imihajlow/ccpu/README.md

A 74xx discrete logic IC-based computer.

Folder structure:
* `doc` - documentation
* `model` - Verilog model and test benches
* `boards` - KiCAD designs of the computer
* `tools` - various tools: ALU generator, assembler, linker, compiler, simulator.
* `app` - software tests and applications
