imihajlow/ccpu/doc/waveforms/alu0.png

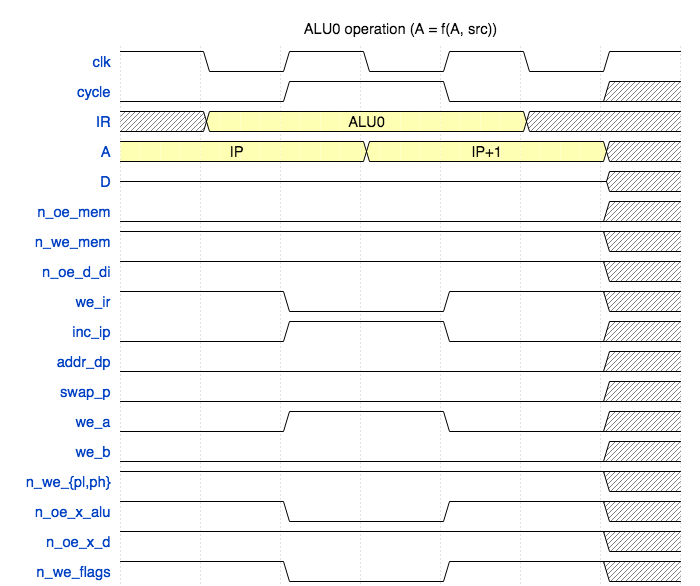
doc/waveforms/alu0.png
