imihajlow/ccpu/doc/waveforms/alu1.png

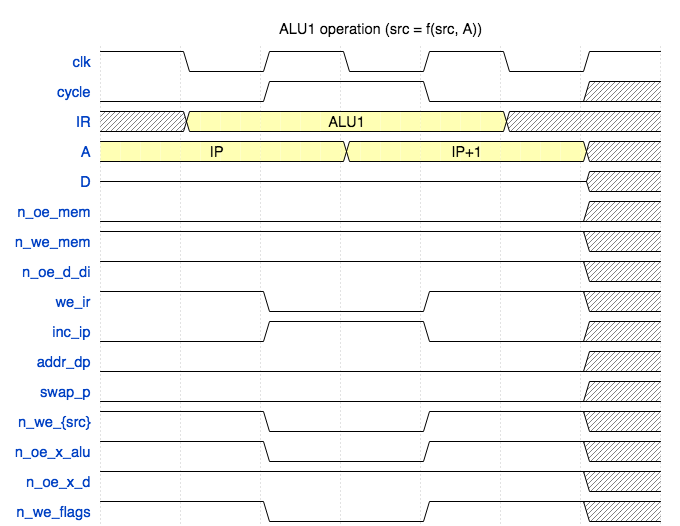
doc/waveforms/alu1.png
