imihajlow/ccpu/doc/waveforms/jc.png

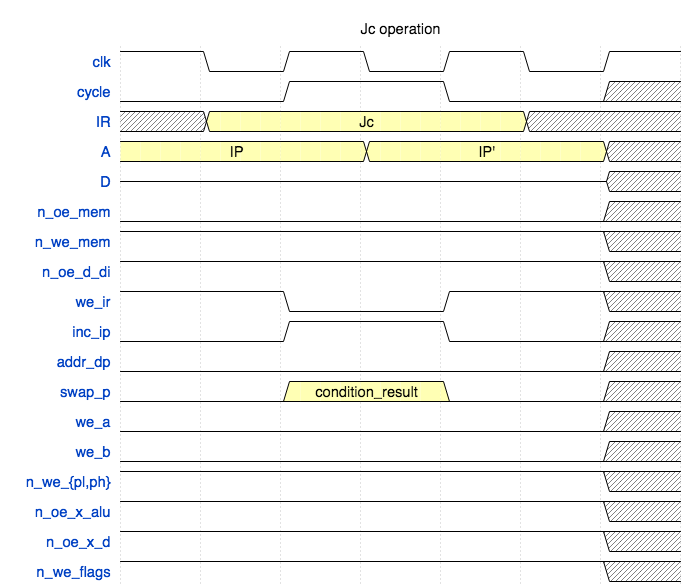
doc/waveforms/jc.png
