imihajlow/ccpu/doc/waveforms/lcd_write.png

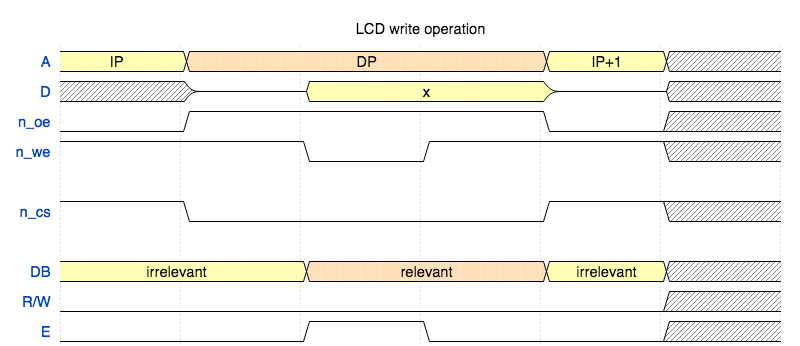
doc/waveforms/lcd_write.png
