imihajlow/ccpu/doc/waveforms/ld-fast.png

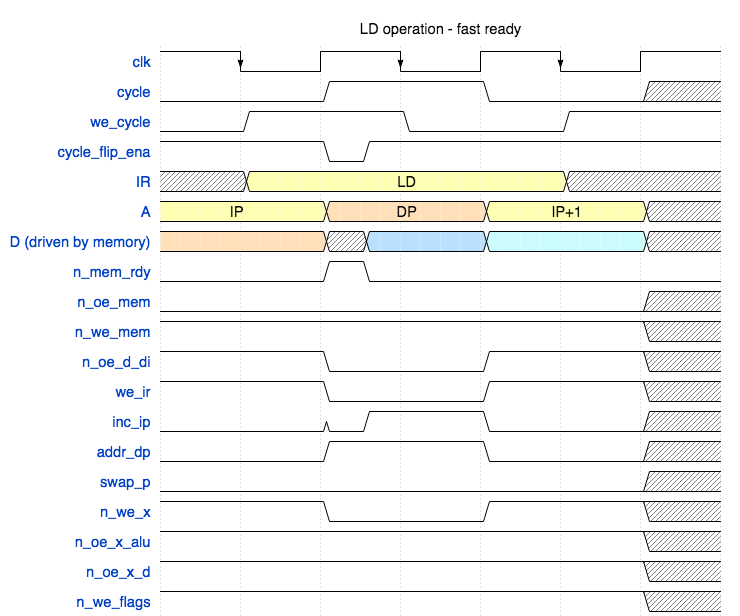
doc/waveforms/ld-fast.png
