imihajlow/ccpu/doc/waveforms/ld-slow.png

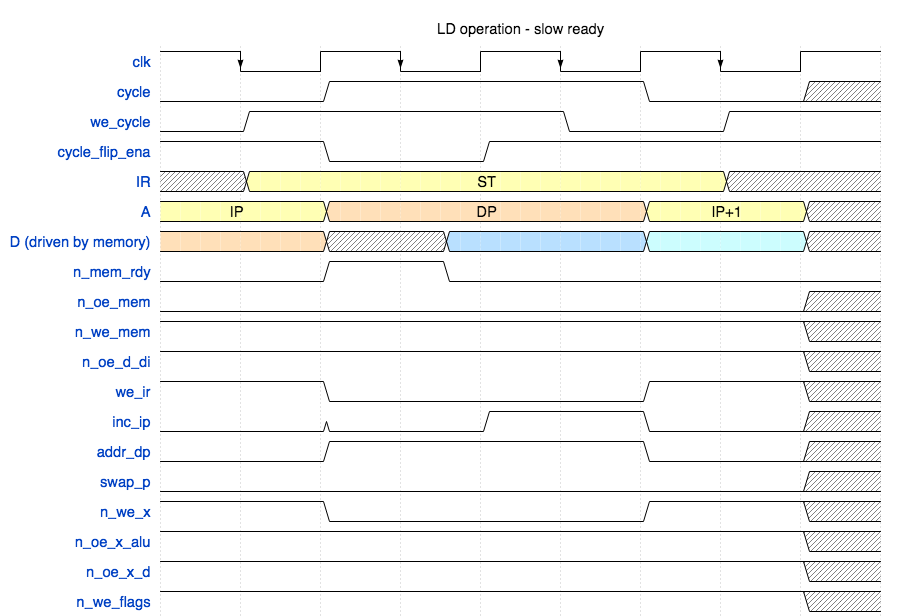
doc/waveforms/ld-slow.png
