imihajlow/ccpu/doc/waveforms/ld.png

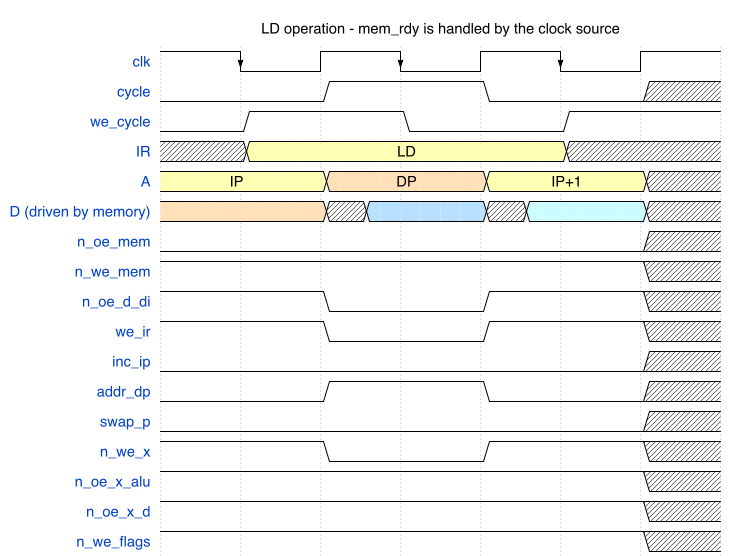
doc/waveforms/ld.png
