imihajlow/ccpu/doc/waveforms/ldi.png

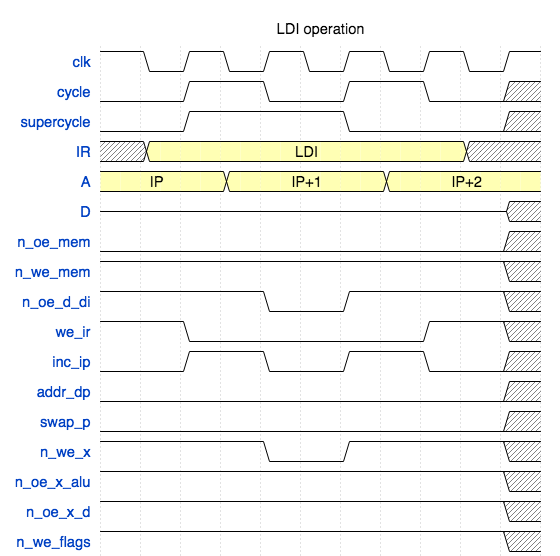
doc/waveforms/ldi.png
