imihajlow/ccpu/doc/waveforms/ps2/recv.png

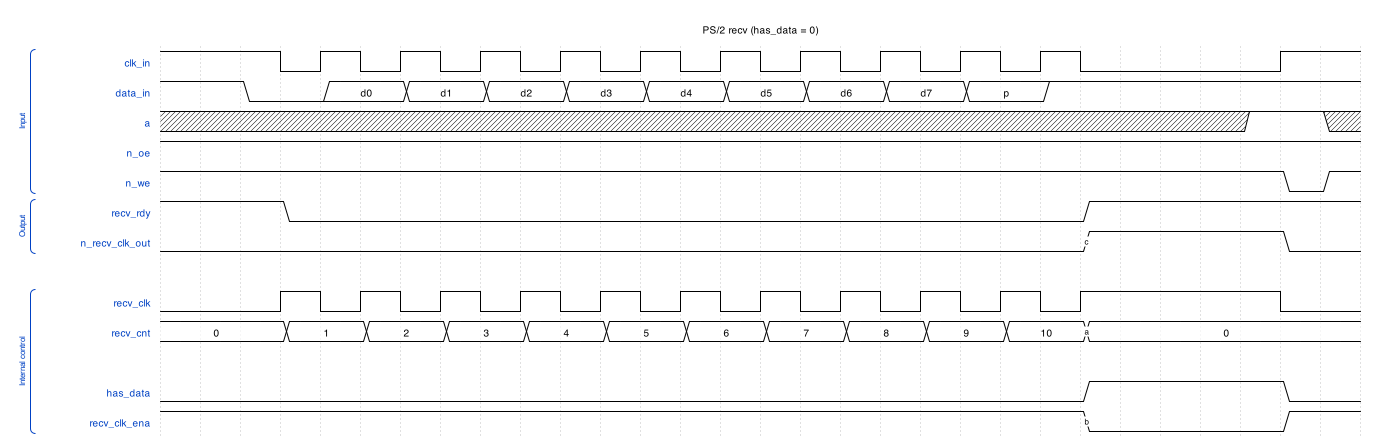
doc/waveforms/ps2/recv.png
