imihajlow/ccpu/doc/waveforms/ps2/send.png

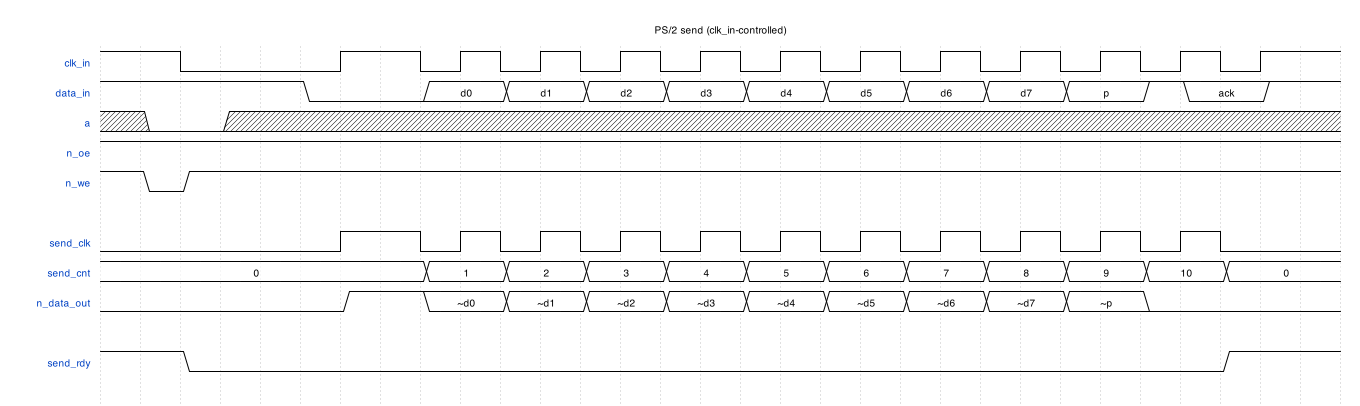
doc/waveforms/ps2/send.png
