imihajlow/ccpu/doc/waveforms/ps2/send_begin.png

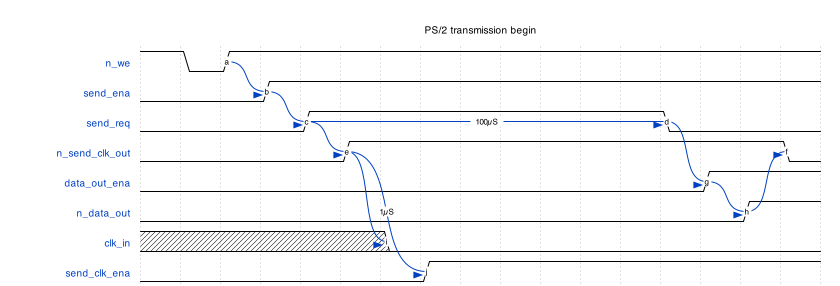
doc/waveforms/ps2/send_begin.png
