imihajlow/ccpu/doc/waveforms/spi.png

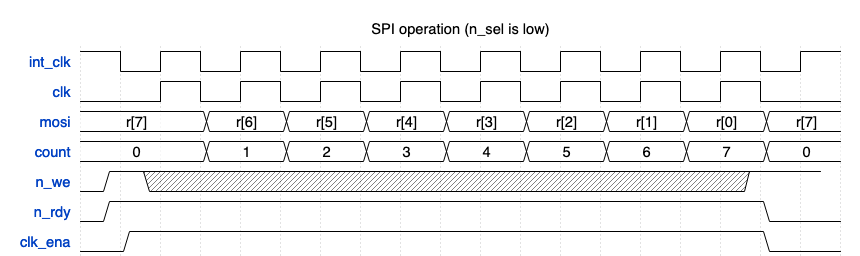
doc/waveforms/spi.png
