imihajlow/ccpu/doc/waveforms/st-fast.png

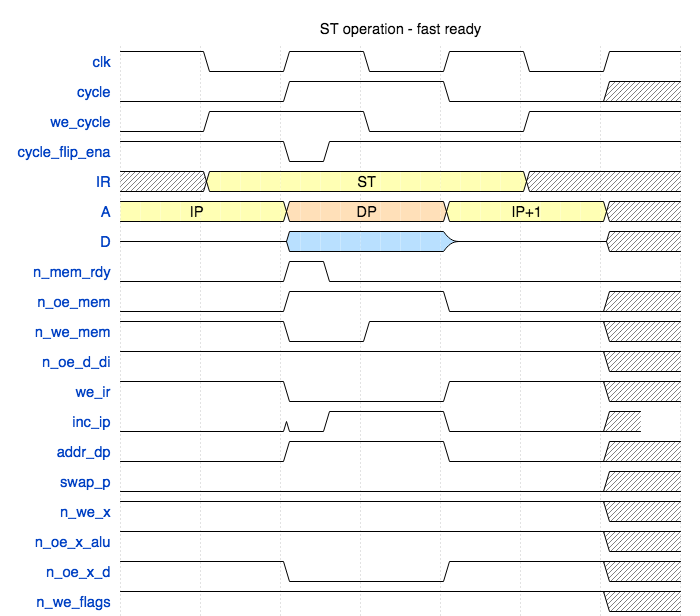
doc/waveforms/st-fast.png
