imihajlow/ccpu/doc/waveforms/st-slow.png

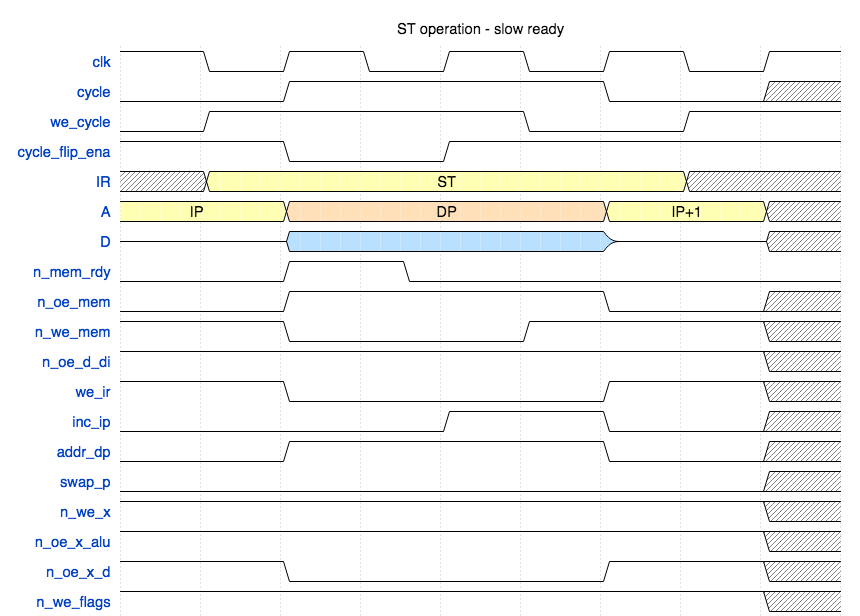
doc/waveforms/st-slow.png
