imihajlow/ccpu/doc/waveforms/st.png

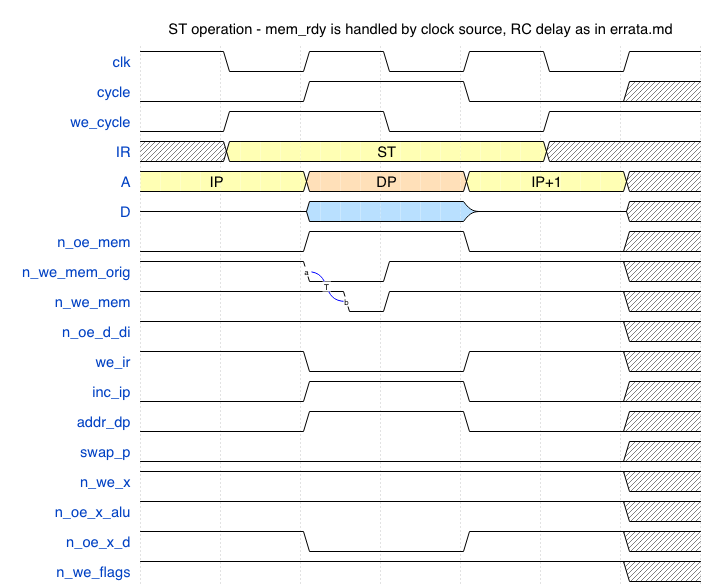
doc/waveforms/st.png
