imihajlow/ccpu/doc/waveforms/stack/access.png

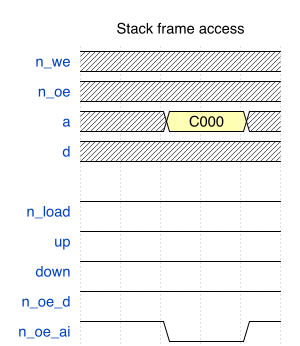
doc/waveforms/stack/access.png
