imihajlow/ccpu/doc/waveforms/stack/incdec.png

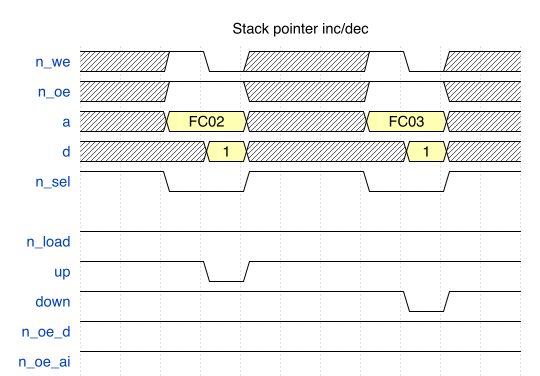
doc/waveforms/stack/incdec.png
