imihajlow/ccpu/doc/waveforms/stack/loadstore.png

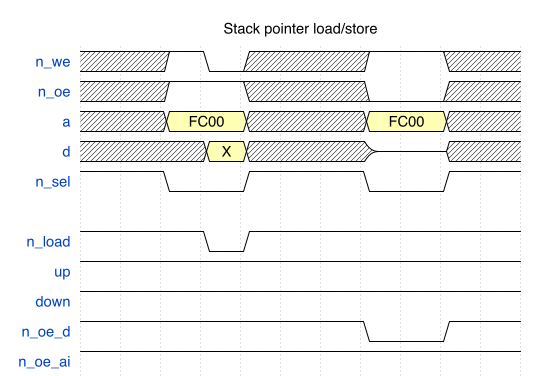
doc/waveforms/stack/loadstore.png
