imihajlow/ccpu/doc/waveforms/vga.png

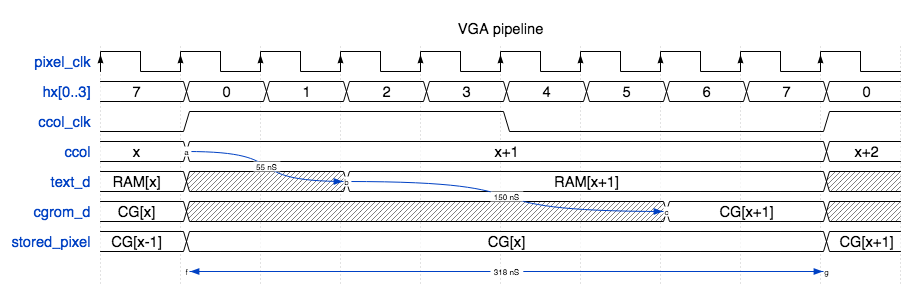
doc/waveforms/vga.png
