imihajlow/ccpu/boards/eth/eth.kicad_pcb

## KiCad design boards/eth/eth.kicad_pcb (2023-11-02)

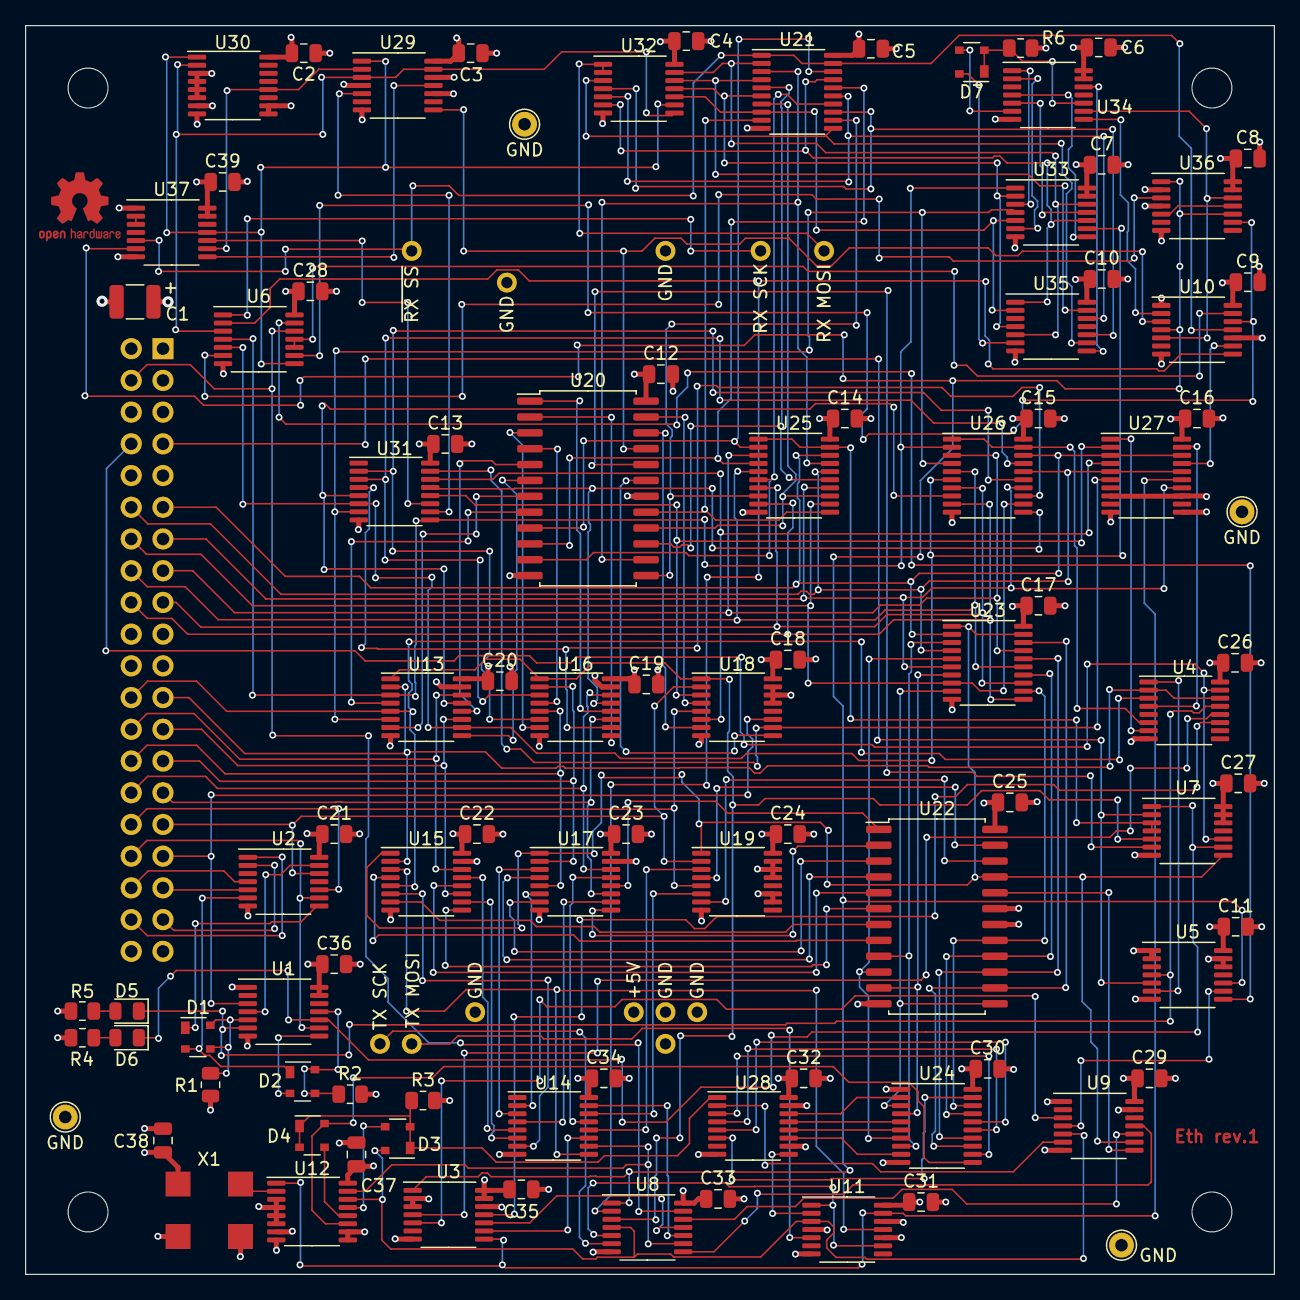
[picture p22: board eth.kicad_pcb from above]

Board: 4 copper layers, 100.0 x 100.0 mm, 100 parts (1 on the bottom side), 173 nets.

Parts:
C1: 33.0x10v; C_1210_3225Metric
C2, C3, C4, C5, C6, C7, C8, C9, C10, C11, C12, C13, C14, C15, C16, C17, C18, C19, C20, C21, C22, C23, C24, C25, C26, C27, C28, C29, C30, C31, C32, C33, C34, C35, C36, C37, C38, C39: 0.1; C_0805_2012Metric
D1, D2, D3, D4, D7: BAT74; SOT-143
D5, D6: LED; LED_0805_2012Metric
H1, H2, H3, H4: MountingHole; MountingHole_3.2mm_M3
J1: Conn_02x20_Odd_Even; PinHeader_2x20_P2.54mm_Horizontal
J2: eth-phy-shield-conn; partial-nucleo64
R1, R2, R3, R6: 1k; R_0805_2012Metric
R4, R5: 500; R_0805_2012Metric
TP1, TP2, TP3, TP4: GND; TestPoint_THTPad_D2.0mm_Drill1.0mm
U1, U9, U37: 74HC04; TSSOP-14_4.4x5mm_P0.65mm
U2, U34, U35: 74HC21; TSSOP-14_4.4x5mm_P0.65mm
U3, U10, U11, U29, U36: 74HC74; TSSOP-14_4.4x5mm_P0.65mm
U4: 74HC139; TSSOP-16_4.4x5mm_P0.65mm
U5, U7: 74HC32; TSSOP-14_4.4x5mm_P0.65mm
U6, U8: 74HC08; TSSOP-14_4.4x5mm_P0.65mm
U12, U30: 74HC161; TSSOP-16_4.4x5mm_P0.65mm
U13, U15, U16, U17, U18, U19: 74HC157; TSSOP-16_4.4x5mm_P0.65mm
U14, U31: 74HC4040; TSSOP-16_4.4x5mm_P0.65mm
U20, U22: 6116; SOIC-24W_7.5x15.4mm_P1.27mm
U21, U23, U25, U26, U27: 74HC244; TSSOP-20_4.4x6.5mm_P0.65mm
U24: 74HC273; TSSOP-20_4.4x6.5mm_P0.65mm
U28: 74HC165; TSSOP-16_4.4x5mm_P0.65mm
U32: 74HC164; TSSOP-14_4.4x5mm_P0.65mm
U33: 74HC86; TSSOP-14_4.4x5mm_P0.65mm
X1: CB3-3C-20M; Oscillator_SMD_EuroQuartz_XO91-4Pin_7.0x5.0mm

Connections:
/a0: J1.23, U4.2 (A0), U4.14 (A0), U13.2 (I0a), U15.2 (I0a)
/a1: J1.24, U4.3 (A1), U13.5 (I0b), U15.5 (I0b)
/a2: J1.25, U13.11 (I0c), U15.11 (I0c)
/a3: J1.26, U13.14 (I0d), U15.14 (I0d)
/a4: J1.27, U16.2 (I0a), U17.2 (I0a)
/a5: J1.28, U16.5 (I0b), U17.5 (I0b)
/a6: J1.29, U16.11 (I0c), U17.11 (I0c)
/a7: J1.30, U16.14 (I0d), U17.14 (I0d)
/a8: J1.31, U2.12, U18.2 (I0a), U19.2 (I0a)
/a9: J1.32, U2.10, U18.5 (I0b), U19.5 (I0b)
/a10: J1.33, U1.3, U18.11 (I0c)
/a11: J1.34, U1.9, U2.9
/a12: J1.35, U2.5
/a13: J1.36, U2.4
/a14: J1.37, U2.2
/a15: J1.38, U2.1
/a_89nab_set: D1.1 (C1), U2.8
/a_cdef_set: D1.2 (C2), D2.1 (C1), U2.6
/buf_full: U10.9 (Q), U27.17 (2A0)
/d0: J1.11, U23.2 (1A0), U25.18 (1Y0), U26.18 (1Y0), U27.3 (2Y0), U27.18 (1Y0)
/d1: J1.12, U23.4 (1A1), U25.16 (1Y1), U26.16 (1Y1), U27.5 (2Y1), U27.16 (1Y1)
/d2: J1.13, U23.6 (1A2), U25.14 (1Y2), U26.14 (1Y2), U27.14 (1Y2)
/d3: J1.14, U23.8 (1A3), U25.12 (1Y3), U26.12 (1Y3)
/d4: J1.15, U23.17 (2A0), U25.3 (2Y0), U26.3 (2Y0)
/d5: J1.16, U23.15 (2A1), U25.5 (2Y1), U26.5 (2Y1)
/d6: J1.17, U23.13 (2A2), U25.7 (2Y2), U26.7 (2Y2)
/d7: J1.18, U23.11 (2A3), U25.9 (2Y3), U26.9 (2Y3)
/filter/a02: U6.6, U36.3 (C)
/filter/d_4320_mac: D7.3 (A2), U34.6
/filter/d_4320_ok: D7.1 (C1), D7.2 (C2), R6.2, U34.10
/filter/d_4320_set: D7.4 (A1), U35.6
/filter/d_7651_set: U34.12, U35.8
/filter/d_xor_a0: U33.3, U34.1
/filter/d_xor_a1: U33.6, U34.2
/filter/d_xor_a2: U33.8, U34.4
/filter/last_mac_ok: U10.5 (Q), U34.9, U36.12 (D)
/filter/mac_end: U36.5 (Q), U36.11 (C)
/filter/next_mac_ok: U10.2 (D), U34.8
/filter/~d0: U33.11, U34.5
/rearm_sched: U3.5 (Q), U9.3
/receiver/bit_count2: U29.2 (D), U30.12 (Q2), U37.9
/receiver/byte_clk: U29.5 (Q), U31.10 (CP)
/receiver/rst: U31.11 (MR), U37.10
/receiver/sck_f: U6.3, U29.3 (C), U29.13 (~R), U30.2 (CP), U32.8 (CP)
/receiver/~bit_count_2: U29.11 (C), U37.8
/recv_a0: U13.4 (Za), U20.8 (A0)
/recv_a1: U13.7 (Zb), U20.7 (A1)
/recv_a2: U13.9 (Zc), U20.6 (A2)
/recv_a3: U13.12 (Zd), U20.5 (A3)
/recv_a4: U16.4 (Za), U20.4 (A4)
/recv_a5: U16.7 (Zb), U20.3 (A5)
/recv_a6: U16.9 (Zc), U20.2 (A6)
/recv_a7: U16.12 (Zd), U20.1 (A7)
/recv_a8: U18.4 (Za), U20.23 (A8)
/recv_a9: U18.7 (Zb), U20.22 (A9)
/recv_a10: U18.9 (Zc), U20.19 (A10)
/recv_a_sel: U7.5, U8.3, U13.1 (S), U16.1 (S), U18.1 (S)
/recv_byte0: U21.2 (1A0), U32.13 (Q7), U33.12, U35.5
/recv_byte1: U21.4 (1A1), U32.12 (Q6), U35.13
/recv_byte2: U21.6 (1A2), U32.11 (Q5), U33.2, U35.4
/recv_byte3: U21.8 (1A3), U32.10 (Q4), U33.5, U35.2
/recv_byte4: U21.17 (2A0), U32.6 (Q3), U33.10, U35.1
/recv_byte5: U21.15 (2A1), U32.5 (Q2), U35.12
/recv_byte6: U21.13 (2A2), U32.4 (Q1), U35.10
/recv_byte7: U21.11 (2A3), U32.3 (Q0), U35.9
/recv_byte_cnt0: U6.4, U13.3 (I1a), U26.2 (1A0), U31.9 (Q0), U33.1
/recv_byte_cnt1: U13.6 (I1b), U26.4 (1A1), U31.7 (Q1), U33.4
/recv_byte_cnt2: U6.5, U13.10 (I1c), U26.6 (1A2), U31.6 (Q2), U33.9
/recv_byte_cnt3: U13.13 (I1d), U26.8 (1A3), U31.5 (Q3)
/recv_byte_cnt4: U16.3 (I1a), U26.17 (2A0), U31.3 (Q4)
/recv_byte_cnt5: U16.6 (I1b), U26.15 (2A1), U31.2 (Q5)
/recv_byte_cnt6: U16.10 (I1c), U26.13 (2A2), U31.4 (Q6)
/recv_byte_cnt7: U16.13 (I1d), U26.11 (2A3), U31.13 (Q7)
/recv_byte_cnt8: U18.3 (I1a), U27.2 (1A0), U31.12 (Q8)
/recv_byte_cnt9: U18.6 (I1b), U27.4 (1A1), U31.14 (Q9)
/recv_byte_cnt10: U18.10 (I1c), U27.6 (1A2), U31.15 (Q10)
/recv_d0: U20.9 (D0), U21.18 (1Y0), U25.2 (1A0)
/recv_d1: U20.10 (D1), U21.16 (1Y1), U25.4 (1A1)
/recv_d2: U20.11 (D2), U21.14 (1Y2), U25.6 (1A2)
/recv_d3: U20.13 (D3), U21.12 (1Y3), U25.8 (1A3)
/recv_d4: U20.14 (D4), U21.3 (2Y0), U25.17 (2A0)
/recv_d5: U20.15 (D5), U21.5 (2Y1), U25.15 (2A1)
/recv_d6: U20.16 (D6), U21.7 (2Y2), U25.13 (2A2)
/recv_d7: U20.17 (D7), U21.9 (2Y3), U25.11 (2A3)
/recv_mosi: J2.PB13, U32.1 (DSA), U32.2 (DSB)
/recv_sck: J2.PB15, U6.1
/recv_sck_ena: U6.2, U8.2, U10.8 (~Q)
/recv_ss: U3.1 (~R), U5.10, U8.1, U10.4 (~S), U36.1 (~R), U36.10 (~S), U37.6
/tx_a0: U15.4 (Za), U22.8 (A0)
/tx_a1: U15.7 (Zb), U22.7 (A1)
/tx_a2: U15.9 (Zc), U22.6 (A2)
/tx_a3: U15.12 (Zd), U22.5 (A3)
/tx_a4: U17.4 (Za), U22.4 (A4)
/tx_a5: U17.7 (Zb), U22.3 (A5)
/tx_a6: U17.9 (Zc), U22.2 (A6)
/tx_a7: U17.12 (Zd), U22.1 (A7)
/tx_a8: U19.4 (Za), U22.23 (A8)
/tx_a9: U19.7 (Zb), U22.22 (A9)
/tx_buf_d0: U24.9 (Q3), U28.11 (D0)
/tx_buf_d1: U24.6 (Q2), U28.12 (D1)
/tx_buf_d2: U24.5 (Q1), U28.13 (D2)
/tx_buf_d3: U24.2 (Q0), U28.14 (D3)
/tx_buf_d4: U24.12 (Q4), U28.3 (D4)
/tx_buf_d5: U24.15 (Q5), U28.4 (D5)
/tx_buf_d6: U24.16 (Q6), U28.5 (D6)
/tx_buf_d7: U24.19 (Q7), U28.6 (D7)
/tx_byte_cnt0: U11.11 (C), U14.9 (Q0), U15.3 (I1a)
/tx_byte_cnt1: U14.7 (Q1), U15.6 (I1b)
/tx_byte_cnt2: U14.6 (Q2), U15.10 (I1c)
/tx_byte_cnt3: U14.5 (Q3), U15.13 (I1d)
/tx_byte_cnt4: U14.3 (Q4), U17.3 (I1a)
/tx_byte_cnt5: U14.2 (Q5), U17.6 (I1b)
/tx_byte_cnt6: U14.4 (Q6), U17.10 (I1c)
/tx_byte_cnt7: U14.13 (Q7), U17.13 (I1d)
/tx_byte_cnt8: U14.12 (Q8), U19.3 (I1a)
/tx_byte_cnt9: U14.14 (Q9), U19.6 (I1b)
/tx_byte_cnt10: U8.10, U14.15 (Q10)
/tx_cnt0: D3.4 (A1), U8.4, U9.5, U11.3 (C), U12.14 (Q0)
/tx_cnt1: D3.3 (A2), U12.13 (Q1)
/tx_cnt2: D4.3 (A2), U12.12 (Q2)
/tx_cnt3: D4.4 (A1), U12.11 (Q3), U24.11 (Cp)
/tx_cp_in: U12.2 (CP), X1.3 (OUT)
/tx_d0: U22.14 (D4), U23.18 (1Y0), U24.13 (D4)
/tx_d1: U22.15 (D5), U23.16 (1Y1), U24.14 (D5)
/tx_d2: U22.16 (D6), U23.14 (1Y2), U24.17 (D6)
/tx_d3: U22.17 (D7), U23.12 (1Y3), U24.18 (D7)
/tx_d4: U22.9 (D0), U23.3 (2Y0), U24.8 (D3)
/tx_d5: U22.10 (D1), U23.5 (2Y1), U24.7 (D2)
/tx_d6: U22.11 (D2), U23.7 (2Y2), U24.4 (D1)
/tx_d7: U22.13 (D3), U23.9 (2Y3), U24.3 (D0)
/tx_finish: U8.8, U9.11
/tx_halt: U3.9 (Q), U14.11 (MR)
/tx_mosi: J2.PC12, U11.5 (Q)
/tx_oe: U8.5, U11.1 (~R), U11.9 (Q)
/tx_sck: J2.PC10, U8.6
/tx_shift_cp: U9.6, U28.2 (CP)
/tx_shift_q7: U11.2 (D), U28.9 (Q7)
/~a10: U1.4, U2.13
/~a11: D2.2 (C2), U1.8
/~a_buf_sel: D6.1 (K), U1.10, U7.1, U7.9
/~a_fbxx: D5.1 (K), U1.6, U4.13 (A1), U5.4
/~clr_frame_received: U6.10, U6.11, U10.13 (~R)
/~inhibit: U6.9, U10.12 (D), U36.9 (Q)
/~oe_cr_to_d: U4.4 (O0), U27.19 (2OE)
/~oe: J1.7, U5.5, U7.2
/~rearm_req: U3.4 (~S), U4.12 (O0)
/~rearm_sched: U5.9, U9.4
/~rearm: U5.8, U6.13
/~recv_buf_oe: U7.6, U20.20 (~OE)
/~recv_buf_we: U10.3 (C), U20.21 (~WE), U29.8 (~Q)
/~recv_byte_cnt_hi_oe: U4.7 (O3), U27.1 (1OE)
/~recv_byte_cnt_lo_oe: U4.6 (O2), U26.1 (1OE), U26.19 (2OE)
/~recv_d_oe: U7.3, U7.4, U25.1 (1OE), U25.19 (2OE)
/~recv_rst: U6.8, U29.1 (~R), U30.1 (~MR), U32.9 (~MR), U37.11
/~recv_ss: J2.PC6, U10.11 (C), U21.1 (1OE), U21.19 (2OE), U37.5
/~reg_oe_ena: U4.1 (E), U5.6
/~rst: J1.4, U6.12, U8.13
/~tx_buf_oe: U9.8, U22.20 (~OE)
/~tx_buf_we: U7.8, U9.9, U15.1 (S), U17.1 (S), U19.1 (S), U22.21 (~WE), U23.1 (1OE), U23.19 (2OE)
/~tx_byte_clk: U8.9, U12.15 (TC), U14.10 (CP)
/~tx_finish: U8.12, U9.10
/~tx_halt_set: U3.10 (~S), U8.11
/~tx_halt: U3.8 (~Q), U11.13 (~R), U12.1 (~MR), U27.15 (2A1)
/~tx_req: U3.11 (C), U4.11 (O1)
/~tx_shift_pl: D3.1 (C1), D3.2 (C2), D4.1 (C1), D4.2 (C2), R3.1, U28.1 (~PL)
/~we: J1.8, U4.15 (E), U7.10
GND: C1.2, C2.2, C3.2, C4.2, C5.2, C6.2, C7.2, C8.2, C9.2, C10.2, C11.2, C12.2, C13.2, C14.2, C15.2, C16.2, C17.2, C18.2, C19.2, C20.2, C21.2, C22.2, C23.2, C24.2, C25.2, C26.2, C27.2, C28.2, C29.2, C30.2, C31.2, C32.2, C33.2, C34.2, C35.2, C36.2, C37.2, C38.2, C39.2, J1.2, J1.39, J2.GND, R3.2, R6.1, TP1.1, TP2.1, TP3.1, TP4.1, U1.1, U1.7 (GND), U2.7 (GND), U3.2 (D), U3.3 (C), U3.7 (GND), U3.12 (D), U4.8 (GND), U5.1, U5.2, U5.7 (GND), U5.12, U5.13, U6.7 (GND), U7.7 (GND), U8.7 (GND), U9.1, U9.7 (GND), U9.13, U10.7 (GND), U11.7 (GND), U12.3 (D0), U12.4 (D1), U12.5 (D2), U12.6 (D3), U12.8 (GND), U13.8 (GND), U13.15 (E), U14.8 (GND), U15.8 (GND), U15.15 (E), U16.8 (GND), U16.15 (E), U17.8 (GND), U17.15 (E), U18.8 (GND), U18.13 (I1d), U18.14 (I0d), U18.15 (E), U19.8 (GND), U19.10 (I1c), U19.11 (I0c), U19.13 (I1d), U19.14 (I0d), U19.15 (E), U20.12 (GND), U20.18 (~CS), U21.10 (GND), U22.12 (GND), U22.18 (~CS), U22.19 (A10), U23.10 (GND), U24.10 (GND), U25.10 (GND), U26.10 (GND), U27.8 (1A3), U27.10 (GND), U27.11 (2A3), U27.13 (2A2), U28.8 (GND), U28.10 (DS), U28.15 (~CE), U29.7 (GND), U30.3 (D0), U30.4 (D1), U30.5 (D2), U30.6 (D3), U30.8 (GND), U31.8 (GND), U32.7 (GND), U33.7 (GND), U34.7 (GND), U35.7 (GND), U36.7 (GND), U37.1, U37.7 (GND), X1.2 (GND)
unnamed: D1.3 (A2), D1.4 (A1), R1.2, U1.5
unnamed: D2.3 (A2), D2.4 (A1), R2.1, U1.11
unnamed: D5.2 (A), R5.1
unnamed: D6.2 (A), R4.2
unnamed: U37.2, U37.3
VCC: C1.1, C2.1, C3.1, C4.1, C5.1, C6.1, C7.1, C8.1, C9.1, C10.1, C11.1, C12.1, C13.1, C14.1, C15.1, C16.1, C17.1, C18.1, C19.1, C20.1, C21.1, C22.1, C23.1, C24.1, C25.1, C26.1, C27.1, C28.1, C29.1, C30.1, C31.1, C32.1, C33.1, C34.1, C35.1, C36.1, C37.1, C38.1, C39.1, J1.1, J1.40, J2.+5V, R1.1, R2.2, R4.1, R5.2, U1.13, U1.14 (VCC), U2.14 (VCC), U3.13 (~R), U3.14 (VCC), U4.16 (VCC), U5.14 (VCC), U6.14 (VCC), U7.12, U7.13, U7.14 (VCC), U8.14 (VCC), U9.14 (VCC), U10.1 (~R), U10.10 (~S), U10.14 (VCC), U11.4 (~S), U11.10 (~S), U11.12 (D), U11.14 (VCC), U12.7 (CEP), U12.9 (~PE), U12.10 (CET), U12.16 (VCC), U13.16 (VCC), U14.16 (VCC), U15.16 (VCC), U16.16 (VCC), U17.16 (VCC), U18.16 (VCC), U19.16 (VCC), U20.24 (VCC), U21.20 (VCC), U22.24 (VCC), U23.20 (VCC), U24.1 (~Mr), U24.20 (VCC), U25.20 (VCC), U26.20 (VCC), U27.20 (VCC), U28.16 (VCC), U29.4 (~S), U29.10 (~S), U29.12 (D), U29.14 (VCC), U30.7 (CEP), U30.9 (~PE), U30.10 (CET), U30.16 (VCC), U31.16 (VCC), U32.14 (VCC), U33.13, U33.14 (VCC), U34.13, U34.14 (VCC), U35.14 (VCC), U36.2 (D), U36.4 (~S), U36.13 (~R), U36.14 (VCC), U37.13, U37.14 (VCC), X1.1 (EN), X1.4 (V+)
