imihajlow/ccpu/boards/stack/stack.kicad_pcb

## KiCad design boards/stack/stack.kicad_pcb (2021-12-06)

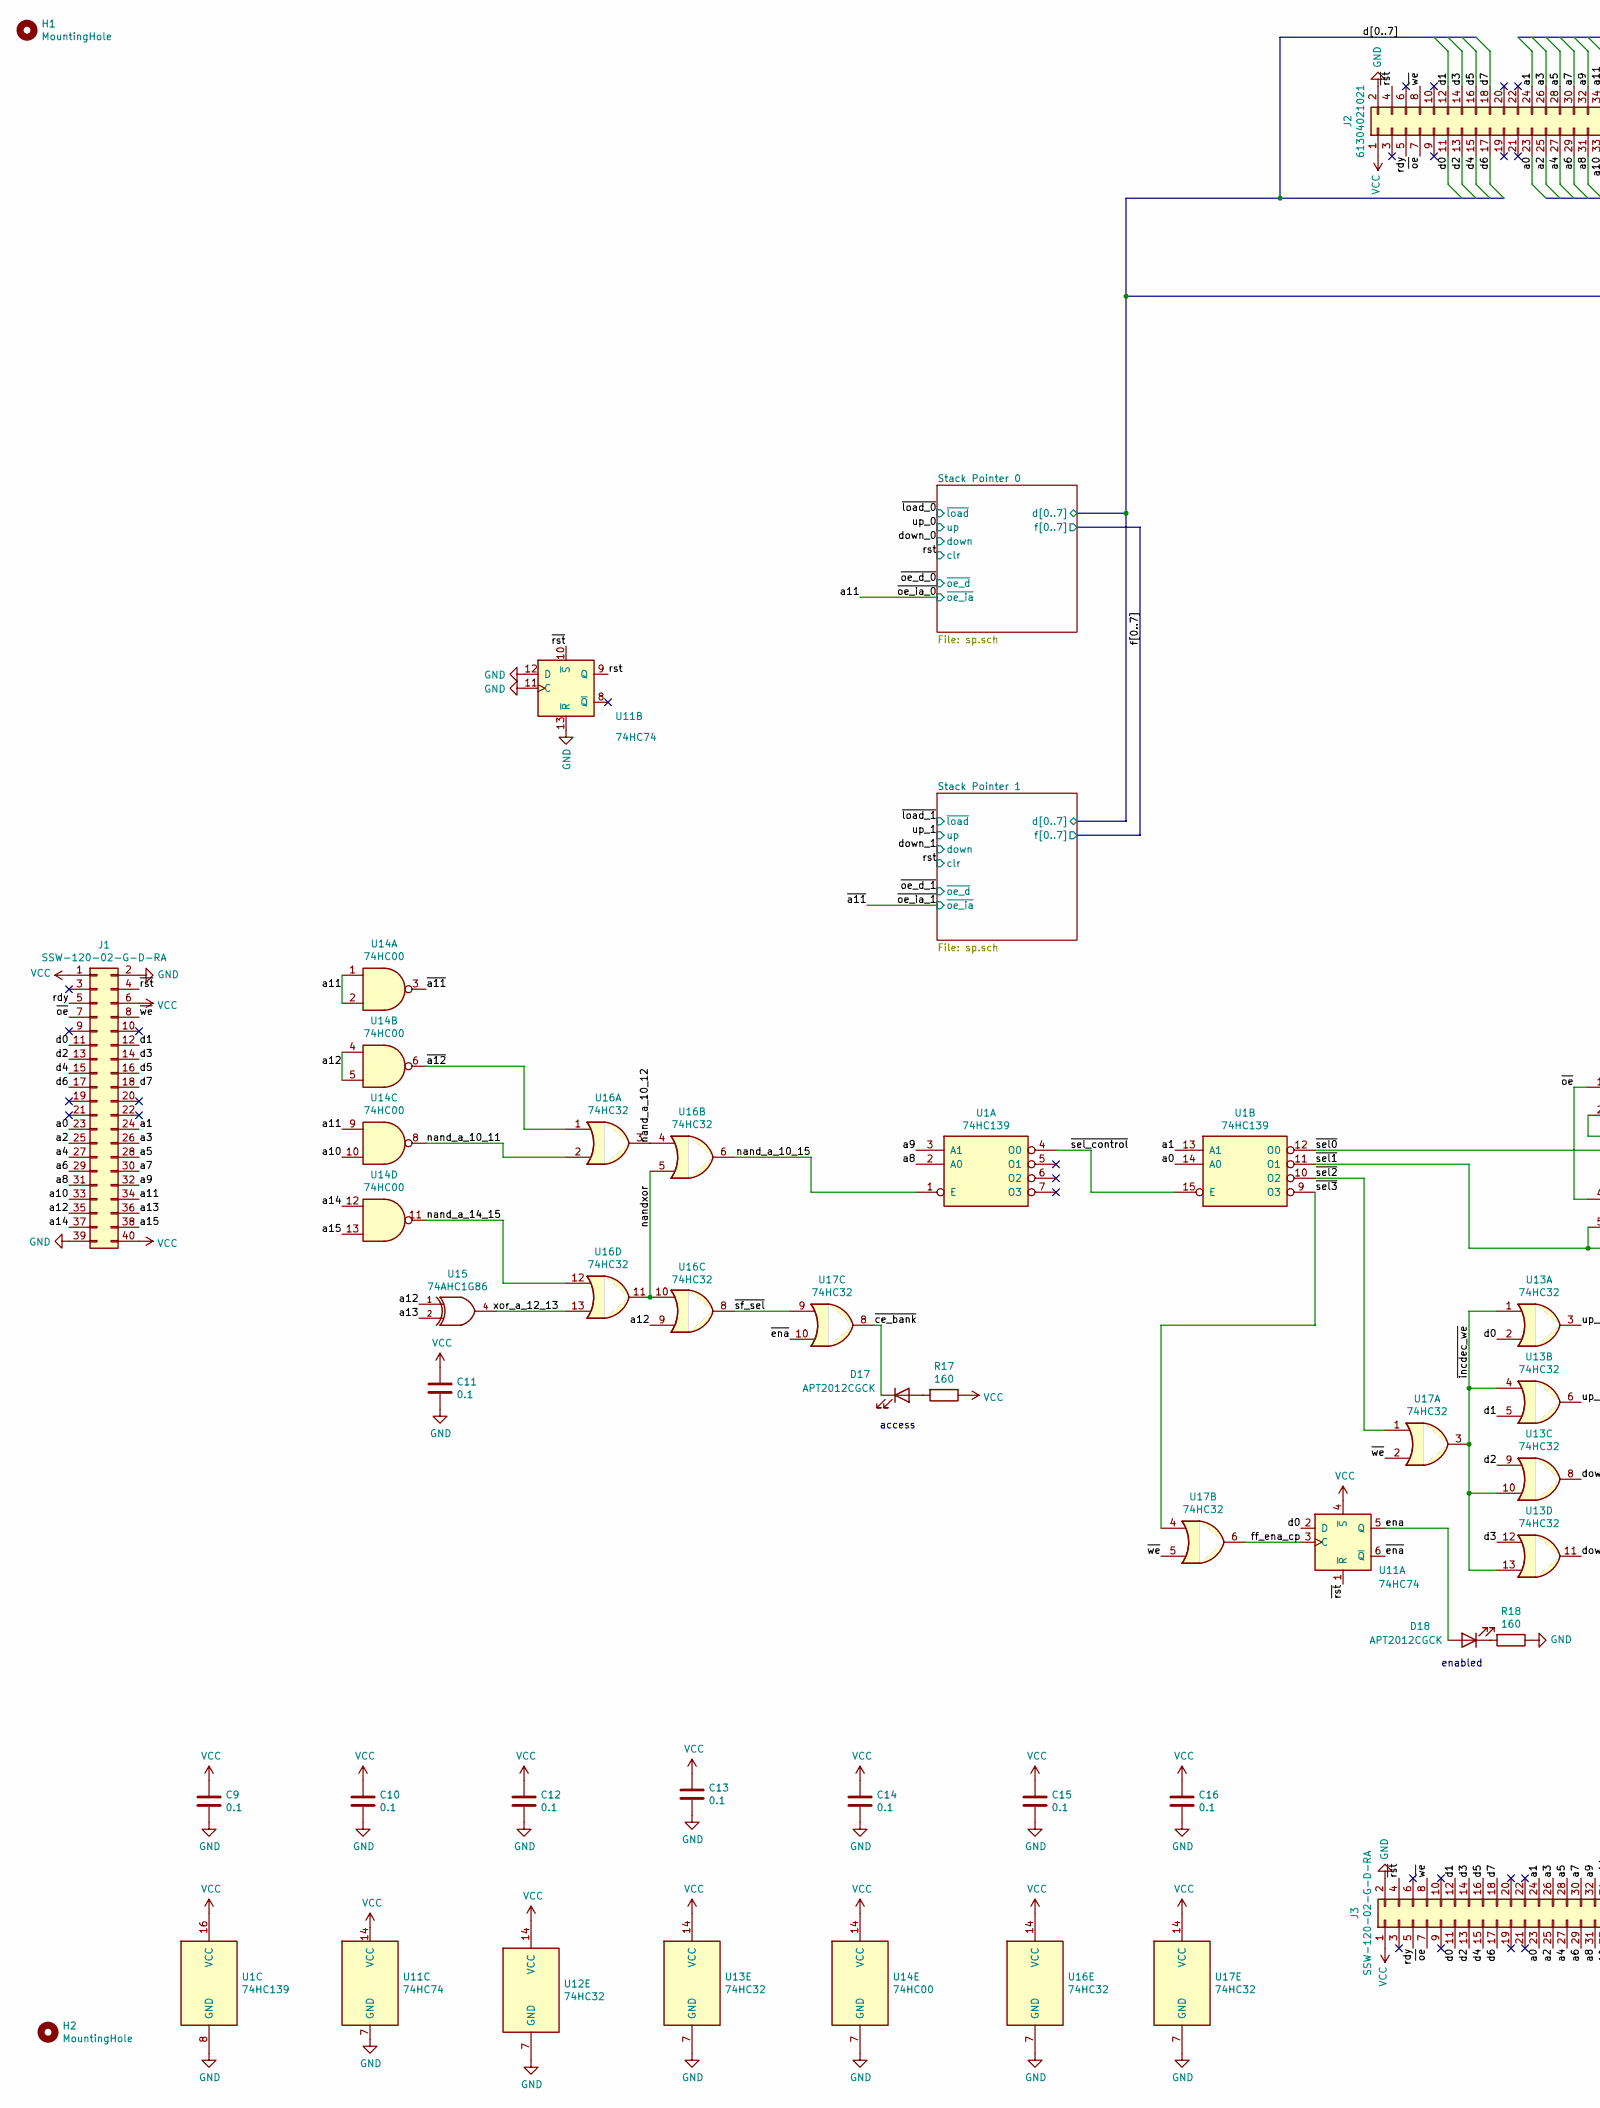
[picture p23: schematic stack.sch, part in row 1, column 1]

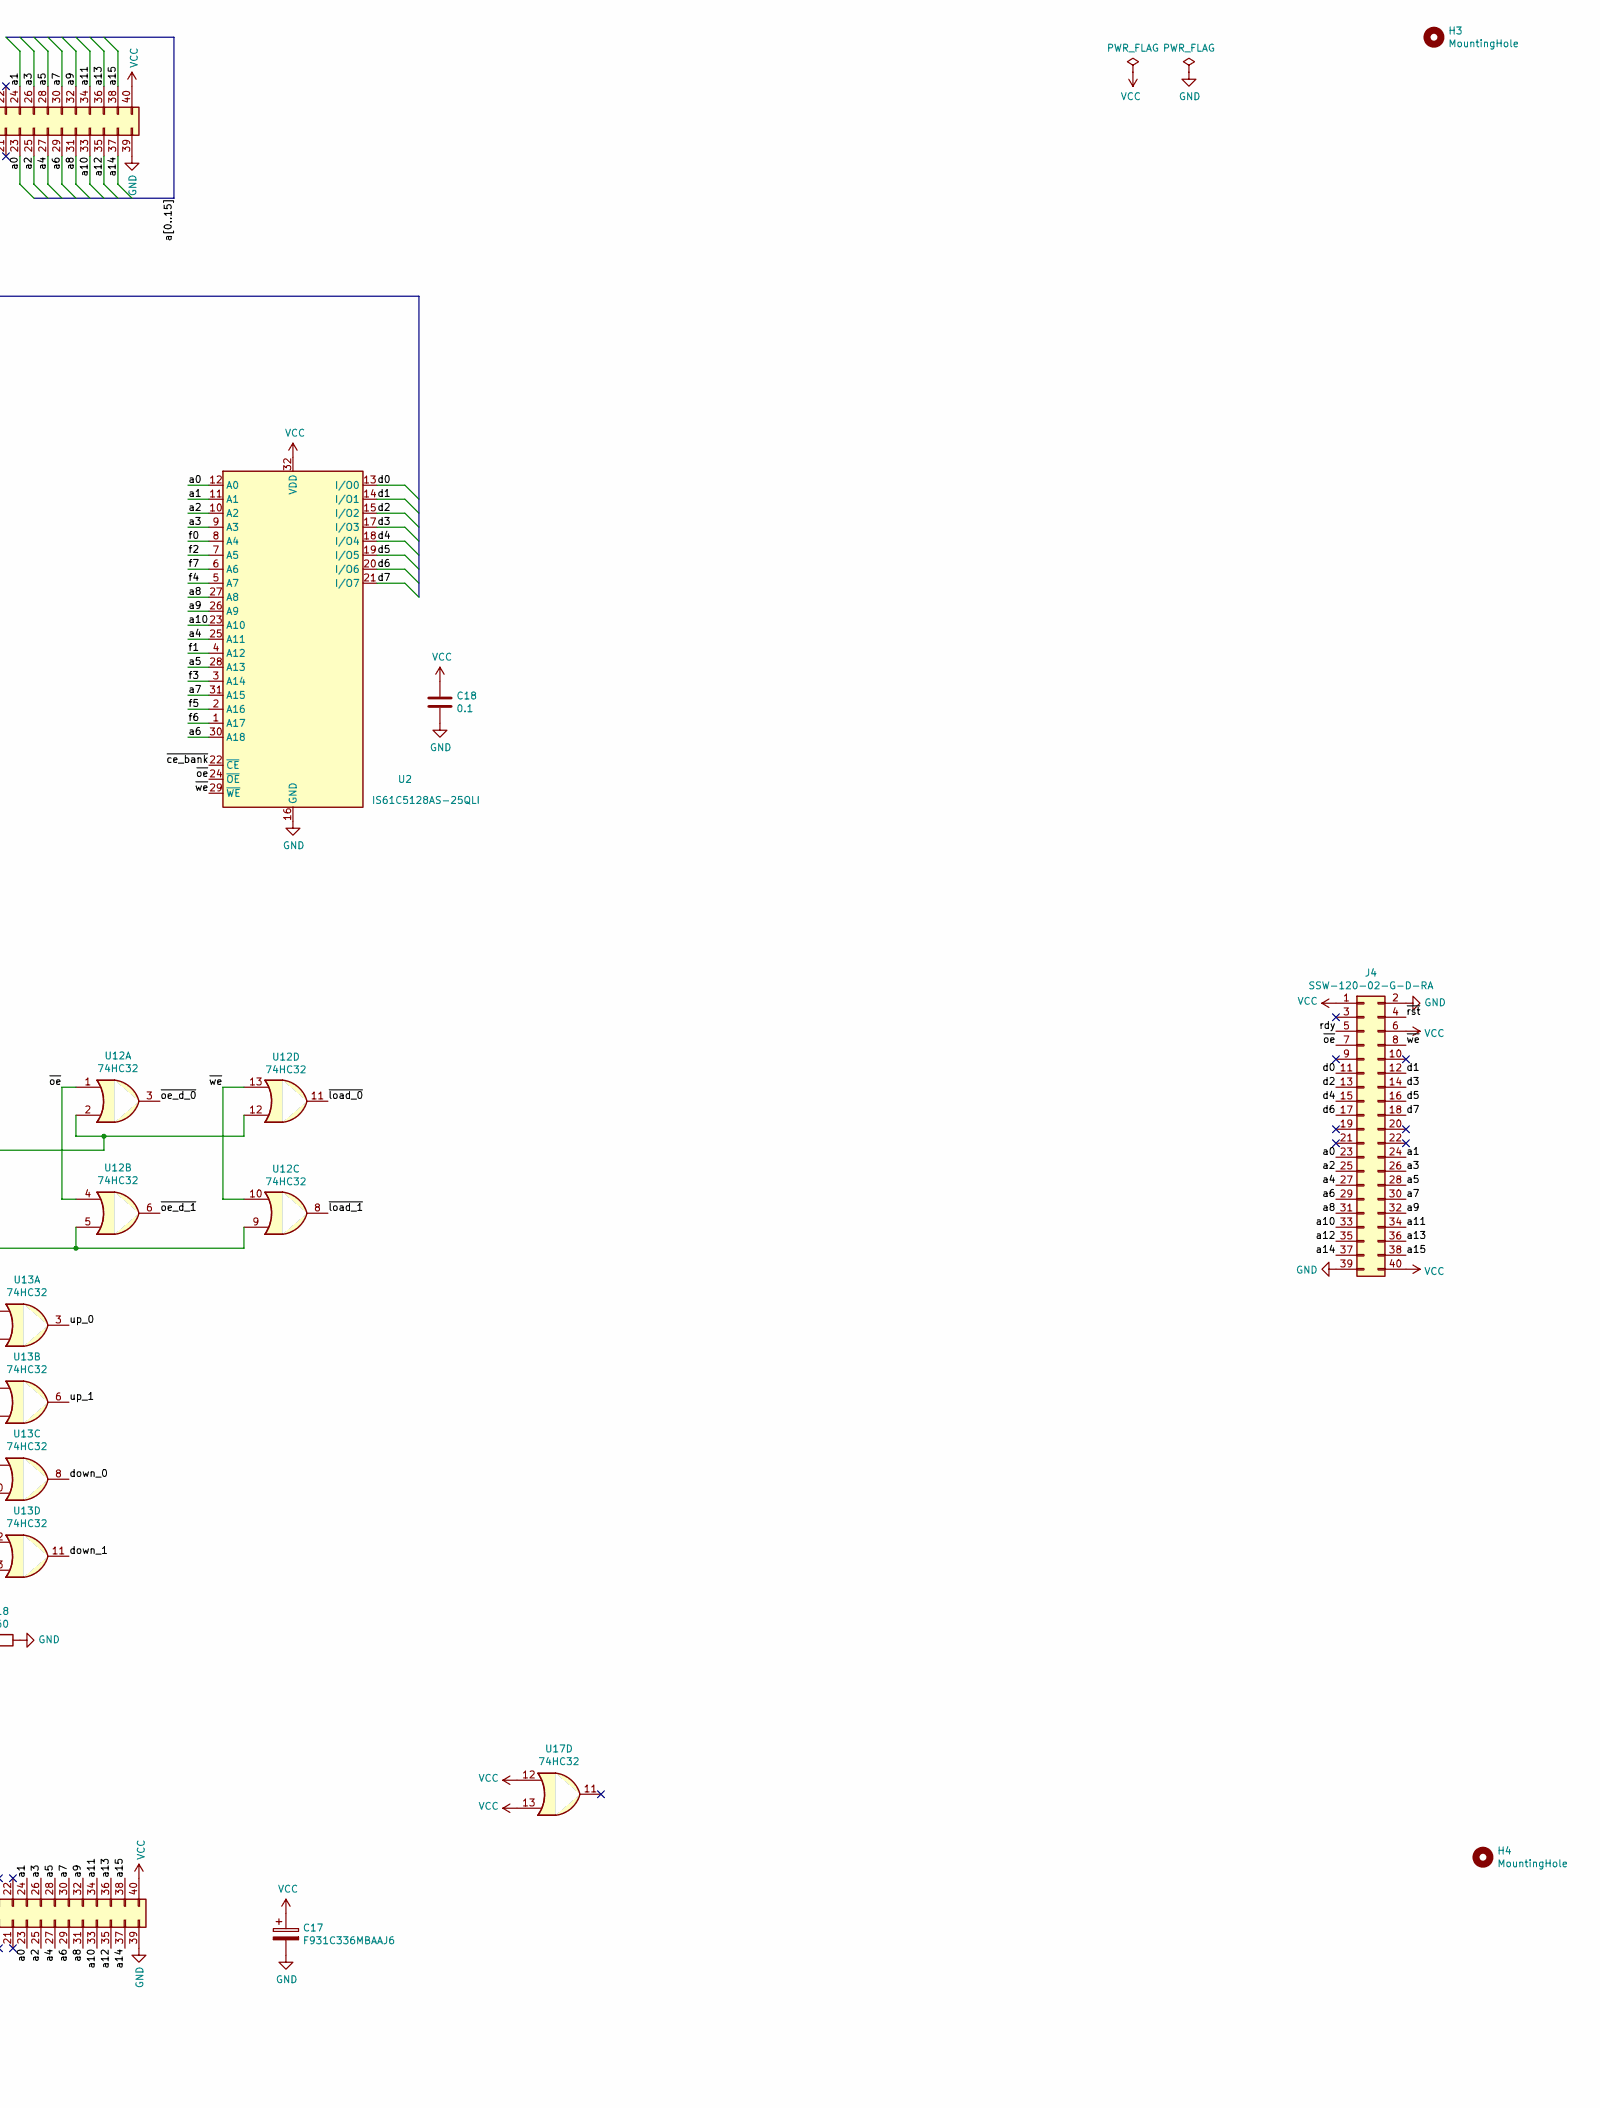
[picture p24: schematic stack.sch, part in row 1, column 2]

Parts:
C9, C10, C11, C12, C13, C14, C15, C16, C18: 0.1; C_0805_2012Metric
C17: F931C336MBAAJ6‎; CP_EIA-3528-21_Kemet-B_Pad1.50x2.35mm_HandSolder
D17, D18: APT2012CGCK; LED_0805_2012Metric
H1, H2, H3, H4: MountingHole; MountingHole_3.2mm_M3
J1, J3, J4: SSW-120-02-G-D-RA; PinSocket_2x20_P2.54mm_Horizontal
J2: 61304021021; PinHeader_2x20_P2.54mm_Horizontal
R17, R18: 160; R_0805_2012Metric
U1: 74HC139; TSSOP-16_4.4x5mm_P0.65mm
U2: IS61C5128AS-25QLI; SSOP-32_11.305x20.495mm_P1.27mm
U11: 74HC74; TSSOP-14_4.4x5mm_P0.65mm
U12, U13, U16, U17: 74HC32; TSSOP-14_4.4x5mm_P0.65mm
U14: 74HC00; TSSOP-14_4.4x5mm_P0.65mm
U15: 74AHC1G86; SOT-23-5

Connections:
/a0: J1.23, J2.23, J3.23, J4.23, U1.14 (A0), U2.12 (A0)
/a1: J1.24, J2.24, J3.24, J4.24, U1.13 (A1), U2.11 (A1)
/a2: J1.25, J2.25, J3.25, J4.25, U2.10 (A2)
/a3: J1.26, J2.26, J3.26, J4.26, U2.9 (A3)
/a4: J1.27, J2.27, J3.27, J4.27, U2.25 (A11)
/a5: J1.28, J2.28, J3.28, J4.28, U2.28 (A13)
/a6: J1.29, J2.29, J3.29, J4.29, U2.30 (A18)
/a7: J1.30, J2.30, J3.30, J4.30, U2.31 (A15)
/a8: J1.31, J2.31, J3.31, J4.31, U1.2 (A0), U2.27 (A8)
/a9: J1.32, J2.32, J3.32, J4.32, U1.3 (A1), U2.26 (A9)
/a10: J1.33, J2.33, J3.33, J4.33, U2.23 (A10), U14.10
/a11: J1.34, J2.34, J3.34, J4.34, U14.1, U14.2, U14.9; also elsewhere on the board
/a12: J1.35, J2.35, J3.35, J4.35, U14.4, U14.5, U15.1, U16.9
/a13: J1.36, J2.36, J3.36, J4.36, U15.2
/a14: J1.37, J2.37, J3.37, J4.37, U14.12
/a15: J1.38, J2.38, J3.38, J4.38, U14.13
/d0: J1.11, J2.11, J3.11, J4.11, U2.13 (I/O0), U11.2 (D), U13.2; also elsewhere on the board
/d1: J1.12, J2.12, J3.12, J4.12, U2.14 (I/O1), U13.5; also elsewhere on the board
/d2: J1.13, J2.13, J3.13, J4.13, U2.15 (I/O2), U13.9; also elsewhere on the board
/d3: J1.14, J2.14, J3.14, J4.14, U2.17 (I/O3), U13.12; also elsewhere on the board
/d4: J1.15, J2.15, J3.15, J4.15, U2.18 (I/O4); also elsewhere on the board
/d5: J1.16, J2.16, J3.16, J4.16, U2.19 (I/O5); also elsewhere on the board
/d6: J1.17, J2.17, J3.17, J4.17, U2.20 (I/O6); also elsewhere on the board
/d7: J1.18, J2.18, J3.18, J4.18, U2.21 (I/O7); also elsewhere on the board
/down_0: U13.8; also elsewhere on the board
/down_1: U13.11; also elsewhere on the board
/ena: D18.2 (A), U11.5 (Q)
/f0: U2.8 (A4); also elsewhere on the board
/f1: U2.4 (A12); also elsewhere on the board
/f2: U2.7 (A5); also elsewhere on the board
/f3: U2.3 (A14); also elsewhere on the board
/f4: U2.5 (A7); also elsewhere on the board
/f5: U2.2 (A16); also elsewhere on the board
/f6: U2.1 (A17); also elsewhere on the board
/f7: U2.6 (A6); also elsewhere on the board
/ff_ena_cp: U11.3 (C), U17.6
/nand_a_10_11: U14.8, U16.2
/nand_a_10_12: U16.3, U16.4
/nand_a_10_15: U1.1 (E), U16.6
/nand_a_14_15: U14.11, U16.12
/nandxor: U16.5, U16.10, U16.11
/rdy: J1.5, J2.5, J3.5, J4.5
/rst: U11.9 (Q); also elsewhere on the board
/up_0: U13.3; also elsewhere on the board
/up_1: U13.6; also elsewhere on the board
/xor_a_12_13: U15.4, U16.13
/~a11: U14.3; also elsewhere on the board
/~a12: U14.6, U16.1
/~ce_bank: D17.1 (K), U2.22 (~CE), U17.8
/~ena: U11.6 (~Q), U17.10
/~incdec_we: U13.1, U13.4, U13.10, U13.13, U17.3
/~load_0: U12.11; also elsewhere on the board
/~load_1: U12.8; also elsewhere on the board
/~oe: J1.7, J2.7, J3.7, J4.7, U2.24 (~OE), U12.1, U12.4
/~oe_d_0: U12.3; also elsewhere on the board
/~oe_d_1: U12.6; also elsewhere on the board
/~rst: J1.4, J2.4, J3.4, J4.4, U11.1 (~R), U11.10 (~S)
/~sel0: U1.12 (O0), U12.2, U12.12
/~sel1: U1.11 (O1), U12.5, U12.9
/~sel2: U1.10 (O2), U17.1
/~sel3: U1.9 (O3), U17.4
/~sel_control: U1.4 (O0), U1.15 (E)
/~sf_sel: U16.8, U17.9
/~we: J1.8, J2.8, J3.8, J4.8, U2.29 (~WE), U12.10, U12.13, U17.2, U17.5
GND: C9.2, C10.2, C11.2, C12.2, C13.2, C14.2, C15.2, C16.2, C17.2, C18.2, J1.2, J1.39, J2.2, J2.39, J3.2, J3.39, J4.2, J4.39, R18.1, U1.8 (GND), U2.16 (GND), U11.7 (GND), U11.11 (C), U11.12 (D), U11.13 (~R), U12.7 (GND), U13.7 (GND), U14.7 (GND), U15.3 (GND), U16.7 (GND), U17.7 (GND); also elsewhere on the board
unnamed: D17.2 (A), R17.2
unnamed: D18.1 (K), R18.2
VCC: C9.1, C10.1, C11.1, C12.1, C13.1, C14.1, C15.1, C16.1, C17.1, C18.1, J1.1, J1.6, J1.40, J2.1, J2.40, J3.1, J3.40, J4.1, J4.6, J4.40, R17.1, U1.16 (VCC), U2.32 (VDD), U11.4 (~S), U11.14 (VCC), U12.14 (VCC), U13.14 (VCC), U14.14 (VCC), U15.5 (VCC), U16.14 (VCC), U17.12, U17.13, U17.14 (VCC); also elsewhere on the board

Notes on the sheet:
access
enabled

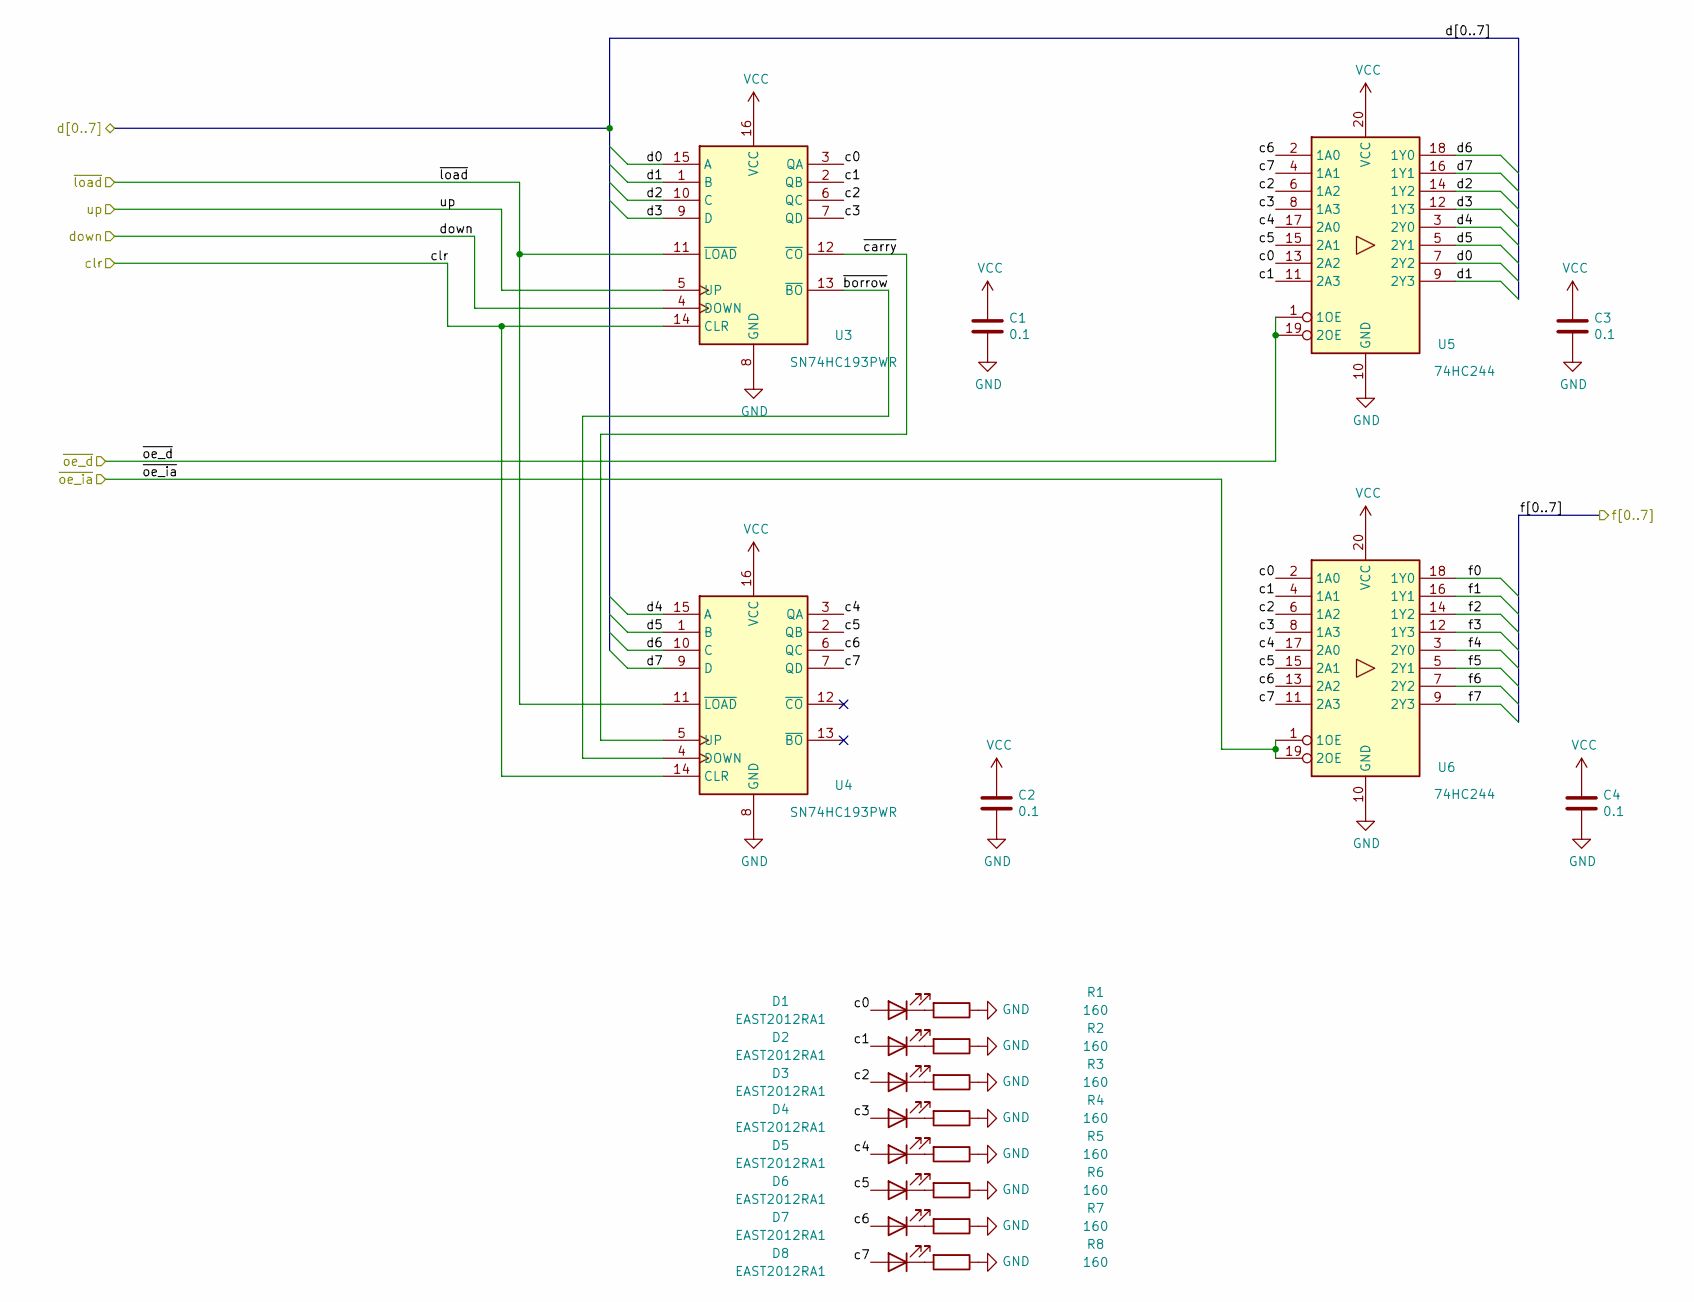
[picture p25: schematic sp.sch, Stack pointer]

Parts:
C1, C2, C3, C4: 0.1; C_0805_2012Metric
D1, D2, D3, D4, D5, D6, D7, D8: EAST2012RA1‎; LED_0805_2012Metric
R1, R2, R3, R4, R5, R6, R7, R8: 160; R_0805_2012Metric
U3, U4: SN74HC193PWR; TSSOP-16_4.4x5mm_P0.65mm
U5, U6: 74HC244; TSSOP-20_4.4x6.5mm_P0.65mm

Connections:
/Stack Pointer 0/c0: D1.2 (A), U3.3 (QA), U5.13 (2A2), U6.2 (1A0)
/Stack Pointer 0/c1: D2.2 (A), U3.2 (QB), U5.11 (2A3), U6.4 (1A1)
/Stack Pointer 0/c2: D3.2 (A), U3.6 (QC), U5.6 (1A2), U6.6 (1A2)
/Stack Pointer 0/c3: D4.2 (A), U3.7 (QD), U5.8 (1A3), U6.8 (1A3)
/Stack Pointer 0/c4: D5.2 (A), U4.3 (QA), U5.17 (2A0), U6.17 (2A0)
/Stack Pointer 0/c5: D6.2 (A), U4.2 (QB), U5.15 (2A1), U6.15 (2A1)
/Stack Pointer 0/c6: D7.2 (A), U4.6 (QC), U5.2 (1A0), U6.13 (2A2)
/Stack Pointer 0/c7: D8.2 (A), U4.7 (QD), U5.4 (1A1), U6.11 (2A3)
/Stack Pointer 0/~borrow: U3.13 (~BO), U4.4 (DOWN)
/Stack Pointer 0/~carry: U3.12 (~CO), U4.5 (UP)
/a11: U6.1 (1OE), U6.19 (2OE); also elsewhere on the board
/d0: U3.15 (A), U5.7 (2Y2); also elsewhere on the board
/d1: U3.1 (B), U5.9 (2Y3); also elsewhere on the board
/d2: U3.10 (C), U5.14 (1Y2); also elsewhere on the board
/d3: U3.9 (D), U5.12 (1Y3); also elsewhere on the board
/d4: U4.15 (A), U5.3 (2Y0); also elsewhere on the board
/d5: U4.1 (B), U5.5 (2Y1); also elsewhere on the board
/d6: U4.10 (C), U5.18 (1Y0); also elsewhere on the board
/d7: U4.9 (D), U5.16 (1Y1); also elsewhere on the board
/down_0: U3.4 (DOWN); also elsewhere on the board
/f0: U6.18 (1Y0); also elsewhere on the board
/f1: U6.16 (1Y1); also elsewhere on the board
/f2: U6.14 (1Y2); also elsewhere on the board
/f3: U6.12 (1Y3); also elsewhere on the board
/f4: U6.3 (2Y0); also elsewhere on the board
/f5: U6.5 (2Y1); also elsewhere on the board
/f6: U6.7 (2Y2); also elsewhere on the board
/f7: U6.9 (2Y3); also elsewhere on the board
/rst: U3.14 (CLR), U4.14 (CLR); also elsewhere on the board
/up_0: U3.5 (UP); also elsewhere on the board
/~load_0: U3.11 (~LOAD), U4.11 (~LOAD); also elsewhere on the board
/~oe_d_0: U5.1 (1OE), U5.19 (2OE); also elsewhere on the board
GND: C1.2, C2.2, C3.2, C4.2, R1.1, R2.1, R3.1, R4.1, R5.1, R6.1, R7.1, R8.1, U3.8 (GND), U4.8 (GND), U5.10 (GND), U6.10 (GND); also elsewhere on the board
unnamed: D1.1 (K), R1.2
unnamed: D2.1 (K), R2.2
unnamed: D3.1 (K), R3.2
unnamed: D4.1 (K), R4.2
unnamed: D5.1 (K), R5.2
unnamed: D6.1 (K), R6.2
unnamed: D7.1 (K), R7.2
unnamed: D8.1 (K), R8.2
VCC: C1.1, C2.1, C3.1, C4.1, U3.16 (VCC), U4.16 (VCC), U5.20 (VCC), U6.20 (VCC); also elsewhere on the board

Parts of its further copies:
C5, C6, C7, C8: 0.1; C_0805_2012Metric
D9, D10, D11, D12, D13, D14, D15, D16: EAST2012RA1‎; LED_0805_2012Metric
R9, R10, R11, R12, R13, R14, R15, R16: 160; R_0805_2012Metric
U7, U8: SN74HC193PWR; TSSOP-16_4.4x5mm_P0.65mm
U9, U10: 74HC244; TSSOP-20_4.4x6.5mm_P0.65mm

Connections of its further copies:
/Stack Pointer 1/c0: D9.2 (A), U7.3 (QA), U9.13 (2A2), U10.2 (1A0)
/Stack Pointer 1/c1: D10.2 (A), U7.2 (QB), U9.11 (2A3), U10.4 (1A1)
/Stack Pointer 1/c2: D11.2 (A), U7.6 (QC), U9.6 (1A2), U10.6 (1A2)
/Stack Pointer 1/c3: D12.2 (A), U7.7 (QD), U9.8 (1A3), U10.8 (1A3)
/Stack Pointer 1/c4: D13.2 (A), U8.3 (QA), U9.17 (2A0), U10.17 (2A0)
/Stack Pointer 1/c5: D14.2 (A), U8.2 (QB), U9.15 (2A1), U10.15 (2A1)
/Stack Pointer 1/c6: D15.2 (A), U8.6 (QC), U9.2 (1A0), U10.13 (2A2)
/Stack Pointer 1/c7: D16.2 (A), U8.7 (QD), U9.4 (1A1), U10.11 (2A3)
/Stack Pointer 1/~borrow: U7.13 (~BO), U8.4 (DOWN)
/Stack Pointer 1/~carry: U7.12 (~CO), U8.5 (UP)
/d0: U7.15 (A), U9.7 (2Y2); also elsewhere on the board
/d1: U7.1 (B), U9.9 (2Y3); also elsewhere on the board
/d2: U7.10 (C), U9.14 (1Y2); also elsewhere on the board
/d3: U7.9 (D), U9.12 (1Y3); also elsewhere on the board
/d4: U8.15 (A), U9.3 (2Y0); also elsewhere on the board
/d5: U8.1 (B), U9.5 (2Y1); also elsewhere on the board
/d6: U8.10 (C), U9.18 (1Y0); also elsewhere on the board
/d7: U8.9 (D), U9.16 (1Y1); also elsewhere on the board
/down_1: U7.4 (DOWN); also elsewhere on the board
/f0: U10.18 (1Y0); also elsewhere on the board
/f1: U10.16 (1Y1); also elsewhere on the board
/f2: U10.14 (1Y2); also elsewhere on the board
/f3: U10.12 (1Y3); also elsewhere on the board
/f4: U10.3 (2Y0); also elsewhere on the board
/f5: U10.5 (2Y1); also elsewhere on the board
/f6: U10.7 (2Y2); also elsewhere on the board
/f7: U10.9 (2Y3); also elsewhere on the board
/rst: U7.14 (CLR), U8.14 (CLR); also elsewhere on the board
/up_1: U7.5 (UP); also elsewhere on the board
/~a11: U10.1 (1OE), U10.19 (2OE); also elsewhere on the board
/~load_1: U7.11 (~LOAD), U8.11 (~LOAD); also elsewhere on the board
/~oe_d_1: U9.1 (1OE), U9.19 (2OE); also elsewhere on the board
GND: C5.2, C6.2, C7.2, C8.2, R9.1, R10.1, R11.1, R12.1, R13.1, R14.1, R15.1, R16.1, U7.8 (GND), U8.8 (GND), U9.10 (GND), U10.10 (GND); also elsewhere on the board
unnamed: D9.1 (K), R9.2
unnamed: D10.1 (K), R10.2
unnamed: D11.1 (K), R11.2
unnamed: D12.1 (K), R12.2
unnamed: D13.1 (K), R13.2
unnamed: D14.1 (K), R14.2
unnamed: D15.1 (K), R15.2
unnamed: D16.1 (K), R16.2
VCC: C5.1, C6.1, C7.1, C8.1, U7.16 (VCC), U8.16 (VCC), U9.20 (VCC), U10.20 (VCC); also elsewhere on the board
