imihajlow/ccpu/boards/stack/stack.kicad_pcb

## KiCad design boards/stack/stack.kicad_pcb (continued)

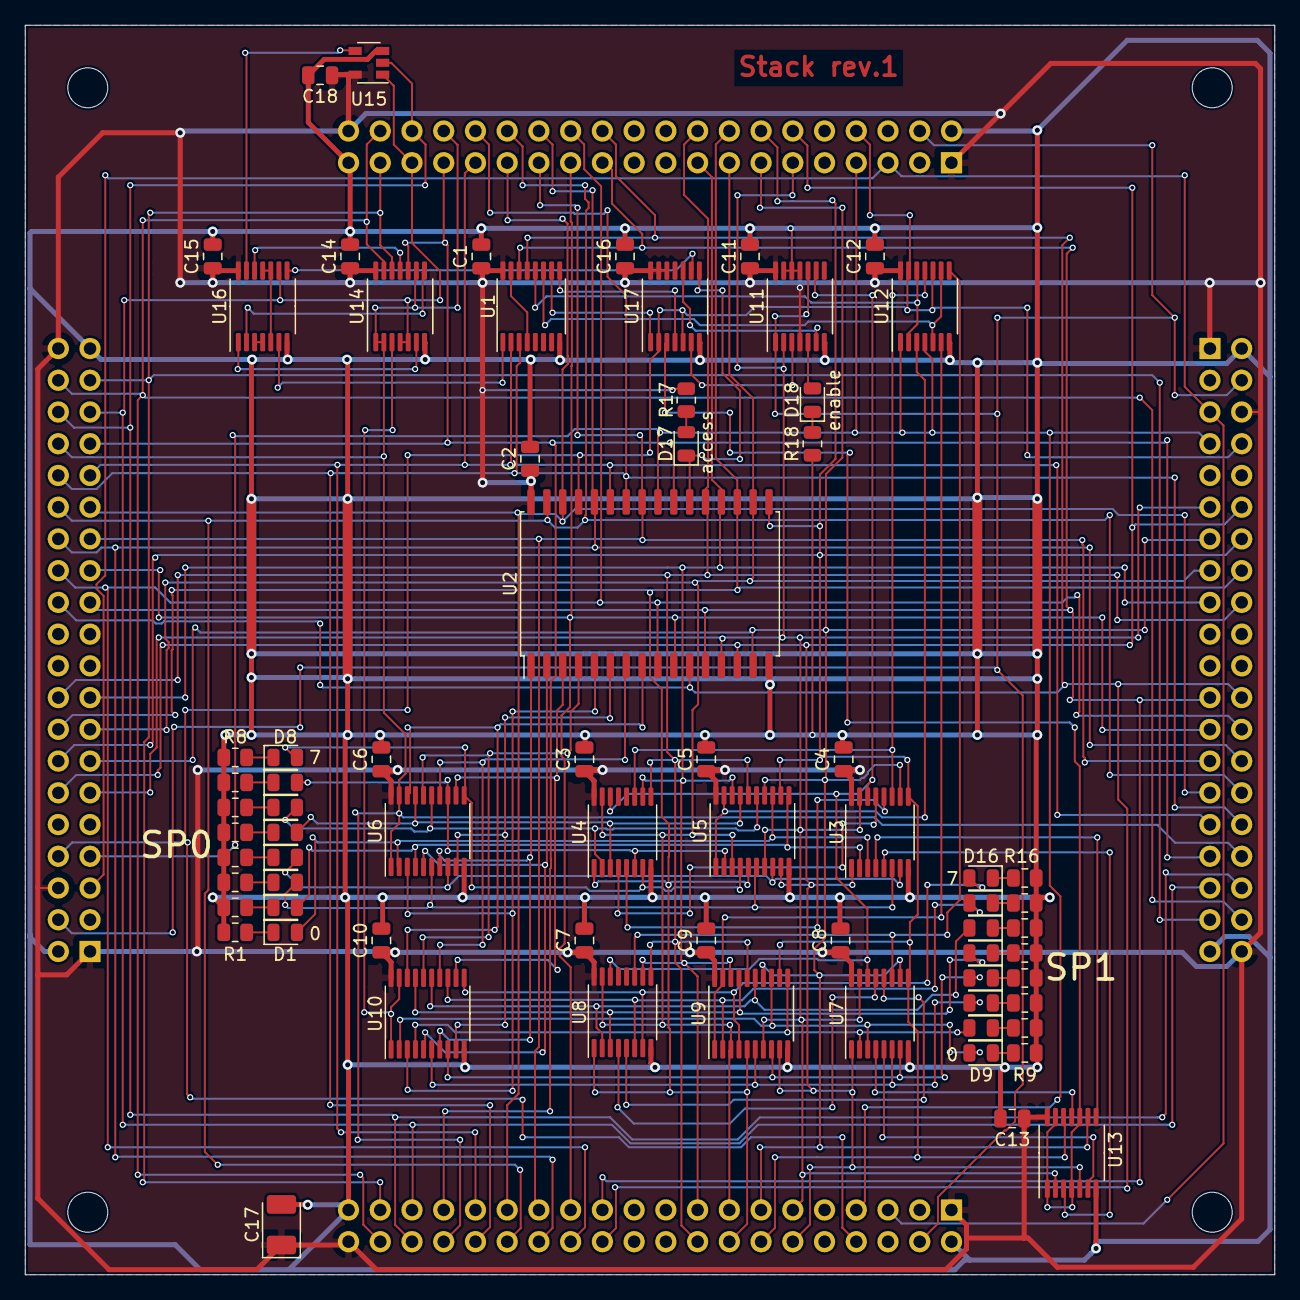
[picture p26: board stack.kicad_pcb from above]

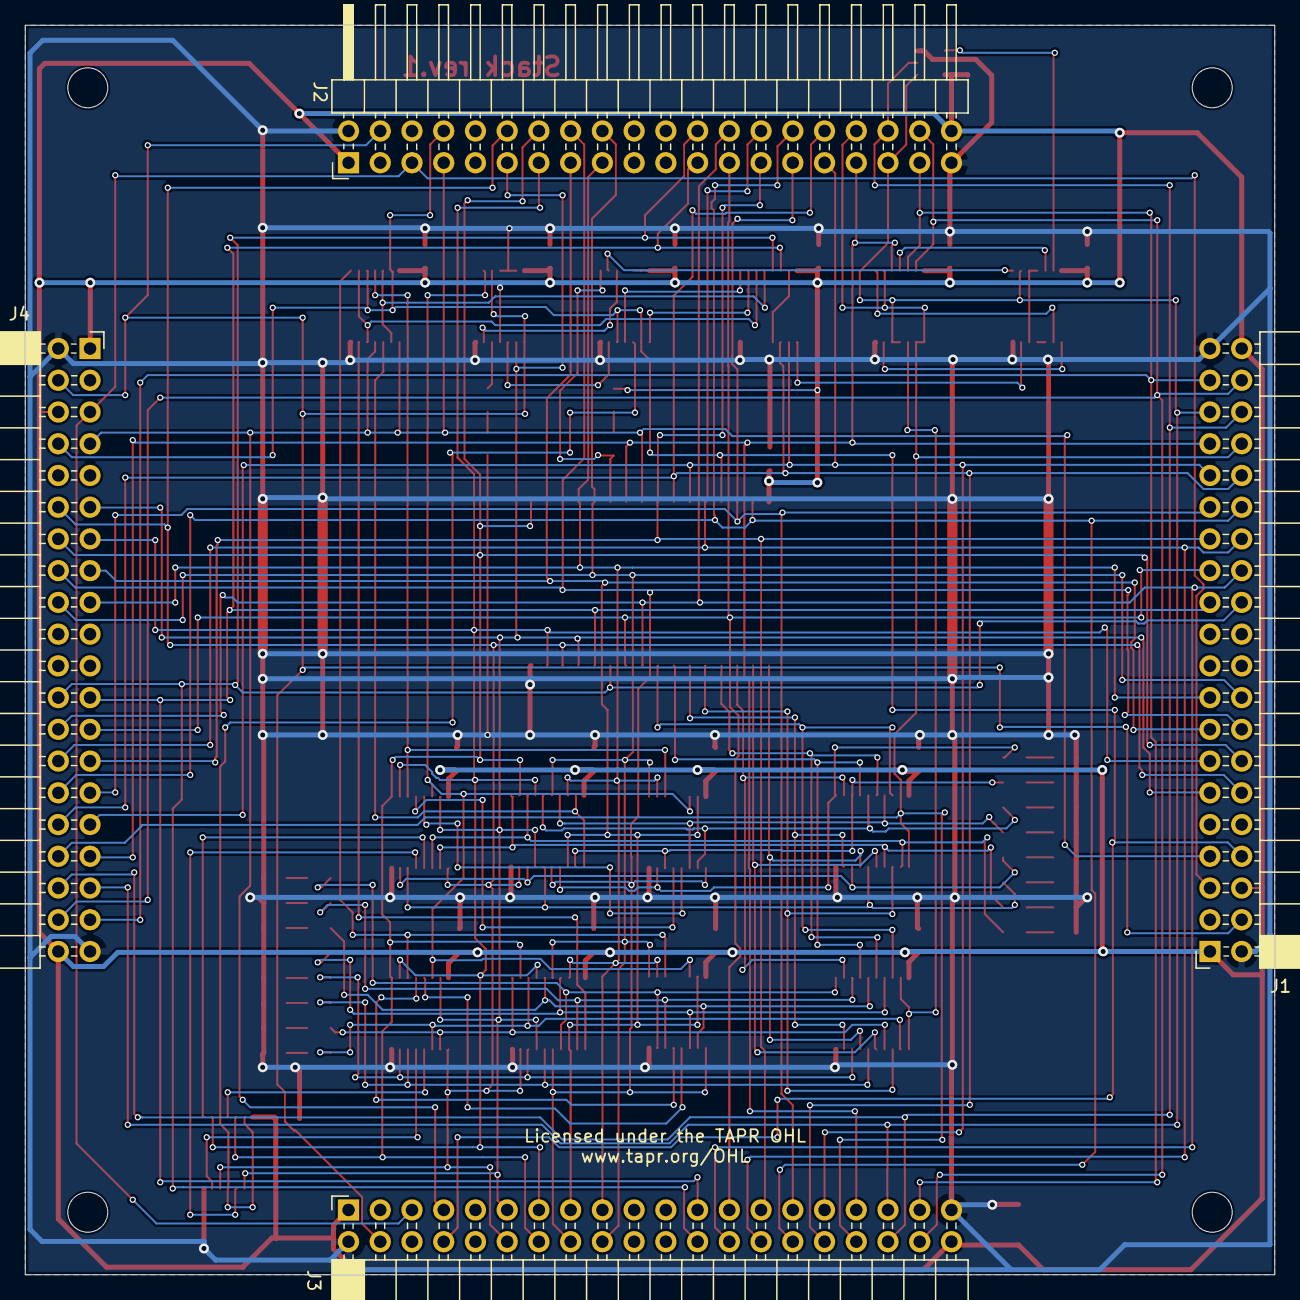
[picture p27: board stack.kicad_pcb from below]

Board: 2 copper layers, 100.0 x 100.0 mm, 79 parts (4 on the bottom side), 104 nets.
