imihajlow/ccpu/boards/vario/vario.kicad_pcb

## KiCad design boards/vario/vario.kicad_pcb (2021-02-13)

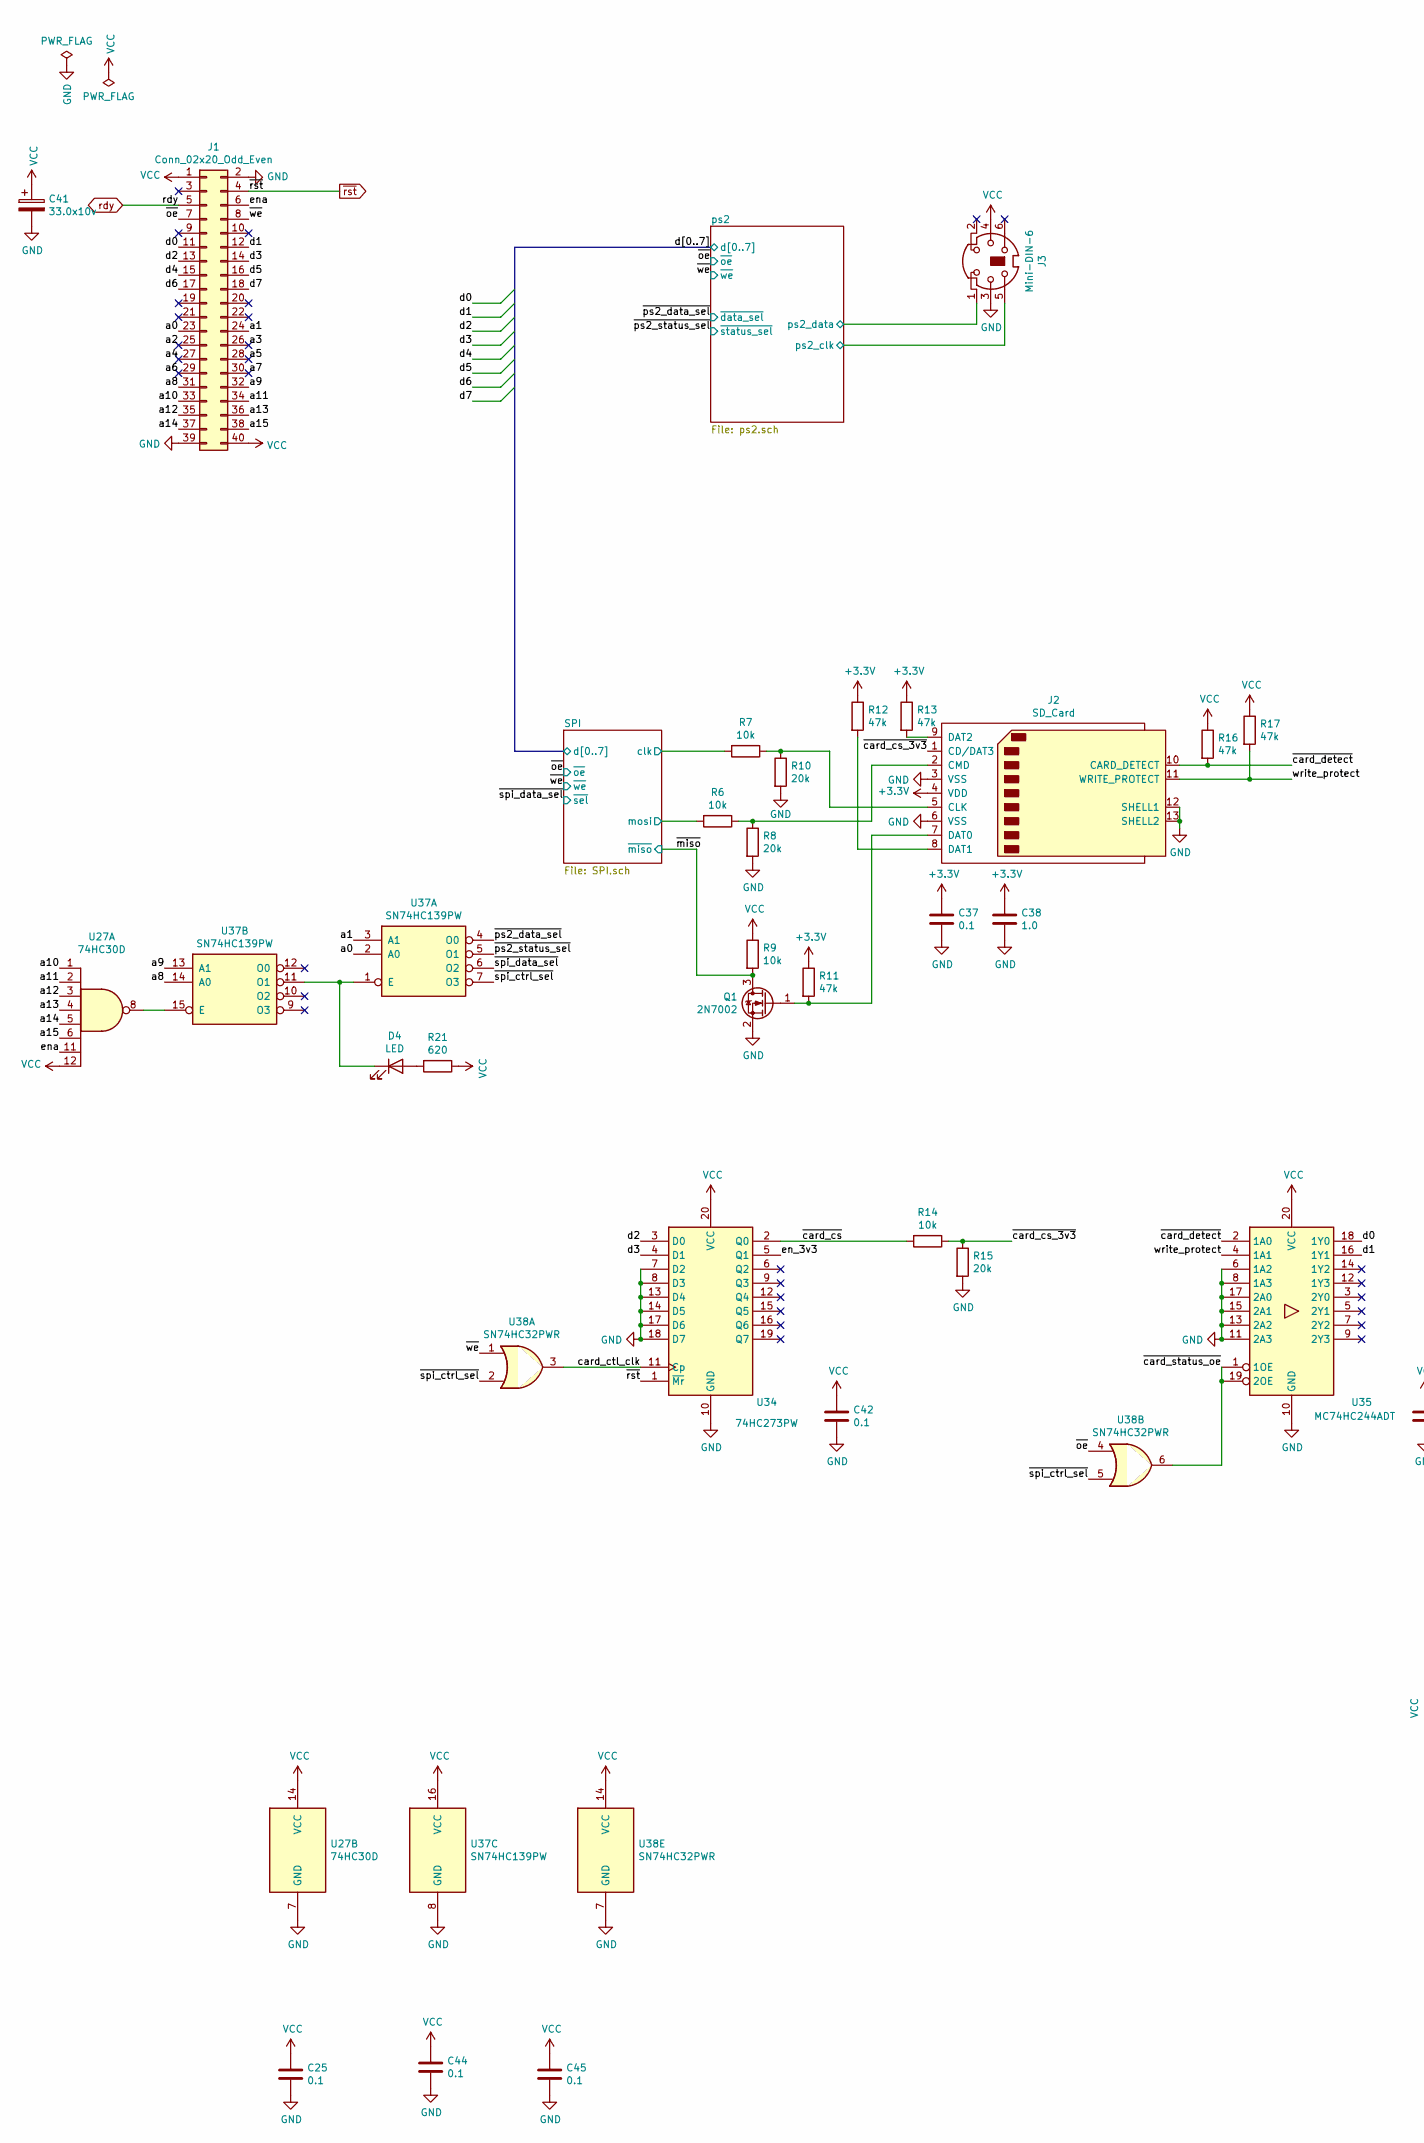
[picture p28: schematic vario.sch, Various IO module, part in row 1, column 1]

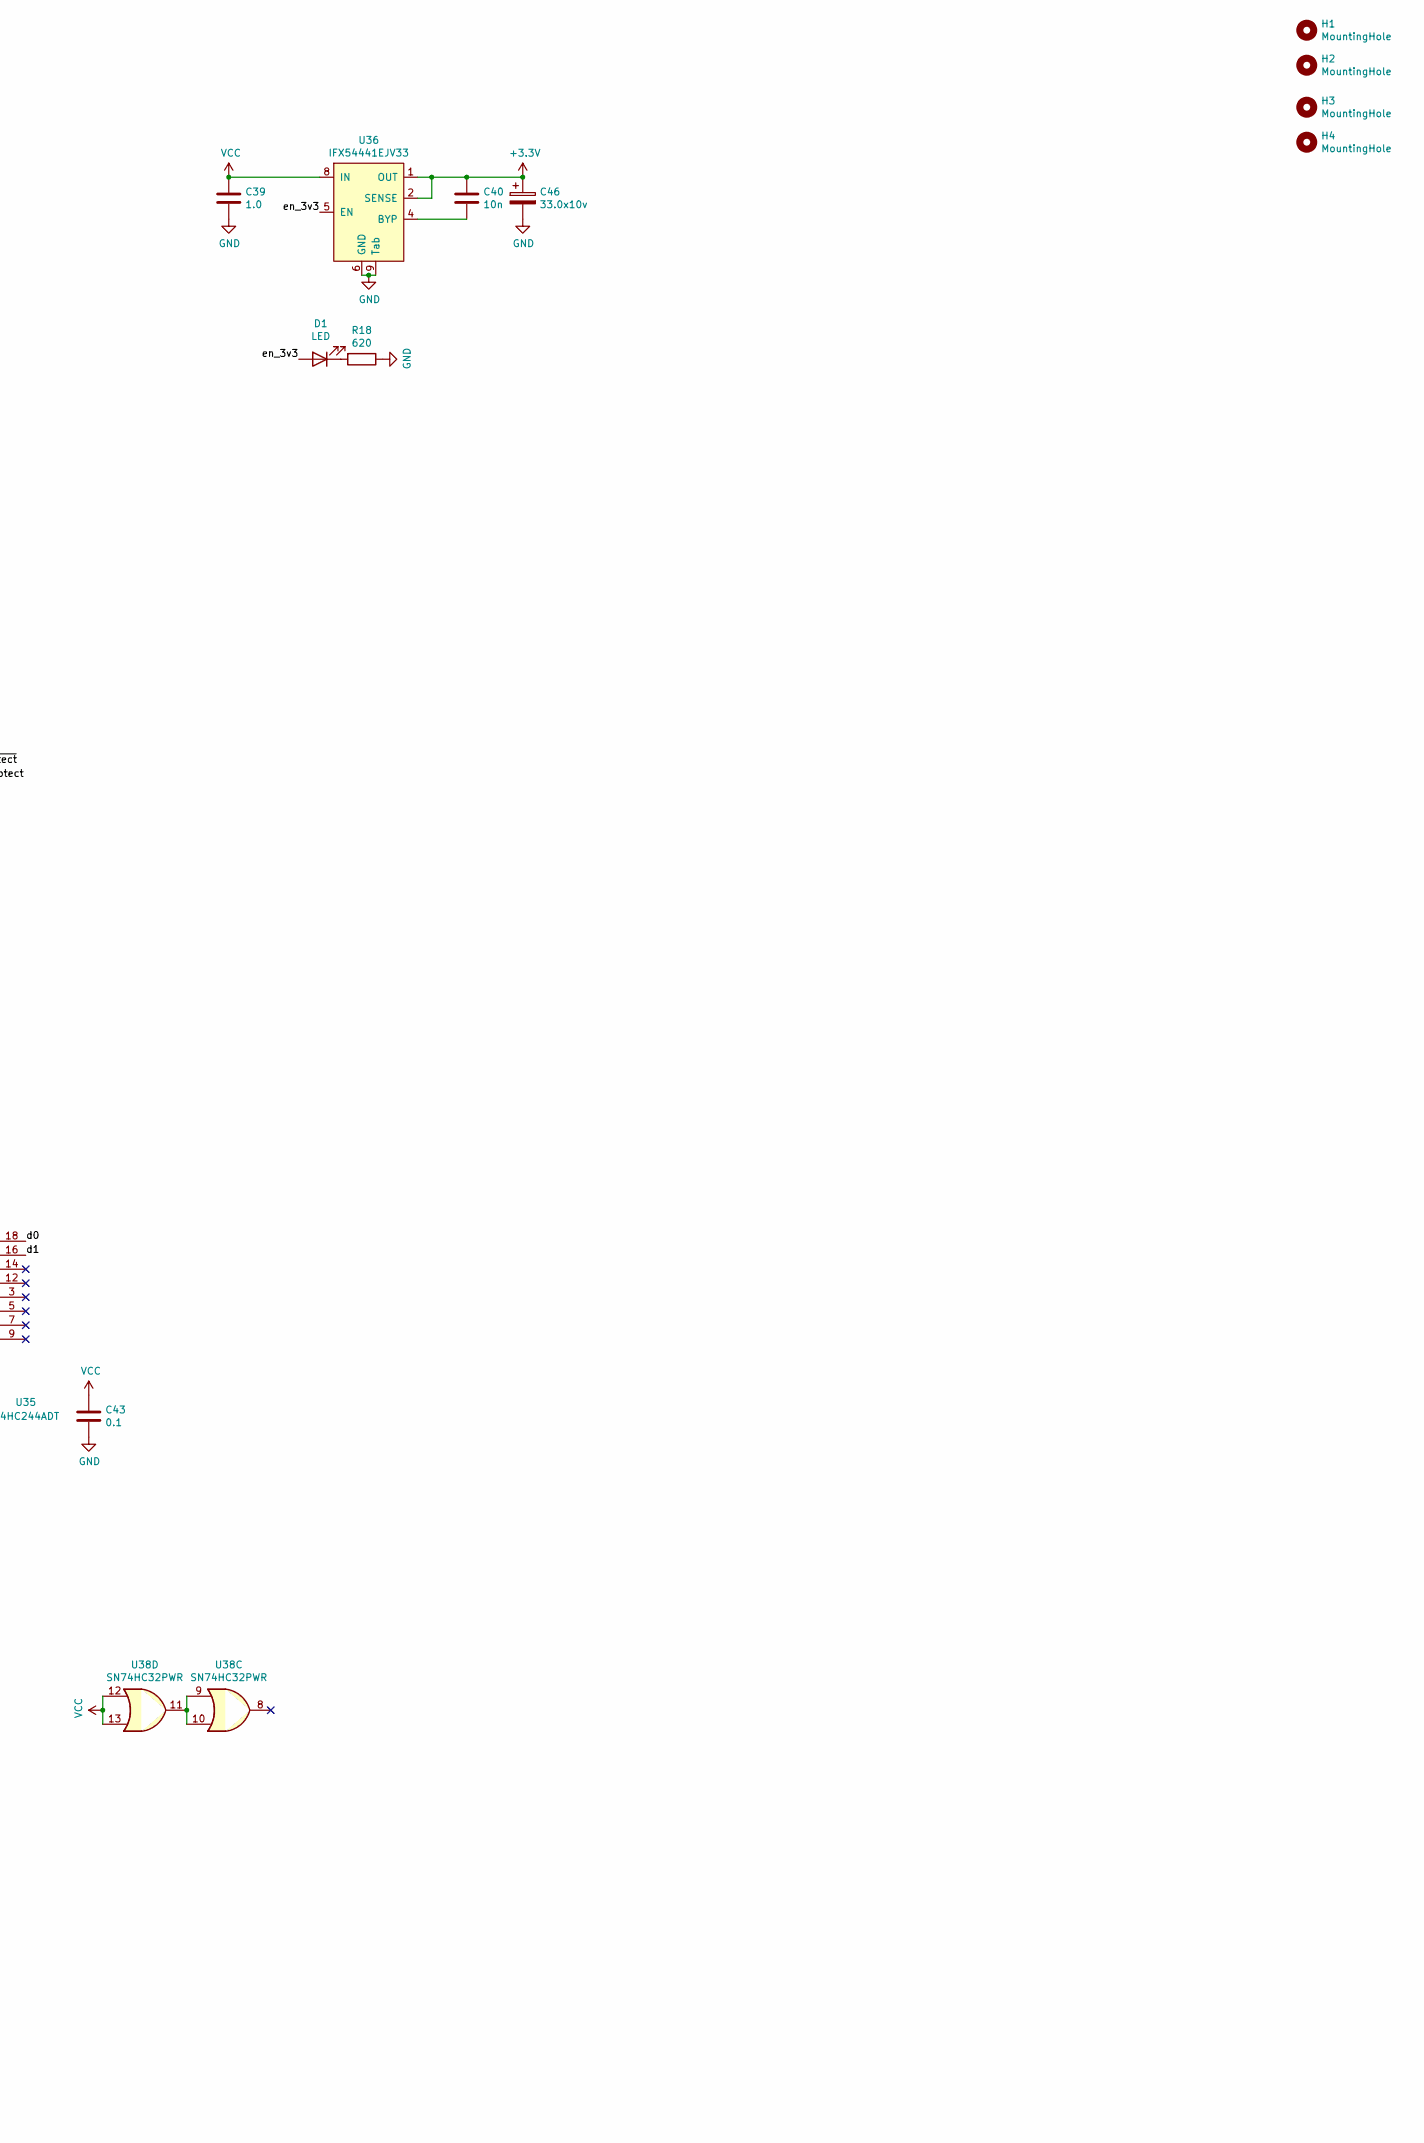
[picture p29: schematic vario.sch, Various IO module, part in row 1, column 2]

Parts:
C25, C37, C42, C43, C44, C45: 0.1; C_0805_2012Metric
C38, C39: 1.0; C_0805_2012Metric
C40: 10n; C_0805_2012Metric
C41, C46: 33.0x10v; CP_EIA-3528-21_Kemet-B_Pad1.50x2.35mm_HandSolder
D1, D4: LED; LED_0805_2012Metric
H1, H2, H3, H4: MountingHole; MountingHole_3.2mm_M3
J1: Conn_02x20_Odd_Even; PinHeader_2x20_P2.54mm_Horizontal
J2: SD_Card; SD_Kyocera_145638009211859+
J3: Mini-DIN-6; Connector-MiniDIN-6
Q1: 2N7002; SOT-23
R6, R7, R9, R14: 10k; R_0805_2012Metric
R8, R10, R15: 20k; R_0805_2012Metric
R11, R12, R13, R16, R17: 47k; R_0805_2012Metric
R18, R21: 620; R_0805_2012Metric
U27: 74HC30D; SOIC-14_3.9x8.7mm_P1.27mm
U34: 74HC273PW; TSSOP-20_4.4x6.5mm_P0.65mm
U35: MC74HC244ADT; TSSOP-20_4.4x6.5mm_P0.65mm
U36: IFX54441EJV33; Infineon_PG-DSO-8-27_3.9x4.9mm_EP2.65x3mm
U37: SN74HC139PW; TSSOP-16_4.4x5mm_P0.65mm
U38: SN74HC32PWR; TSSOP-14_4.4x5mm_P0.65mm

Connections:
+3V3: C37.1, C38.1, C40.1, C46.1, J2.4 (VDD), R11.1, R12.1, R13.1, U36.1 (OUT), U36.2 (SENSE)
/SPI/clk: R7.2; also elsewhere on the board
/SPI/mosi: R6.2; also elsewhere on the board
/a0: J1.23, U37.2 (A0)
/a1: J1.24, U37.3 (A1)
/a8: J1.31, U37.14 (A0)
/a9: J1.32, U37.13 (A1)
/a10: J1.33, U27.1
/a11: J1.34, U27.2
/a12: J1.35, U27.3
/a13: J1.36, U27.4
/a14: J1.37, U27.5
/a15: J1.38, U27.6
/card_ctl_clk: U34.11 (Cp), U38.3
/d0: J1.11, U35.18 (1Y0); also elsewhere on the board
/d1: J1.12, U35.16 (1Y1); also elsewhere on the board
/d2: J1.13, U34.3 (D0); also elsewhere on the board
/d3: J1.14, U34.4 (D1); also elsewhere on the board
/d4: J1.15; also elsewhere on the board
/d5: J1.16; also elsewhere on the board
/d6: J1.17; also elsewhere on the board
/d7: J1.18; also elsewhere on the board
/en_3v3: D1.2 (A), U34.5 (Q1), U36.5 (EN)
/ena: J1.6, U27.11
/ps2/ps2_clk: J3.5; also elsewhere on the board
/ps2/ps2_data: J3.1; also elsewhere on the board
/write_protect: J2.11 (WRITE_PROTECT), R17.2, U35.4 (1A1)
/~card_cs: R14.2, U34.2 (Q0)
/~card_cs_3v3: J2.1 (CD/DAT3), R14.1, R15.1
/~card_detect: J2.10 (CARD_DETECT), R16.2, U35.2 (1A0)
/~card_status_oe: U35.1 (1OE), U35.19 (2OE), U38.6
/~miso: Q1.3 (D), R9.2; also elsewhere on the board
/~oe: J1.7, U38.4; also elsewhere on the board
/~ps2_data_sel: U37.4 (O0); also elsewhere on the board
/~ps2_status_sel: U37.5 (O1); also elsewhere on the board
/~spi_ctrl_sel: U37.7 (O3), U38.2, U38.5
/~spi_data_sel: U37.6 (O2); also elsewhere on the board
/~we: J1.8, U38.1; also elsewhere on the board
GND: C25.2, C37.2, C38.2, C39.2, C41.2, C42.2, C43.2, C44.2, C45.2, C46.2, J1.2, J1.39, J2.3 (VSS), J2.6 (VSS), J2.12 (SHELL1), J2.13 (SHELL2), J3.3, Q1.2 (S), R8.2, R10.2, R15.2, R18.1, U27.7 (GND), U34.7 (D2), U34.8 (D3), U34.10 (GND), U34.13 (D4), U34.14 (D5), U34.17 (D6), U34.18 (D7), U35.6 (1A2), U35.8 (1A3), U35.10 (GND), U35.11 (2A3), U35.13 (2A2), U35.15 (2A1), U35.17 (2A0), U36.6 (GND), U36.9 (Tab), U37.8 (GND), U38.7 (GND); also elsewhere on the board
unnamed: C40.2, U36.4 (BYP)
unnamed: D1.1 (K), R18.2
unnamed: D4.1 (K), U37.1 (E), U37.11 (O1)
unnamed: D4.2 (A), R21.2
unnamed: J2.2 (CMD), R6.1, R8.1
unnamed: J2.5 (CLK), R7.1, R10.1
unnamed: J2.7 (DAT0), Q1.1 (G), R11.2
unnamed: J2.8 (DAT1), R12.2
unnamed: J2.9 (DAT2), R13.2
unnamed: U27.8, U37.15 (E)
unnamed: U38.9, U38.10, U38.11
VCC: C25.1, C39.1, C41.1, C42.1, C43.1, C44.1, C45.1, J1.1, J1.40, J3.4, R9.1, R16.1, R17.1, R21.1, U27.12, U27.14 (VCC), U34.20 (VCC), U35.20 (VCC), U36.8 (IN), U37.16 (VCC), U38.12, U38.13, U38.14 (VCC); also elsewhere on the board
rdy: J1.5; also elsewhere on the board
~rst: J1.4, U34.1 (~Mr); also elsewhere on the board

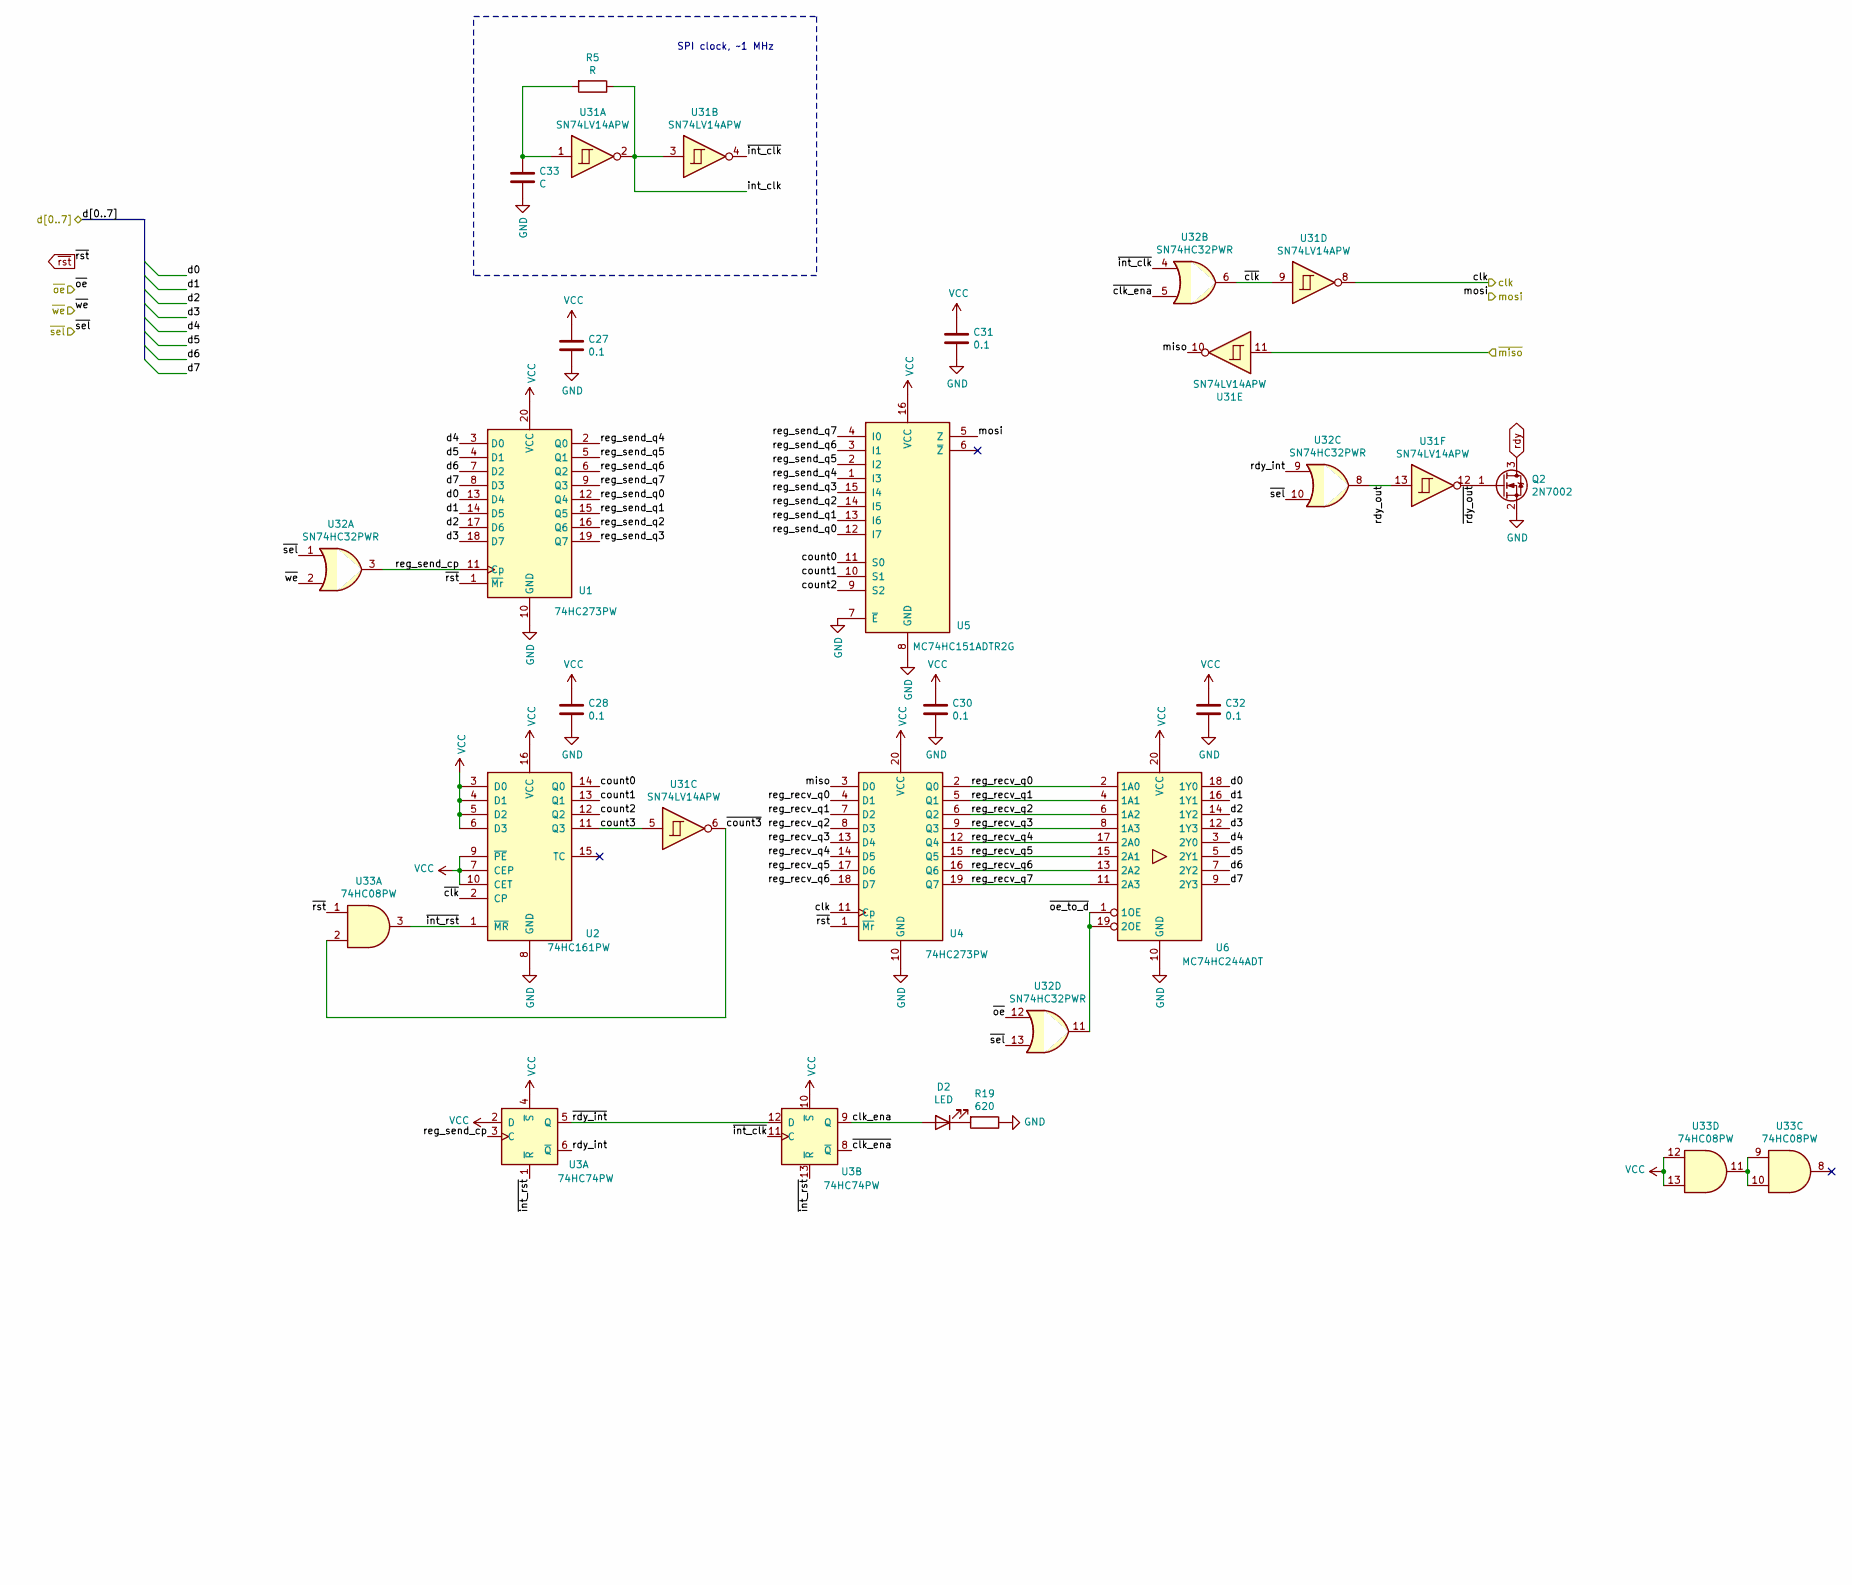
[picture p30: schematic SPI.sch, SPI controller, part in row 1, column 1]

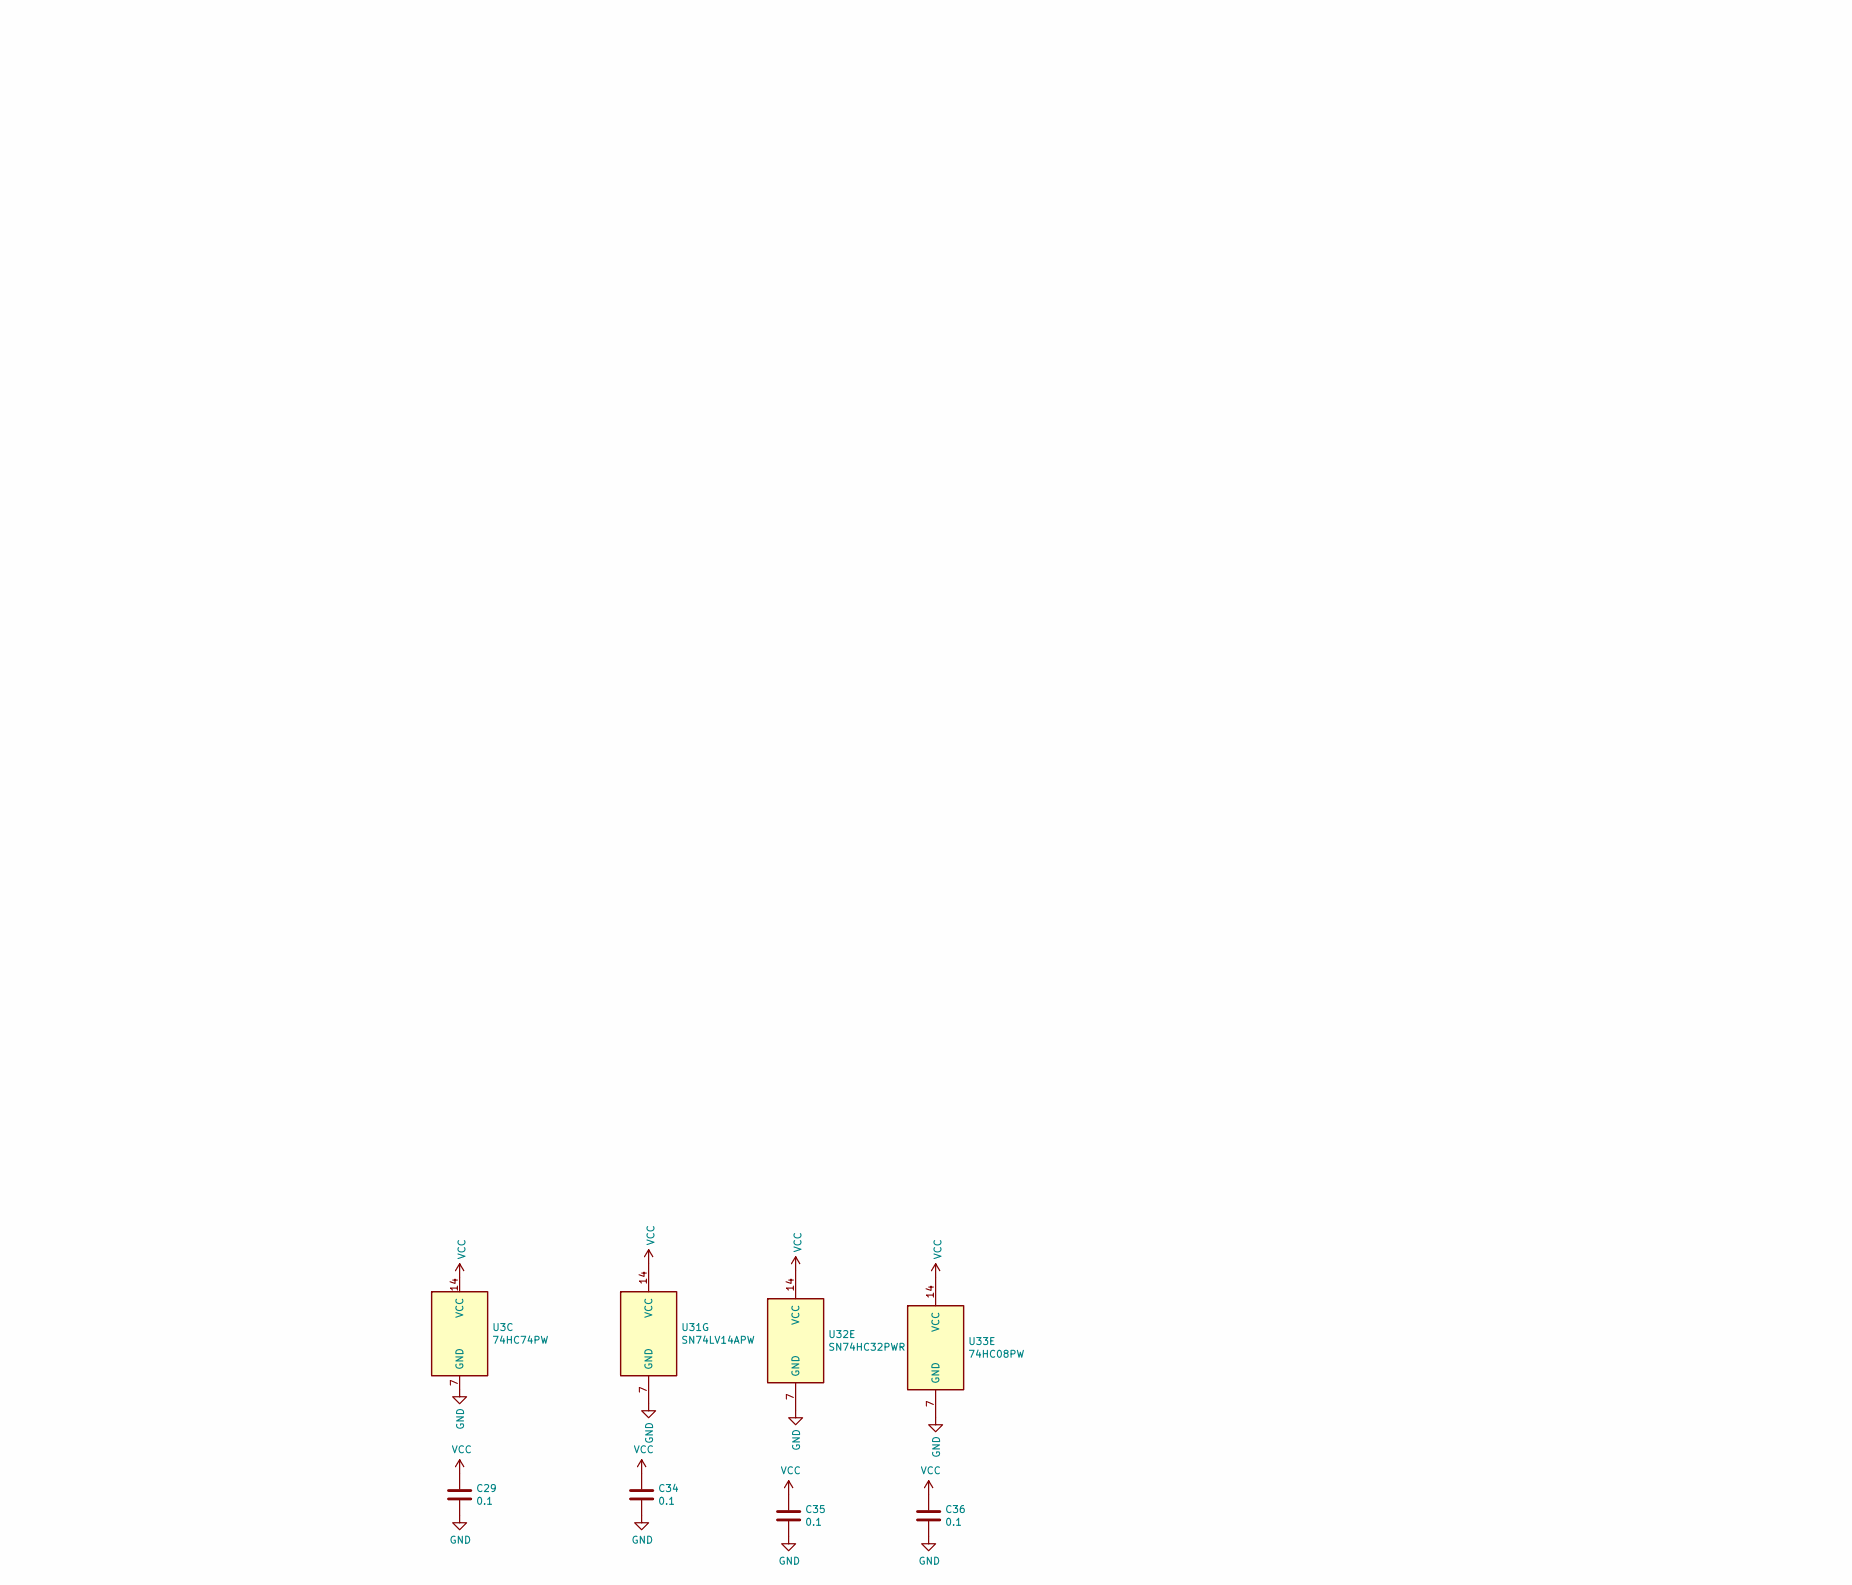
[picture p31: schematic SPI.sch, SPI controller, part in row 2, column 1]

Parts:
C27, C28, C29, C30, C31, C32, C34, C35, C36: 0.1; C_0805_2012Metric
C33: C; C_0805_2012Metric
D2: LED; LED_0805_2012Metric
Q2: 2N7002; SOT-23
R5: R; R_0805_2012Metric
R19: 620; R_0805_2012Metric
U1, U4: 74HC273PW; TSSOP-20_4.4x6.5mm_P0.65mm
U2: 74HC161PW; TSSOP-16_4.4x5mm_P0.65mm
U3: 74HC74PW; TSSOP-14_4.4x5mm_P0.65mm
U5: MC74HC151ADTR2G; TSSOP-16_4.4x5mm_P0.65mm
U6: MC74HC244ADT; TSSOP-20_4.4x6.5mm_P0.65mm
U31: SN74LV14APW; TSSOP-14_4.4x5mm_P0.65mm
U32: SN74HC32PWR; TSSOP-14_4.4x5mm_P0.65mm
U33: 74HC08PW; TSSOP-14_4.4x5mm_P0.65mm

Connections:
/SPI/clk: U4.11 (Cp), U31.8; also elsewhere on the board
/SPI/clk_ena: D2.2 (A), U3.9 (Q)
/SPI/count0: U2.14 (Q0), U5.11 (S0)
/SPI/count1: U2.13 (Q1), U5.10 (S1)
/SPI/count2: U2.12 (Q2), U5.9 (S2)
/SPI/count3: U2.11 (Q3), U31.5
/SPI/int_clk: R5.1, U31.2, U31.3
/SPI/miso: U4.3 (D0), U31.10
/SPI/mosi: U5.5 (Z); also elsewhere on the board
/SPI/rdy_int: U3.6 (~Q), U32.9
/SPI/rdy_out: U31.13, U32.8
/SPI/reg_recv_q0: U4.2 (Q0), U4.4 (D1), U6.2 (1A0)
/SPI/reg_recv_q1: U4.5 (Q1), U4.7 (D2), U6.4 (1A1)
/SPI/reg_recv_q2: U4.6 (Q2), U4.8 (D3), U6.6 (1A2)
/SPI/reg_recv_q3: U4.9 (Q3), U4.13 (D4), U6.8 (1A3)
/SPI/reg_recv_q4: U4.12 (Q4), U4.14 (D5), U6.17 (2A0)
/SPI/reg_recv_q5: U4.15 (Q5), U4.17 (D6), U6.15 (2A1)
/SPI/reg_recv_q6: U4.16 (Q6), U4.18 (D7), U6.13 (2A2)
/SPI/reg_recv_q7: U4.19 (Q7), U6.11 (2A3)
/SPI/reg_send_cp: U1.11 (Cp), U3.3 (C), U32.3
/SPI/reg_send_q0: U1.12 (Q4), U5.12 (I7)
/SPI/reg_send_q1: U1.15 (Q5), U5.13 (I6)
/SPI/reg_send_q2: U1.16 (Q6), U5.14 (I5)
/SPI/reg_send_q3: U1.19 (Q7), U5.15 (I4)
/SPI/reg_send_q4: U1.2 (Q0), U5.1 (I3)
/SPI/reg_send_q5: U1.5 (Q1), U5.2 (I2)
/SPI/reg_send_q6: U1.6 (Q2), U5.3 (I1)
/SPI/reg_send_q7: U1.9 (Q3), U5.4 (I0)
/SPI/~clk: U2.2 (CP), U31.9, U32.6
/SPI/~clk_ena: U3.8 (~Q), U32.5
/SPI/~count3: U31.6, U33.2
/SPI/~int_clk: U3.11 (C), U31.4, U32.4
/SPI/~int_rst: U2.1 (~MR), U3.1 (~R), U3.13 (~R), U33.3
/SPI/~oe_to_d: U6.1 (1OE), U6.19 (2OE), U32.11
/SPI/~rdy_int: U3.5 (Q), U3.12 (D)
/SPI/~rdy_out: Q2.1 (G), U31.12
/d0: U1.13 (D4), U6.18 (1Y0); also elsewhere on the board
/d1: U1.14 (D5), U6.16 (1Y1); also elsewhere on the board
/d2: U1.17 (D6), U6.14 (1Y2); also elsewhere on the board
/d3: U1.18 (D7), U6.12 (1Y3); also elsewhere on the board
/d4: U1.3 (D0), U6.3 (2Y0); also elsewhere on the board
/d5: U1.4 (D1), U6.5 (2Y1); also elsewhere on the board
/d6: U1.7 (D2), U6.7 (2Y2); also elsewhere on the board
/d7: U1.8 (D3), U6.9 (2Y3); also elsewhere on the board
/~miso: U31.11; also elsewhere on the board
/~oe: U32.12; also elsewhere on the board
/~spi_data_sel: U32.1, U32.10, U32.13; also elsewhere on the board
/~we: U32.2; also elsewhere on the board
GND: C27.2, C28.2, C29.2, C30.2, C31.2, C32.2, C33.2, C34.2, C35.2, C36.2, Q2.2 (S), R19.1, U1.10 (GND), U2.8 (GND), U3.7 (GND), U4.10 (GND), U5.7 (~E), U5.8 (GND), U6.10 (GND), U31.7 (GND), U32.7 (GND), U33.7 (GND); also elsewhere on the board
unnamed: C33.1, R5.2, U31.1
unnamed: D2.1 (K), R19.2
unnamed: U33.9, U33.10, U33.11
VCC: C27.1, C28.1, C29.1, C30.1, C31.1, C32.1, C34.1, C35.1, C36.1, U1.20 (VCC), U2.3 (D0), U2.4 (D1), U2.5 (D2), U2.6 (D3), U2.7 (CEP), U2.9 (~PE), U2.10 (CET), U2.16 (VCC), U3.2 (D), U3.4 (~S), U3.10 (~S), U3.14 (VCC), U4.20 (VCC), U5.16 (VCC), U6.20 (VCC), U31.14 (VCC), U32.14 (VCC), U33.12, U33.13, U33.14 (VCC); also elsewhere on the board
rdy: Q2.3 (D); also elsewhere on the board
~rst: U1.1 (~Mr), U4.1 (~Mr), U33.1; also elsewhere on the board

Notes on the sheet:
SPI clock, ~~1 MHz
