imihajlow/ccpu/boards/vario/vario.kicad_pcb

## KiCad design boards/vario/vario.kicad_pcb (continued)

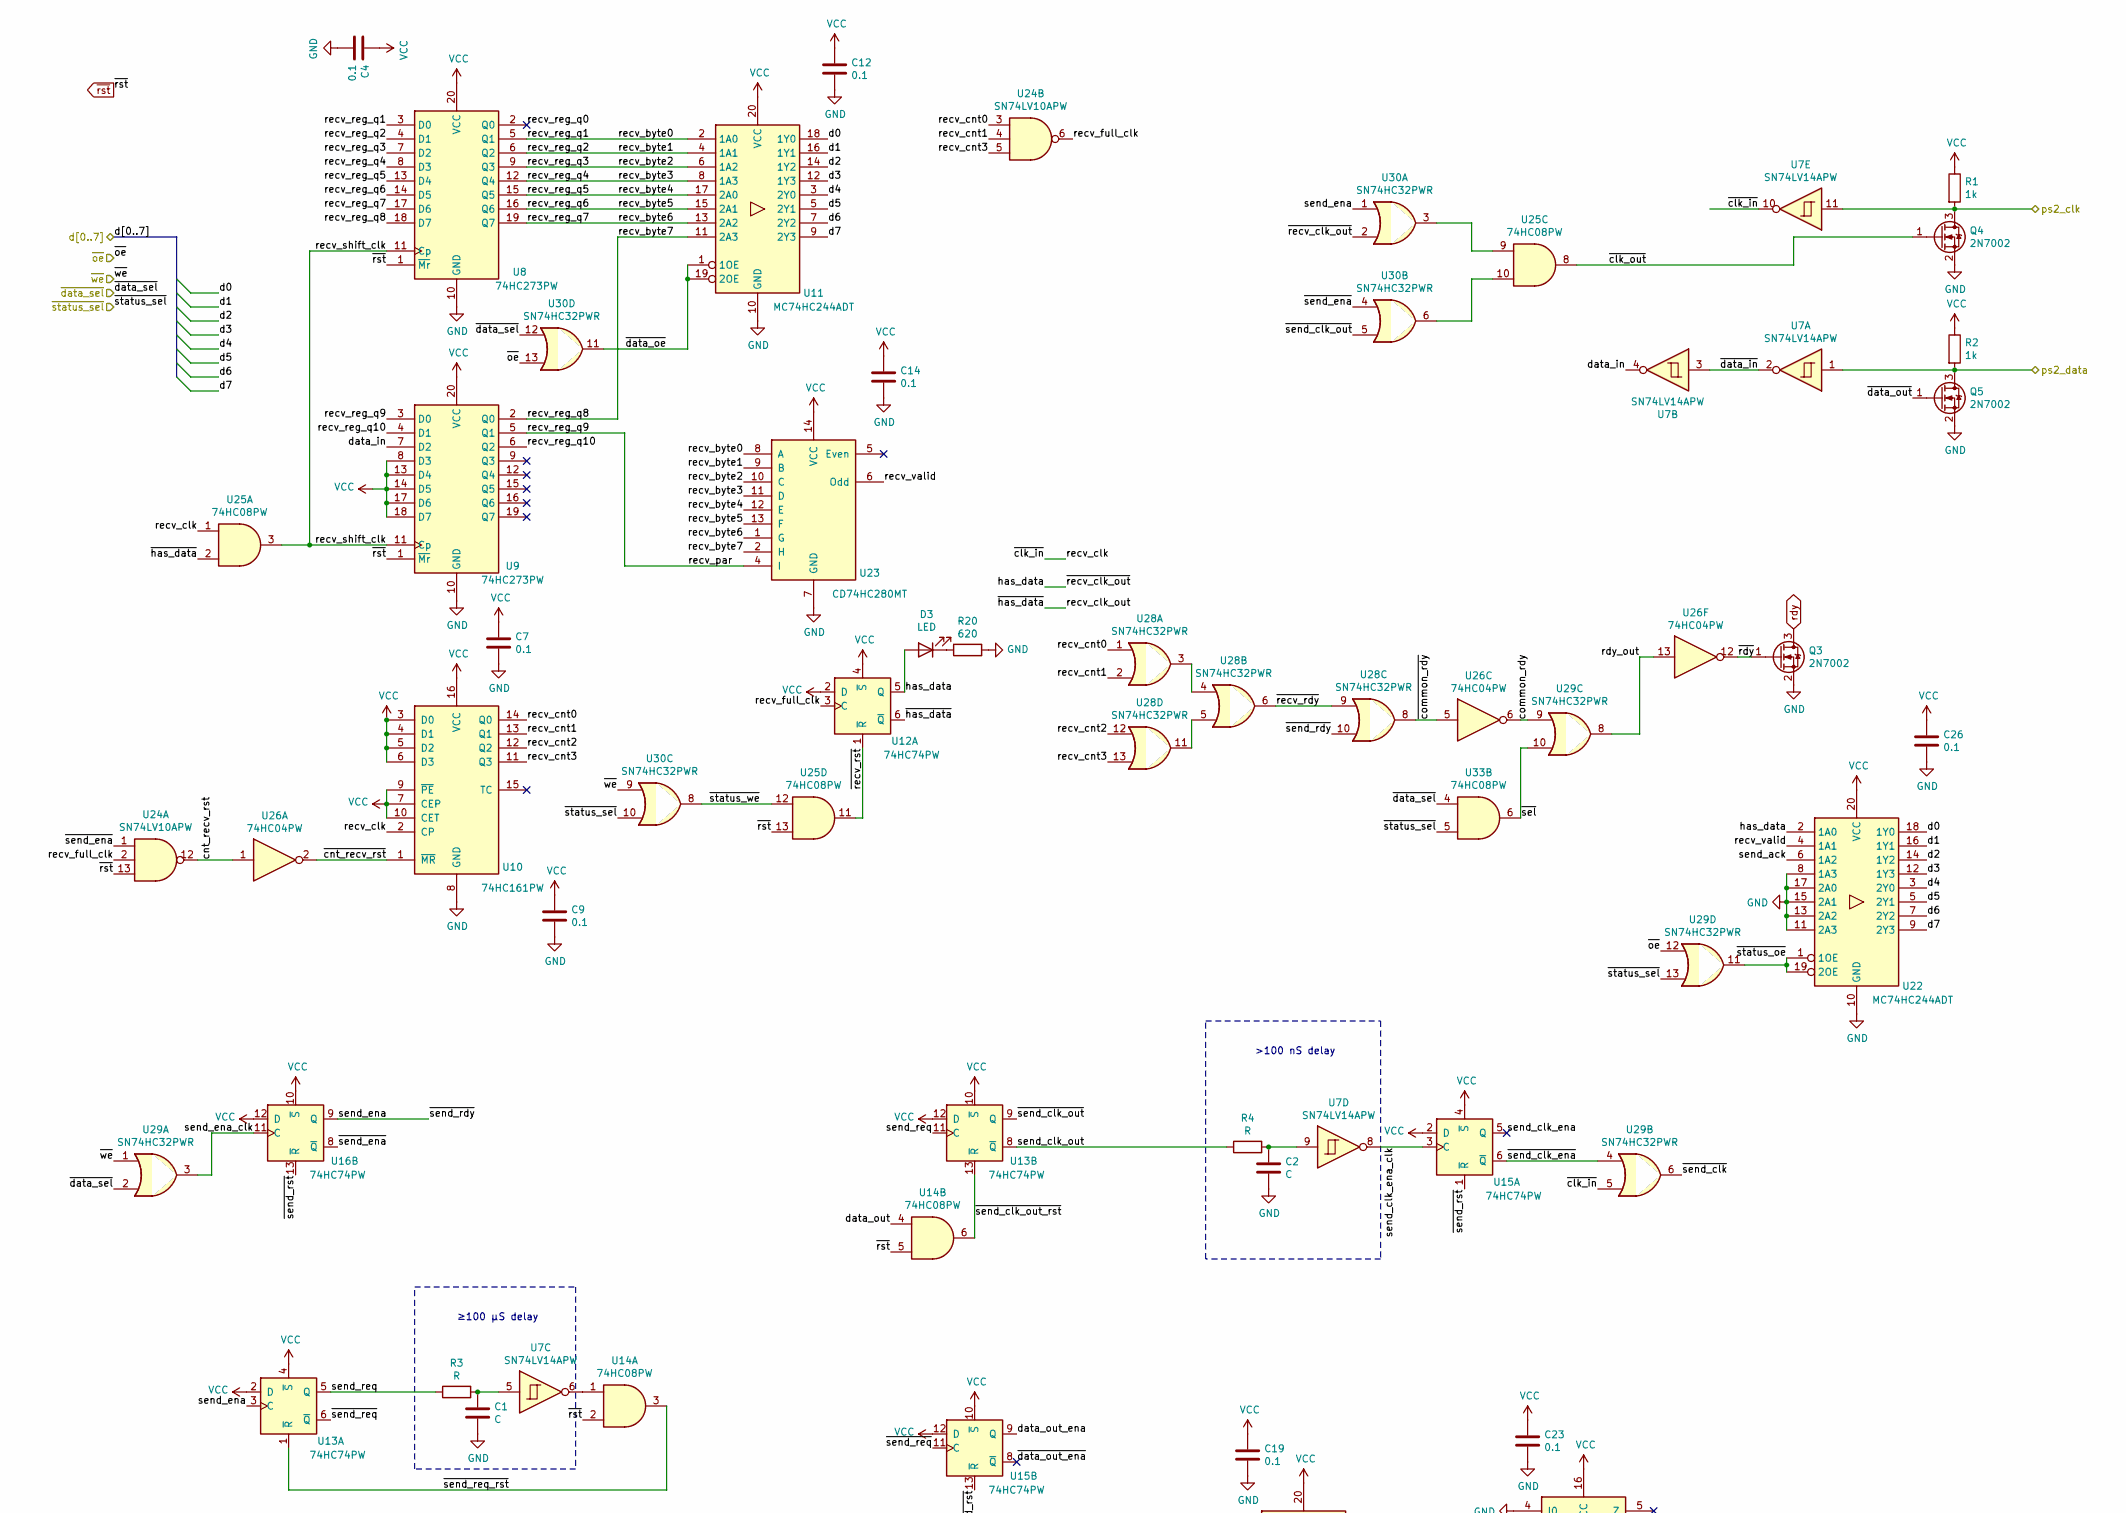
[picture p32: schematic ps2.sch, PS/2 transiever, part in row 1, column 1]

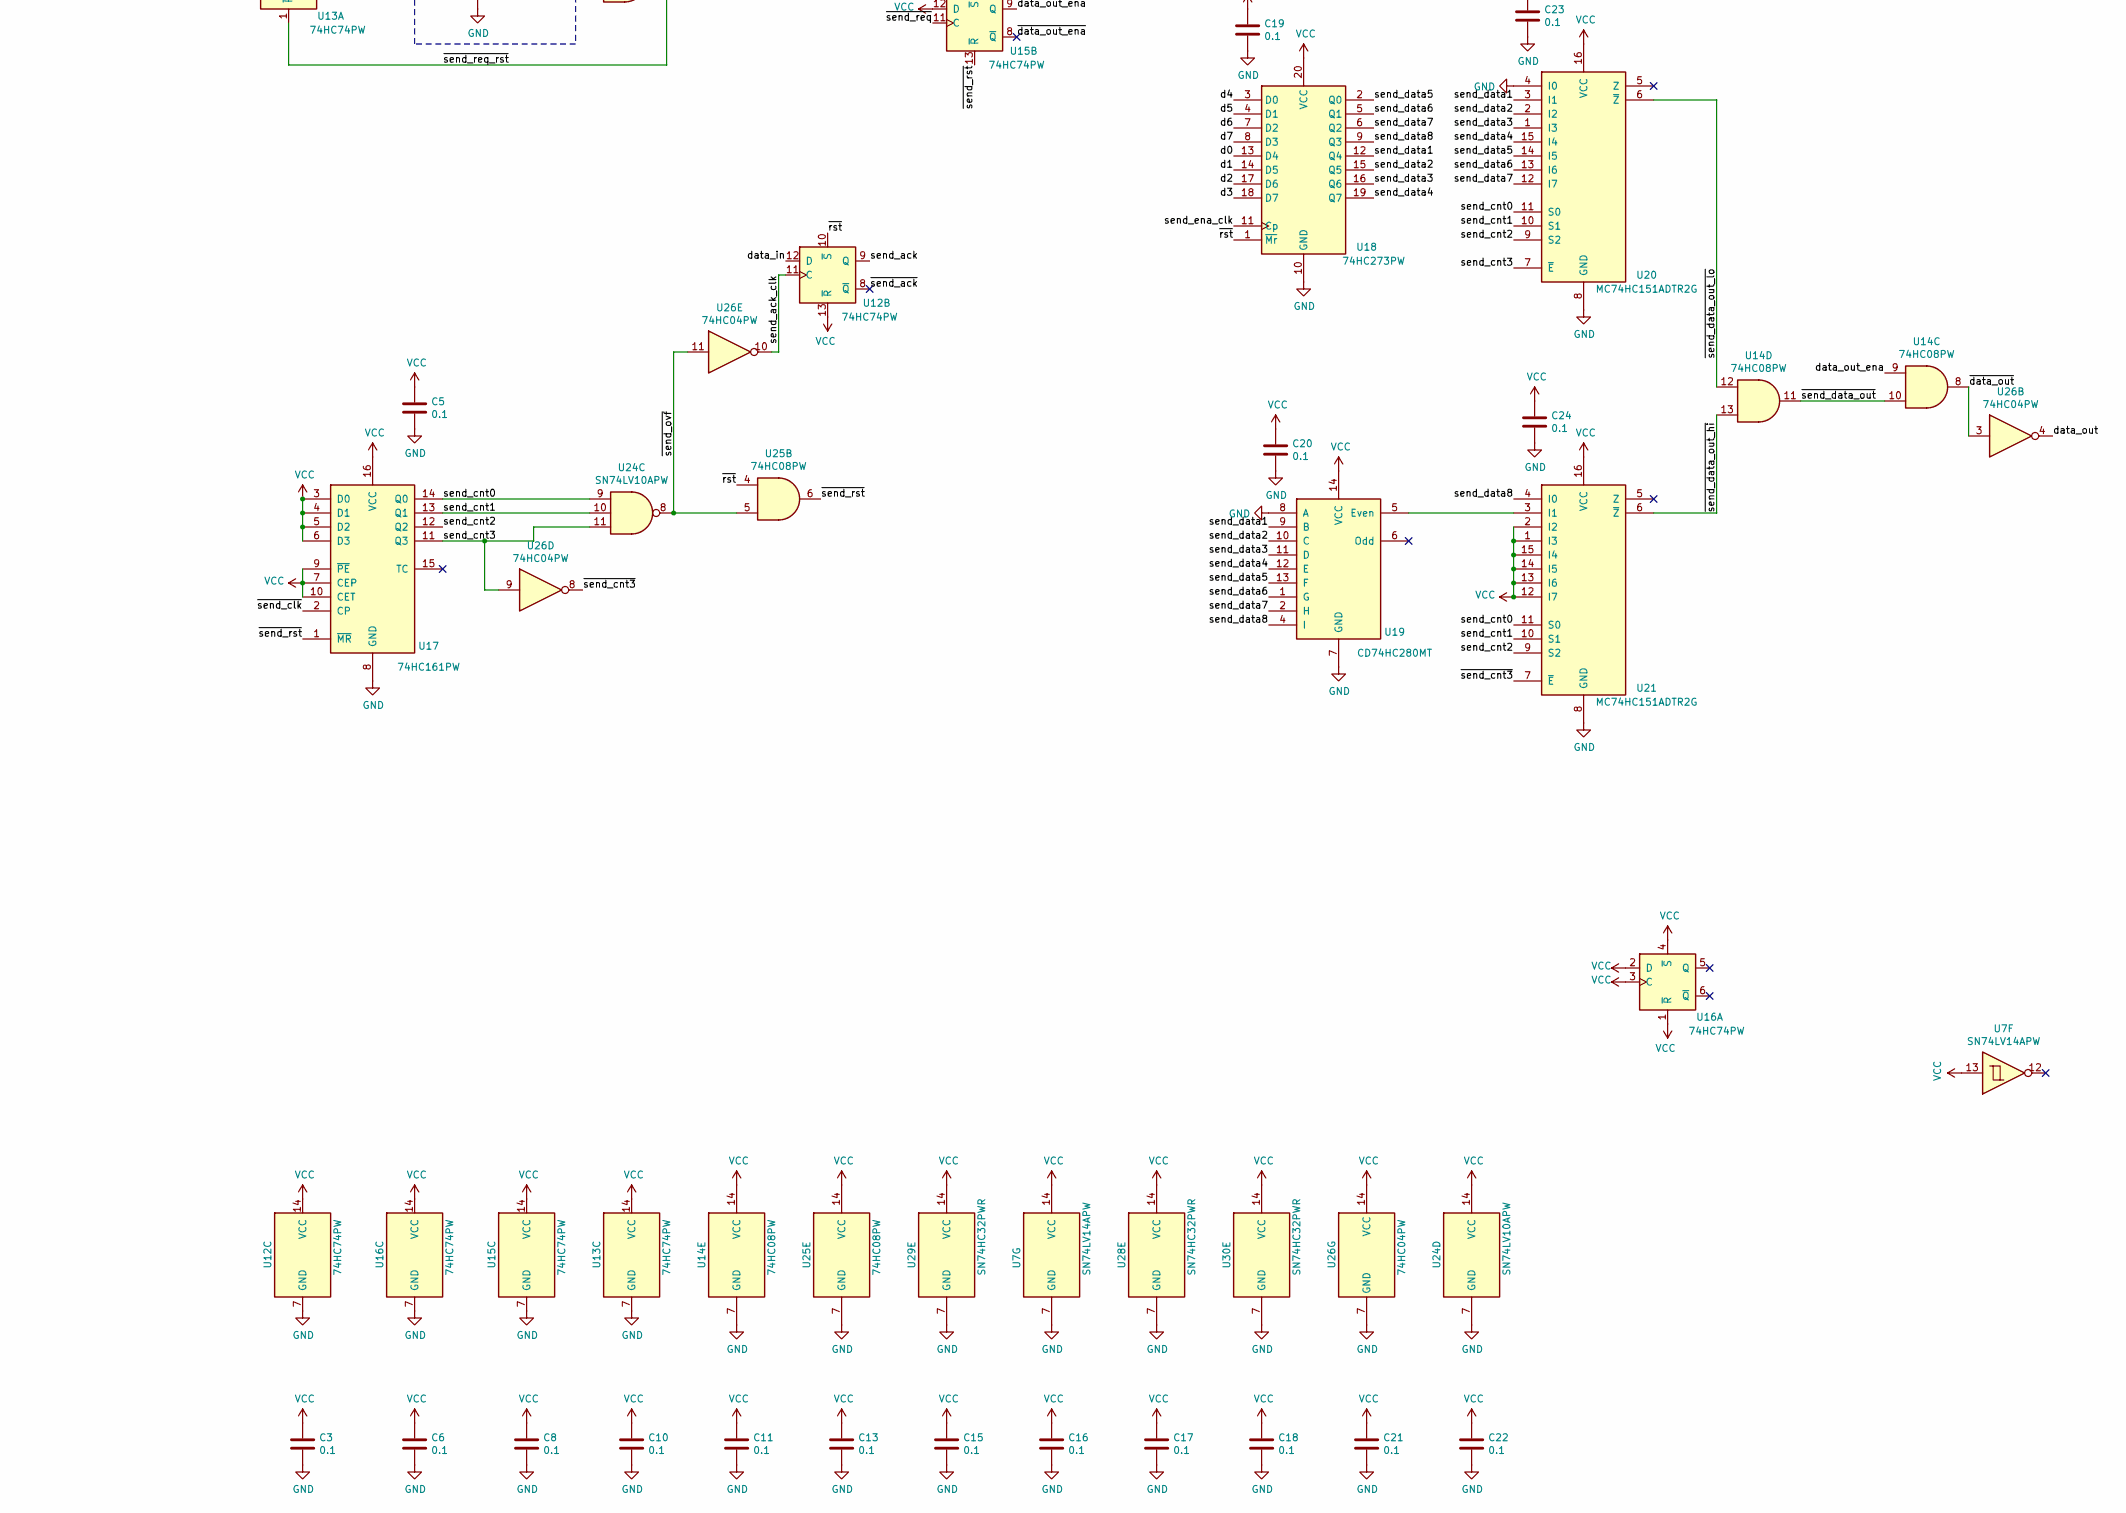
[picture p33: schematic ps2.sch, PS/2 transiever, part in row 2, column 1]

Parts:
C1, C2: C; C_0805_2012Metric
C3, C4, C5, C6, C7, C8, C9, C10, C11, C12, C13, C14, C15, C16, C17, C18, C19, C20, C21, C22, C23, C24, C26: 0.1; C_0805_2012Metric
D3: LED; LED_0805_2012Metric
Q3, Q4, Q5: 2N7002; SOT-23
R1, R2: 1k; R_0805_2012Metric
R3, R4: R; R_0805_2012Metric
R20: 620; R_0805_2012Metric
U7: SN74LV14APW; TSSOP-14_4.4x5mm_P0.65mm
U8, U9, U18: 74HC273PW; TSSOP-20_4.4x6.5mm_P0.65mm
U10, U17: 74HC161PW; TSSOP-16_4.4x5mm_P0.65mm
U11, U22: MC74HC244ADT; TSSOP-20_4.4x6.5mm_P0.65mm
U12, U13, U15, U16: 74HC74PW; TSSOP-14_4.4x5mm_P0.65mm
U14, U25, U33: 74HC08PW; TSSOP-14_4.4x5mm_P0.65mm
U19, U23: CD74HC280MT; SOIC-14_3.9x8.7mm_P1.27mm
U20, U21: MC74HC151ADTR2G; TSSOP-16_4.4x5mm_P0.65mm
U24: SN74LV10APW; TSSOP-14_4.4x5mm_P0.65mm
U26: 74HC04PW; TSSOP-14_4.4x5mm_P0.65mm
U28, U29, U30: SN74HC32PWR; TSSOP-14_4.4x5mm_P0.65mm

Connections:
/d0: U11.18 (1Y0), U18.13 (D4), U22.18 (1Y0); also elsewhere on the board
/d1: U11.16 (1Y1), U18.14 (D5), U22.16 (1Y1); also elsewhere on the board
/d2: U11.14 (1Y2), U18.17 (D6), U22.14 (1Y2); also elsewhere on the board
/d3: U11.12 (1Y3), U18.18 (D7), U22.12 (1Y3); also elsewhere on the board
/d4: U11.3 (2Y0), U18.3 (D0), U22.3 (2Y0); also elsewhere on the board
/d5: U11.5 (2Y1), U18.4 (D1), U22.5 (2Y1); also elsewhere on the board
/d6: U11.7 (2Y2), U18.7 (D2), U22.7 (2Y2); also elsewhere on the board
/d7: U11.9 (2Y3), U18.8 (D3), U22.9 (2Y3); also elsewhere on the board
/ps2/cnt_recv_rst: U24.12, U26.1
/ps2/common_rdy: U26.6, U29.9
/ps2/data_in: U7.4, U9.7 (D2), U12.12 (D)
/ps2/data_out: U14.4, U26.4
/ps2/data_out_ena: U14.9, U15.9 (Q)
/ps2/has_data: D3.2 (A), U12.5 (Q), U22.2 (1A0), U30.2
/ps2/ps2_clk: Q4.3 (D), R1.2, U7.11; also elsewhere on the board
/ps2/ps2_data: Q5.3 (D), R2.2, U7.1; also elsewhere on the board
/ps2/rdy_out: U26.13, U29.8
/ps2/recv_byte0: U8.3 (D0), U8.5 (Q1), U11.2 (1A0), U23.8 (A)
/ps2/recv_byte1: U8.4 (D1), U8.6 (Q2), U11.4 (1A1), U23.9 (B)
/ps2/recv_byte2: U8.7 (D2), U8.9 (Q3), U11.6 (1A2), U23.10 (C)
/ps2/recv_byte3: U8.8 (D3), U8.12 (Q4), U11.8 (1A3), U23.11 (D)
/ps2/recv_byte4: U8.13 (D4), U8.15 (Q5), U11.17 (2A0), U23.12 (E)
/ps2/recv_byte5: U8.14 (D5), U8.16 (Q6), U11.15 (2A1), U23.13 (F)
/ps2/recv_byte6: U8.17 (D6), U8.19 (Q7), U11.13 (2A2), U23.1 (G)
/ps2/recv_byte7: U8.18 (D7), U9.2 (Q0), U11.11 (2A3), U23.2 (H)
/ps2/recv_clk: U7.10, U10.2 (CP), U25.1, U29.5
/ps2/recv_clk_out: U12.6 (~Q), U25.2
/ps2/recv_cnt0: U10.14 (Q0), U24.3, U28.1
/ps2/recv_cnt1: U10.13 (Q1), U24.4, U28.2
/ps2/recv_cnt2: U10.12 (Q2), U28.12
/ps2/recv_cnt3: U10.11 (Q3), U24.5, U28.13
/ps2/recv_full_clk: U12.3 (C), U24.2, U24.6
/ps2/recv_par: U9.3 (D0), U9.5 (Q1), U23.4 (I)
/ps2/recv_reg_q10: U9.4 (D1), U9.6 (Q2)
/ps2/recv_shift_clk: U8.11 (Cp), U9.11 (Cp), U25.3
/ps2/recv_valid: U22.4 (1A1), U23.6 (Odd)
/ps2/send_ack: U12.9 (Q), U22.6 (1A2)
/ps2/send_ack_clk: U12.11 (C), U26.10
/ps2/send_clk_ena_clk: U7.8, U15.3 (C)
/ps2/send_clk_out: R4.1, U13.8 (~Q)
/ps2/send_cnt0: U17.14 (Q0), U20.11 (S0), U21.11 (S0), U24.9
/ps2/send_cnt1: U17.13 (Q1), U20.10 (S1), U21.10 (S1), U24.10
/ps2/send_cnt2: U17.12 (Q2), U20.9 (S2), U21.9 (S2)
/ps2/send_cnt3: U17.11 (Q3), U20.7 (~E), U24.11, U26.9
/ps2/send_data1: U18.12 (Q4), U19.9 (B), U20.3 (I1)
/ps2/send_data2: U18.15 (Q5), U19.10 (C), U20.2 (I2)
/ps2/send_data3: U18.16 (Q6), U19.11 (D), U20.1 (I3)
/ps2/send_data4: U18.19 (Q7), U19.12 (E), U20.15 (I4)
/ps2/send_data5: U18.2 (Q0), U19.13 (F), U20.14 (I5)
/ps2/send_data6: U18.5 (Q1), U19.1 (G), U20.13 (I6)
/ps2/send_data7: U18.6 (Q2), U19.2 (H), U20.12 (I7)
/ps2/send_data8: U18.9 (Q3), U19.4 (I), U21.4 (I0)
/ps2/send_ena: U13.3 (C), U16.9 (Q), U28.10, U30.1
/ps2/send_ena_clk: U16.11 (C), U18.11 (Cp), U29.3
/ps2/send_req: R3.1, U13.5 (Q), U13.11 (C)
/ps2/~clk_out: Q4.1 (G), U25.8
/ps2/~cnt_recv_rst: U10.1 (~MR), U26.2
/ps2/~common_rdy: U26.5, U28.8
/ps2/~data_in: U7.2, U7.3
/ps2/~data_oe: U11.1 (1OE), U11.19 (2OE), U30.11
/ps2/~data_out: Q5.1 (G), U14.8, U26.3
/ps2/~rdy: Q3.1 (G), U26.12
/ps2/~recv_rdy: U28.6, U28.9
/ps2/~recv_rst: U12.1 (~R), U25.11
/ps2/~sel: U29.10, U33.6
/ps2/~send_clk: U17.2 (CP), U29.6
/ps2/~send_clk_ena: U15.6 (~Q), U29.4
/ps2/~send_clk_out: U13.9 (Q), U30.5
/ps2/~send_clk_out_rst: U13.13 (~R), U14.6
/ps2/~send_cnt3: U21.7 (~E), U26.8
/ps2/~send_data_out: U14.10, U14.11
/ps2/~send_data_out_hi: U14.13, U21.6 (~Z)
/ps2/~send_data_out_lo: U14.12, U20.6 (~Z)
/ps2/~send_ena: U16.8 (~Q), U24.1, U30.4
/ps2/~send_ovf: U24.8, U25.5, U26.11
/ps2/~send_req: U13.6 (~Q), U15.11 (C)
/ps2/~send_req_rst: U13.1 (~R), U14.3
/ps2/~send_rst: U15.1 (~R), U15.13 (~R), U16.13 (~R), U17.1 (~MR), U25.6
/ps2/~status_oe: U22.1 (1OE), U22.19 (2OE), U29.11
/ps2/~status_we: U25.12, U30.8
/~oe: U29.12, U30.13; also elsewhere on the board
/~ps2_data_sel: U29.2, U30.12, U33.4; also elsewhere on the board
/~ps2_status_sel: U29.13, U30.10, U33.5; also elsewhere on the board
/~we: U29.1, U30.9; also elsewhere on the board
GND: C1.2, C2.2, C3.2, C4.2, C5.2, C6.2, C7.2, C8.2, C9.2, C10.2, C11.2, C12.2, C13.2, C14.2, C15.2, C16.2, C17.2, C18.2, C19.2, C20.2, C21.2, C22.2, C23.2, C24.2, C26.2, Q3.2 (S), Q4.2 (S), Q5.2 (S), R20.1, U7.7 (GND), U8.10 (GND), U9.10 (GND), U10.8 (GND), U11.10 (GND), U12.7 (GND), U13.7 (GND), U14.7 (GND), U15.7 (GND), U16.7 (GND), U17.8 (GND), U18.10 (GND), U19.7 (GND), U19.8 (A), U20.4 (I0), U20.8 (GND), U21.8 (GND), U22.8 (1A3), U22.10 (GND), U22.11 (2A3), U22.13 (2A2), U22.15 (2A1), U22.17 (2A0), U23.7 (GND), U24.7 (GND), U25.7 (GND), U26.7 (GND), U28.7 (GND), U29.7 (GND), U30.7 (GND); also elsewhere on the board
unnamed: C1.1, R3.2, U7.5
unnamed: C2.1, R4.2, U7.9
unnamed: D3.1 (K), R20.2
unnamed: U7.6, U14.1
unnamed: U19.5 (Even), U21.3 (I1)
unnamed: U25.9, U30.3
unnamed: U25.10, U30.6
unnamed: U28.3, U28.4
unnamed: U28.5, U28.11
VCC: C3.1, C4.1, C5.1, C6.1, C7.1, C8.1, C9.1, C10.1, C11.1, C12.1, C13.1, C14.1, C15.1, C16.1, C17.1, C18.1, C19.1, C20.1, C21.1, C22.1, C23.1, C24.1, C26.1, R1.1, R2.1, U7.13, U7.14 (VCC), U8.20 (VCC), U9.8 (D3), U9.13 (D4), U9.14 (D5), U9.17 (D6), U9.18 (D7), U9.20 (VCC), U10.3 (D0), U10.4 (D1), U10.5 (D2), U10.6 (D3), U10.7 (CEP), U10.9 (~PE), U10.10 (CET), U10.16 (VCC), U11.20 (VCC), U12.2 (D), U12.4 (~S), U12.13 (~R), U12.14 (VCC), U13.2 (D), U13.4 (~S), U13.10 (~S), U13.12 (D), U13.14 (VCC), U14.14 (VCC), U15.2 (D), U15.4 (~S), U15.10 (~S), U15.12 (D), U15.14 (VCC), U16.1 (~R), U16.2 (D), U16.3 (C), U16.4 (~S), U16.10 (~S), U16.12 (D), U16.14 (VCC), U17.3 (D0), U17.4 (D1), U17.5 (D2), U17.6 (D3), U17.7 (CEP), U17.9 (~PE), U17.10 (CET), U17.16 (VCC), U18.20 (VCC), U19.14 (VCC), U20.16 (VCC), U21.1 (I3), U21.2 (I2), U21.12 (I7), U21.13 (I6), U21.14 (I5), U21.15 (I4), U21.16 (VCC), U22.20 (VCC), U23.14 (VCC), U24.14 (VCC), U25.14 (VCC), U26.14 (VCC), U28.14 (VCC), U29.14 (VCC), U30.14 (VCC); also elsewhere on the board
rdy: Q3.3 (D); also elsewhere on the board
~rst: U8.1 (~Mr), U9.1 (~Mr), U12.10 (~S), U14.2, U14.5, U18.1 (~Mr), U24.13, U25.4, U25.13; also elsewhere on the board

Notes on the sheet:
≥100 µS delay
>100 nS delay

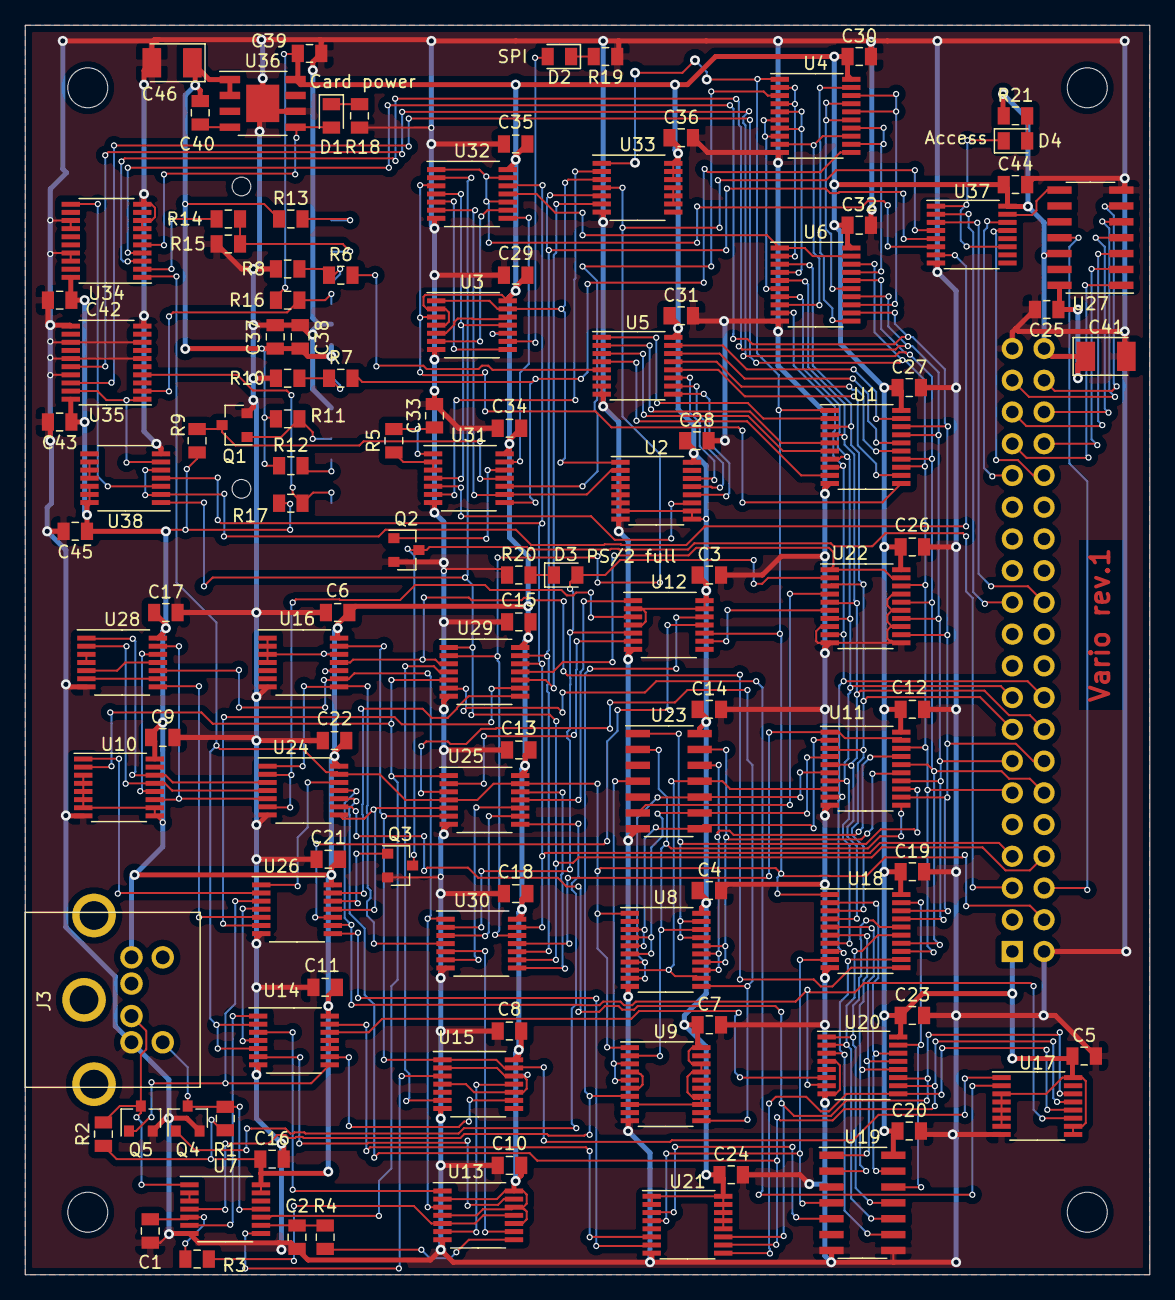
[picture p34: board vario.kicad_pcb from above]

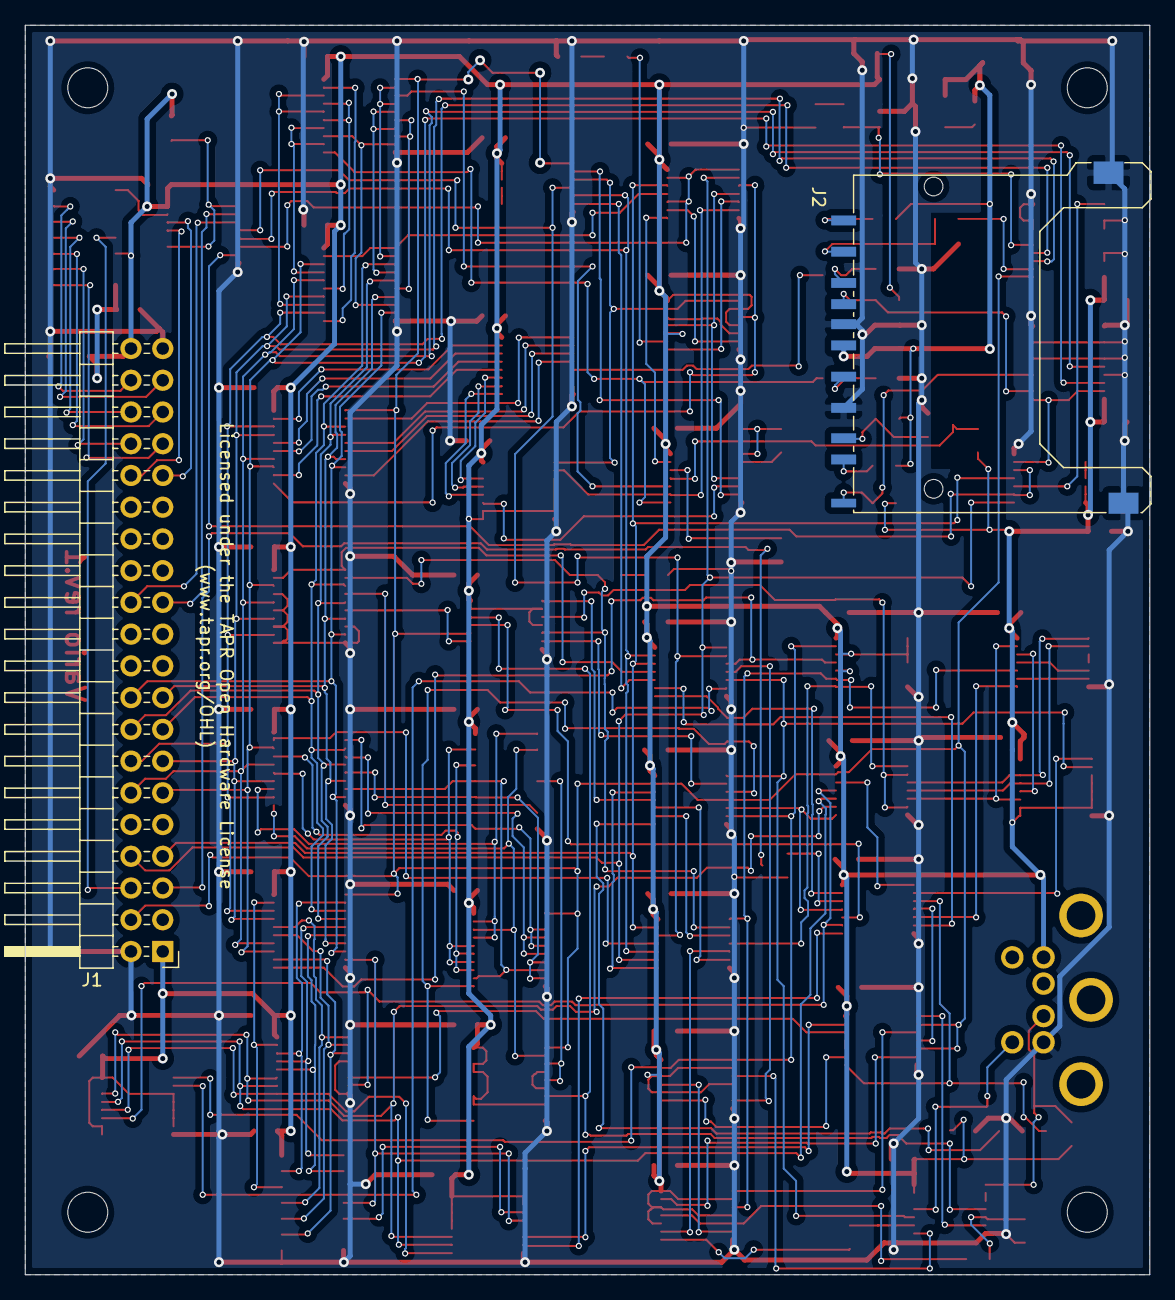
[picture p35: board vario.kicad_pcb from below]

Board: 2 copper layers, 90.0 x 100.0 mm, 121 parts (2 on the bottom side), 169 nets.
