imihajlow/ccpu/boards/registers/registers.kicad_pcb

## KiCad design boards/registers/registers.kicad_pcb (2021-01-25)

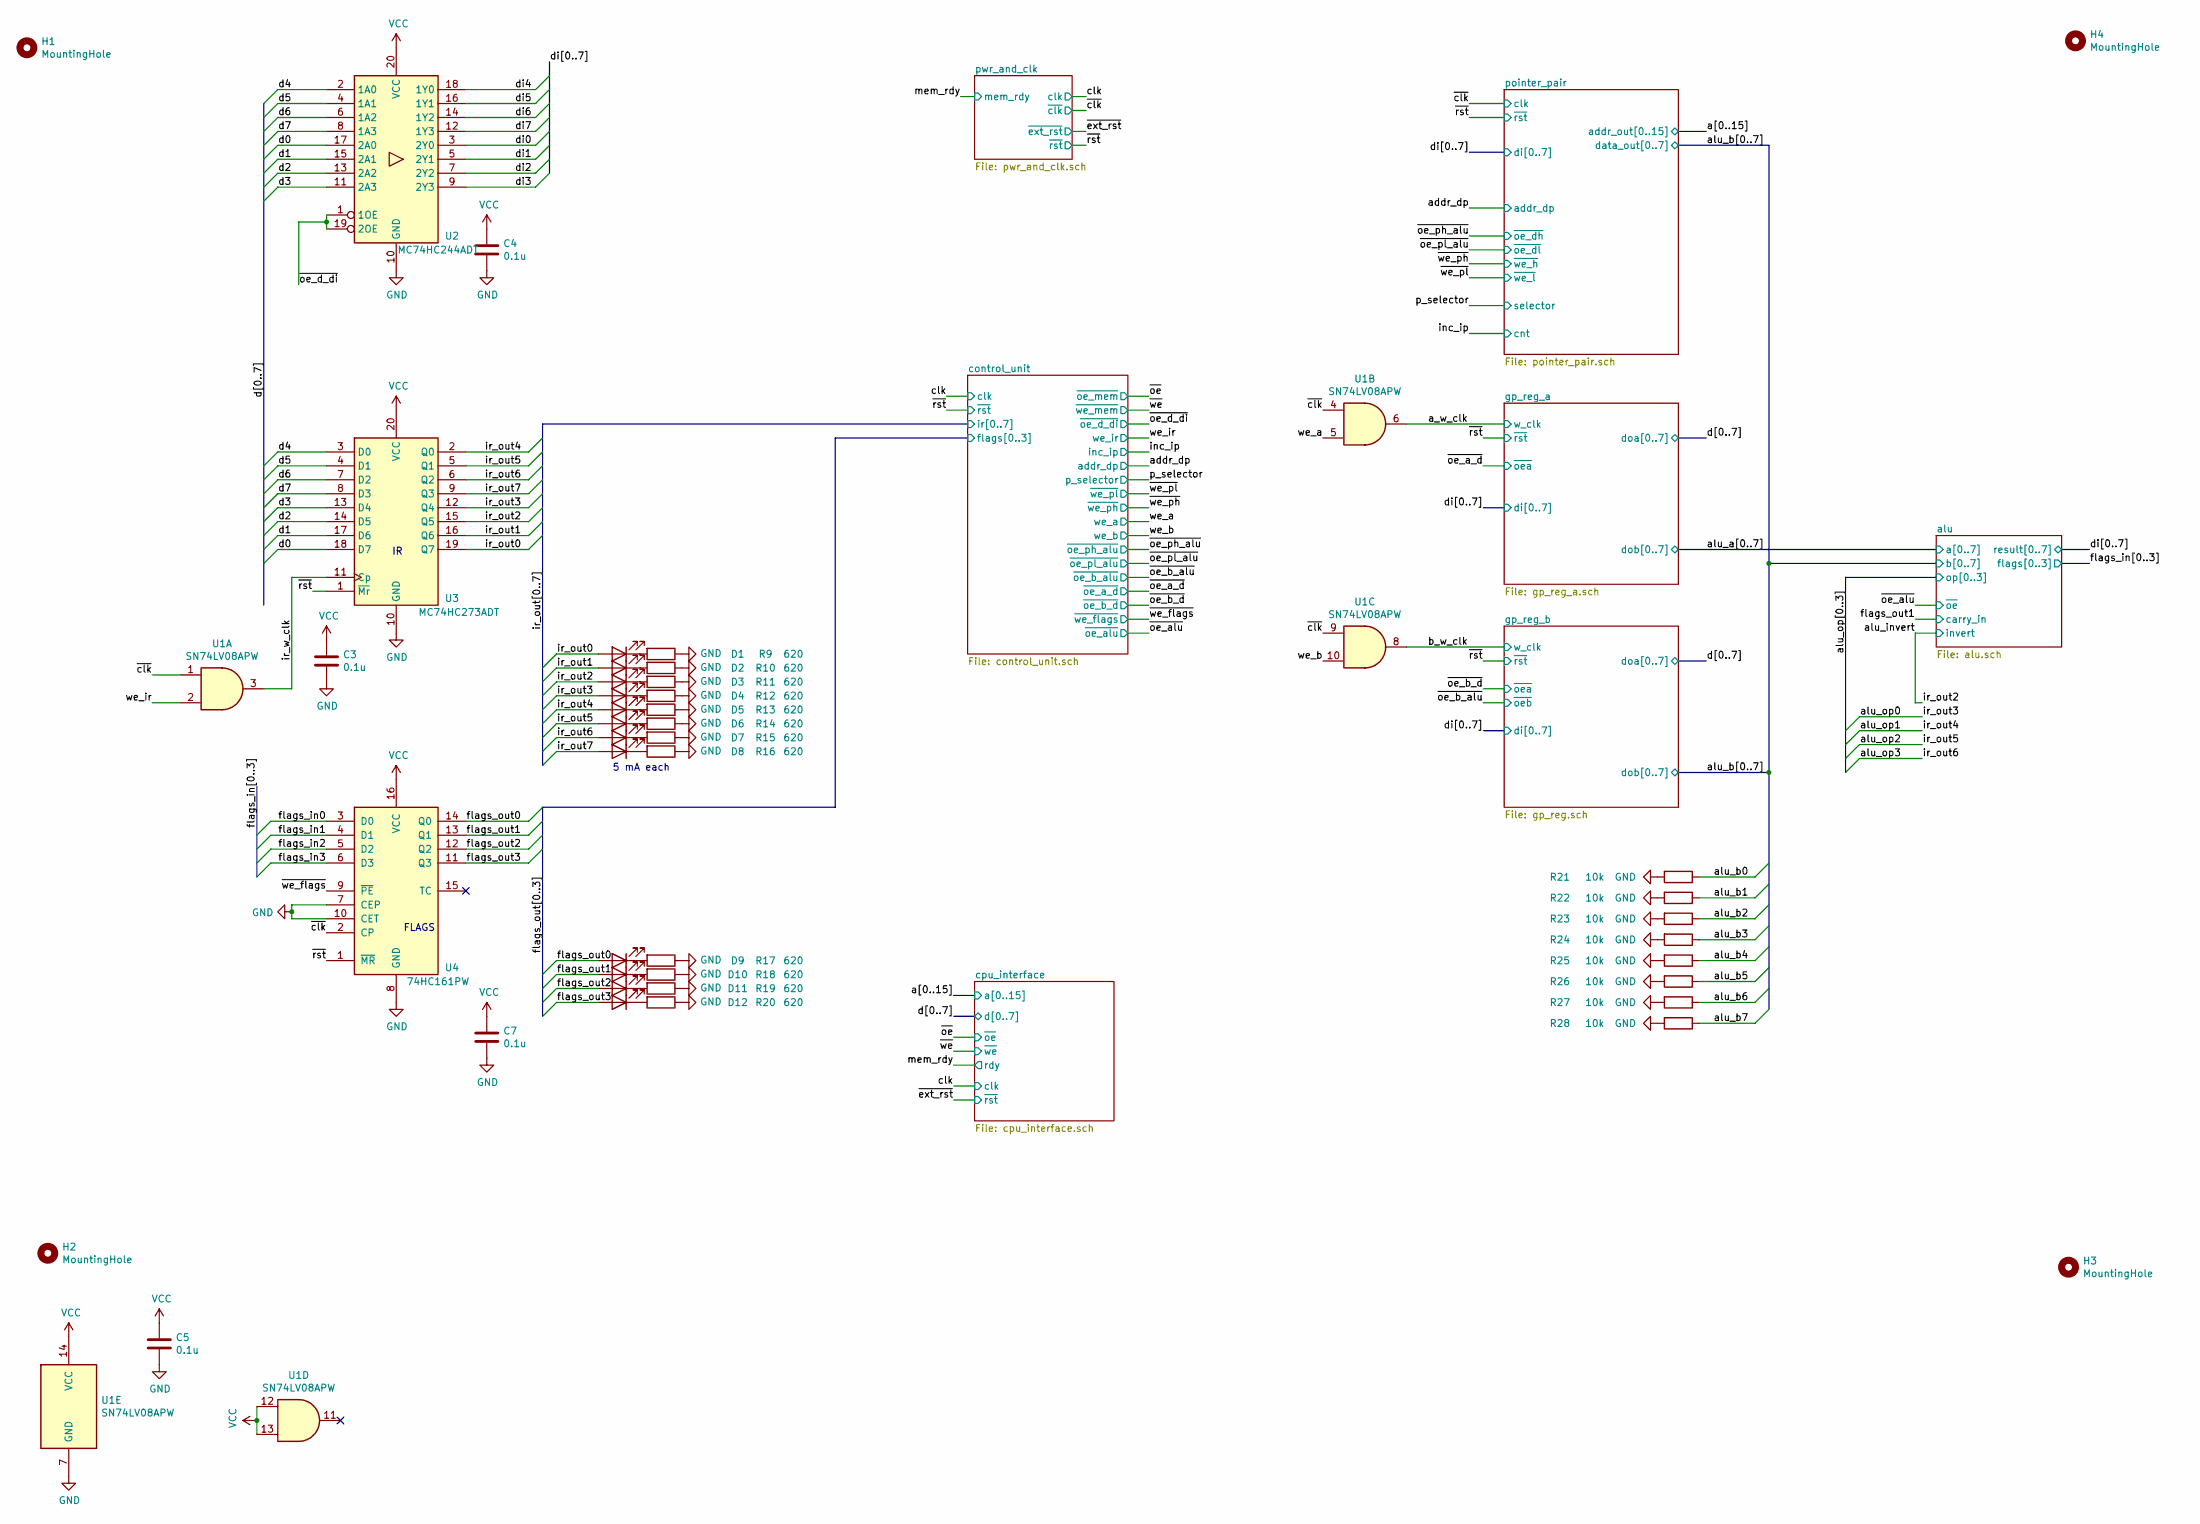
[picture p36: schematic registers.sch, CPU registers and memory module]

Parts:
C3, C4, C5, C7: 0.1u; C_0805_2012Metric
D1, D2, D3, D4, D5, D6, D7, D8, D9, D10, D11, D12: KP-2012EC; LED_0805_2012Metric
H1, H2, H3, H4: MountingHole; MountingHole_3.2mm_M3_DIN965
R9, R10, R11, R12, R13, R14, R15, R16, R17, R18, R19, R20: 620; R_0805_2012Metric
R21, R22, R23, R24, R25, R26, R27, R28: 10k; R_0805_2012Metric
U1: SN74LV08APW; TSSOP-14_4.4x5mm_P0.65mm
U2: MC74HC244ADT; TSSOP-20_4.4x6.5mm_P0.65mm
U3: MC74HC273ADT; TSSOP-20_4.4x6.5mm_P0.65mm
U4: 74HC161PW; TSSOP-16_4.4x5mm_P0.65mm

Connections:
/a_w_clk: U1.6; also elsewhere on the board
/alu_b0: R21.1; also elsewhere on the board
/alu_b1: R22.1; also elsewhere on the board
/alu_b2: R23.1; also elsewhere on the board
/alu_b3: R24.1; also elsewhere on the board
/alu_b4: R25.1; also elsewhere on the board
/alu_b5: R26.1; also elsewhere on the board
/alu_b6: R27.1; also elsewhere on the board
/alu_b7: R28.1; also elsewhere on the board
/alu_invert: D3.2 (A), U3.15 (Q5); also elsewhere on the board
/alu_op0: D4.2 (A), U3.12 (Q4); also elsewhere on the board
/alu_op1: D5.2 (A), U3.2 (Q0); also elsewhere on the board
/alu_op2: D6.2 (A), U3.5 (Q1); also elsewhere on the board
/alu_op3: D7.2 (A), U3.6 (Q2); also elsewhere on the board
/b_w_clk: U1.8; also elsewhere on the board
/d0: U2.17 (2A0), U3.18 (D7); also elsewhere on the board
/d1: U2.15 (2A1), U3.17 (D6); also elsewhere on the board
/d2: U2.13 (2A2), U3.14 (D5); also elsewhere on the board
/d3: U2.11 (2A3), U3.13 (D4); also elsewhere on the board
/d4: U2.2 (1A0), U3.3 (D0); also elsewhere on the board
/d5: U2.4 (1A1), U3.4 (D1); also elsewhere on the board
/d6: U2.6 (1A2), U3.7 (D2); also elsewhere on the board
/d7: U2.8 (1A3), U3.8 (D3); also elsewhere on the board
/di0: U2.3 (2Y0); also elsewhere on the board
/di1: U2.5 (2Y1); also elsewhere on the board
/di2: U2.7 (2Y2); also elsewhere on the board
/di3: U2.9 (2Y3); also elsewhere on the board
/di4: U2.18 (1Y0); also elsewhere on the board
/di5: U2.16 (1Y1); also elsewhere on the board
/di6: U2.14 (1Y2); also elsewhere on the board
/di7: U2.12 (1Y3); also elsewhere on the board
/flags_in0: U4.3 (D0); also elsewhere on the board
/flags_in1: U4.4 (D1); also elsewhere on the board
/flags_in2: U4.5 (D2); also elsewhere on the board
/flags_in3: U4.6 (D3); also elsewhere on the board
/flags_out0: D9.2 (A), U4.14 (Q0); also elsewhere on the board
/flags_out1: D10.2 (A), U4.13 (Q1); also elsewhere on the board
/flags_out2: D11.2 (A), U4.12 (Q2); also elsewhere on the board
/flags_out3: D12.2 (A), U4.11 (Q3); also elsewhere on the board
/ir_out0: D1.2 (A), U3.19 (Q7); also elsewhere on the board
/ir_out1: D2.2 (A), U3.16 (Q6); also elsewhere on the board
/ir_out7: D8.2 (A), U3.9 (Q3); also elsewhere on the board
/ir_w_clk: U1.3, U3.11 (Cp)
/we_a: U1.5; also elsewhere on the board
/we_b: U1.10; also elsewhere on the board
/we_ir: U1.2; also elsewhere on the board
/~clk: U1.1, U1.4, U1.9, U4.2 (CP); also elsewhere on the board
/~oe_d_di: U2.1 (1OE), U2.19 (2OE); also elsewhere on the board
/~rst: U3.1 (~Mr), U4.1 (~MR); also elsewhere on the board
/~we_flags: U4.9 (~PE); also elsewhere on the board
GND: C3.2, C4.2, C5.2, C7.2, R9.1, R10.1, R11.1, R12.1, R13.1, R14.1, R15.1, R16.1, R17.1, R18.1, R19.1, R20.1, R21.2, R22.2, R23.2, R24.2, R25.2, R26.2, R27.2, R28.2, U1.7 (GND), U2.10 (GND), U3.10 (GND), U4.7 (CEP), U4.8 (GND), U4.10 (CET); also elsewhere on the board
unnamed: D1.1 (K), R9.2
unnamed: D2.1 (K), R10.2
unnamed: D3.1 (K), R11.2
unnamed: D4.1 (K), R12.2
unnamed: D5.1 (K), R13.2
unnamed: D6.1 (K), R14.2
unnamed: D7.1 (K), R15.2
unnamed: D8.1 (K), R16.2
unnamed: D9.1 (K), R17.2
unnamed: D10.1 (K), R18.2
unnamed: D11.1 (K), R19.2
unnamed: D12.1 (K), R20.2
VCC: C3.1, C4.1, C5.1, C7.1, U1.12, U1.13, U1.14 (VCC), U2.20 (VCC), U3.20 (VCC), U4.16 (VCC); also elsewhere on the board

Notes on the sheet:
5 mA each
FLAGS

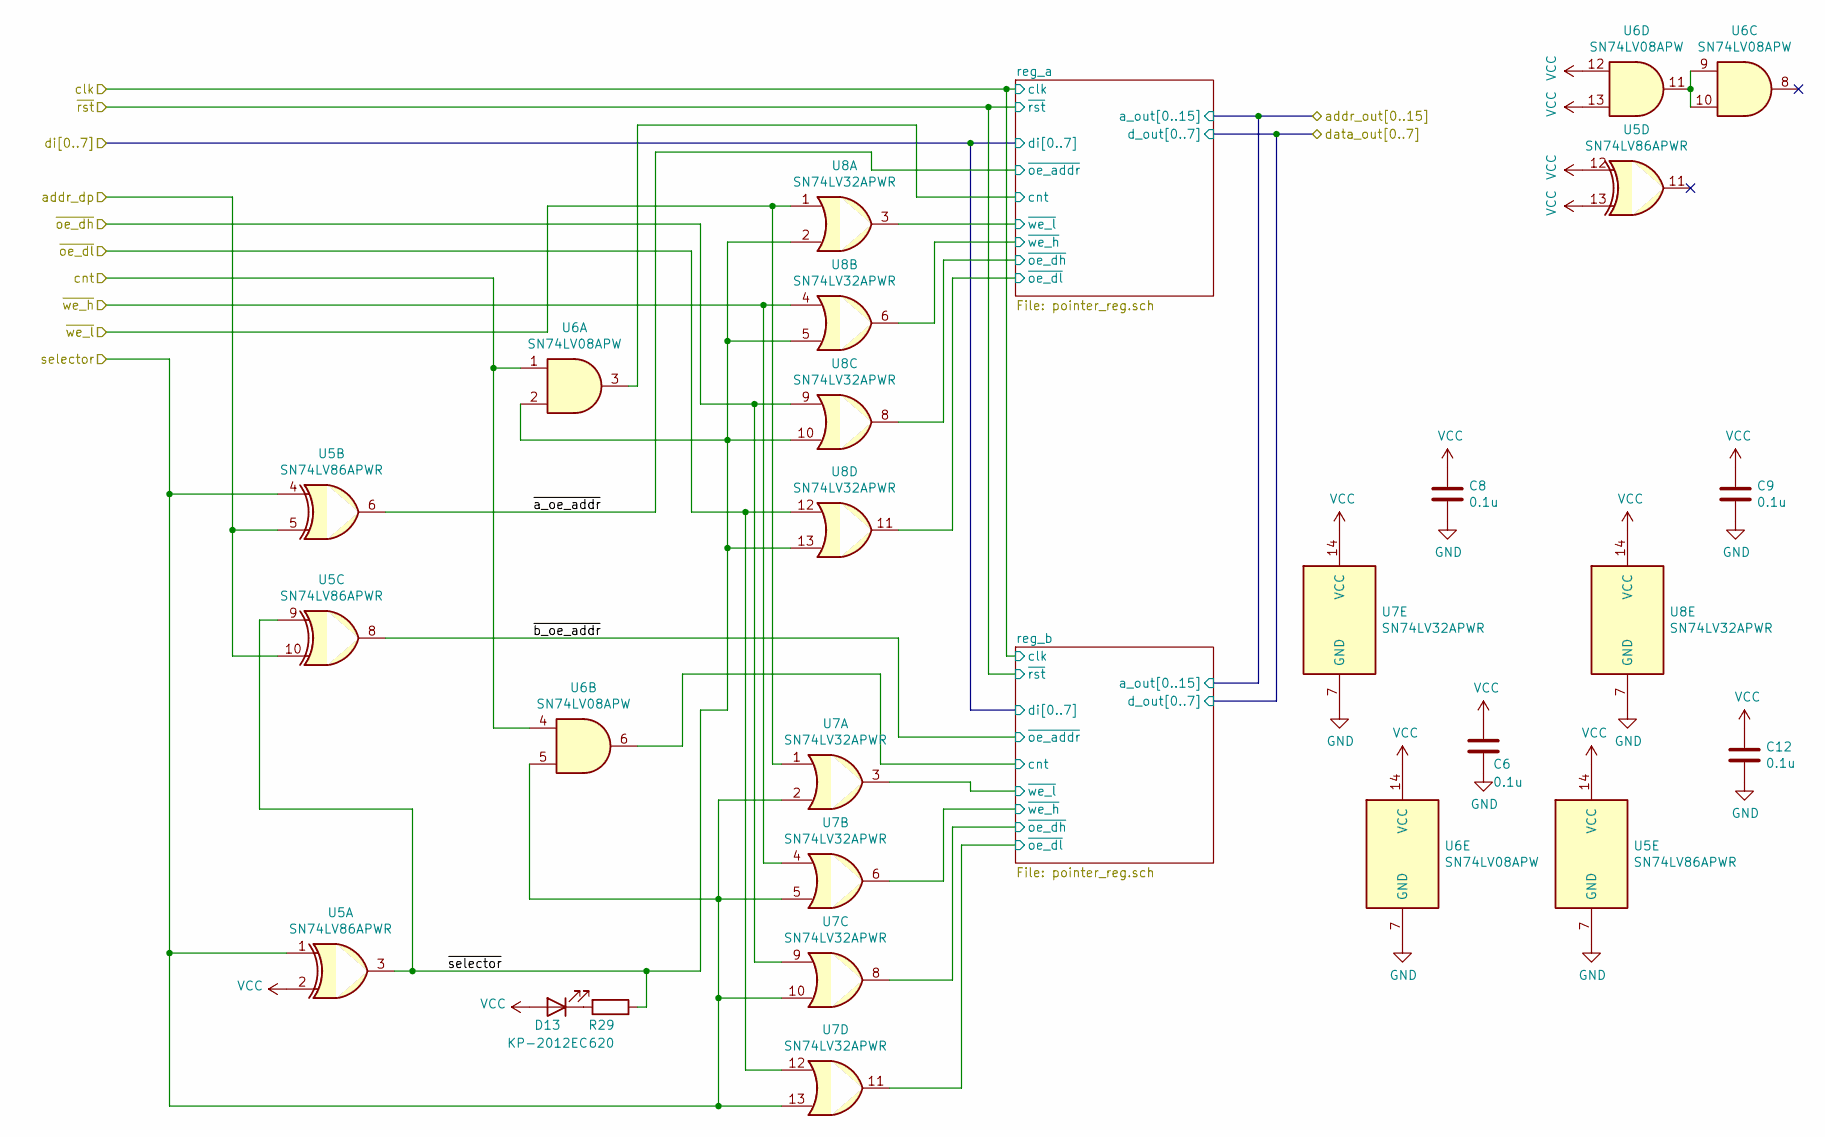
[picture p37: schematic pointer_pair.sch, Pointer pair]

Parts:
C6, C8, C9, C12: 0.1u; C_0805_2012Metric
D13: KP-2012EC; LED_0805_2012Metric
R29: 620; R_0805_2012Metric
U5: SN74LV86APWR; TSSOP-14_4.4x5mm_P0.65mm
U6: SN74LV08APW; TSSOP-14_4.4x5mm_P0.65mm
U7, U8: SN74LV32APWR; TSSOP-14_4.4x5mm_P0.65mm

Connections:
/addr_dp: U5.5, U5.10; also elsewhere on the board
/inc_ip: U6.1, U6.4; also elsewhere on the board
/p_selector: U5.1, U5.4, U6.5, U7.2, U7.5, U7.10, U7.13; also elsewhere on the board
/pointer_pair/reg_a/cnt: U6.3; also elsewhere on the board
/pointer_pair/reg_a/~oe_dh: U8.8; also elsewhere on the board
/pointer_pair/reg_a/~oe_dl: U8.11; also elsewhere on the board
/pointer_pair/reg_a/~we_h: U8.6; also elsewhere on the board
/pointer_pair/reg_a/~we_l: U8.3; also elsewhere on the board
/pointer_pair/reg_b/cnt: U6.6; also elsewhere on the board
/pointer_pair/reg_b/~oe_dh: U7.8; also elsewhere on the board
/pointer_pair/reg_b/~oe_dl: U7.11; also elsewhere on the board
/pointer_pair/reg_b/~we_h: U7.6; also elsewhere on the board
/pointer_pair/reg_b/~we_l: U7.3; also elsewhere on the board
/pointer_pair/~a_oe_addr: U5.6; also elsewhere on the board
/pointer_pair/~b_oe_addr: U5.8; also elsewhere on the board
/pointer_pair/~selector: R29.1, U5.3, U5.9, U6.2, U8.2, U8.5, U8.10, U8.13
/~oe_ph_alu: U7.9, U8.9; also elsewhere on the board
/~oe_pl_alu: U7.12, U8.12; also elsewhere on the board
/~we_ph: U7.4, U8.4; also elsewhere on the board
/~we_pl: U7.1, U8.1; also elsewhere on the board
GND: C6.2, C8.2, C9.2, C12.2, U5.7 (GND), U6.7 (GND), U7.7 (GND), U8.7 (GND); also elsewhere on the board
unnamed: D13.1 (K), R29.2
unnamed: U6.9, U6.10, U6.11
VCC: C6.1, C8.1, C9.1, C12.1, D13.2 (A), U5.2, U5.12, U5.13, U5.14 (VCC), U6.12, U6.13, U6.14 (VCC), U7.14 (VCC), U8.14 (VCC); also elsewhere on the board
