imihajlow/ccpu/boards/registers/registers.kicad_pcb

## KiCad design boards/registers/registers.kicad_pcb (continued)

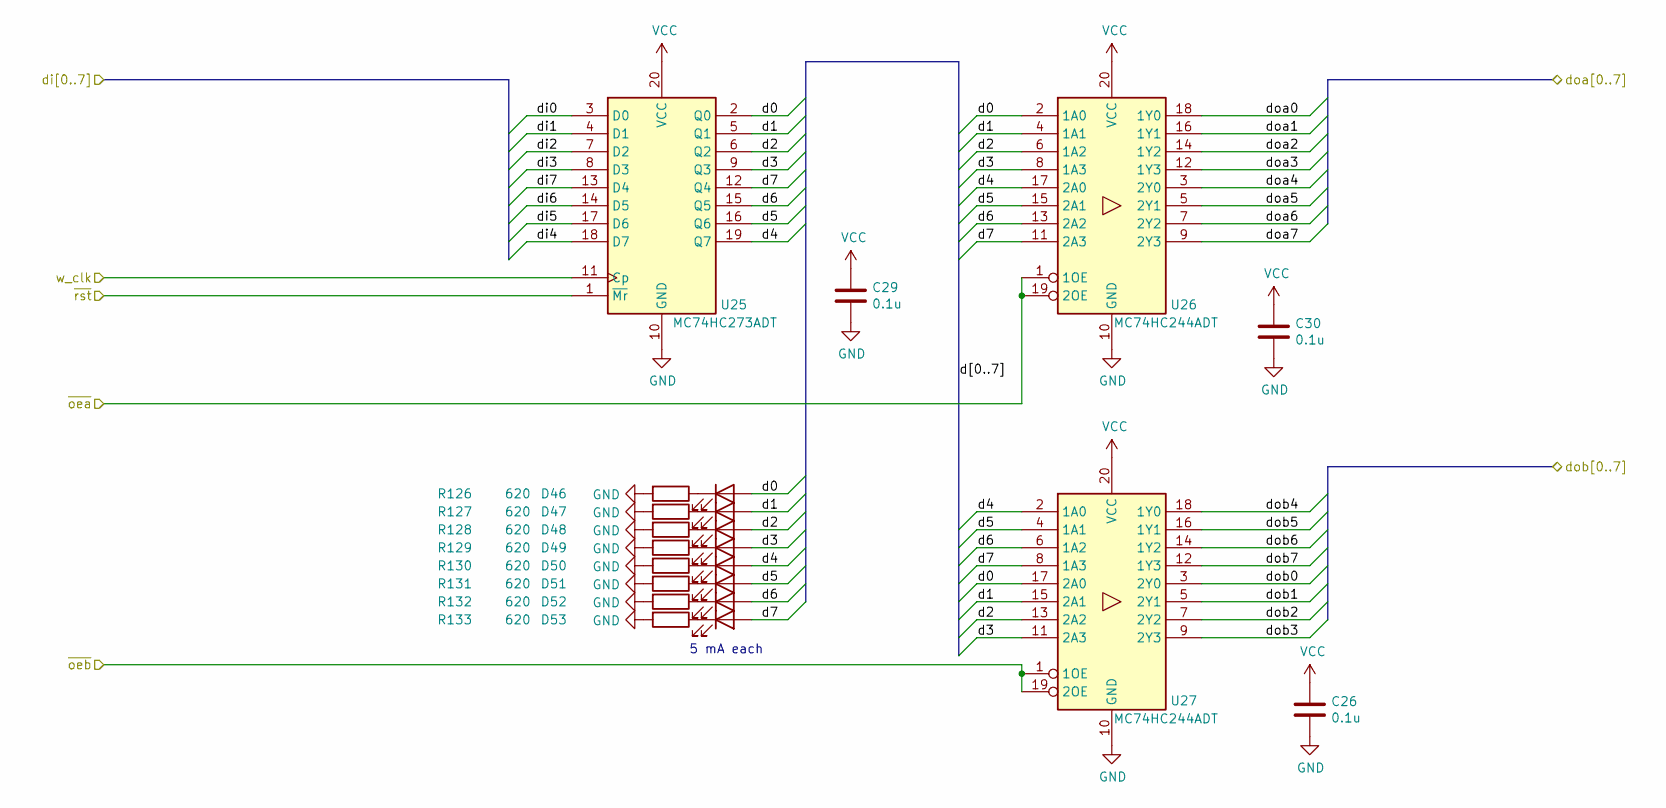
[picture p38: schematic gp_reg.sch, General-purpose register]

Parts:
C26, C29, C30: 0.1u; C_0805_2012Metric
D46, D47, D48, D49, D50, D51, D52, D53: KP-2012EC; LED_0805_2012Metric
R126, R127, R128, R129, R130, R131, R132, R133: 620; R_0805_2012Metric
U25: MC74HC273ADT; TSSOP-20_4.4x6.5mm_P0.65mm
U26, U27: MC74HC244ADT; TSSOP-20_4.4x6.5mm_P0.65mm

Connections:
/alu_b0: U27.3 (2Y0); also elsewhere on the board
/alu_b1: U27.5 (2Y1); also elsewhere on the board
/alu_b2: U27.7 (2Y2); also elsewhere on the board
/alu_b3: U27.9 (2Y3); also elsewhere on the board
/alu_b4: U27.18 (1Y0); also elsewhere on the board
/alu_b5: U27.16 (1Y1); also elsewhere on the board
/alu_b6: U27.14 (1Y2); also elsewhere on the board
/alu_b7: U27.12 (1Y3); also elsewhere on the board
/b_w_clk: U25.11 (Cp); also elsewhere on the board
/d0: U26.18 (1Y0); also elsewhere on the board
/d1: U26.16 (1Y1); also elsewhere on the board
/d2: U26.14 (1Y2); also elsewhere on the board
/d3: U26.12 (1Y3); also elsewhere on the board
/d4: U26.3 (2Y0); also elsewhere on the board
/d5: U26.5 (2Y1); also elsewhere on the board
/d6: U26.7 (2Y2); also elsewhere on the board
/d7: U26.9 (2Y3); also elsewhere on the board
/di0: U25.3 (D0); also elsewhere on the board
/di1: U25.4 (D1); also elsewhere on the board
/di2: U25.7 (D2); also elsewhere on the board
/di3: U25.8 (D3); also elsewhere on the board
/di4: U25.18 (D7); also elsewhere on the board
/di5: U25.17 (D6); also elsewhere on the board
/di6: U25.14 (D5); also elsewhere on the board
/di7: U25.13 (D4); also elsewhere on the board
/gp_reg_b/d0: D46.2 (A), U25.2 (Q0), U26.2 (1A0), U27.17 (2A0)
/gp_reg_b/d1: D47.2 (A), U25.5 (Q1), U26.4 (1A1), U27.15 (2A1)
/gp_reg_b/d2: D48.2 (A), U25.6 (Q2), U26.6 (1A2), U27.13 (2A2)
/gp_reg_b/d3: D49.2 (A), U25.9 (Q3), U26.8 (1A3), U27.11 (2A3)
/gp_reg_b/d4: D50.2 (A), U25.19 (Q7), U26.17 (2A0), U27.2 (1A0)
/gp_reg_b/d5: D51.2 (A), U25.16 (Q6), U26.15 (2A1), U27.4 (1A1)
/gp_reg_b/d6: D52.2 (A), U25.15 (Q5), U26.13 (2A2), U27.6 (1A2)
/gp_reg_b/d7: D53.2 (A), U25.12 (Q4), U26.11 (2A3), U27.8 (1A3)
/~oe_b_alu: U27.1 (1OE), U27.19 (2OE); also elsewhere on the board
/~oe_b_d: U26.1 (1OE), U26.19 (2OE); also elsewhere on the board
/~rst: U25.1 (~Mr); also elsewhere on the board
GND: C26.2, C29.2, C30.2, R126.2, R127.2, R128.2, R129.2, R130.2, R131.2, R132.2, R133.2, U25.10 (GND), U26.10 (GND), U27.10 (GND); also elsewhere on the board
unnamed: D46.1 (K), R126.1
unnamed: D47.1 (K), R127.1
unnamed: D48.1 (K), R128.1
unnamed: D49.1 (K), R129.1
unnamed: D50.1 (K), R130.1
unnamed: D51.1 (K), R131.1
unnamed: D52.1 (K), R132.1
unnamed: D53.1 (K), R133.1
VCC: C26.1, C29.1, C30.1, U25.20 (VCC), U26.20 (VCC), U27.20 (VCC); also elsewhere on the board

Notes on the sheet:
5 mA each

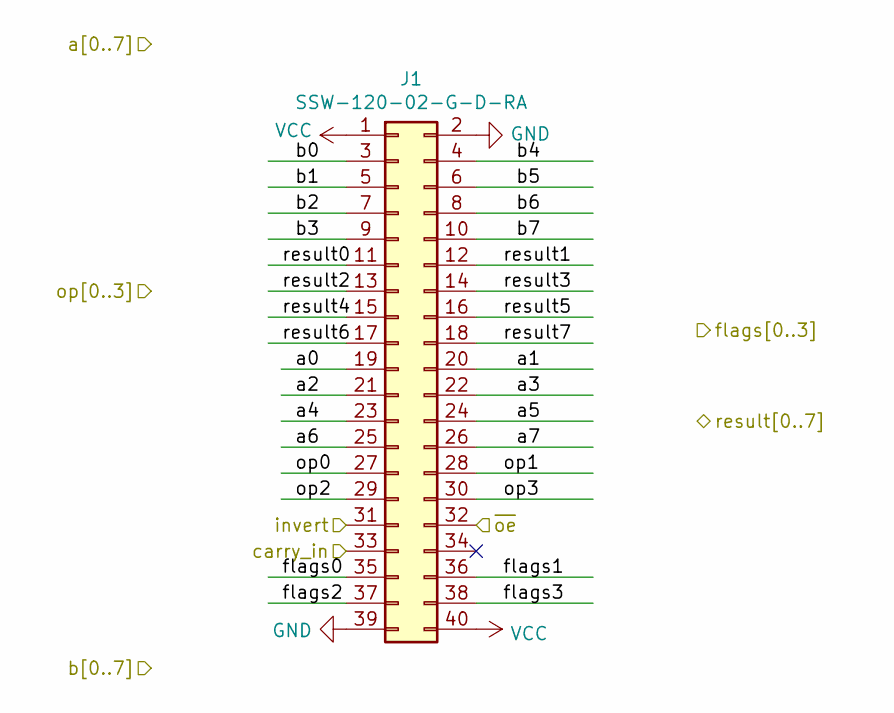
[picture p39: schematic alu.sch, ALU connector]

Parts:
J1: SSW-120-02-G-D-RA; PinSocket_2x20_P2.54mm_Horizontal

Connections:
/alu/a0: J1.19; also elsewhere on the board
/alu/a1: J1.20; also elsewhere on the board
/alu/a2: J1.21; also elsewhere on the board
/alu/a3: J1.22; also elsewhere on the board
/alu/a4: J1.23; also elsewhere on the board
/alu/a5: J1.24; also elsewhere on the board
/alu/a6: J1.25; also elsewhere on the board
/alu/a7: J1.26; also elsewhere on the board
/alu_b0: J1.3; also elsewhere on the board
/alu_b1: J1.5; also elsewhere on the board
/alu_b2: J1.7; also elsewhere on the board
/alu_b3: J1.9; also elsewhere on the board
/alu_b4: J1.4; also elsewhere on the board
/alu_b5: J1.6; also elsewhere on the board
/alu_b6: J1.8; also elsewhere on the board
/alu_b7: J1.10; also elsewhere on the board
/alu_invert: J1.31; also elsewhere on the board
/alu_op0: J1.27; also elsewhere on the board
/alu_op1: J1.28; also elsewhere on the board
/alu_op2: J1.29; also elsewhere on the board
/alu_op3: J1.30; also elsewhere on the board
/di0: J1.11; also elsewhere on the board
/di1: J1.12; also elsewhere on the board
/di2: J1.13; also elsewhere on the board
/di3: J1.14; also elsewhere on the board
/di4: J1.15; also elsewhere on the board
/di5: J1.16; also elsewhere on the board
/di6: J1.17; also elsewhere on the board
/di7: J1.18; also elsewhere on the board
/flags_in0: J1.35; also elsewhere on the board
/flags_in1: J1.36; also elsewhere on the board
/flags_in2: J1.37; also elsewhere on the board
/flags_in3: J1.38; also elsewhere on the board
/flags_out1: J1.33; also elsewhere on the board
/~oe_alu: J1.32; also elsewhere on the board
GND: J1.2, J1.39; also elsewhere on the board
VCC: J1.1, J1.40; also elsewhere on the board

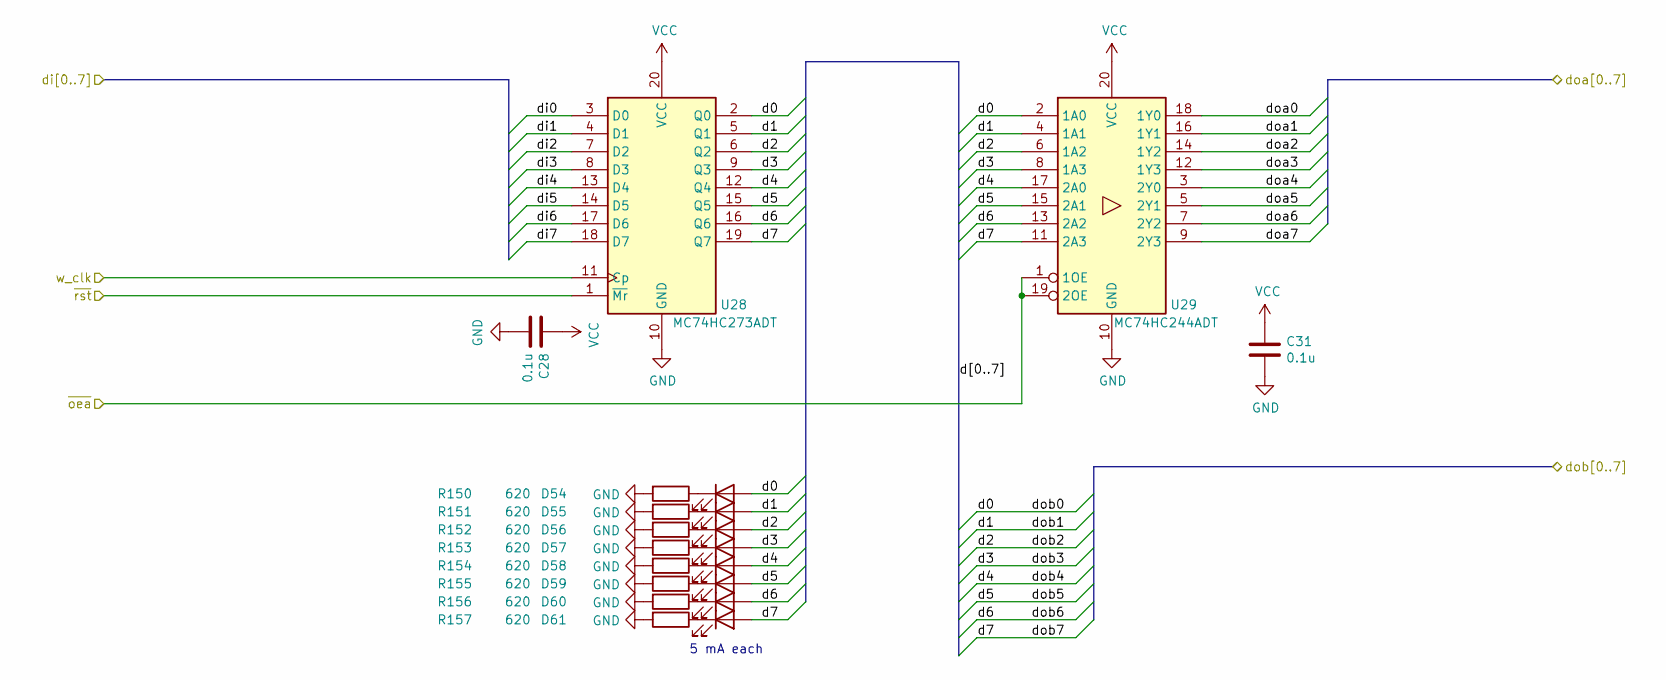
[picture p40: schematic gp_reg_a.sch]

Parts:
C28, C31: 0.1u; C_0805_2012Metric
D54, D55, D56, D57, D58, D59, D60, D61: KP-2012EC; LED_0805_2012Metric
R150, R151, R152, R153, R154, R155, R156, R157: 620; R_0805_2012Metric
U28: MC74HC273ADT; TSSOP-20_4.4x6.5mm_P0.65mm
U29: MC74HC244ADT; TSSOP-20_4.4x6.5mm_P0.65mm

Connections:
/a_w_clk: U28.11 (Cp); also elsewhere on the board
/alu/a0: D54.2 (A), U28.2 (Q0), U29.2 (1A0); also elsewhere on the board
/alu/a1: D55.2 (A), U28.5 (Q1), U29.4 (1A1); also elsewhere on the board
/alu/a2: D56.2 (A), U28.6 (Q2), U29.6 (1A2); also elsewhere on the board
/alu/a3: D57.2 (A), U28.9 (Q3), U29.8 (1A3); also elsewhere on the board
/alu/a4: D58.2 (A), U28.12 (Q4), U29.17 (2A0); also elsewhere on the board
/alu/a5: D59.2 (A), U28.15 (Q5), U29.15 (2A1); also elsewhere on the board
/alu/a6: D60.2 (A), U28.16 (Q6), U29.13 (2A2); also elsewhere on the board
/alu/a7: D61.2 (A), U28.19 (Q7), U29.11 (2A3); also elsewhere on the board
/d0: U29.18 (1Y0); also elsewhere on the board
/d1: U29.16 (1Y1); also elsewhere on the board
/d2: U29.14 (1Y2); also elsewhere on the board
/d3: U29.12 (1Y3); also elsewhere on the board
/d4: U29.3 (2Y0); also elsewhere on the board
/d5: U29.5 (2Y1); also elsewhere on the board
/d6: U29.7 (2Y2); also elsewhere on the board
/d7: U29.9 (2Y3); also elsewhere on the board
/di0: U28.3 (D0); also elsewhere on the board
/di1: U28.4 (D1); also elsewhere on the board
/di2: U28.7 (D2); also elsewhere on the board
/di3: U28.8 (D3); also elsewhere on the board
/di4: U28.13 (D4); also elsewhere on the board
/di5: U28.14 (D5); also elsewhere on the board
/di6: U28.17 (D6); also elsewhere on the board
/di7: U28.18 (D7); also elsewhere on the board
/~oe_a_d: U29.1 (1OE), U29.19 (2OE); also elsewhere on the board
/~rst: U28.1 (~Mr); also elsewhere on the board
GND: C28.2, C31.2, R150.2, R151.2, R152.2, R153.2, R154.2, R155.2, R156.2, R157.2, U28.10 (GND), U29.10 (GND); also elsewhere on the board
unnamed: D54.1 (K), R150.1
unnamed: D55.1 (K), R151.1
unnamed: D56.1 (K), R152.1
unnamed: D57.1 (K), R153.1
unnamed: D58.1 (K), R154.1
unnamed: D59.1 (K), R155.1
unnamed: D60.1 (K), R156.1
unnamed: D61.1 (K), R157.1
VCC: C28.1, C31.1, U28.20 (VCC), U29.20 (VCC); also elsewhere on the board

Notes on the sheet:
5 mA each

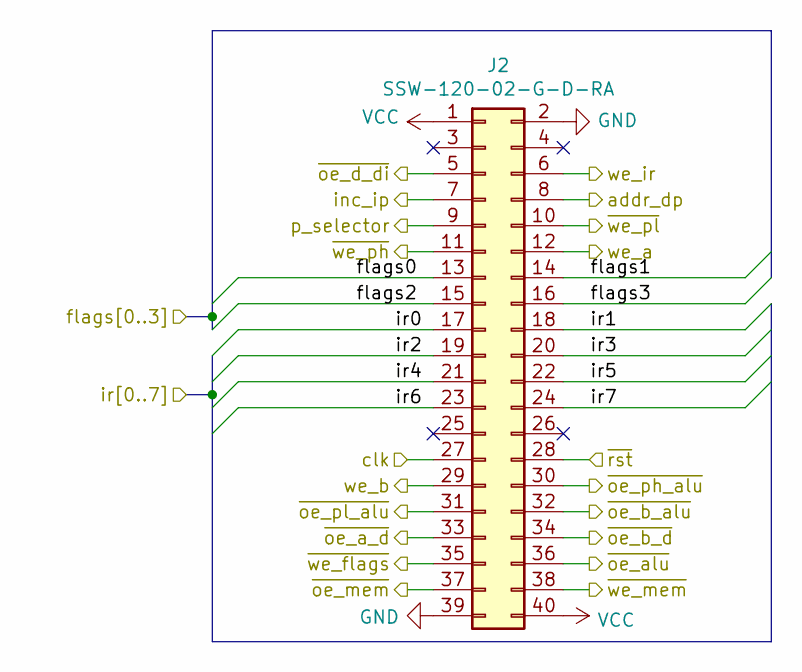
[picture p41: schematic control_unit.sch, Control unit connector]

Parts:
J2: SSW-120-02-G-D-RA; PinSocket_2x20_P2.54mm_Horizontal

Connections:
/addr_dp: J2.8; also elsewhere on the board
/alu_invert: J2.19; also elsewhere on the board
/alu_op0: J2.20; also elsewhere on the board
/alu_op1: J2.21; also elsewhere on the board
/alu_op2: J2.22; also elsewhere on the board
/alu_op3: J2.23; also elsewhere on the board
/clk: J2.27; also elsewhere on the board
/flags_out0: J2.13; also elsewhere on the board
/flags_out1: J2.14; also elsewhere on the board
/flags_out2: J2.15; also elsewhere on the board
/flags_out3: J2.16; also elsewhere on the board
/inc_ip: J2.7; also elsewhere on the board
/ir_out0: J2.17; also elsewhere on the board
/ir_out1: J2.18; also elsewhere on the board
/ir_out7: J2.24; also elsewhere on the board
/p_selector: J2.9; also elsewhere on the board
/we_a: J2.12; also elsewhere on the board
/we_b: J2.29; also elsewhere on the board
/we_ir: J2.6; also elsewhere on the board
/~oe: J2.37; also elsewhere on the board
/~oe_a_d: J2.33; also elsewhere on the board
/~oe_alu: J2.36; also elsewhere on the board
/~oe_b_alu: J2.32; also elsewhere on the board
/~oe_b_d: J2.34; also elsewhere on the board
/~oe_d_di: J2.5; also elsewhere on the board
/~oe_ph_alu: J2.30; also elsewhere on the board
/~oe_pl_alu: J2.31; also elsewhere on the board
/~rst: J2.28; also elsewhere on the board
/~we: J2.38; also elsewhere on the board
/~we_flags: J2.35; also elsewhere on the board
/~we_ph: J2.11; also elsewhere on the board
/~we_pl: J2.10; also elsewhere on the board
GND: J2.2, J2.39; also elsewhere on the board
VCC: J2.1, J2.40; also elsewhere on the board

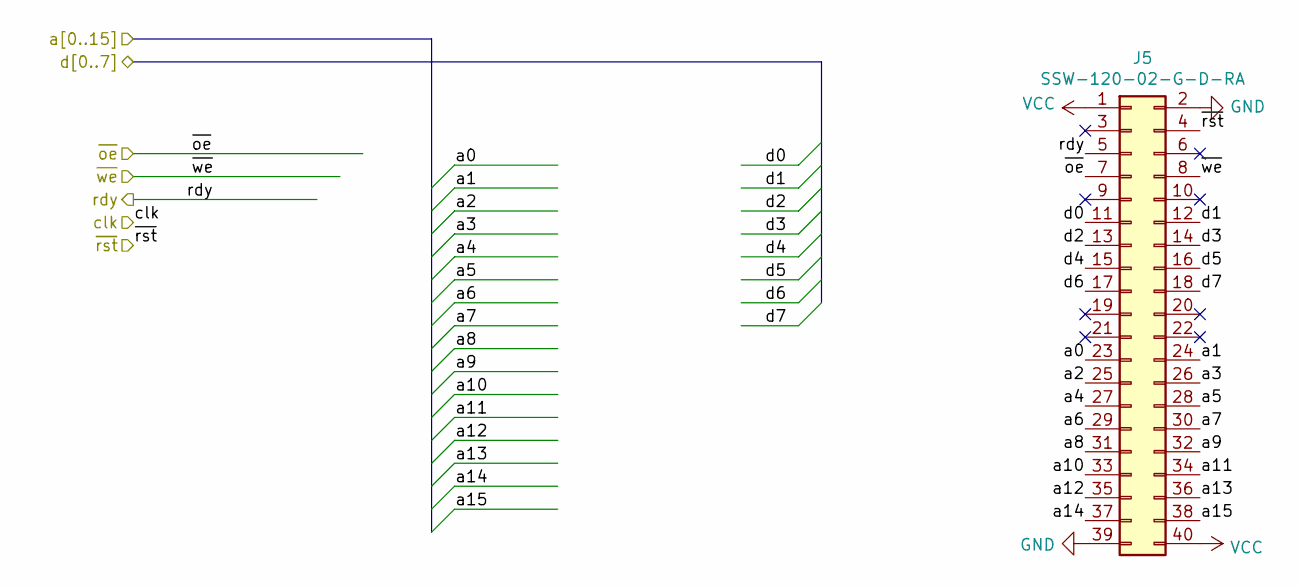
[picture p42: schematic cpu_interface.sch, CPU interface]

Parts:
J5: SSW-120-02-G-D-RA; PinSocket_2x20_P2.54mm_Horizontal

Connections:
/cpu_interface/a0: J5.23; also elsewhere on the board
/cpu_interface/a1: J5.24; also elsewhere on the board
/cpu_interface/a2: J5.25; also elsewhere on the board
/cpu_interface/a3: J5.26; also elsewhere on the board
/cpu_interface/a4: J5.27; also elsewhere on the board
/cpu_interface/a5: J5.28; also elsewhere on the board
/cpu_interface/a6: J5.29; also elsewhere on the board
/cpu_interface/a7: J5.30; also elsewhere on the board
/cpu_interface/a8: J5.31; also elsewhere on the board
/cpu_interface/a9: J5.32; also elsewhere on the board
/cpu_interface/a10: J5.33; also elsewhere on the board
/cpu_interface/a11: J5.34; also elsewhere on the board
/cpu_interface/a12: J5.35; also elsewhere on the board
/cpu_interface/a13: J5.36; also elsewhere on the board
/cpu_interface/a14: J5.37; also elsewhere on the board
/cpu_interface/a15: J5.38; also elsewhere on the board
/d0: J5.11; also elsewhere on the board
/d1: J5.12; also elsewhere on the board
/d2: J5.13; also elsewhere on the board
/d3: J5.14; also elsewhere on the board
/d4: J5.15; also elsewhere on the board
/d5: J5.16; also elsewhere on the board
/d6: J5.17; also elsewhere on the board
/d7: J5.18; also elsewhere on the board
/mem_rdy: J5.5; also elsewhere on the board
/~ext_rst: J5.4; also elsewhere on the board
/~oe: J5.7; also elsewhere on the board
/~we: J5.8; also elsewhere on the board
GND: J5.2, J5.39; also elsewhere on the board
VCC: J5.1, J5.40; also elsewhere on the board

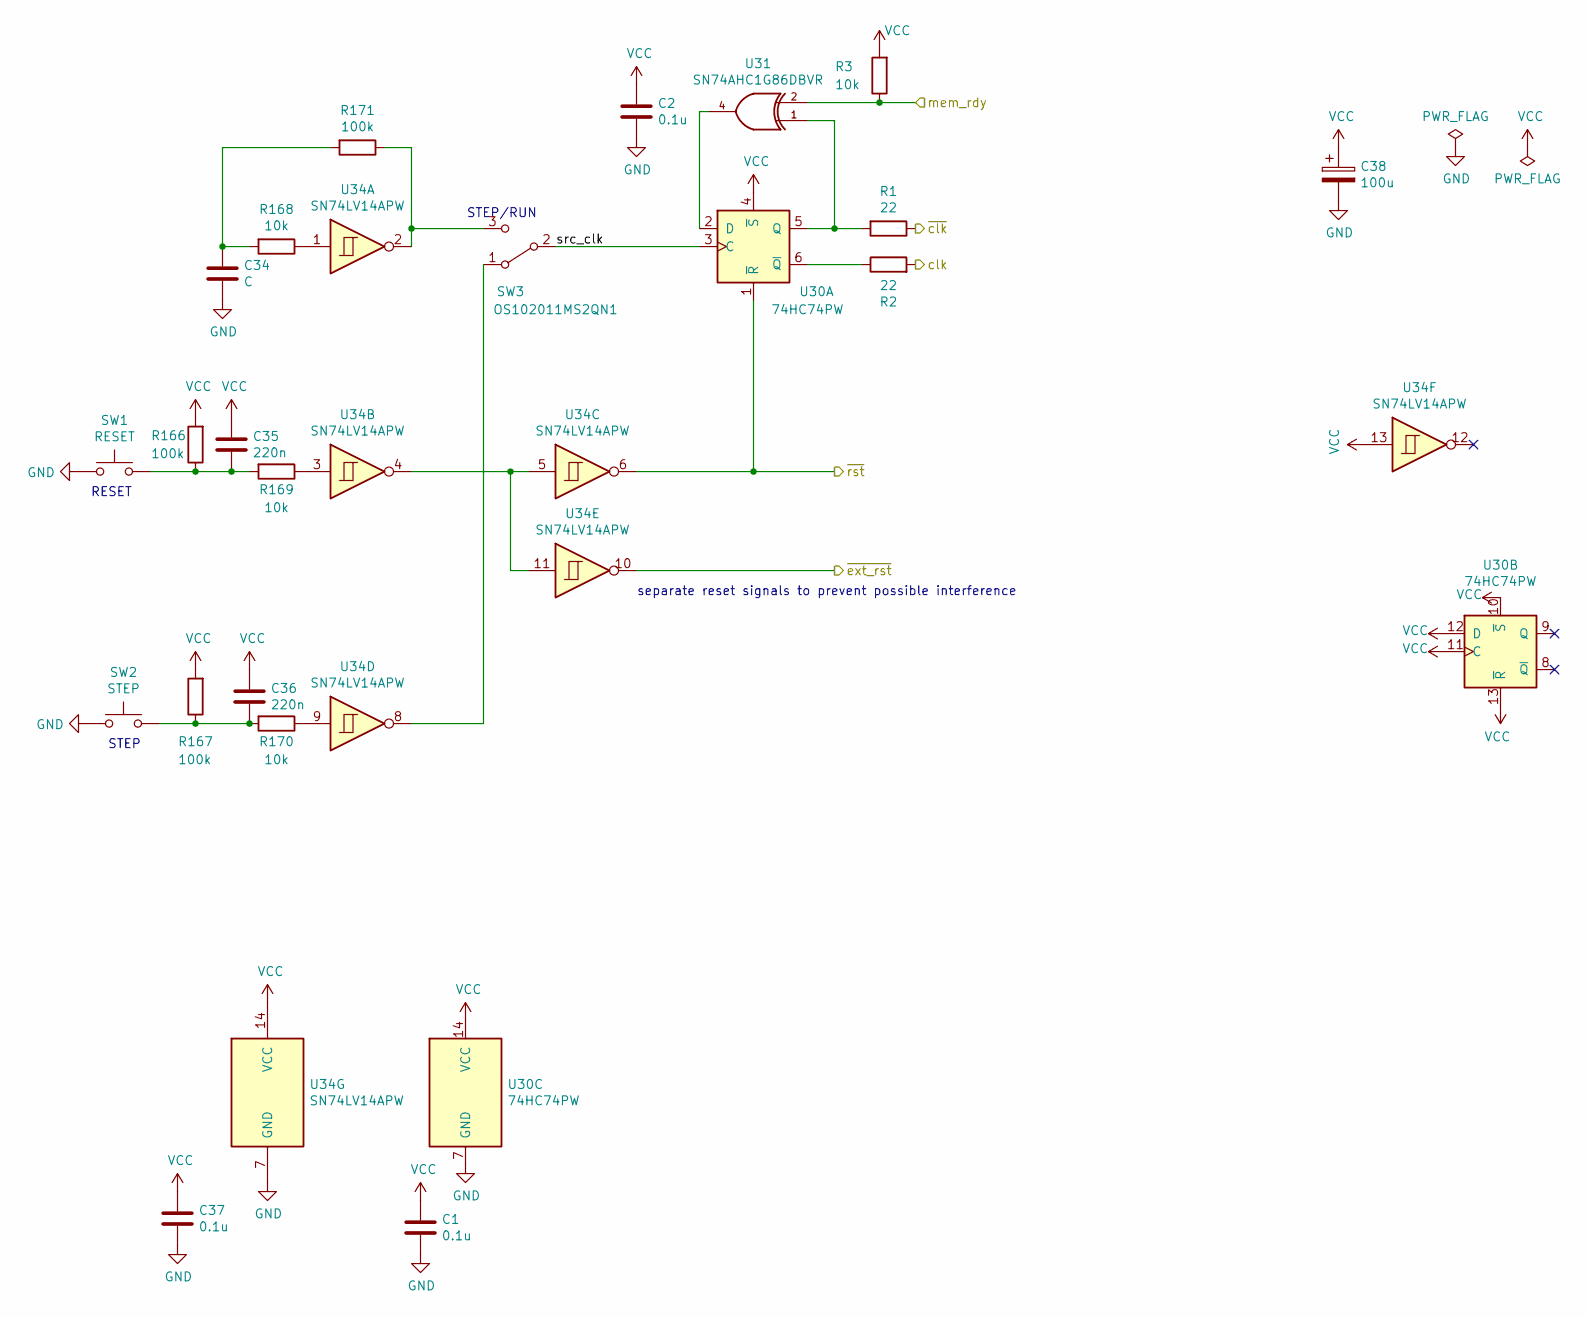
[picture p43: schematic pwr_and_clk.sch, Clock, reset, and power input]

Parts:
C1, C2, C37: 0.1u; C_0805_2012Metric
C34: C; C_0805_2012Metric
C35, C36: 220n; C_0805_2012Metric
C38: 100u; CP_EIA-3528-21_Kemet-B_Pad1.50x2.35mm_HandSolder
R1, R2: 22; R_0805_2012Metric
R3, R168, R169, R170: 10k; R_0805_2012Metric
R166, R167, R171: 100k; R_0805_2012Metric
SW1: RESET; SW_PUSH_6mm
SW2: STEP; SW_PUSH_6mm
SW3: OS102011MS2QN1; SW_Slide_1P2T_CK_OS102011MS2Q
U30: 74HC74PW; TSSOP-14_4.4x5mm_P0.65mm
U31: SN74AHC1G86DBVR; SOT-23-5
U34: SN74LV14APW; TSSOP-14_4.4x5mm_P0.65mm

Connections:
/clk: R2.2; also elsewhere on the board
/mem_rdy: R3.1, U31.2; also elsewhere on the board
/pwr_and_clk/src_clk: SW3.2 (B), U30.3 (C)
/~clk: R1.1; also elsewhere on the board
/~ext_rst: U34.10; also elsewhere on the board
/~rst: U30.1 (~R), U34.6; also elsewhere on the board
GND: C1.2, C2.2, C34.2, C37.2, C38.2, SW1.1, SW2.1, U30.7 (GND), U31.3 (GND), U34.7 (GND); also elsewhere on the board
unnamed: C34.1, R168.2, R171.2
unnamed: C35.2, R166.1, R169.2, SW1.2
unnamed: C36.2, R167.1, R170.2, SW2.2
unnamed: R1.2, U30.5 (Q), U31.1
unnamed: R2.1, U30.6 (~Q)
unnamed: R168.1, U34.1
unnamed: R169.1, U34.3
unnamed: R170.1, U34.9
unnamed: R171.1, SW3.3 (C), U34.2
unnamed: SW3.1 (A), U34.8
unnamed: U30.2 (D), U31.4
unnamed: U34.4, U34.5, U34.11
VCC: C1.1, C2.1, C35.1, C36.1, C37.1, C38.1, R3.2, R166.2, R167.2, U30.4 (~S), U30.10 (~S), U30.11 (C), U30.12 (D), U30.13 (~R), U30.14 (VCC), U31.5 (VCC), U34.13, U34.14 (VCC); also elsewhere on the board

Notes on the sheet:
STEP/RUN
RESET
STEP
separate reset signals to prevent possible interference
