imihajlow/ccpu/boards/registers/registers.kicad_pcb

## KiCad design boards/registers/registers.kicad_pcb (continued)

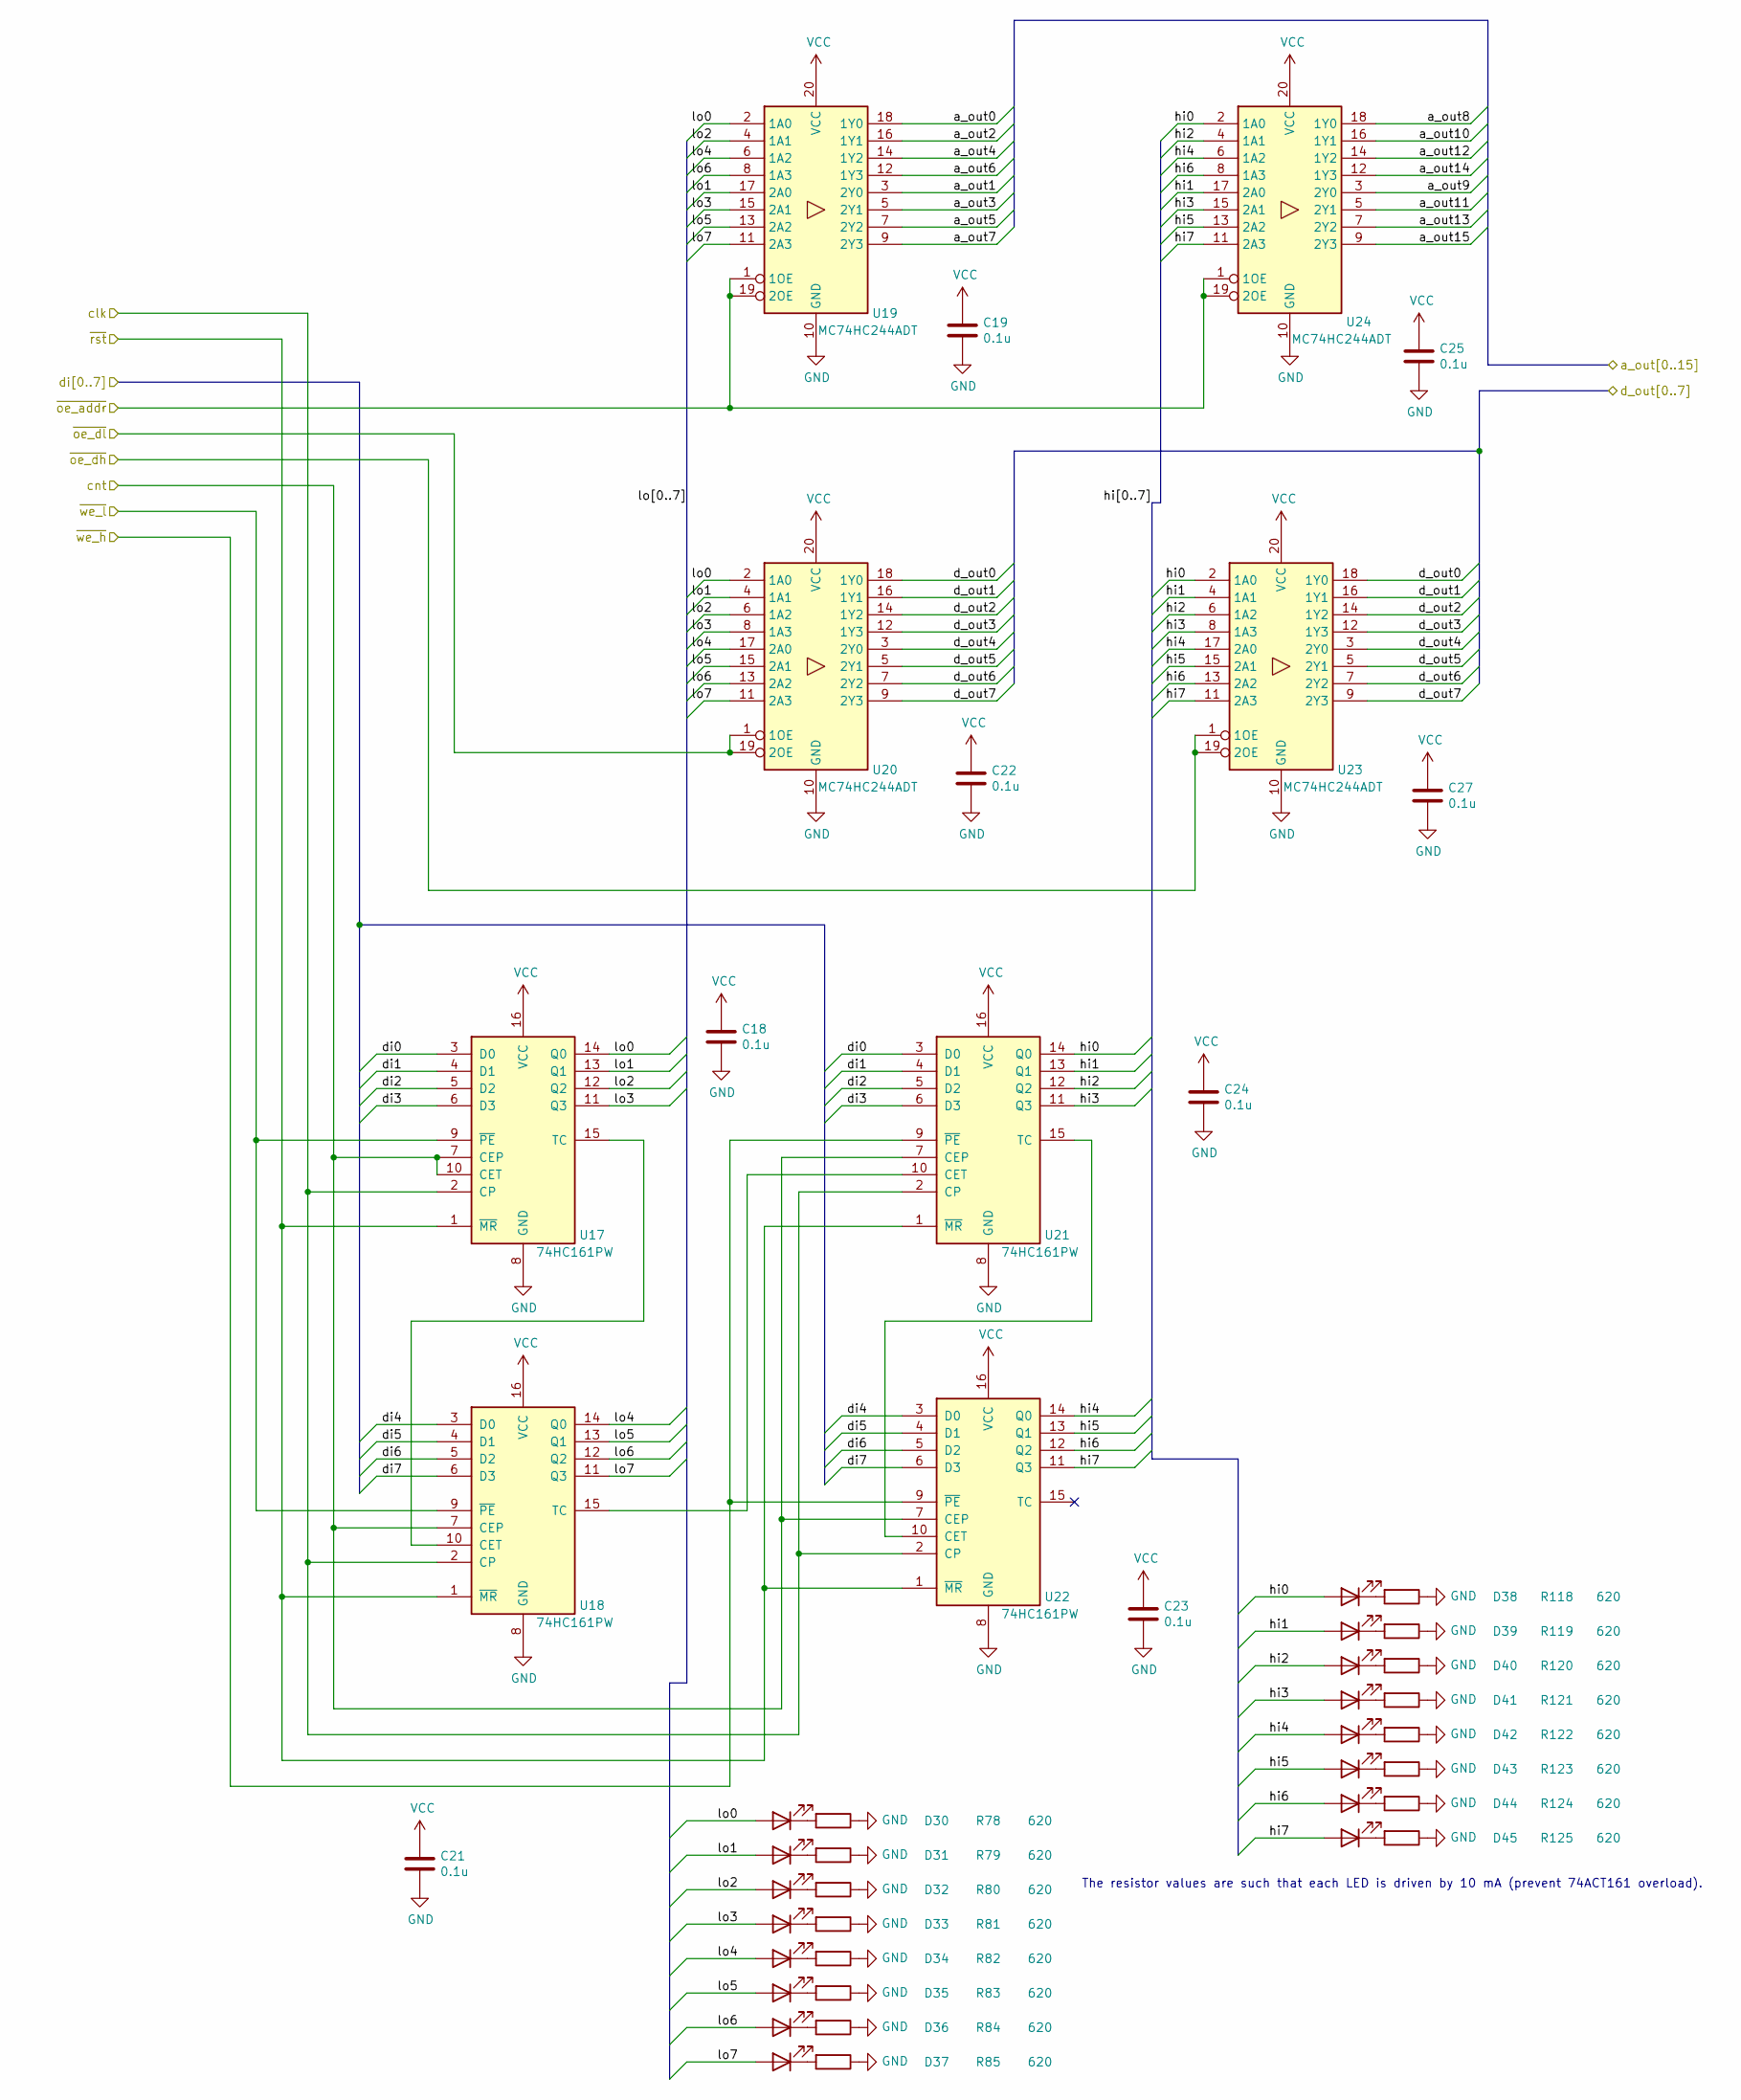
[picture p44: schematic pointer_reg.sch, Pointer register]

Parts:
C10, C11, C13, C14, C15, C16, C17, C20: 0.1u; C_0805_2012Metric
D14, D15, D16, D17, D18, D19, D20, D21, D22, D23, D24, D25, D26, D27, D28, D29: KP-2012EC; LED_0805_2012Metric
R30, R31, R32, R33, R34, R35, R36, R37, R70, R71, R72, R73, R74, R75, R76, R77: 620; R_0805_2012Metric
U9, U10, U13, U14: 74HC161PW; TSSOP-16_4.4x5mm_P0.65mm
U11, U12, U15, U16: MC74HC244ADT; TSSOP-20_4.4x6.5mm_P0.65mm

Connections:
/alu_b0: U12.18 (1Y0), U15.18 (1Y0); also elsewhere on the board
/alu_b1: U12.16 (1Y1), U15.16 (1Y1); also elsewhere on the board
/alu_b2: U12.14 (1Y2), U15.14 (1Y2); also elsewhere on the board
/alu_b3: U12.12 (1Y3), U15.12 (1Y3); also elsewhere on the board
/alu_b4: U12.3 (2Y0), U15.3 (2Y0); also elsewhere on the board
/alu_b5: U12.5 (2Y1), U15.5 (2Y1); also elsewhere on the board
/alu_b6: U12.7 (2Y2), U15.7 (2Y2); also elsewhere on the board
/alu_b7: U12.9 (2Y3), U15.9 (2Y3); also elsewhere on the board
/cpu_interface/a0: U11.18 (1Y0); also elsewhere on the board
/cpu_interface/a1: U11.3 (2Y0); also elsewhere on the board
/cpu_interface/a2: U11.16 (1Y1); also elsewhere on the board
/cpu_interface/a3: U11.5 (2Y1); also elsewhere on the board
/cpu_interface/a4: U11.14 (1Y2); also elsewhere on the board
/cpu_interface/a5: U11.7 (2Y2); also elsewhere on the board
/cpu_interface/a6: U11.12 (1Y3); also elsewhere on the board
/cpu_interface/a7: U11.9 (2Y3); also elsewhere on the board
/cpu_interface/a8: U16.18 (1Y0); also elsewhere on the board
/cpu_interface/a9: U16.3 (2Y0); also elsewhere on the board
/cpu_interface/a10: U16.16 (1Y1); also elsewhere on the board
/cpu_interface/a11: U16.5 (2Y1); also elsewhere on the board
/cpu_interface/a12: U16.14 (1Y2); also elsewhere on the board
/cpu_interface/a13: U16.7 (2Y2); also elsewhere on the board
/cpu_interface/a14: U16.12 (1Y3); also elsewhere on the board
/cpu_interface/a15: U16.9 (2Y3); also elsewhere on the board
/di0: U9.3 (D0), U13.3 (D0); also elsewhere on the board
/di1: U9.4 (D1), U13.4 (D1); also elsewhere on the board
/di2: U9.5 (D2), U13.5 (D2); also elsewhere on the board
/di3: U9.6 (D3), U13.6 (D3); also elsewhere on the board
/di4: U10.3 (D0), U14.3 (D0); also elsewhere on the board
/di5: U10.4 (D1), U14.4 (D1); also elsewhere on the board
/di6: U10.5 (D2), U14.5 (D2); also elsewhere on the board
/di7: U10.6 (D3), U14.6 (D3); also elsewhere on the board
/pointer_pair/reg_a/cnt: U9.7 (CEP), U9.10 (CET), U10.7 (CEP), U13.7 (CEP), U14.7 (CEP); also elsewhere on the board
/pointer_pair/reg_a/hi0: D22.2 (A), U13.14 (Q0), U15.2 (1A0), U16.2 (1A0)
/pointer_pair/reg_a/hi1: D23.2 (A), U13.13 (Q1), U15.4 (1A1), U16.17 (2A0)
/pointer_pair/reg_a/hi2: D24.2 (A), U13.12 (Q2), U15.6 (1A2), U16.4 (1A1)
/pointer_pair/reg_a/hi3: D25.2 (A), U13.11 (Q3), U15.8 (1A3), U16.15 (2A1)
/pointer_pair/reg_a/hi4: D26.2 (A), U14.14 (Q0), U15.17 (2A0), U16.6 (1A2)
/pointer_pair/reg_a/hi5: D27.2 (A), U14.13 (Q1), U15.15 (2A1), U16.13 (2A2)
/pointer_pair/reg_a/hi6: D28.2 (A), U14.12 (Q2), U15.13 (2A2), U16.8 (1A3)
/pointer_pair/reg_a/hi7: D29.2 (A), U14.11 (Q3), U15.11 (2A3), U16.11 (2A3)
/pointer_pair/reg_a/lo0: D14.2 (A), U9.14 (Q0), U11.2 (1A0), U12.2 (1A0)
/pointer_pair/reg_a/lo1: D15.2 (A), U9.13 (Q1), U11.17 (2A0), U12.4 (1A1)
/pointer_pair/reg_a/lo2: D16.2 (A), U9.12 (Q2), U11.4 (1A1), U12.6 (1A2)
/pointer_pair/reg_a/lo3: D17.2 (A), U9.11 (Q3), U11.15 (2A1), U12.8 (1A3)
/pointer_pair/reg_a/lo4: D18.2 (A), U10.14 (Q0), U11.6 (1A2), U12.17 (2A0)
/pointer_pair/reg_a/lo5: D19.2 (A), U10.13 (Q1), U11.13 (2A2), U12.15 (2A1)
/pointer_pair/reg_a/lo6: D20.2 (A), U10.12 (Q2), U11.8 (1A3), U12.13 (2A2)
/pointer_pair/reg_a/lo7: D21.2 (A), U10.11 (Q3), U11.11 (2A3), U12.11 (2A3)
/pointer_pair/reg_a/~oe_dh: U15.1 (1OE), U15.19 (2OE); also elsewhere on the board
/pointer_pair/reg_a/~oe_dl: U12.1 (1OE), U12.19 (2OE); also elsewhere on the board
/pointer_pair/reg_a/~we_h: U13.9 (~PE), U14.9 (~PE); also elsewhere on the board
/pointer_pair/reg_a/~we_l: U9.9 (~PE), U10.9 (~PE); also elsewhere on the board
/pointer_pair/~a_oe_addr: U11.1 (1OE), U11.19 (2OE), U16.1 (1OE), U16.19 (2OE); also elsewhere on the board
/~clk: U9.2 (CP), U10.2 (CP), U13.2 (CP), U14.2 (CP); also elsewhere on the board
/~rst: U9.1 (~MR), U10.1 (~MR), U13.1 (~MR), U14.1 (~MR); also elsewhere on the board
GND: C10.2, C11.2, C13.2, C14.2, C15.2, C16.2, C17.2, C20.2, R30.1, R31.1, R32.1, R33.1, R34.1, R35.1, R36.1, R37.1, R70.1, R71.1, R72.1, R73.1, R74.1, R75.1, R76.1, R77.1, U9.8 (GND), U10.8 (GND), U11.10 (GND), U12.10 (GND), U13.8 (GND), U14.8 (GND), U15.10 (GND), U16.10 (GND); also elsewhere on the board
unnamed: D14.1 (K), R30.2
unnamed: D15.1 (K), R31.2
unnamed: D16.1 (K), R32.2
unnamed: D17.1 (K), R33.2
unnamed: D18.1 (K), R34.2
unnamed: D19.1 (K), R35.2
unnamed: D20.1 (K), R36.2
unnamed: D21.1 (K), R37.2
unnamed: D22.1 (K), R70.2
unnamed: D23.1 (K), R71.2
unnamed: D24.1 (K), R72.2
unnamed: D25.1 (K), R73.2
unnamed: D26.1 (K), R74.2
unnamed: D27.1 (K), R75.2
unnamed: D28.1 (K), R76.2
unnamed: D29.1 (K), R77.2
unnamed: U9.15 (TC), U10.10 (CET)
unnamed: U10.15 (TC), U13.10 (CET)
unnamed: U13.15 (TC), U14.10 (CET)
VCC: C10.1, C11.1, C13.1, C14.1, C15.1, C16.1, C17.1, C20.1, U9.16 (VCC), U10.16 (VCC), U11.20 (VCC), U12.20 (VCC), U13.16 (VCC), U14.16 (VCC), U15.20 (VCC), U16.20 (VCC); also elsewhere on the board

Parts of its further copies:
C18, C19, C21, C22, C23, C24, C25, C27: 0.1u; C_0805_2012Metric
D30, D31, D32, D33, D34, D35, D36, D37, D38, D39, D40, D41, D42, D43, D44, D45: KP-2012EC; LED_0805_2012Metric
R78, R79, R80, R81, R82, R83, R84, R85, R118, R119, R120, R121, R122, R123, R124, R125: 620; R_0805_2012Metric
U17, U18, U21, U22: 74HC161PW; TSSOP-16_4.4x5mm_P0.65mm
U19, U20, U23, U24: MC74HC244ADT; TSSOP-20_4.4x6.5mm_P0.65mm

Connections of its further copies:
/alu_b0: U20.18 (1Y0), U23.18 (1Y0); also elsewhere on the board
/alu_b1: U20.16 (1Y1), U23.16 (1Y1); also elsewhere on the board
/alu_b2: U20.14 (1Y2), U23.14 (1Y2); also elsewhere on the board
/alu_b3: U20.12 (1Y3), U23.12 (1Y3); also elsewhere on the board
/alu_b4: U20.3 (2Y0), U23.3 (2Y0); also elsewhere on the board
/alu_b5: U20.5 (2Y1), U23.5 (2Y1); also elsewhere on the board
/alu_b6: U20.7 (2Y2), U23.7 (2Y2); also elsewhere on the board
/alu_b7: U20.9 (2Y3), U23.9 (2Y3); also elsewhere on the board
/cpu_interface/a0: U19.18 (1Y0); also elsewhere on the board
/cpu_interface/a1: U19.3 (2Y0); also elsewhere on the board
/cpu_interface/a2: U19.16 (1Y1); also elsewhere on the board
/cpu_interface/a3: U19.5 (2Y1); also elsewhere on the board
/cpu_interface/a4: U19.14 (1Y2); also elsewhere on the board
/cpu_interface/a5: U19.7 (2Y2); also elsewhere on the board
/cpu_interface/a6: U19.12 (1Y3); also elsewhere on the board
/cpu_interface/a7: U19.9 (2Y3); also elsewhere on the board
/cpu_interface/a8: U24.18 (1Y0); also elsewhere on the board
/cpu_interface/a9: U24.3 (2Y0); also elsewhere on the board
/cpu_interface/a10: U24.16 (1Y1); also elsewhere on the board
/cpu_interface/a11: U24.5 (2Y1); also elsewhere on the board
/cpu_interface/a12: U24.14 (1Y2); also elsewhere on the board
/cpu_interface/a13: U24.7 (2Y2); also elsewhere on the board
/cpu_interface/a14: U24.12 (1Y3); also elsewhere on the board
/cpu_interface/a15: U24.9 (2Y3); also elsewhere on the board
/di0: U17.3 (D0), U21.3 (D0); also elsewhere on the board
/di1: U17.4 (D1), U21.4 (D1); also elsewhere on the board
/di2: U17.5 (D2), U21.5 (D2); also elsewhere on the board
/di3: U17.6 (D3), U21.6 (D3); also elsewhere on the board
/di4: U18.3 (D0), U22.3 (D0); also elsewhere on the board
/di5: U18.4 (D1), U22.4 (D1); also elsewhere on the board
/di6: U18.5 (D2), U22.5 (D2); also elsewhere on the board
/di7: U18.6 (D3), U22.6 (D3); also elsewhere on the board
/pointer_pair/reg_b/cnt: U17.7 (CEP), U17.10 (CET), U18.7 (CEP), U21.7 (CEP), U22.7 (CEP); also elsewhere on the board
/pointer_pair/reg_b/hi0: D38.2 (A), U21.14 (Q0), U23.2 (1A0), U24.2 (1A0)
/pointer_pair/reg_b/hi1: D39.2 (A), U21.13 (Q1), U23.4 (1A1), U24.17 (2A0)
/pointer_pair/reg_b/hi2: D40.2 (A), U21.12 (Q2), U23.6 (1A2), U24.4 (1A1)
/pointer_pair/reg_b/hi3: D41.2 (A), U21.11 (Q3), U23.8 (1A3), U24.15 (2A1)
/pointer_pair/reg_b/hi4: D42.2 (A), U22.14 (Q0), U23.17 (2A0), U24.6 (1A2)
/pointer_pair/reg_b/hi5: D43.2 (A), U22.13 (Q1), U23.15 (2A1), U24.13 (2A2)
/pointer_pair/reg_b/hi6: D44.2 (A), U22.12 (Q2), U23.13 (2A2), U24.8 (1A3)
/pointer_pair/reg_b/hi7: D45.2 (A), U22.11 (Q3), U23.11 (2A3), U24.11 (2A3)
/pointer_pair/reg_b/lo0: D30.2 (A), U17.14 (Q0), U19.2 (1A0), U20.2 (1A0)
/pointer_pair/reg_b/lo1: D31.2 (A), U17.13 (Q1), U19.17 (2A0), U20.4 (1A1)
/pointer_pair/reg_b/lo2: D32.2 (A), U17.12 (Q2), U19.4 (1A1), U20.6 (1A2)
/pointer_pair/reg_b/lo3: D33.2 (A), U17.11 (Q3), U19.15 (2A1), U20.8 (1A3)
/pointer_pair/reg_b/lo4: D34.2 (A), U18.14 (Q0), U19.6 (1A2), U20.17 (2A0)
/pointer_pair/reg_b/lo5: D35.2 (A), U18.13 (Q1), U19.13 (2A2), U20.15 (2A1)
/pointer_pair/reg_b/lo6: D36.2 (A), U18.12 (Q2), U19.8 (1A3), U20.13 (2A2)
/pointer_pair/reg_b/lo7: D37.2 (A), U18.11 (Q3), U19.11 (2A3), U20.11 (2A3)
/pointer_pair/reg_b/~oe_dh: U23.1 (1OE), U23.19 (2OE); also elsewhere on the board
/pointer_pair/reg_b/~oe_dl: U20.1 (1OE), U20.19 (2OE); also elsewhere on the board
/pointer_pair/reg_b/~we_h: U21.9 (~PE), U22.9 (~PE); also elsewhere on the board
/pointer_pair/reg_b/~we_l: U17.9 (~PE), U18.9 (~PE); also elsewhere on the board
/pointer_pair/~b_oe_addr: U19.1 (1OE), U19.19 (2OE), U24.1 (1OE), U24.19 (2OE); also elsewhere on the board
/~clk: U17.2 (CP), U18.2 (CP), U21.2 (CP), U22.2 (CP); also elsewhere on the board
/~rst: U17.1 (~MR), U18.1 (~MR), U21.1 (~MR), U22.1 (~MR); also elsewhere on the board
GND: C18.2, C19.2, C21.2, C22.2, C23.2, C24.2, C25.2, C27.2, R78.1, R79.1, R80.1, R81.1, R82.1, R83.1, R84.1, R85.1, R118.1, R119.1, R120.1, R121.1, R122.1, R123.1, R124.1, R125.1, U17.8 (GND), U18.8 (GND), U19.10 (GND), U20.10 (GND), U21.8 (GND), U22.8 (GND), U23.10 (GND), U24.10 (GND); also elsewhere on the board
unnamed: D30.1 (K), R78.2
unnamed: D31.1 (K), R79.2
unnamed: D32.1 (K), R80.2
unnamed: D33.1 (K), R81.2
unnamed: D34.1 (K), R82.2
unnamed: D35.1 (K), R83.2
unnamed: D36.1 (K), R84.2
unnamed: D37.1 (K), R85.2
unnamed: D38.1 (K), R118.2
unnamed: D39.1 (K), R119.2
unnamed: D40.1 (K), R120.2
unnamed: D41.1 (K), R121.2
unnamed: D42.1 (K), R122.2
unnamed: D43.1 (K), R123.2
unnamed: D44.1 (K), R124.2
unnamed: D45.1 (K), R125.2
unnamed: U17.15 (TC), U18.10 (CET)
unnamed: U18.15 (TC), U21.10 (CET)
unnamed: U21.15 (TC), U22.10 (CET)
VCC: C18.1, C19.1, C21.1, C22.1, C23.1, C24.1, C25.1, C27.1, U17.16 (VCC), U18.16 (VCC), U19.20 (VCC), U20.20 (VCC), U21.16 (VCC), U22.16 (VCC), U23.20 (VCC), U24.20 (VCC); also elsewhere on the board

Notes on the sheet:
The resistor values are such that each LED is driven by 10 mA (prevent 74ACT161 overload).

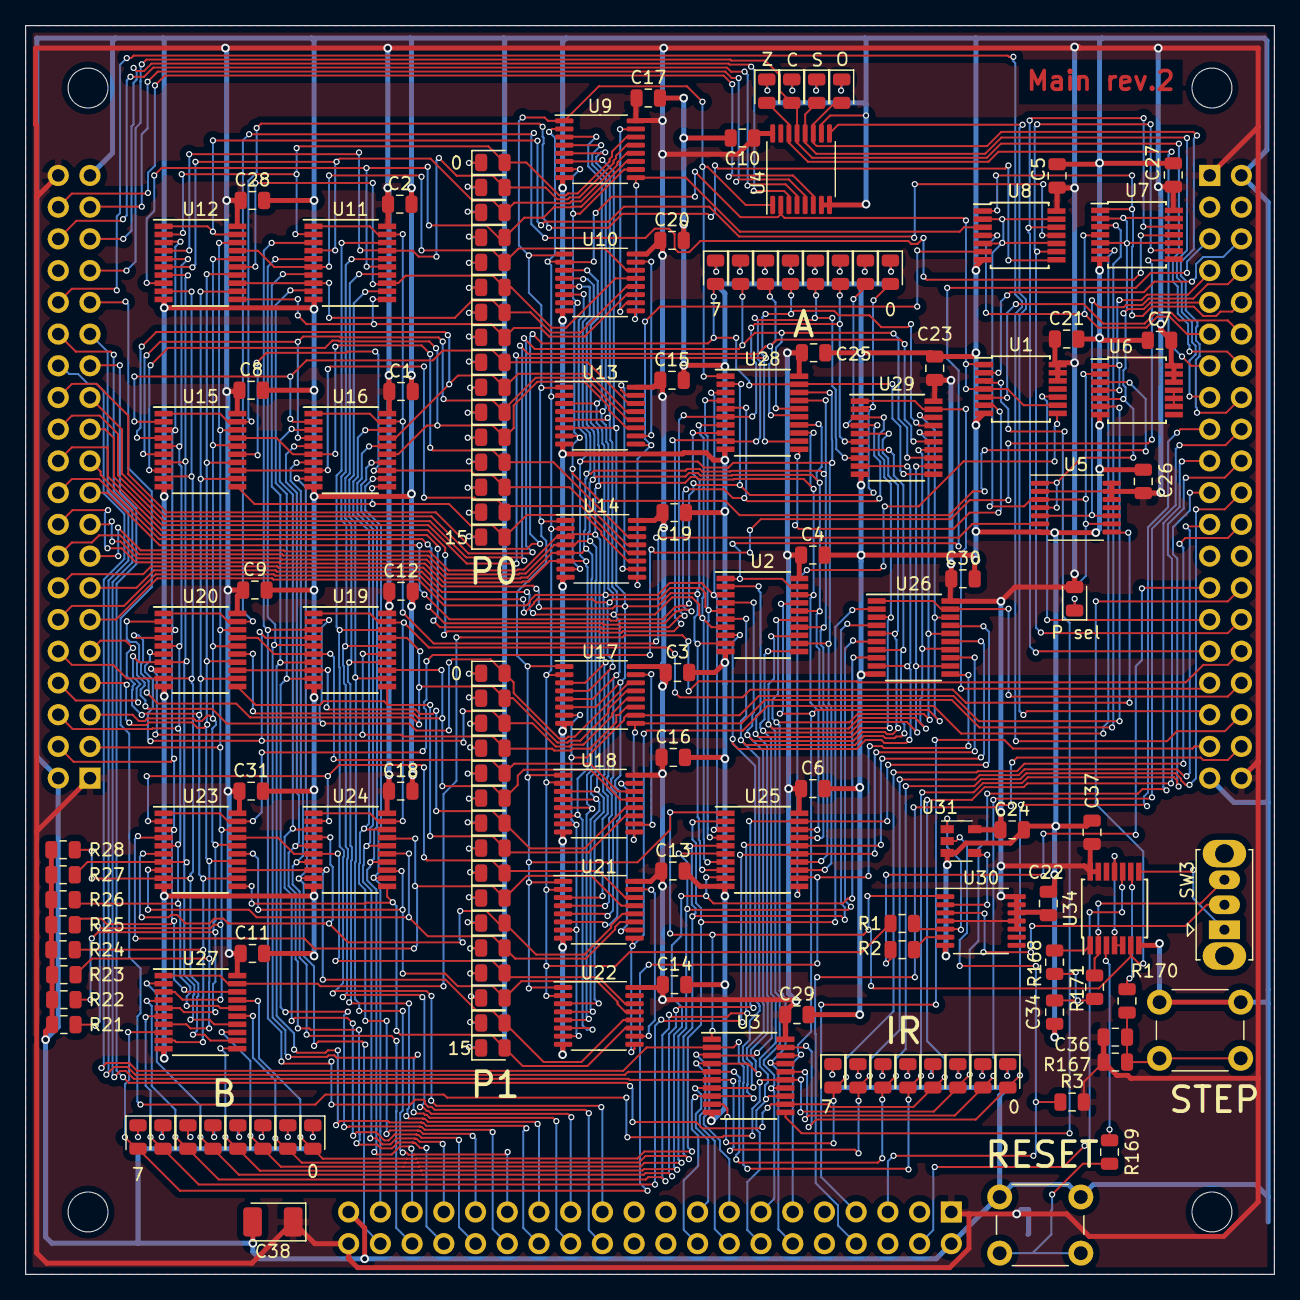
[picture p45: board registers.kicad_pcb from above]

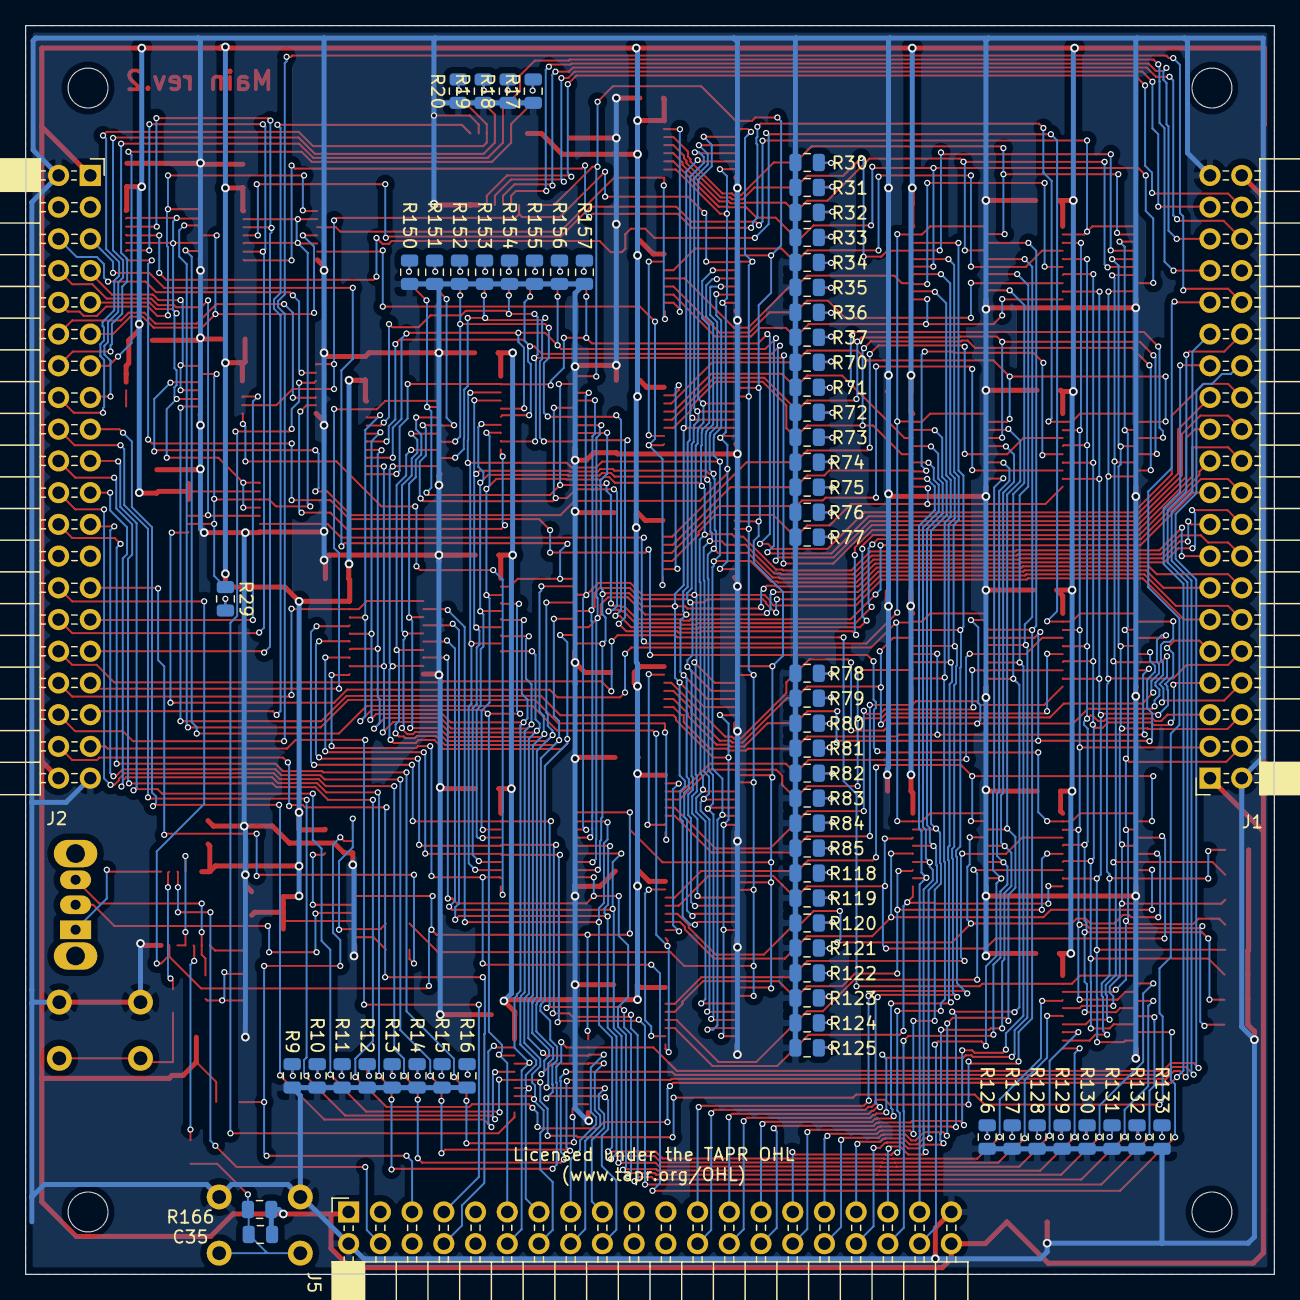
[picture p46: board registers.kicad_pcb from below]

Board: 2 copper layers, 100.0 x 100.0 mm, 217 parts (66 on the bottom side), 226 nets.
