imihajlow/ccpu/boards/io/io.kicad_pcb

## KiCad design boards/io/io.kicad_pcb (2021-01-21)

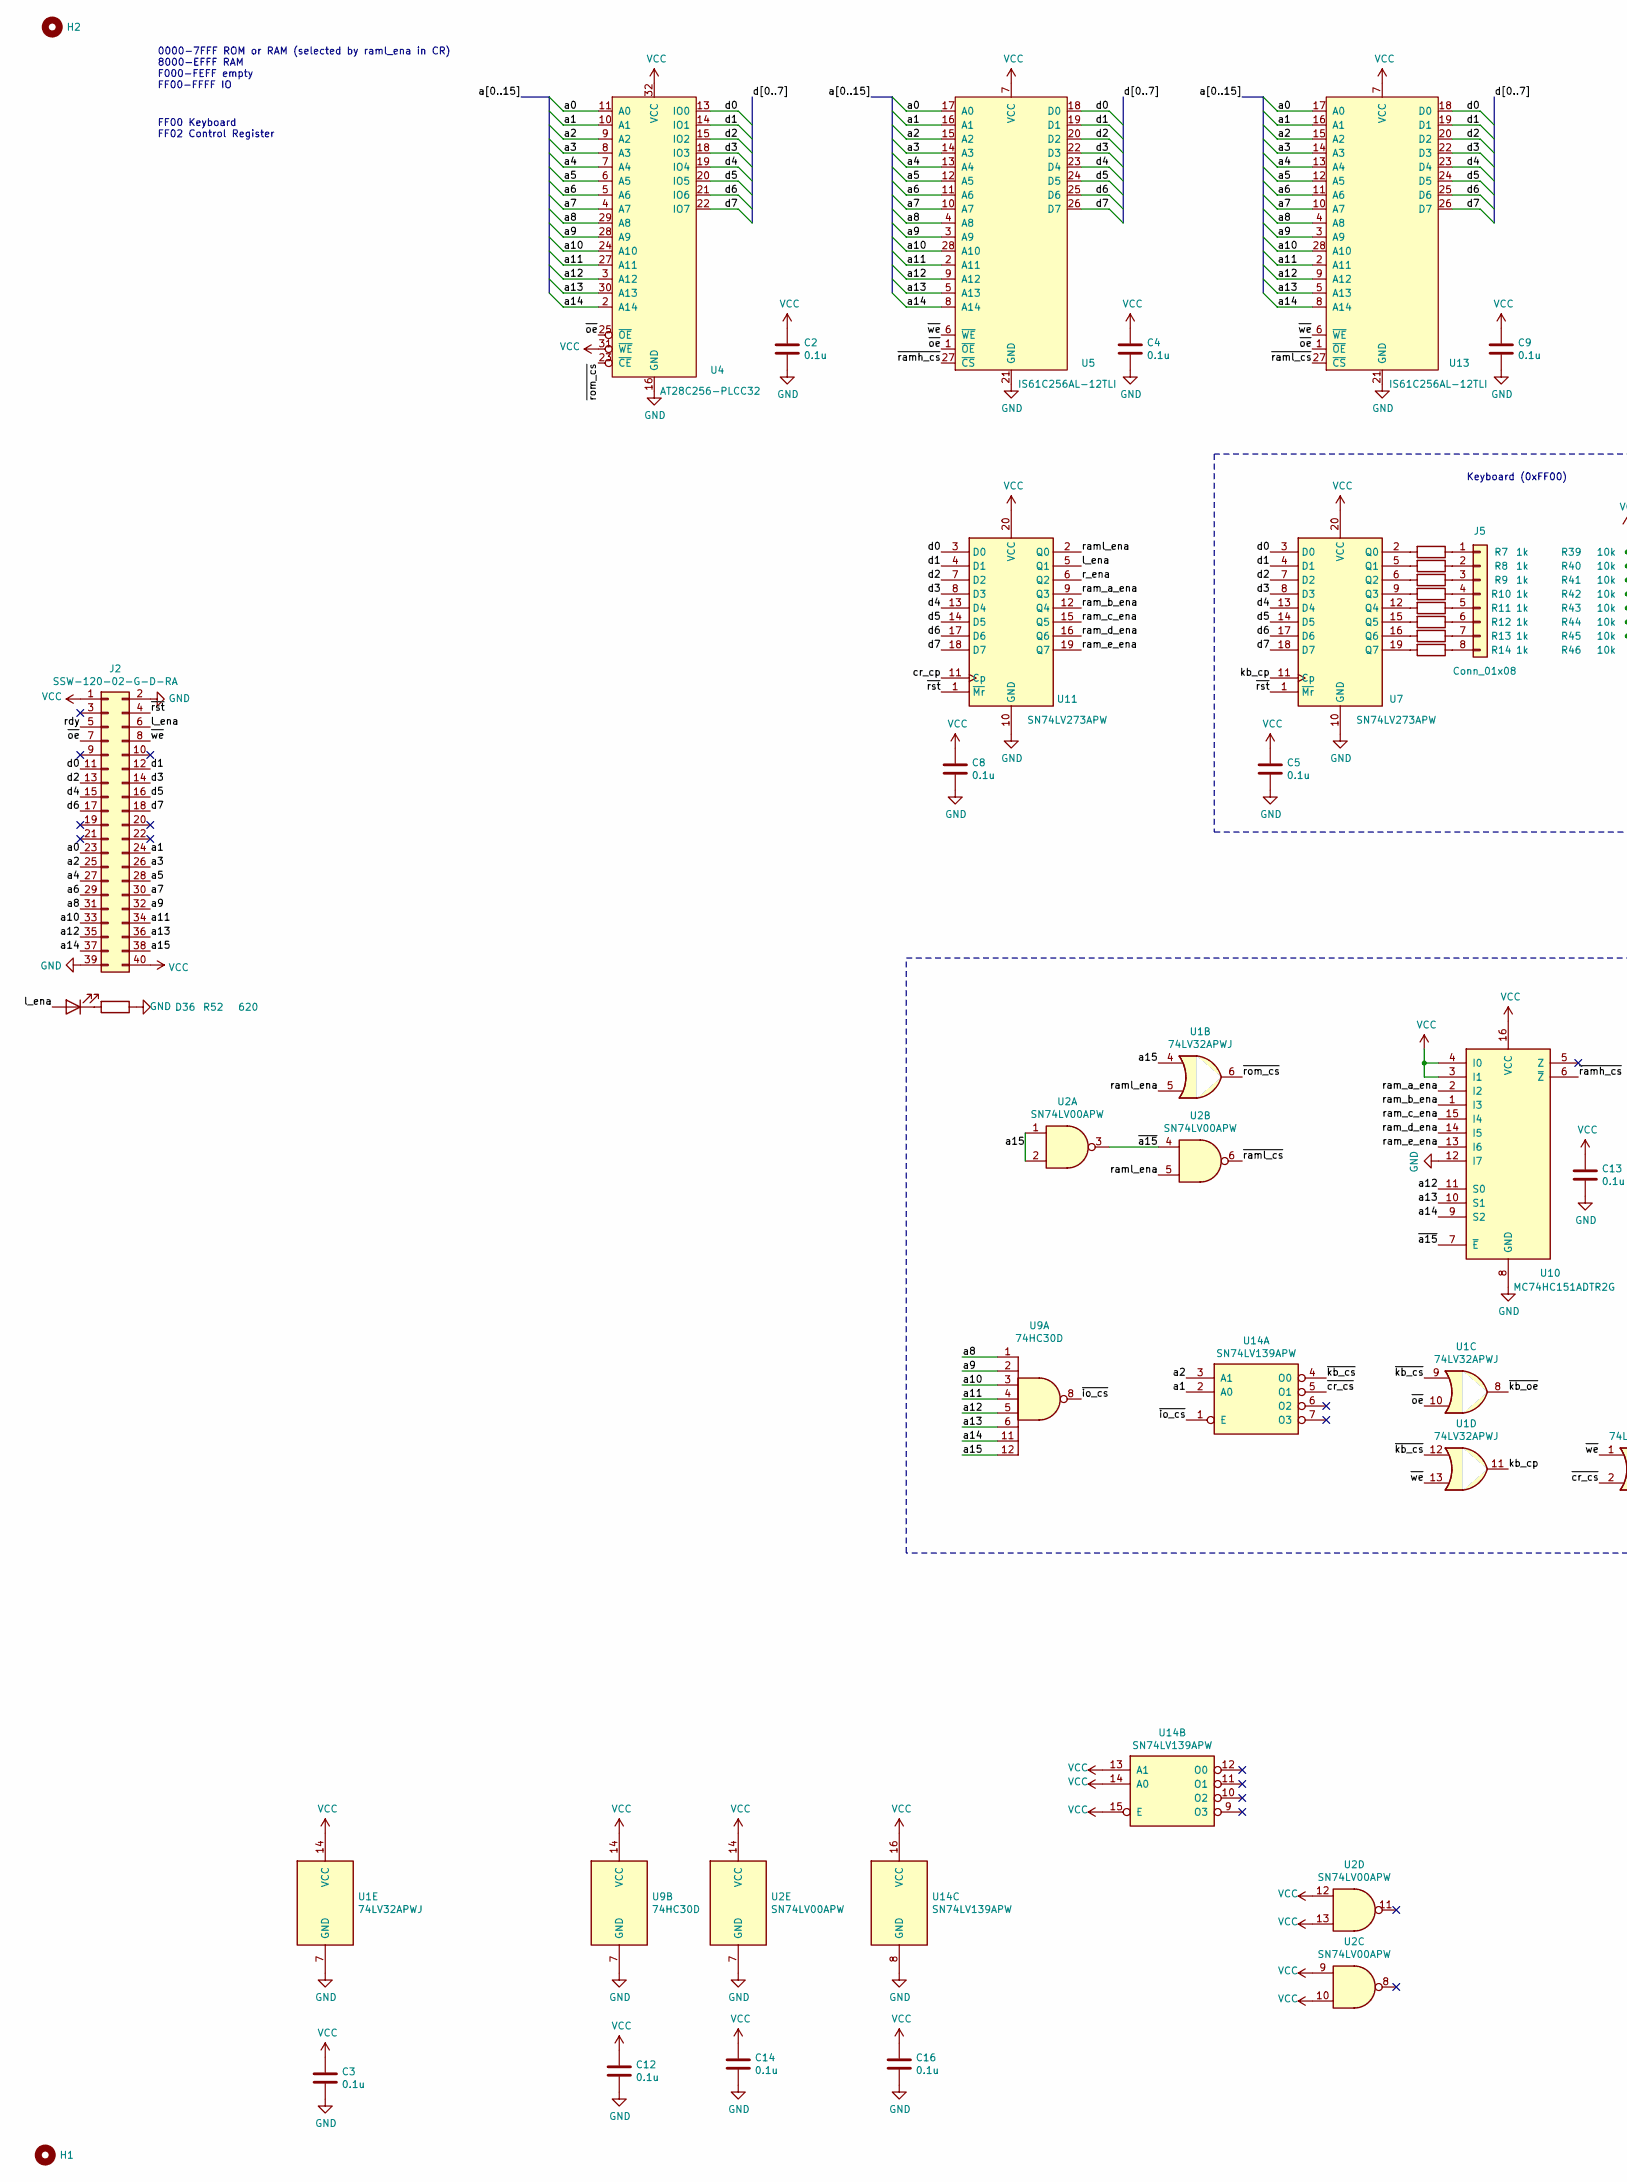
[picture p47: schematic io.sch, IO and memory board, part in row 1, column 1]

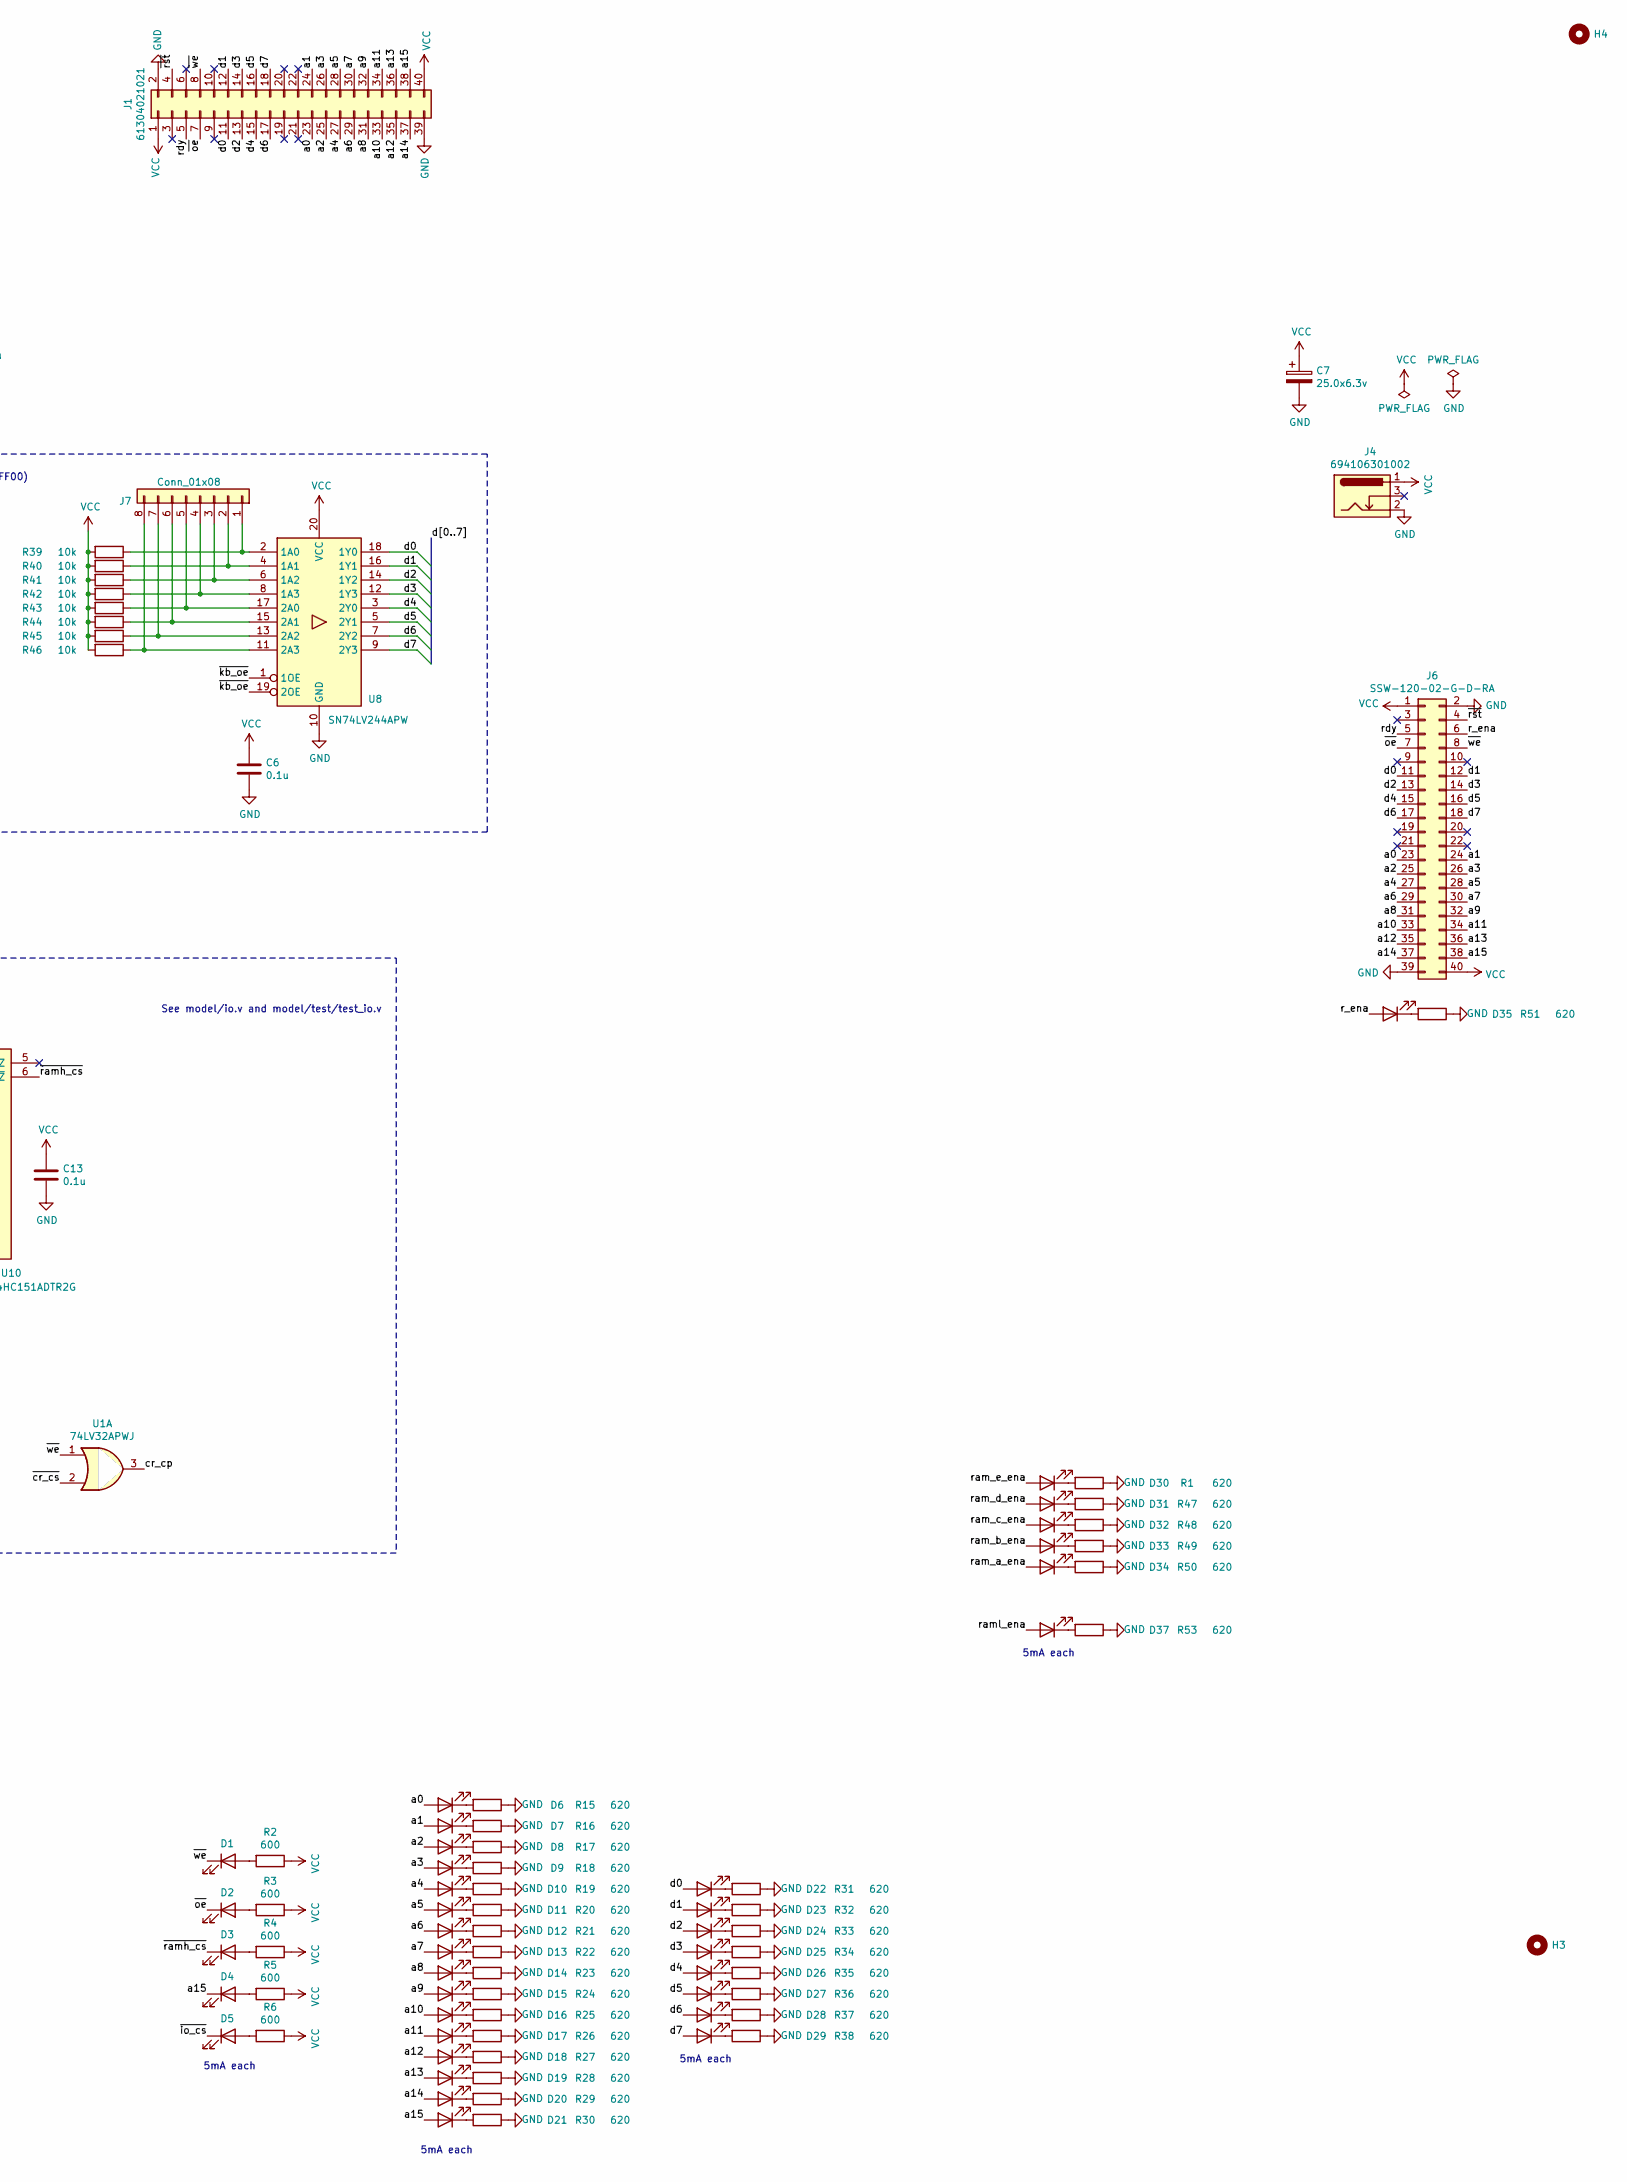
[picture p48: schematic io.sch, IO and memory board, part in row 1, column 2]

Parts:
C2, C3, C4, C5, C6, C8, C9, C12, C13, C14, C16: 0.1u; C_0805_2012Metric
C7: 25.0x6.3v; CP_EIA-3528-21_Kemet-B_Pad1.50x2.35mm_HandSolder
D1, D2, D3, D4, D5: KP-2012CGCK; LED_0805_2012Metric
D6, D7, D8, D9, D10, D11, D12, D13, D14, D15, D16, D17, D18, D19, D20, D21, D22, D23, D24, D25, D26, D27, D28, D29, D30, D31, D32, D33, D34, D35, D36, D37: KP-2012EC; LED_0805_2012Metric
H1, H2, H3, H4: MountingHole; MountingHole_3.2mm_M3
J1: 61304021021; PinHeader_2x20_P2.54mm_Horizontal
J2, J6: SSW-120-02-G-D-RA; PinSocket_2x20_P2.54mm_Horizontal
J4: 694106301002; BarrelJack_Wuerth_6941xx301002
J5, J7: Conn_01x08; PinHeader_1x08_P2.54mm_Vertical
R1, R15, R16, R17, R18, R19, R20, R21, R22, R23, R24, R25, R26, R27, R28, R29, R30, R31, R32, R33, R34, R35, R36, R37, R38, R47, R48, R49, R50, R51, R52, R53: 620; R_0805_2012Metric
R2, R3, R4, R5, R6: 600; R_0805_2012Metric
R7, R8, R9, R10, R11, R12, R13, R14: 1k; R_0805_2012Metric
R39, R40, R41, R42, R43, R44, R45, R46: 10k; R_0805_2012Metric
U1: 74LV32APWJ; TSSOP-14_4.4x5mm_P0.65mm
U2: SN74LV00APW; TSSOP-14_4.4x5mm_P0.65mm
U4: AT28C256-PLCC32; PLCC-32_SMD_Socket
U5, U13: IS61C256AL-12TLI; TSOP-I-28_11.8x8mm_P0.55mm
U7, U11: SN74LV273APW; TSSOP-20_4.4x6.5mm_P0.65mm
U8: SN74LV244APW; TSSOP-20_4.4x6.5mm_P0.65mm
U9: 74HC30D; SOIC-14_3.9x8.7mm_P1.27mm
U10: MC74HC151ADTR2G; TSSOP-16_4.4x5mm_P0.65mm
U14: SN74LV139APW; TSSOP-16_4.4x5mm_P0.65mm

Connections:
/a0: D6.2 (A), J1.23, J2.23, J6.23, U4.11 (A0), U5.17 (A0), U13.17 (A0)
/a1: D7.2 (A), J1.24, J2.24, J6.24, U4.10 (A1), U5.16 (A1), U13.16 (A1), U14.2 (A0)
/a2: D8.2 (A), J1.25, J2.25, J6.25, U4.9 (A2), U5.15 (A2), U13.15 (A2), U14.3 (A1)
/a3: D9.2 (A), J1.26, J2.26, J6.26, U4.8 (A3), U5.14 (A3), U13.14 (A3)
/a4: D10.2 (A), J1.27, J2.27, J6.27, U4.7 (A4), U5.13 (A4), U13.13 (A4)
/a5: D11.2 (A), J1.28, J2.28, J6.28, U4.6 (A5), U5.12 (A5), U13.12 (A5)
/a6: D12.2 (A), J1.29, J2.29, J6.29, U4.5 (A6), U5.11 (A6), U13.11 (A6)
/a7: D13.2 (A), J1.30, J2.30, J6.30, U4.4 (A7), U5.10 (A7), U13.10 (A7)
/a8: D14.2 (A), J1.31, J2.31, J6.31, U4.29 (A8), U5.4 (A8), U9.1, U13.4 (A8)
/a9: D15.2 (A), J1.32, J2.32, J6.32, U4.28 (A9), U5.3 (A9), U9.2, U13.3 (A9)
/a10: D16.2 (A), J1.33, J2.33, J6.33, U4.24 (A10), U5.28 (A10), U9.3, U13.28 (A10)
/a11: D17.2 (A), J1.34, J2.34, J6.34, U4.27 (A11), U5.2 (A11), U9.4, U13.2 (A11)
/a12: D18.2 (A), J1.35, J2.35, J6.35, U4.3 (A12), U5.9 (A12), U9.5, U10.11 (S0), U13.9 (A12)
/a13: D19.2 (A), J1.36, J2.36, J6.36, U4.30 (A13), U5.5 (A13), U9.6, U10.10 (S1), U13.5 (A13)
/a14: D20.2 (A), J1.37, J2.37, J6.37, U4.2 (A14), U5.8 (A14), U9.11, U10.9 (S2), U13.8 (A14)
/a15: D4.1 (K), D21.2 (A), J1.38, J2.38, J6.38, U1.4, U2.1, U2.2, U9.12
/cr_cp: U1.3, U11.11 (Cp)
/d0: D22.2 (A), J1.11, J2.11, J6.11, U4.13 (IO0), U5.18 (D0), U7.3 (D0), U8.18 (1Y0), U11.3 (D0), U13.18 (D0)
/d1: D23.2 (A), J1.12, J2.12, J6.12, U4.14 (IO1), U5.19 (D1), U7.4 (D1), U8.16 (1Y1), U11.4 (D1), U13.19 (D1)
/d2: D24.2 (A), J1.13, J2.13, J6.13, U4.15 (IO2), U5.20 (D2), U7.7 (D2), U8.14 (1Y2), U11.7 (D2), U13.20 (D2)
/d3: D25.2 (A), J1.14, J2.14, J6.14, U4.18 (IO3), U5.22 (D3), U7.8 (D3), U8.12 (1Y3), U11.8 (D3), U13.22 (D3)
/d4: D26.2 (A), J1.15, J2.15, J6.15, U4.19 (IO4), U5.23 (D4), U7.13 (D4), U8.3 (2Y0), U11.13 (D4), U13.23 (D4)
/d5: D27.2 (A), J1.16, J2.16, J6.16, U4.20 (IO5), U5.24 (D5), U7.14 (D5), U8.5 (2Y1), U11.14 (D5), U13.24 (D5)
/d6: D28.2 (A), J1.17, J2.17, J6.17, U4.21 (IO6), U5.25 (D6), U7.17 (D6), U8.7 (2Y2), U11.17 (D6), U13.25 (D6)
/d7: D29.2 (A), J1.18, J2.18, J6.18, U4.22 (IO7), U5.26 (D7), U7.18 (D7), U8.9 (2Y3), U11.18 (D7), U13.26 (D7)
/kb_cp: U1.11, U7.11 (Cp)
/l_ena: D36.2 (A), J2.6, U11.5 (Q1)
/r_ena: D35.2 (A), J6.6, U11.6 (Q2)
/ram_a_ena: D34.2 (A), U10.2 (I2), U11.9 (Q3)
/ram_b_ena: D33.2 (A), U10.1 (I3), U11.12 (Q4)
/ram_c_ena: D32.2 (A), U10.15 (I4), U11.15 (Q5)
/ram_d_ena: D31.2 (A), U10.14 (I5), U11.16 (Q6)
/ram_e_ena: D30.2 (A), U10.13 (I6), U11.19 (Q7)
/raml_ena: D37.2 (A), U1.5, U2.5, U11.2 (Q0)
/rdy: J1.5, J2.5, J6.5
/~a15: U2.3, U2.4, U10.7 (~E)
/~cr_cs: U1.2, U14.5 (O1)
/~io_cs: D5.1 (K), U9.8, U14.1 (E)
/~kb_cs: U1.9, U1.12, U14.4 (O0)
/~kb_oe: U1.8, U8.1 (1OE), U8.19 (2OE)
/~oe: D2.1 (K), J1.7, J2.7, J6.7, U1.10, U4.25 (~OE), U5.1 (~OE), U13.1 (~OE)
/~ramh_cs: D3.1 (K), U5.27 (~CS), U10.6 (~Z)
/~raml_cs: U2.6, U13.27 (~CS)
/~rom_cs: U1.6, U4.23 (~CE)
/~rst: J1.4, J2.4, J6.4, U7.1 (~Mr), U11.1 (~Mr)
/~we: D1.1 (K), J1.8, J2.8, J6.8, U1.1, U1.13, U5.6 (~WE), U13.6 (~WE)
GND: C2.2, C3.2, C4.2, C5.2, C6.2, C7.2, C8.2, C9.2, C12.2, C13.2, C14.2, C16.2, J1.2, J1.39, J2.2, J2.39, J4.2, J6.2, J6.39, R1.1, R15.1, R16.1, R17.1, R18.1, R19.1, R20.1, R21.1, R22.1, R23.1, R24.1, R25.1, R26.1, R27.1, R28.1, R29.1, R30.1, R31.1, R32.1, R33.1, R34.1, R35.1, R36.1, R37.1, R38.1, R47.1, R48.1, R49.1, R50.1, R51.1, R52.1, R53.1, U1.7 (GND), U2.7 (GND), U4.16 (GND), U5.21 (GND), U7.10 (GND), U8.10 (GND), U9.7 (GND), U10.8 (GND), U10.12 (I7), U11.10 (GND), U13.21 (GND), U14.8 (GND)
unnamed: D1.2 (A), R2.2
unnamed: D2.2 (A), R3.2
unnamed: D3.2 (A), R4.2
unnamed: D4.2 (A), R5.2
unnamed: D5.2 (A), R6.2
unnamed: D6.1 (K), R15.2
unnamed: D7.1 (K), R16.2
unnamed: D8.1 (K), R17.2
unnamed: D9.1 (K), R18.2
unnamed: D10.1 (K), R19.2
unnamed: D11.1 (K), R20.2
unnamed: D12.1 (K), R21.2
unnamed: D13.1 (K), R22.2
unnamed: D14.1 (K), R23.2
unnamed: D15.1 (K), R24.2
unnamed: D16.1 (K), R25.2
unnamed: D17.1 (K), R26.2
unnamed: D18.1 (K), R27.2
unnamed: D19.1 (K), R28.2
unnamed: D20.1 (K), R29.2
unnamed: D21.1 (K), R30.2
unnamed: D22.1 (K), R31.2
unnamed: D23.1 (K), R32.2
unnamed: D24.1 (K), R33.2
unnamed: D25.1 (K), R34.2
unnamed: D26.1 (K), R35.2
unnamed: D27.1 (K), R36.2
unnamed: D28.1 (K), R37.2
unnamed: D29.1 (K), R38.2
unnamed: D30.1 (K), R1.2
unnamed: D31.1 (K), R47.2
unnamed: D32.1 (K), R48.2
unnamed: D33.1 (K), R49.2
unnamed: D34.1 (K), R50.2
unnamed: D35.1 (K), R51.2
unnamed: D36.1 (K), R52.2
unnamed: D37.1 (K), R53.2
unnamed: J5.1, R7.1
unnamed: J5.2, R8.1
unnamed: J5.3, R9.1
unnamed: J5.4, R10.1
unnamed: J5.5, R11.1
unnamed: J5.6, R12.1
unnamed: J5.7, R13.1
unnamed: J5.8, R14.1
unnamed: J7.1, R39.1, U8.2 (1A0)
unnamed: J7.2, R40.1, U8.4 (1A1)
unnamed: J7.3, R41.1, U8.6 (1A2)
unnamed: J7.4, R42.1, U8.8 (1A3)
unnamed: J7.5, R43.1, U8.17 (2A0)
unnamed: J7.6, R44.1, U8.15 (2A1)
unnamed: J7.7, R45.1, U8.13 (2A2)
unnamed: J7.8, R46.1, U8.11 (2A3)
unnamed: R7.2, U7.2 (Q0)
unnamed: R8.2, U7.5 (Q1)
unnamed: R9.2, U7.6 (Q2)
unnamed: R10.2, U7.9 (Q3)
unnamed: R11.2, U7.12 (Q4)
unnamed: R12.2, U7.15 (Q5)
unnamed: R13.2, U7.16 (Q6)
unnamed: R14.2, U7.19 (Q7)
VCC: C2.1, C3.1, C4.1, C5.1, C6.1, C7.1, C8.1, C9.1, C12.1, C13.1, C14.1, C16.1, J1.1, J1.40, J2.1, J2.40, J4.1, J6.1, J6.40, R2.1, R3.1, R4.1, R5.1, R6.1, R39.2, R40.2, R41.2, R42.2, R43.2, R44.2, R45.2, R46.2, U1.14 (VCC), U2.9, U2.10, U2.12, U2.13, U2.14 (VCC), U4.31 (~WE), U4.32 (VCC), U5.7 (VCC), U7.20 (VCC), U8.20 (VCC), U9.14 (VCC), U10.3 (I1), U10.4 (I0), U10.16 (VCC), U11.20 (VCC), U13.7 (VCC), U14.13 (A1), U14.14 (A0), U14.15 (E), U14.16 (VCC)

Notes on the sheet:
0000-7FFF ROM or RAM (selected by raml_ena in CR) 8000-EFFF RAM F000-FEFF empty FF00-FFFF IO
FF00 Keyboard FF02 Control Register
5mA each
See model/io.v and model/test/test_io.v
Keyboard (0xFF00)

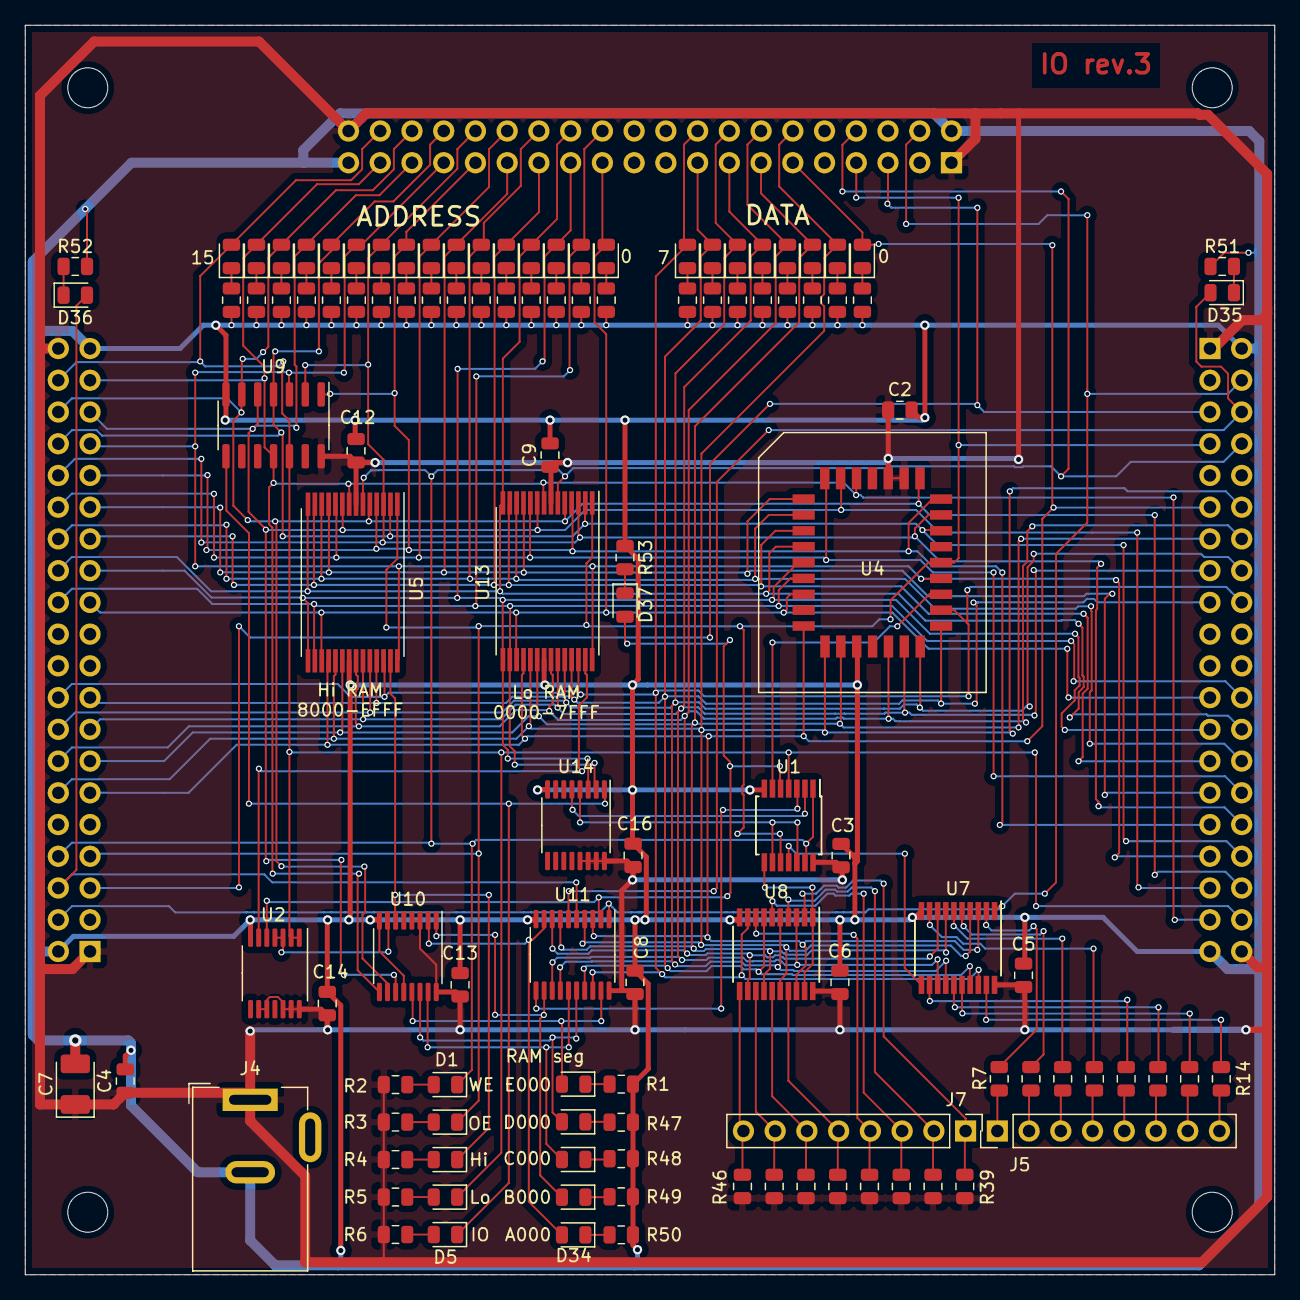
[picture p49: board io.kicad_pcb from above]

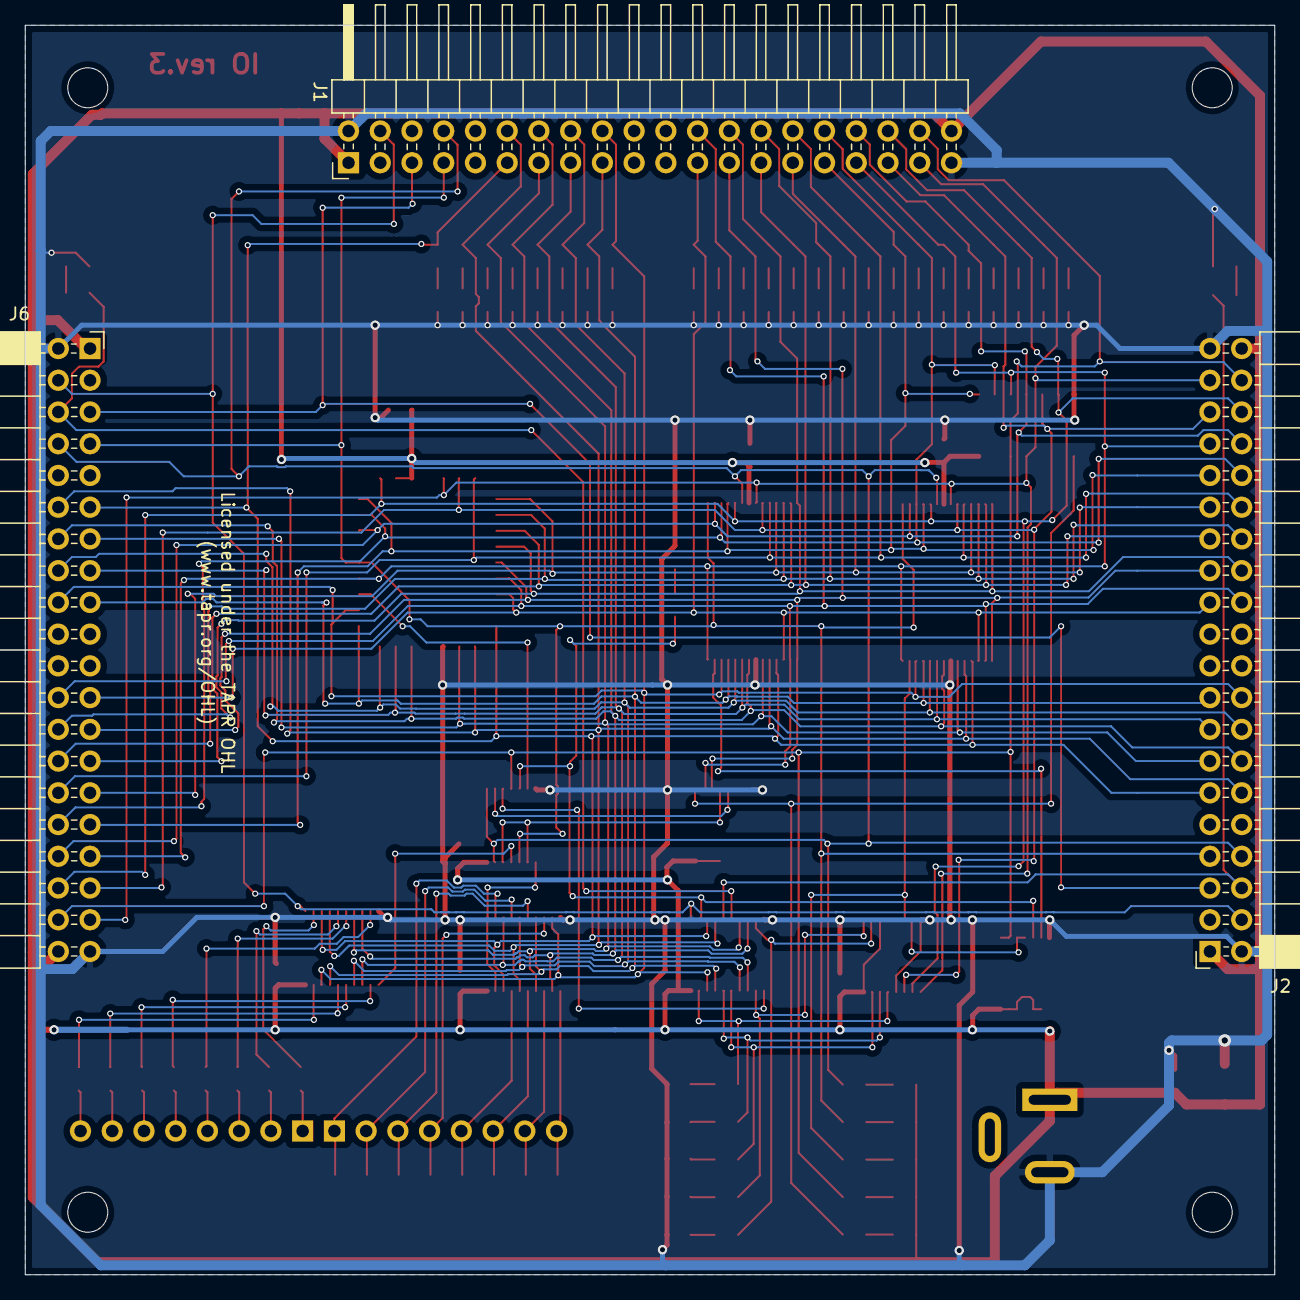
[picture p50: board io.kicad_pcb from below]

Board: 2 copper layers, 100.0 x 100.0 mm, 123 parts (3 on the bottom side), 109 nets.
