imihajlow/ccpu/boards/vga/vga.kicad_pcb

## KiCad design boards/vga/vga.kicad_pcb (2020-12-19)

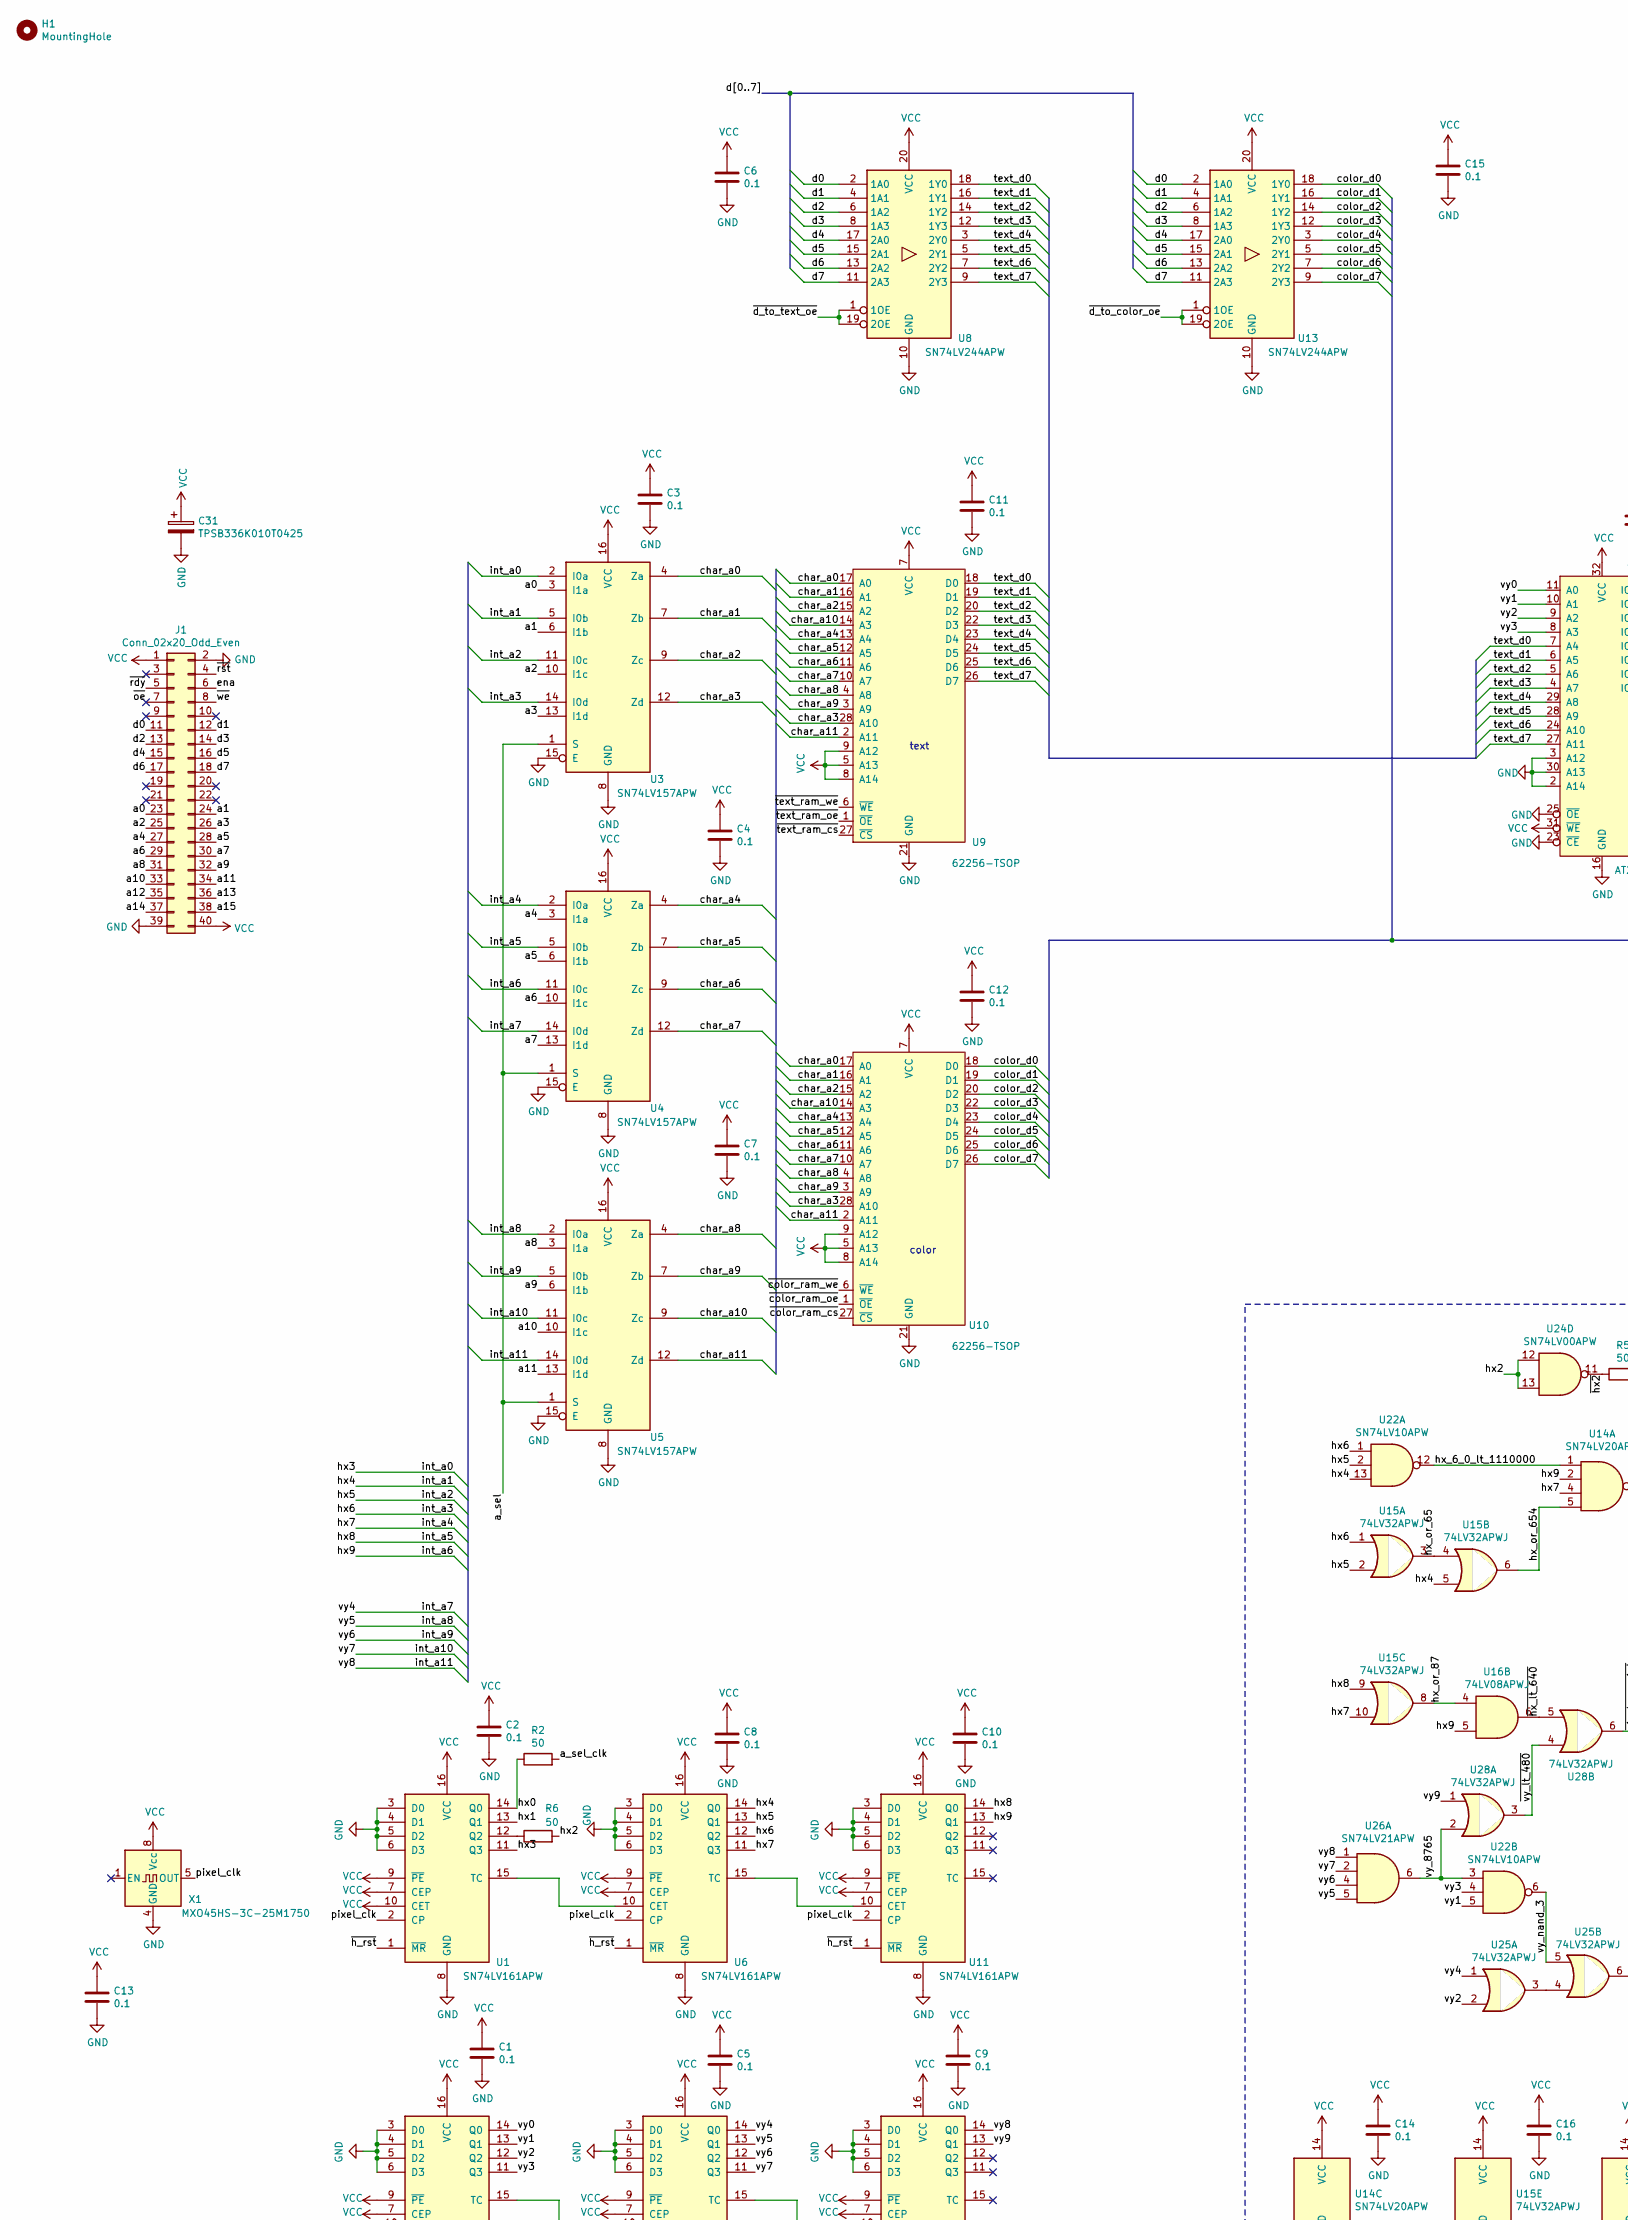
[picture p51: schematic vga.sch, VGA controller, part in row 1, column 1]

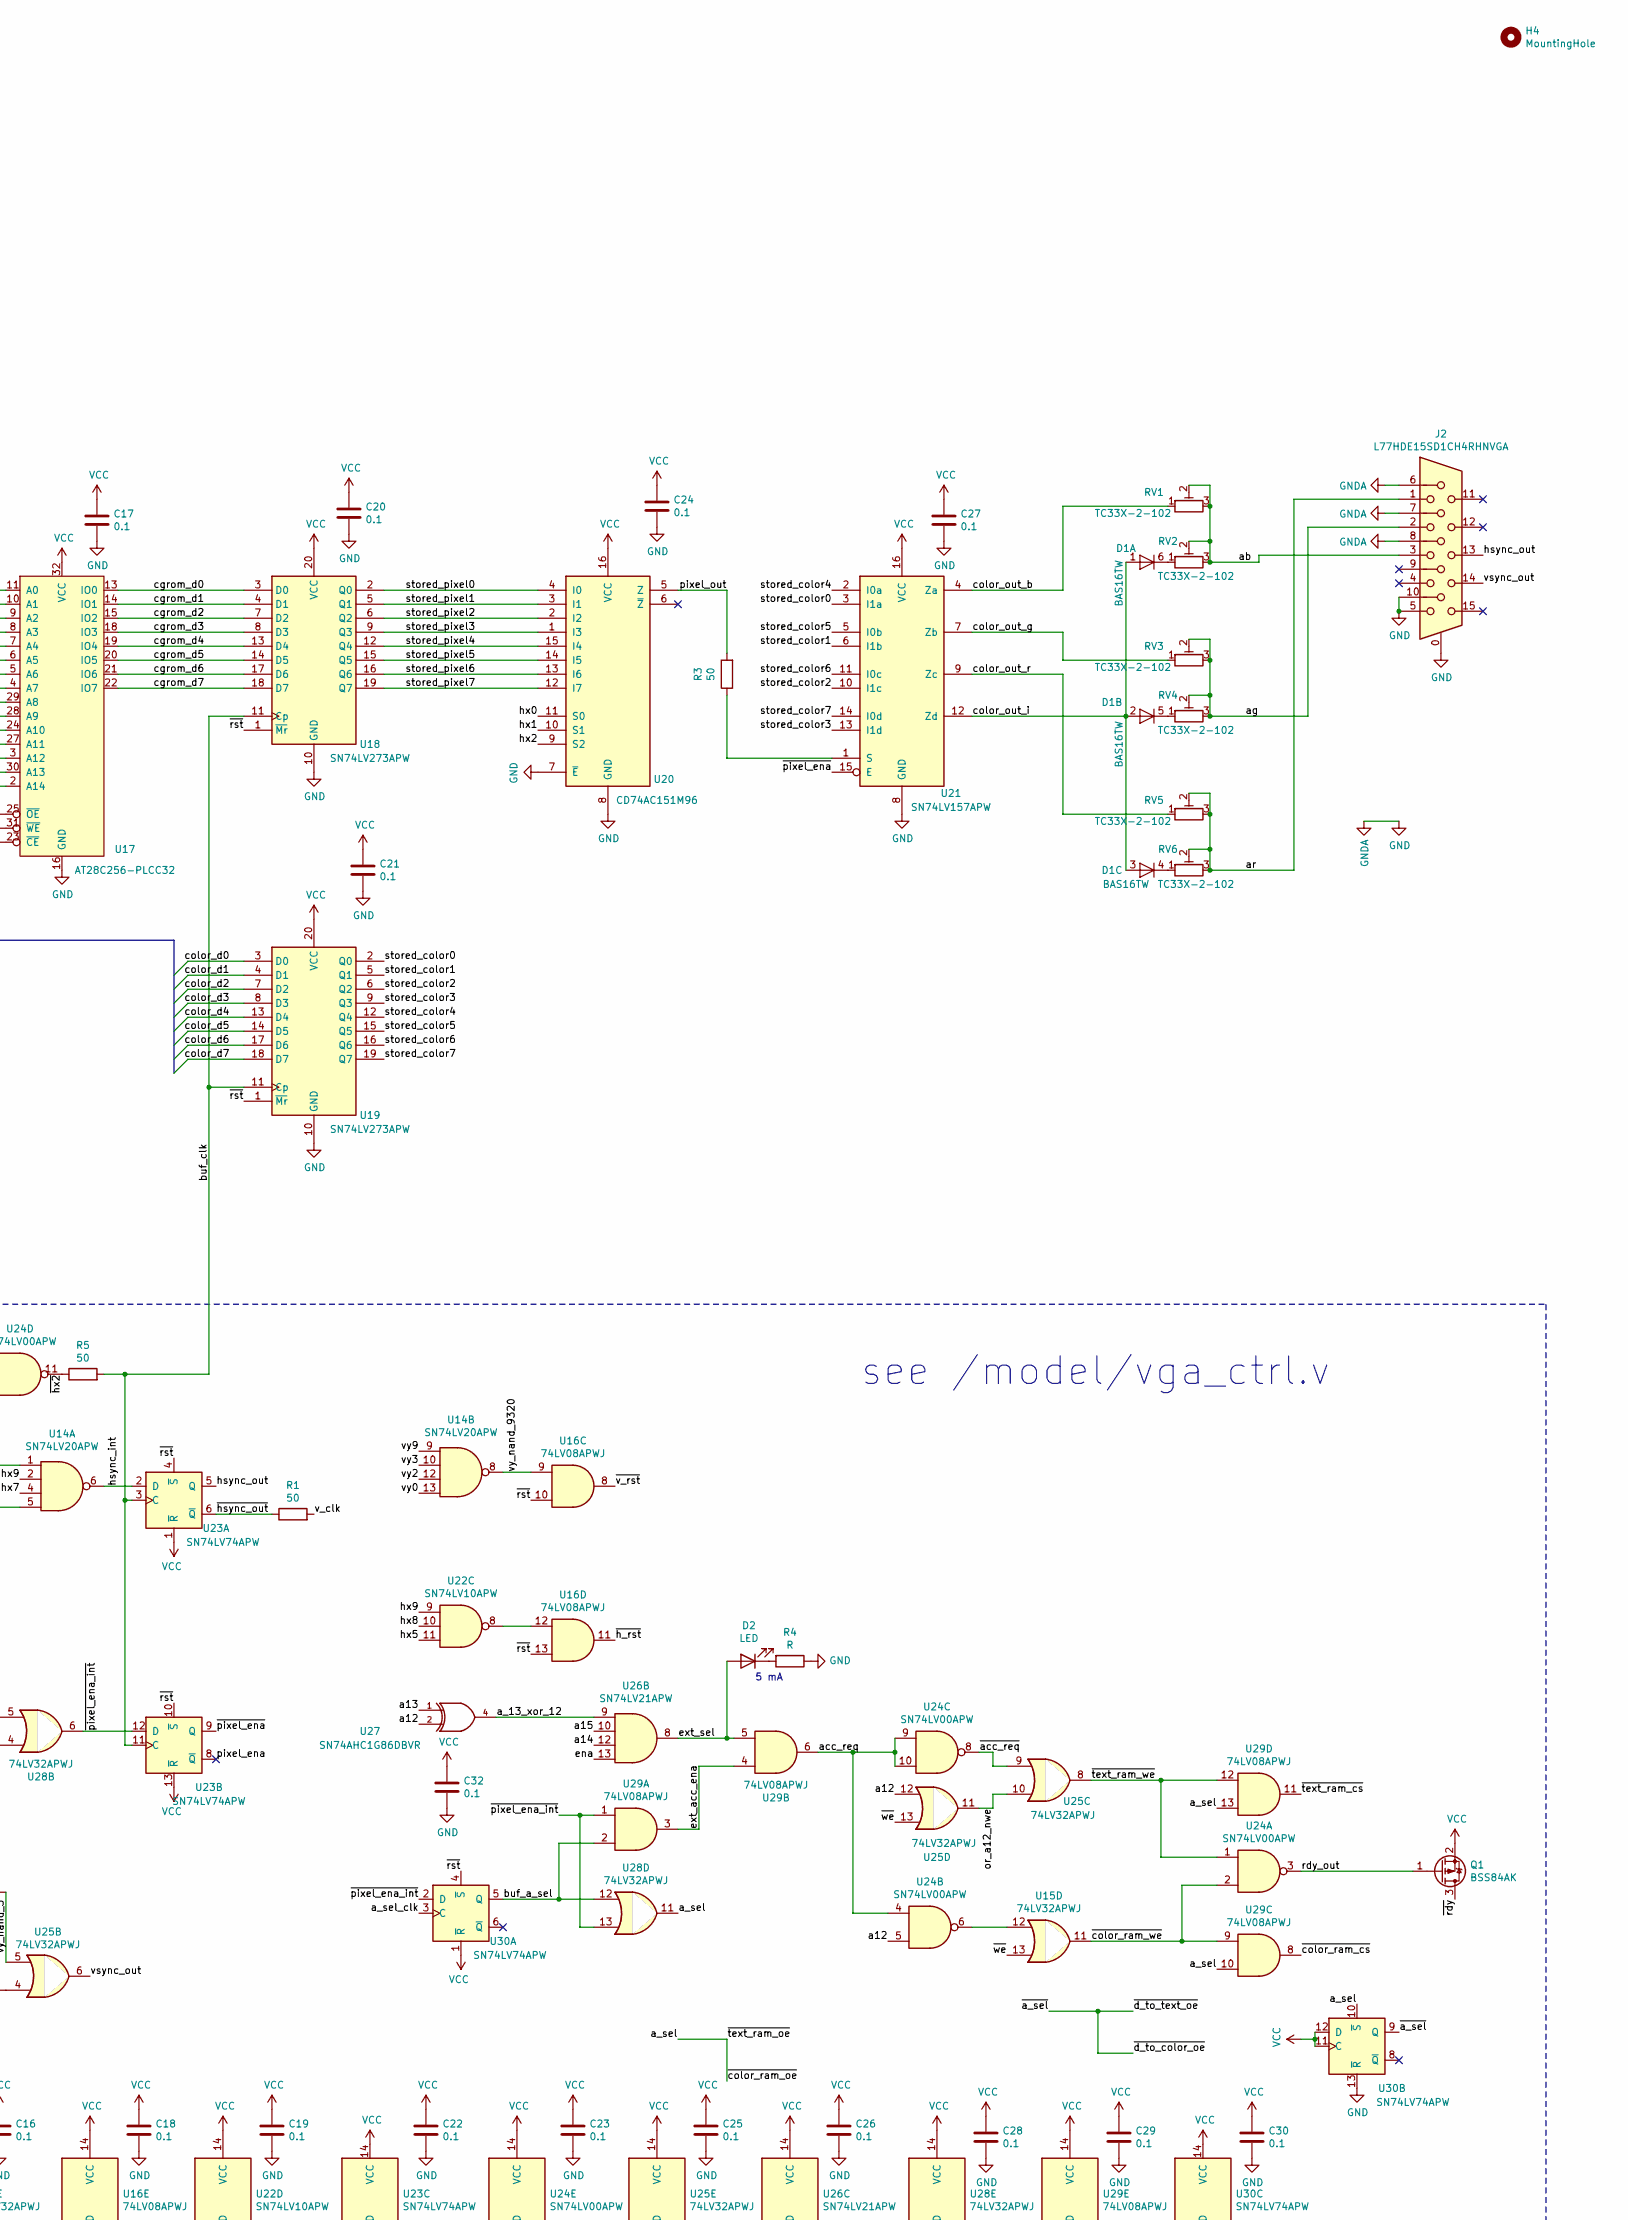
[picture p52: schematic vga.sch, VGA controller, part in row 1, column 2]

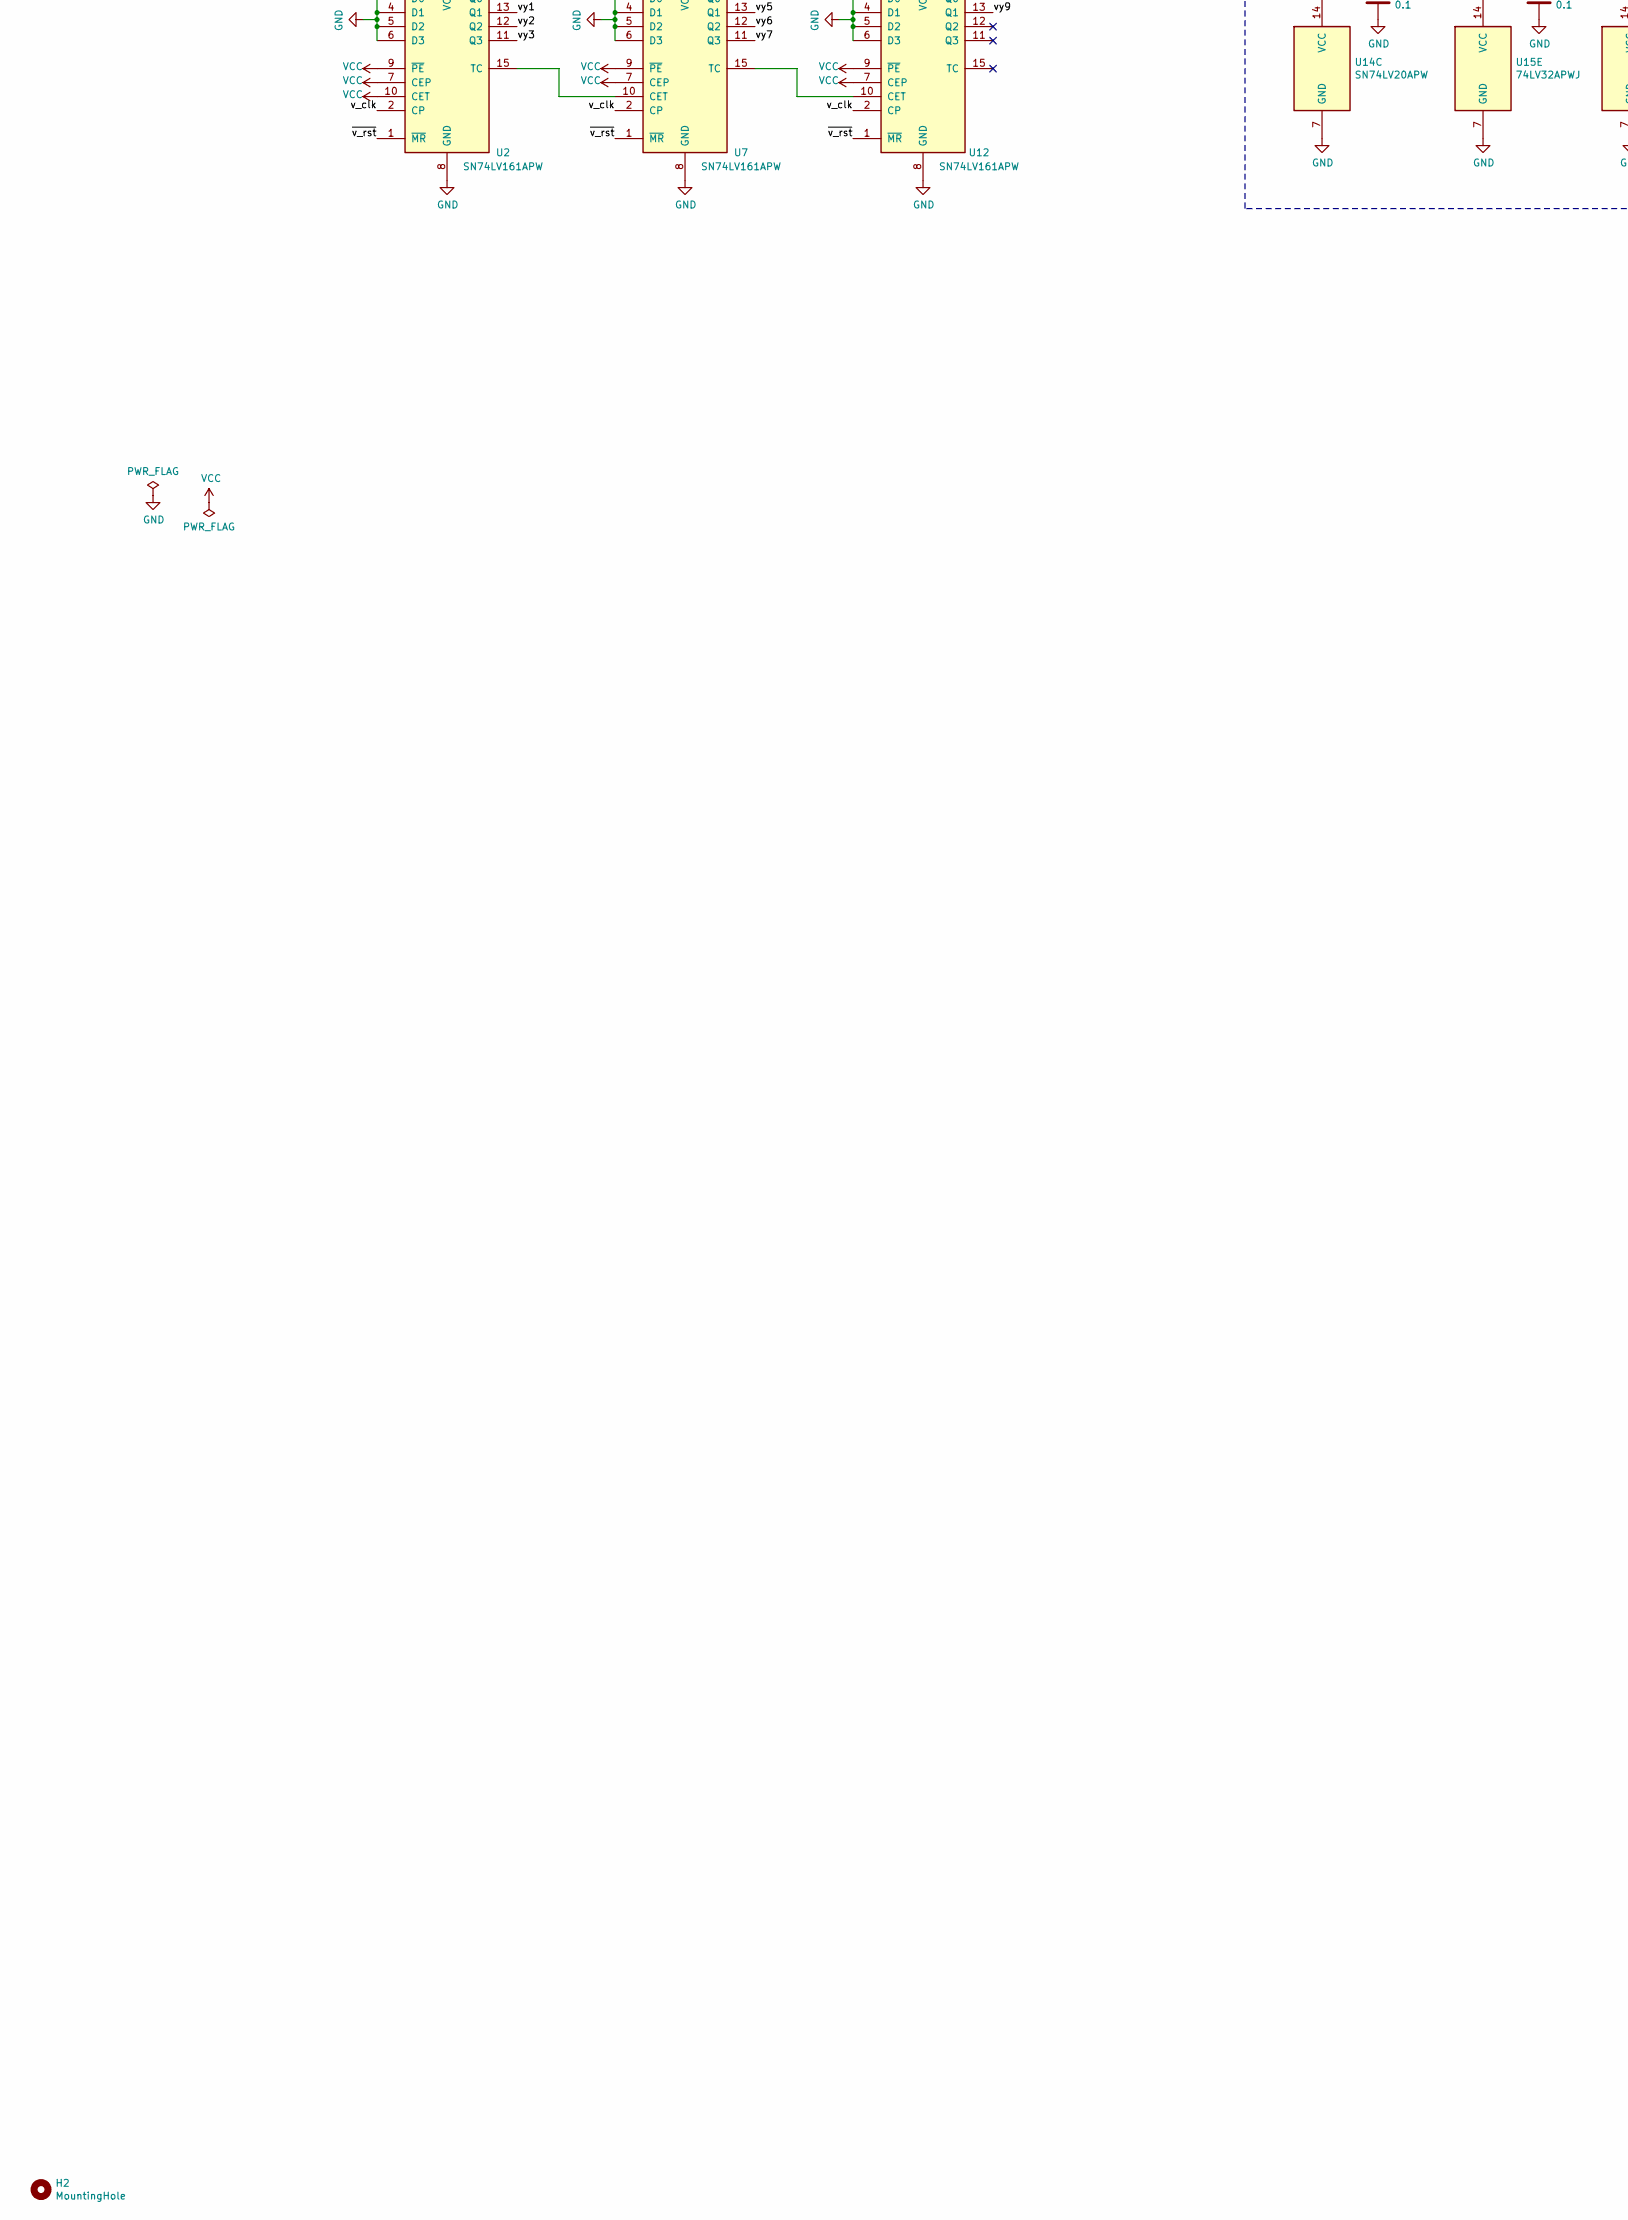
[picture p53: schematic vga.sch, VGA controller, part in row 2, column 1]

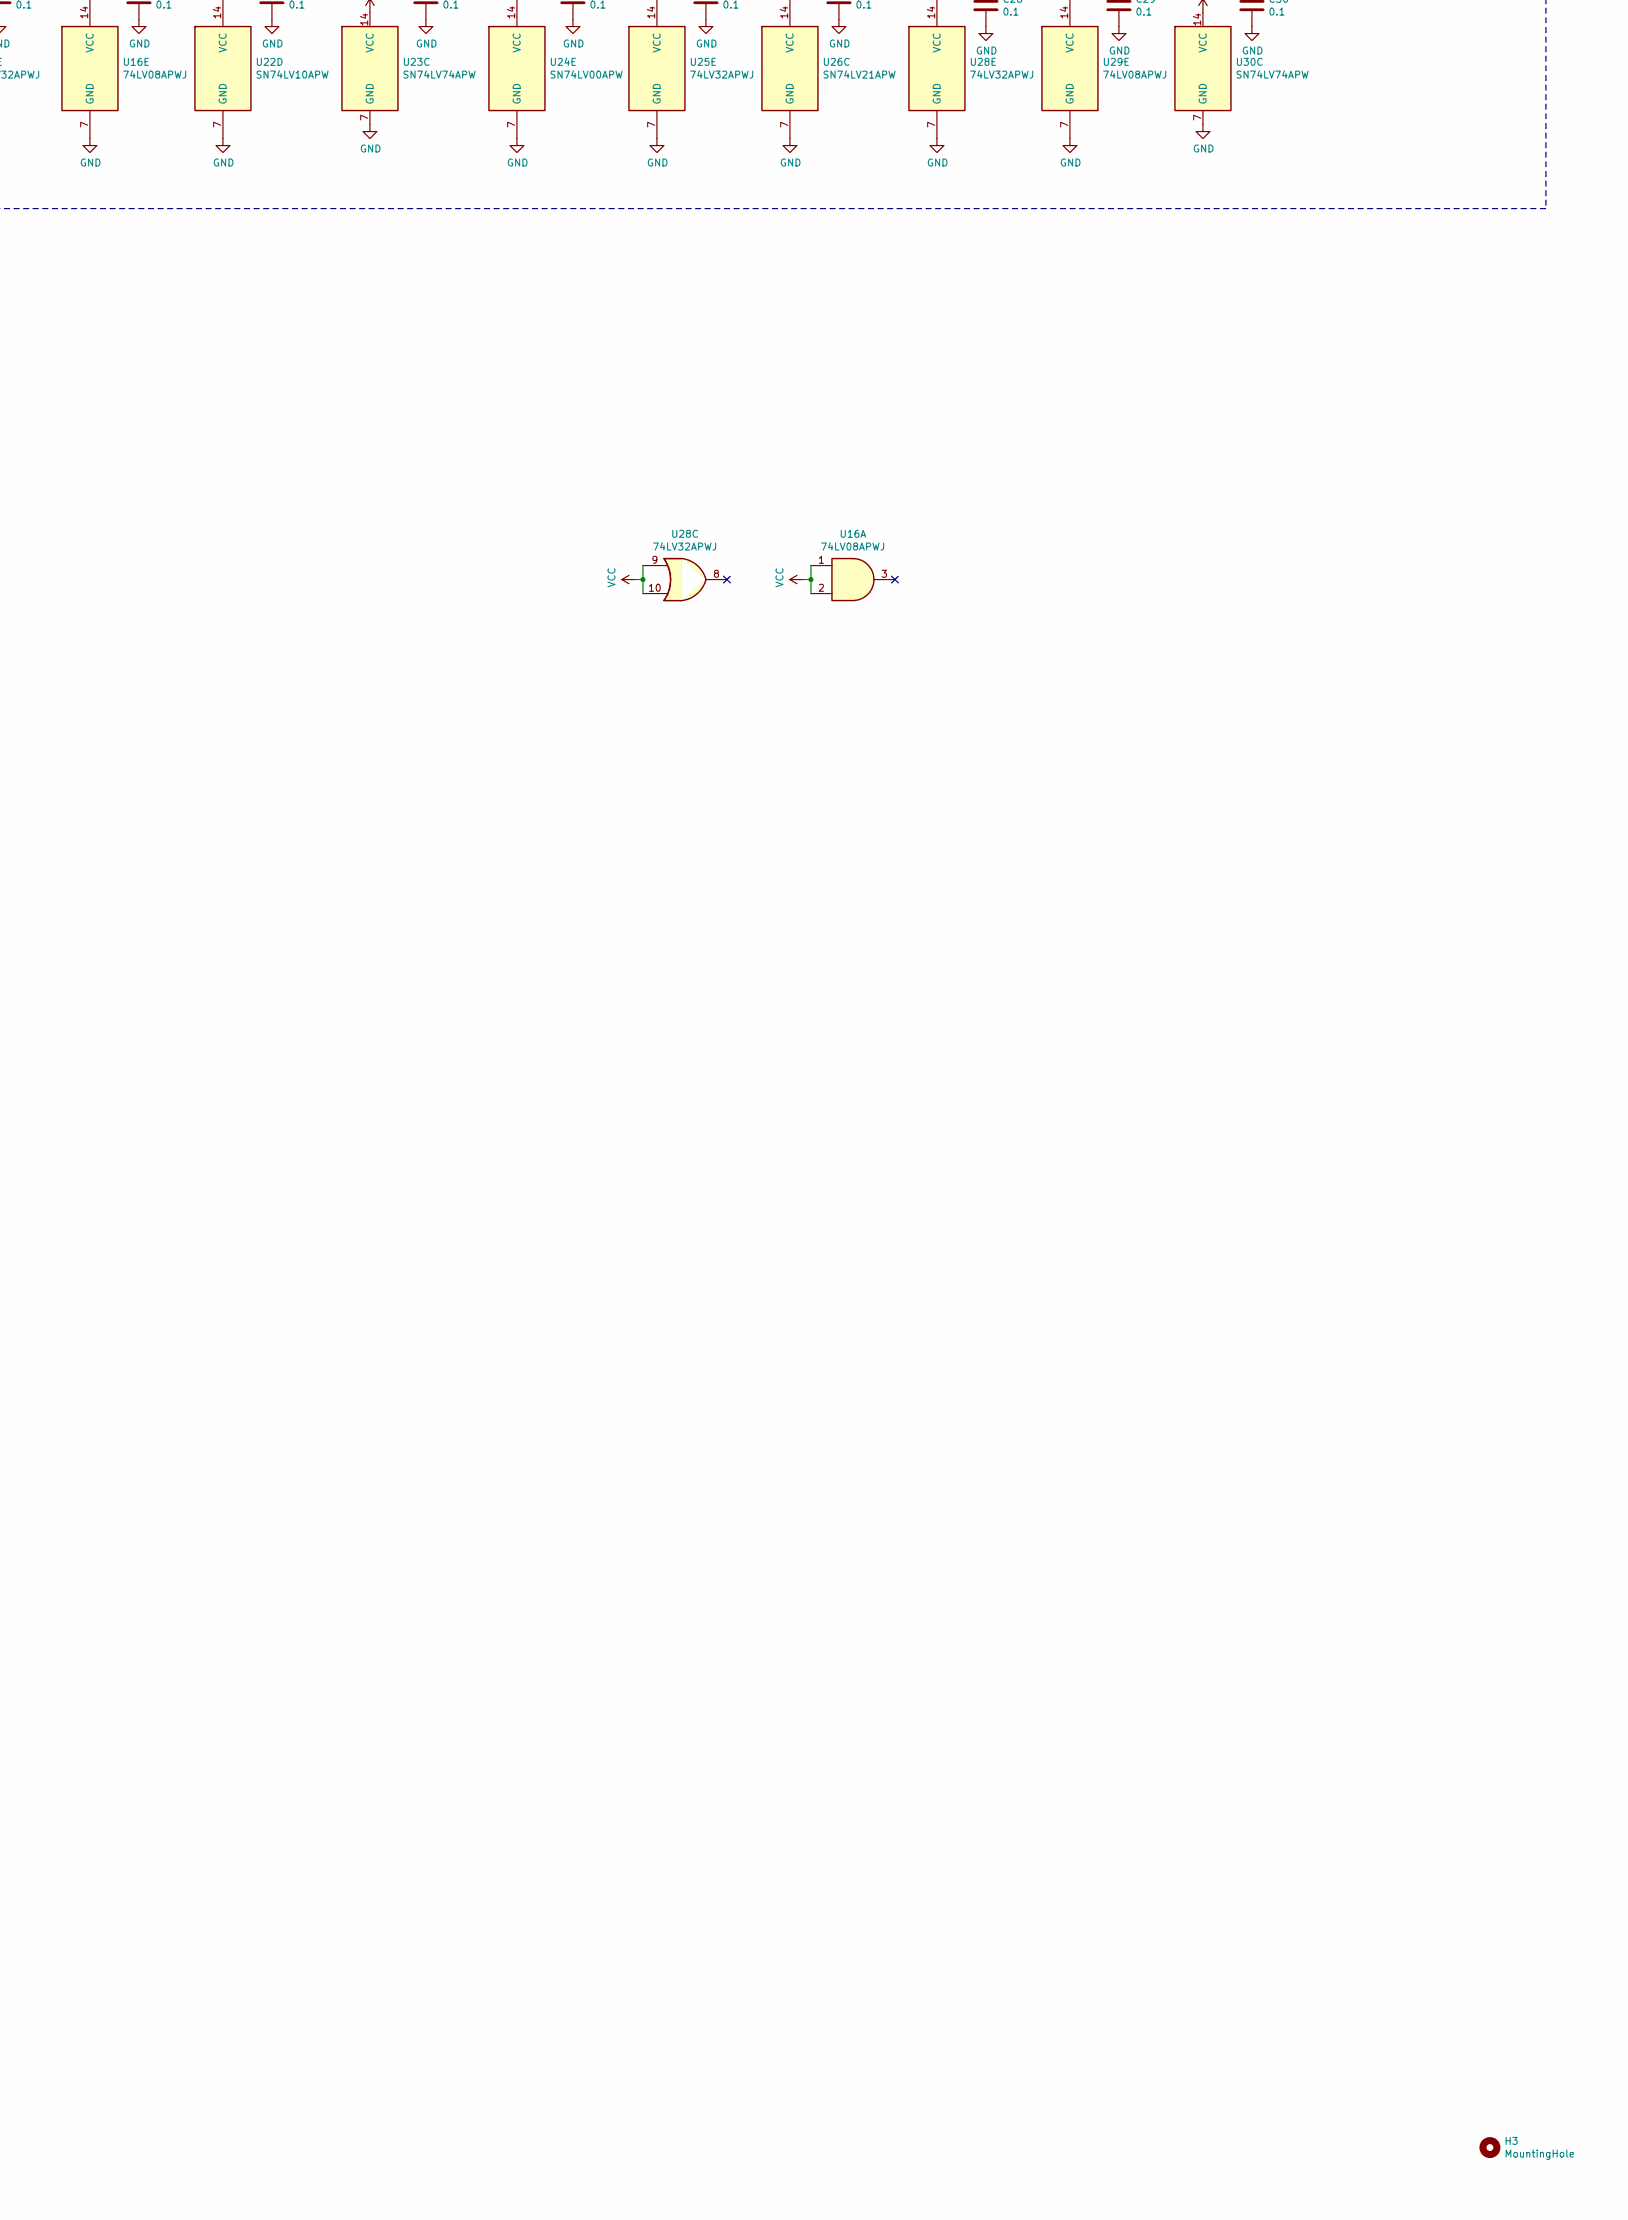
[picture p54: schematic vga.sch, VGA controller, part in row 2, column 2]

Parts:
C1, C2, C3, C4, C5, C6, C7, C8, C9, C10, C11, C12, C13, C14, C15, C16, C17, C18, C19, C20, C21, C22, C23, C24, C25, C26, C27, C28, C29, C30, C32: 0.1; C_0805_2012Metric
C31: TPSB336K010T0425; CP_EIA-3528-15_AVX-H_Pad1.50x2.35mm_HandSolder
D1: BAS16TW; SOT-363_SC-70-6
D2: LED; LED_0805_2012Metric
H1, H2, H3, H4: MountingHole; MountingHole_3.2mm_M3
J1: Conn_02x20_Odd_Even; PinHeader_2x20_P2.54mm_Horizontal
J2: L77HDE15SD1CH4RHNVGA; DSUB-15-HD_Female_Horizontal_P2.29x1.98mm_EdgePinOffset8.35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
Q1: BSS84AK; SOT-23
R1, R2, R3, R5, R6: 50; R_0805_2012Metric
R4: R; R_0805_2012Metric
RV1, RV2, RV3, RV4, RV5, RV6: TC33X-2-102; Potentiometer_Bourns_TC33X_Vertical
U1, U2, U6, U7, U11, U12: SN74LV161APW; TSSOP-16_4.4x5mm_P0.65mm
U3, U4, U5, U21: SN74LV157APW; TSSOP-16_4.4x5mm_P0.65mm
U8, U13: SN74LV244APW; TSSOP-20_4.4x6.5mm_P0.65mm
U9, U10: 62256-TSOP; TSOP-I-28_11.8x8mm_P0.55mm
U14: SN74LV20APW; TSSOP-14_4.4x5mm_P0.65mm
U15, U25, U28: 74LV32APWJ; TSSOP-14_4.4x5mm_P0.65mm
U16, U29: 74LV08APWJ; TSSOP-14_4.4x5mm_P0.65mm
U17: AT28C256-PLCC32; PLCC-32_SMD_Socket
U18, U19: SN74LV273APW; TSSOP-20_4.4x6.5mm_P0.65mm
U20: CD74AC151M96; SOIC-16_3.9x9.9mm_P1.27mm
U22: SN74LV10APW; TSSOP-14_4.4x5mm_P0.65mm
U23, U30: SN74LV74APW; TSSOP-14_4.4x5mm_P0.65mm
U24: SN74LV00APW; TSSOP-14_4.4x5mm_P0.65mm
U26: SN74LV21APW; TSSOP-14_4.4x5mm_P0.65mm
U27: SN74AHC1G86DBVR; SOT-23-5
X1: MXO45HS-3C-25M1750; Oscillator_DIP-8

Connections:
/a0: J1.23, U3.3 (I1a)
/a1: J1.24, U3.6 (I1b)
/a2: J1.25, U3.10 (I1c)
/a3: J1.26, U3.13 (I1d)
/a4: J1.27, U4.3 (I1a)
/a5: J1.28, U4.6 (I1b)
/a6: J1.29, U4.10 (I1c)
/a7: J1.30, U4.13 (I1d)
/a8: J1.31, U5.3 (I1a)
/a9: J1.32, U5.6 (I1b)
/a10: J1.33, U5.10 (I1c)
/a11: J1.34, U5.13 (I1d)
/a12: J1.35, U24.5, U25.12, U27.2
/a13: J1.36, U27.1
/a14: J1.37, U26.12
/a15: J1.38, U26.10
/a_13_xor_12: U26.9, U27.4
/a_sel: U3.1 (S), U4.1 (S), U5.1 (S), U9.1 (~OE), U10.1 (~OE), U28.11, U29.10, U29.13, U30.10 (~S)
/a_sel_clk: R2.2, U30.3 (C)
/ab: J2.3, RV1.2, RV1.3, RV2.2, RV2.3
/acc_req: U24.4, U24.9, U24.10, U29.6
/ag: J2.2, RV3.2, RV3.3, RV4.2, RV4.3
/ar: J2.1, RV5.2, RV5.3, RV6.2, RV6.3
/buf_a_sel: U28.12, U29.2, U30.5 (Q)
/buf_clk: R5.2, U18.11 (Cp), U19.11 (Cp), U23.3 (C), U23.11 (C)
/cgrom_d0: U17.13 (IO0), U18.3 (D0)
/cgrom_d1: U17.14 (IO1), U18.4 (D1)
/cgrom_d2: U17.15 (IO2), U18.7 (D2)
/cgrom_d3: U17.18 (IO3), U18.8 (D3)
/cgrom_d4: U17.19 (IO4), U18.13 (D4)
/cgrom_d5: U17.20 (IO5), U18.14 (D5)
/cgrom_d6: U17.21 (IO6), U18.17 (D6)
/cgrom_d7: U17.22 (IO7), U18.18 (D7)
/char_a0: U3.4 (Za), U9.17 (A0), U10.17 (A0)
/char_a1: U3.7 (Zb), U9.16 (A1), U10.16 (A1)
/char_a2: U3.9 (Zc), U9.15 (A2), U10.15 (A2)
/char_a3: U3.12 (Zd), U9.28 (A10), U10.28 (A10)
/char_a4: U4.4 (Za), U9.13 (A4), U10.13 (A4)
/char_a5: U4.7 (Zb), U9.12 (A5), U10.12 (A5)
/char_a6: U4.9 (Zc), U9.11 (A6), U10.11 (A6)
/char_a7: U4.12 (Zd), U9.10 (A7), U10.10 (A7)
/char_a8: U5.4 (Za), U9.4 (A8), U10.4 (A8)
/char_a9: U5.7 (Zb), U9.3 (A9), U10.3 (A9)
/char_a10: U5.9 (Zc), U9.14 (A3), U10.14 (A3)
/char_a11: U5.12 (Zd), U9.2 (A11), U10.2 (A11)
/color_d0: U10.18 (D0), U13.18 (1Y0), U19.3 (D0)
/color_d1: U10.19 (D1), U13.16 (1Y1), U19.4 (D1)
/color_d2: U10.20 (D2), U13.14 (1Y2), U19.7 (D2)
/color_d3: U10.22 (D3), U13.12 (1Y3), U19.8 (D3)
/color_d4: U10.23 (D4), U13.3 (2Y0), U19.13 (D4)
/color_d5: U10.24 (D5), U13.5 (2Y1), U19.14 (D5)
/color_d6: U10.25 (D6), U13.7 (2Y2), U19.17 (D6)
/color_d7: U10.26 (D7), U13.9 (2Y3), U19.18 (D7)
/color_out_b: RV1.1, U21.4 (Za)
/color_out_g: RV3.1, U21.7 (Zb)
/color_out_i: D1.1 (A), D1.2 (A), D1.3 (A), U21.12 (Zd)
/color_out_r: RV5.1, U21.9 (Zc)
/d0: J1.11, U8.2 (1A0), U13.2 (1A0)
/d1: J1.12, U8.4 (1A1), U13.4 (1A1)
/d2: J1.13, U8.6 (1A2), U13.6 (1A2)
/d3: J1.14, U8.8 (1A3), U13.8 (1A3)
/d4: J1.15, U8.17 (2A0), U13.17 (2A0)
/d5: J1.16, U8.15 (2A1), U13.15 (2A1)
/d6: J1.17, U8.13 (2A2), U13.13 (2A2)
/d7: J1.18, U8.11 (2A3), U13.11 (2A3)
/ena: J1.6, U26.13
/ext_acc_ena: U29.3, U29.4
/ext_sel: D2.2 (A), U26.8, U29.5
/hsync_int: U14.6, U23.2 (D)
/hsync_out: J2.13, U23.5 (Q)
/hx0: R2.1, U1.14 (Q0), U20.11 (S0)
/hx1: U1.13 (Q1), U20.10 (S1)
/hx2: R6.2, U20.9 (S2), U24.12, U24.13
/hx3: U1.11 (Q3), U3.2 (I0a)
/hx4: U3.5 (I0b), U6.14 (Q0), U15.5, U22.13
/hx5: U3.11 (I0c), U6.13 (Q1), U15.2, U22.2, U22.11
/hx6: U3.14 (I0d), U6.12 (Q2), U15.1, U22.1
/hx7: U4.2 (I0a), U6.11 (Q3), U14.4, U15.10
/hx8: U4.5 (I0b), U11.14 (Q0), U15.9, U22.10
/hx9: U4.11 (I0c), U11.13 (Q1), U14.2, U16.5, U22.9
/hx_6_0_lt_1110000: U14.1, U22.12
/hx_or_65: U15.3, U15.4
/hx_or_87: U15.8, U16.4
/hx_or_654: U14.5, U15.6
/int_a7: U4.14 (I0d), U7.14 (Q0), U25.1
/int_a8: U5.2 (I0a), U7.13 (Q1), U26.5
/int_a9: U5.5 (I0b), U7.12 (Q2), U26.4
/int_a10: U5.11 (I0c), U7.11 (Q3), U26.2
/int_a11: U5.14 (I0d), U12.14 (Q0), U26.1
/or_a12_nwe: U25.10, U25.11
/pixel_clk: U1.2 (CP), U6.2 (CP), U11.2 (CP), X1.5 (OUT)
/pixel_out: R3.2, U20.5 (Z)
/rdy_out: Q1.1 (G), U24.3
/stored_color0: U19.2 (Q0), U21.3 (I1a)
/stored_color1: U19.5 (Q1), U21.6 (I1b)
/stored_color2: U19.6 (Q2), U21.10 (I1c)
/stored_color3: U19.9 (Q3), U21.13 (I1d)
/stored_color4: U19.12 (Q4), U21.2 (I0a)
/stored_color5: U19.15 (Q5), U21.5 (I0b)
/stored_color6: U19.16 (Q6), U21.11 (I0c)
/stored_color7: U19.19 (Q7), U21.14 (I0d)
/stored_pixel0: U18.2 (Q0), U20.4 (I0)
/stored_pixel1: U18.5 (Q1), U20.3 (I1)
/stored_pixel2: U18.6 (Q2), U20.2 (I2)
/stored_pixel3: U18.9 (Q3), U20.1 (I3)
/stored_pixel4: U18.12 (Q4), U20.15 (I4)
/stored_pixel5: U18.15 (Q5), U20.14 (I5)
/stored_pixel6: U18.16 (Q6), U20.13 (I6)
/stored_pixel7: U18.19 (Q7), U20.12 (I7)
/text_d0: U8.18 (1Y0), U9.18 (D0), U17.7 (A4)
/text_d1: U8.16 (1Y1), U9.19 (D1), U17.6 (A5)
/text_d2: U8.14 (1Y2), U9.20 (D2), U17.5 (A6)
/text_d3: U8.12 (1Y3), U9.22 (D3), U17.4 (A7)
/text_d4: U8.3 (2Y0), U9.23 (D4), U17.29 (A8)
/text_d5: U8.5 (2Y1), U9.24 (D5), U17.28 (A9)
/text_d6: U8.7 (2Y2), U9.25 (D6), U17.24 (A10)
/text_d7: U8.9 (2Y3), U9.26 (D7), U17.27 (A11)
/v_clk: R1.2, U2.2 (CP), U7.2 (CP), U12.2 (CP)
/vsync_out: J2.14, U25.6
/vy0: U2.14 (Q0), U14.13, U17.11 (A0)
/vy1: U2.13 (Q1), U17.10 (A1), U22.5
/vy2: U2.12 (Q2), U14.12, U17.9 (A2), U25.2
/vy3: U2.11 (Q3), U14.10, U17.8 (A3), U22.4
/vy9: U12.13 (Q1), U14.9, U28.1
/vy_8765: U22.3, U26.6, U28.2
/vy_nand_3: U22.6, U25.5
/vy_nand_9320: U14.8, U16.9
/~a_sel: U8.1 (1OE), U8.19 (2OE), U13.1 (1OE), U13.19 (2OE), U30.9 (Q)
/~acc_req: U24.8, U25.9
/~color_ram_cs: U10.27 (~CS), U29.8
/~color_ram_we: U10.6 (~WE), U15.11, U24.2, U29.9
/~h_rst: U1.1 (~MR), U6.1 (~MR), U11.1 (~MR), U16.11
/~hsync_out: R1.1, U23.6 (~Q)
/~hx2: R5.1, U24.11
/~hx_lt_640: U16.6, U28.5
/~pixel_ena: U21.15 (E), U23.9 (Q)
/~pixel_ena_int: U23.12 (D), U28.6, U28.13, U29.1, U30.2 (D)
/~rdy: J1.5, Q1.3 (D)
/~rst: J1.4, U16.10, U16.13, U18.1 (~Mr), U19.1 (~Mr), U23.4 (~S), U23.10 (~S), U30.4 (~S)
/~text_ram_cs: U9.27 (~CS), U29.11
/~text_ram_we: U9.6 (~WE), U24.1, U25.8, U29.12
/~v_rst: U2.1 (~MR), U7.1 (~MR), U12.1 (~MR), U16.8
/~vy_lt_480: U28.3, U28.4
/~we: J1.8, U15.13, U25.13
GND: C1.2, C2.2, C3.2, C4.2, C5.2, C6.2, C7.2, C8.2, C9.2, C10.2, C11.2, C12.2, C13.2, C14.2, C15.2, C16.2, C17.2, C18.2, C19.2, C20.2, C21.2, C22.2, C23.2, C24.2, C25.2, C26.2, C27.2, C28.2, C29.2, C30.2, C31.2, C32.2, J1.2, J1.39, J2.0, J2.5, J2.6, J2.7, J2.8, J2.10, R4.1, U1.3 (D0), U1.4 (D1), U1.5 (D2), U1.6 (D3), U1.8 (GND), U2.3 (D0), U2.4 (D1), U2.5 (D2), U2.6 (D3), U2.8 (GND), U3.8 (GND), U3.15 (E), U4.8 (GND), U4.15 (E), U5.8 (GND), U5.15 (E), U6.3 (D0), U6.4 (D1), U6.5 (D2), U6.6 (D3), U6.8 (GND), U7.3 (D0), U7.4 (D1), U7.5 (D2), U7.6 (D3), U7.8 (GND), U8.10 (GND), U9.21 (GND), U10.21 (GND), U11.3 (D0), U11.4 (D1), U11.5 (D2), U11.6 (D3), U11.8 (GND), U12.3 (D0), U12.4 (D1), U12.5 (D2), U12.6 (D3), U12.8 (GND), U13.10 (GND), U14.7 (GND), U15.7 (GND), U16.7 (GND), U17.2 (A14), U17.3 (A12), U17.16 (GND), U17.23 (~CE), U17.25 (~OE), U17.30 (A13), U18.10 (GND), U19.10 (GND), U20.7 (~E), U20.8 (GND), U21.8 (GND), U22.7 (GND), U23.7 (GND), U24.7 (GND), U25.7 (GND), U26.7 (GND), U27.3 (GND), U28.7 (GND), U29.7 (GND), U30.7 (GND), U30.13 (~R), X1.4 (GND)
unnamed: D1.4 (K), RV6.1
unnamed: D1.5 (K), RV4.1
unnamed: D1.6 (K), RV2.1
unnamed: D2.1 (K), R4.2
unnamed: R3.1, U21.1 (S)
unnamed: R6.1, U1.12 (Q2)
unnamed: U1.15 (TC), U6.10 (CET)
unnamed: U2.15 (TC), U7.10 (CET)
unnamed: U6.15 (TC), U11.10 (CET)
unnamed: U7.15 (TC), U12.10 (CET)
unnamed: U15.12, U24.6
unnamed: U16.12, U22.8
unnamed: U25.3, U25.4
VCC: C1.1, C2.1, C3.1, C4.1, C5.1, C6.1, C7.1, C8.1, C9.1, C10.1, C11.1, C12.1, C13.1, C14.1, C15.1, C16.1, C17.1, C18.1, C19.1, C20.1, C21.1, C22.1, C23.1, C24.1, C25.1, C26.1, C27.1, C28.1, C29.1, C30.1, C31.1, C32.1, J1.1, J1.40, Q1.2 (S), U1.7 (CEP), U1.9 (~PE), U1.10 (CET), U1.16 (VCC), U2.7 (CEP), U2.9 (~PE), U2.10 (CET), U2.16 (VCC), U3.16 (VCC), U4.16 (VCC), U5.16 (VCC), U6.7 (CEP), U6.9 (~PE), U6.16 (VCC), U7.7 (CEP), U7.9 (~PE), U7.16 (VCC), U8.20 (VCC), U9.5 (A13), U9.7 (VCC), U9.8 (A14), U9.9 (A12), U10.5 (A13), U10.7 (VCC), U10.8 (A14), U10.9 (A12), U11.7 (CEP), U11.9 (~PE), U11.16 (VCC), U12.7 (CEP), U12.9 (~PE), U12.16 (VCC), U13.20 (VCC), U14.14 (VCC), U15.14 (VCC), U16.1, U16.2, U16.14 (VCC), U17.31 (~WE), U17.32 (VCC), U18.20 (VCC), U19.20 (VCC), U20.16 (VCC), U21.16 (VCC), U22.14 (VCC), U23.1 (~R), U23.13 (~R), U23.14 (VCC), U24.14 (VCC), U25.14 (VCC), U26.14 (VCC), U27.5 (VCC), U28.9, U28.10, U28.14 (VCC), U29.14 (VCC), U30.1 (~R), U30.11 (C), U30.12 (D), U30.14 (VCC), X1.8 (Vcc)

Notes on the sheet:
text
color
see /model/vga_ctrl.v
5 mA
