imihajlow/ccpu/boards/vga/vga.kicad_pcb

## KiCad design boards/vga/vga.kicad_pcb (continued)

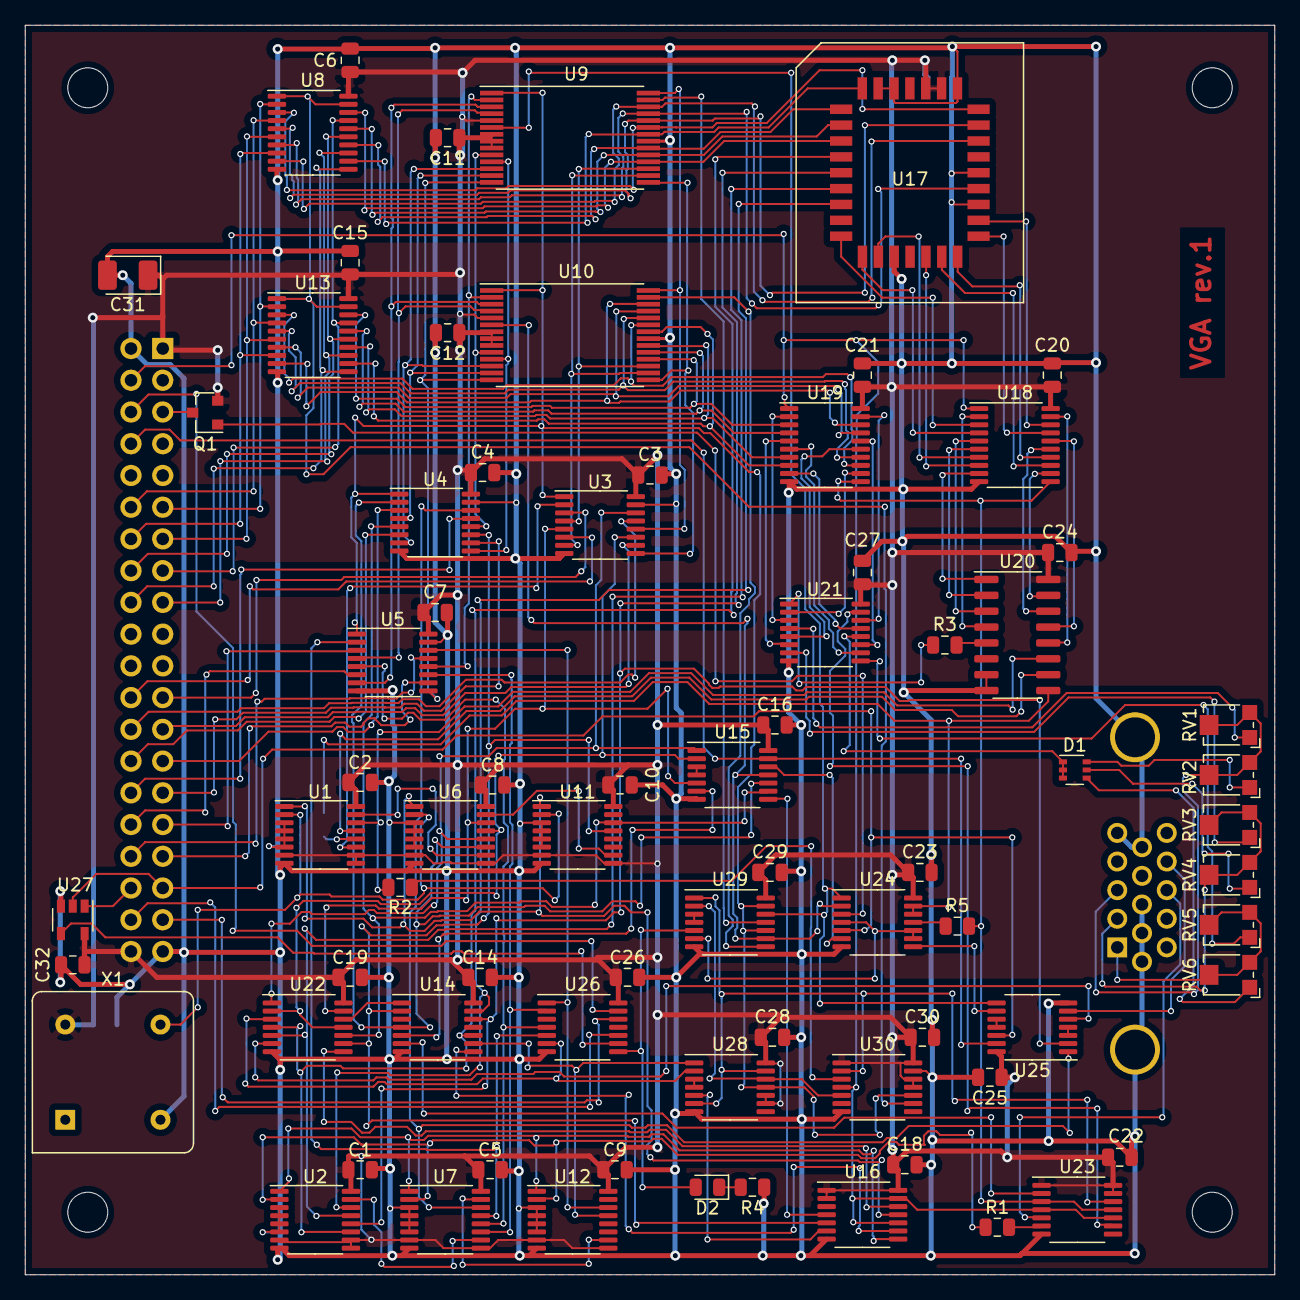
[picture p55: board vga.kicad_pcb from above]

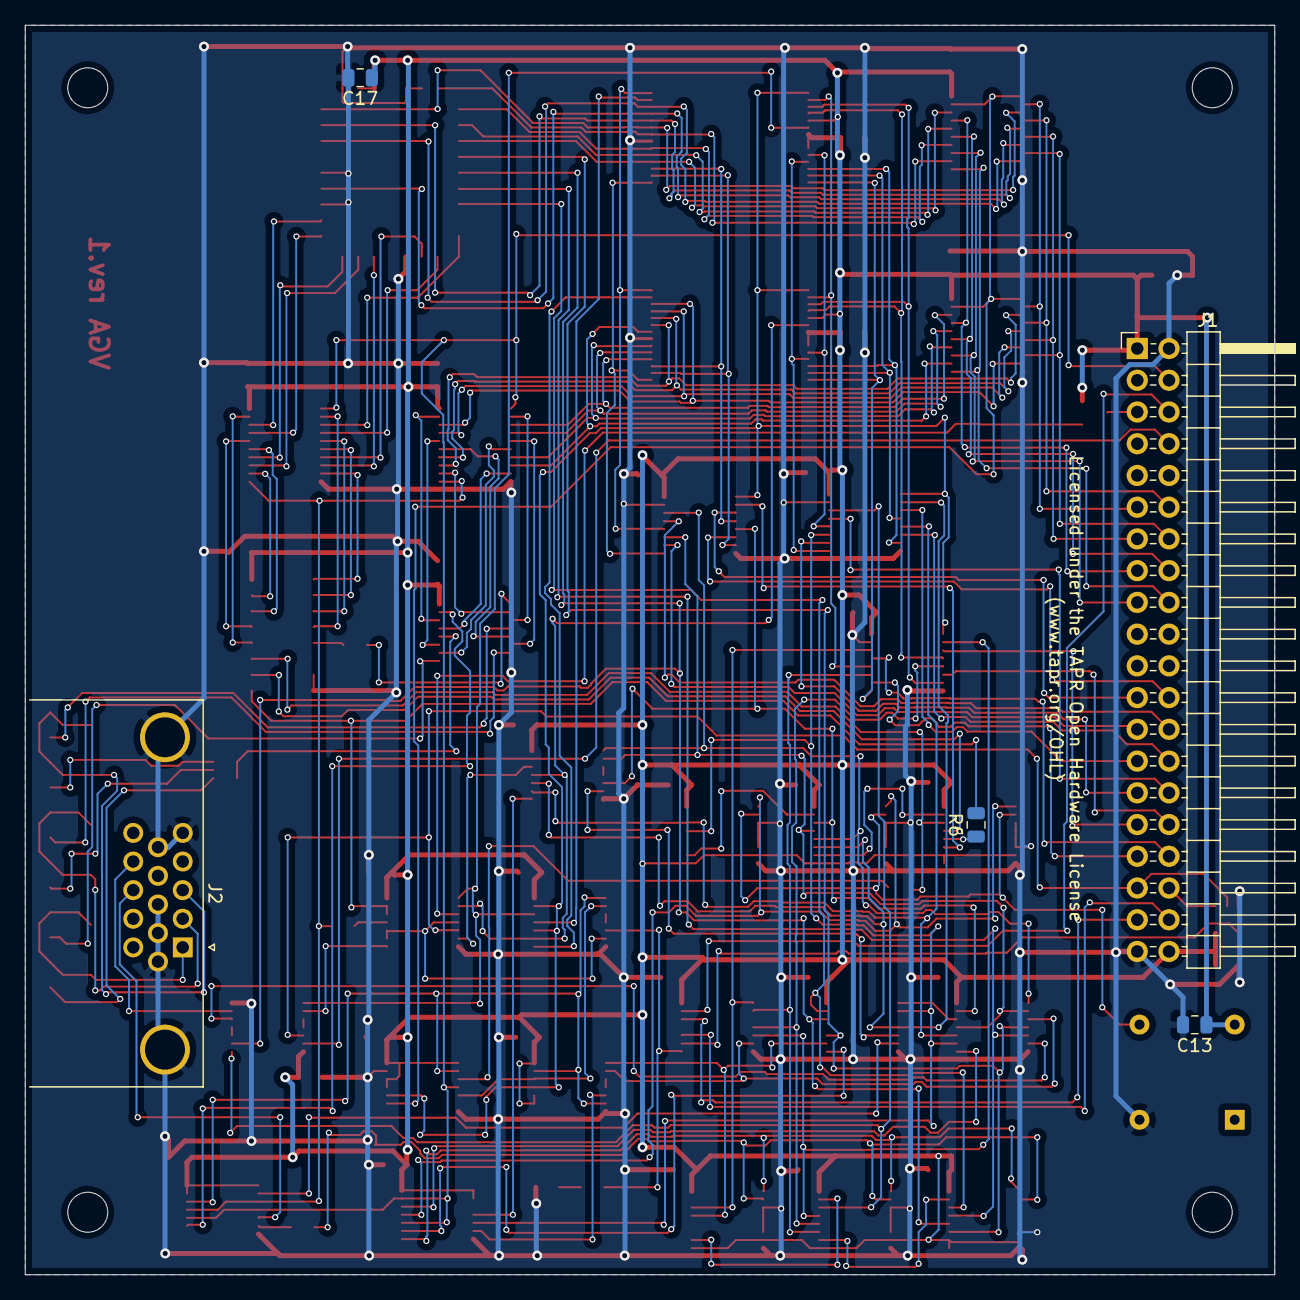
[picture p56: board vga.kicad_pcb from below]

Board: 2 copper layers, 100.0 x 100.0 mm, 84 parts (5 on the bottom side), 159 nets.
