imihajlow/ccpu/boards/control/control.kicad_pcb

## KiCad design boards/control/control.kicad_pcb (2020-12-19)

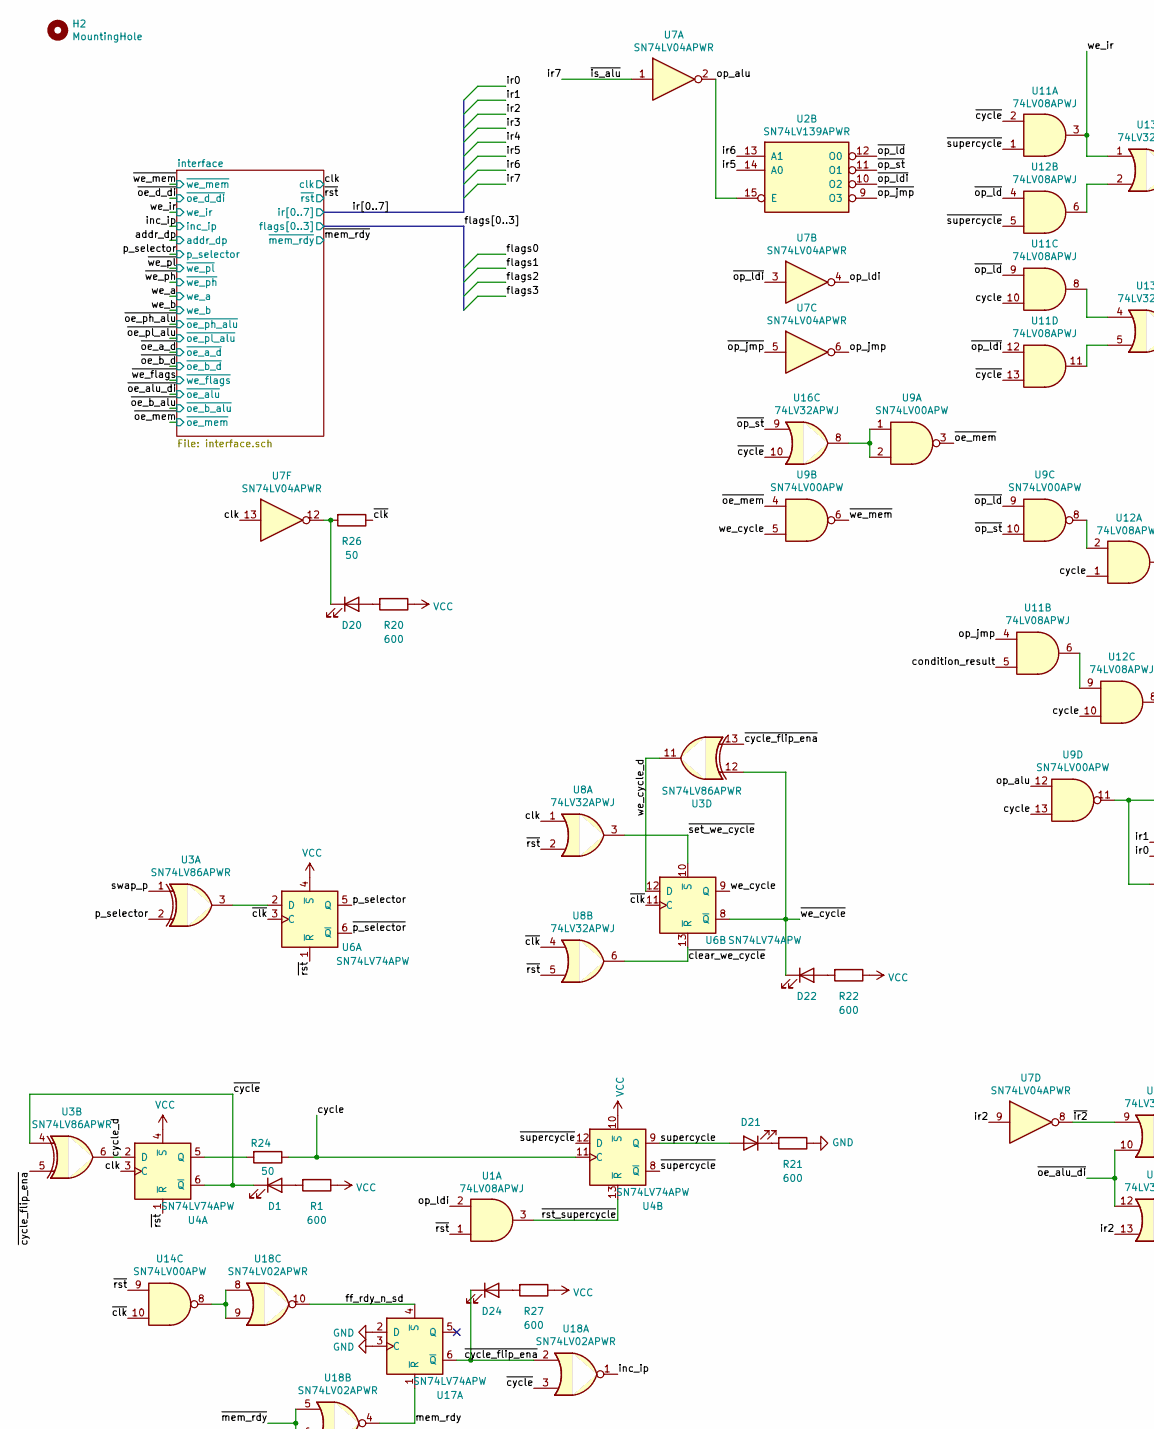
[picture p57: schematic control.sch, Control unit, part in row 1, column 1]

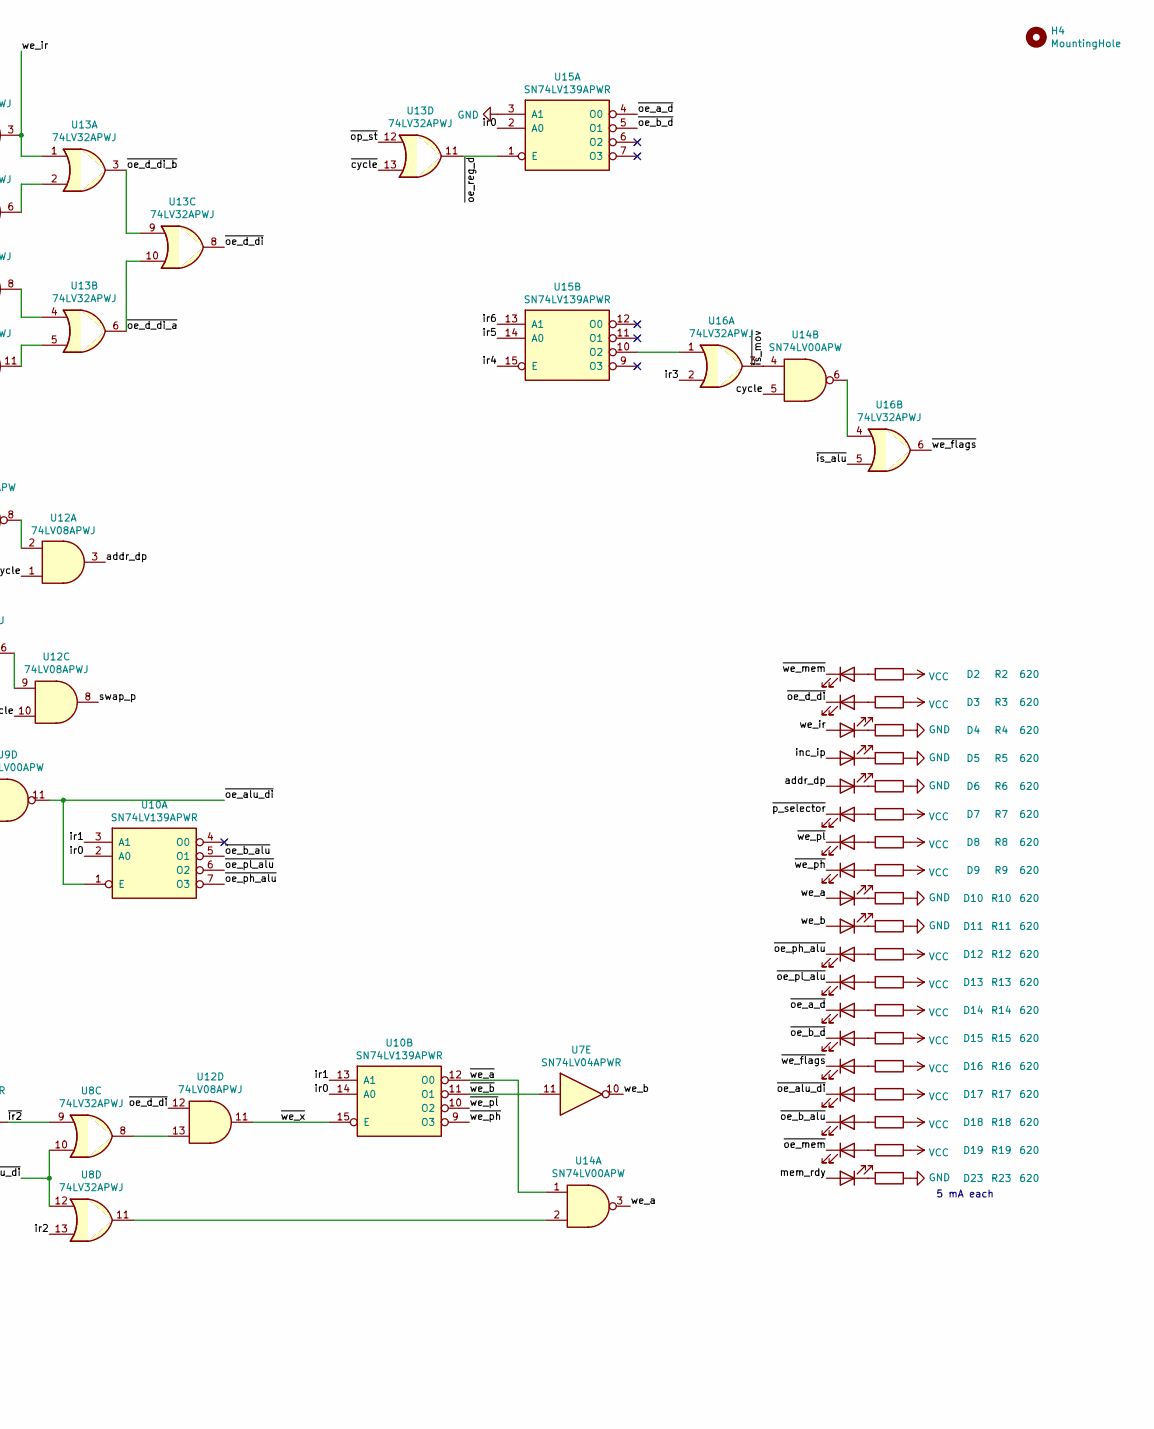
[picture p58: schematic control.sch, Control unit, part in row 1, column 2]

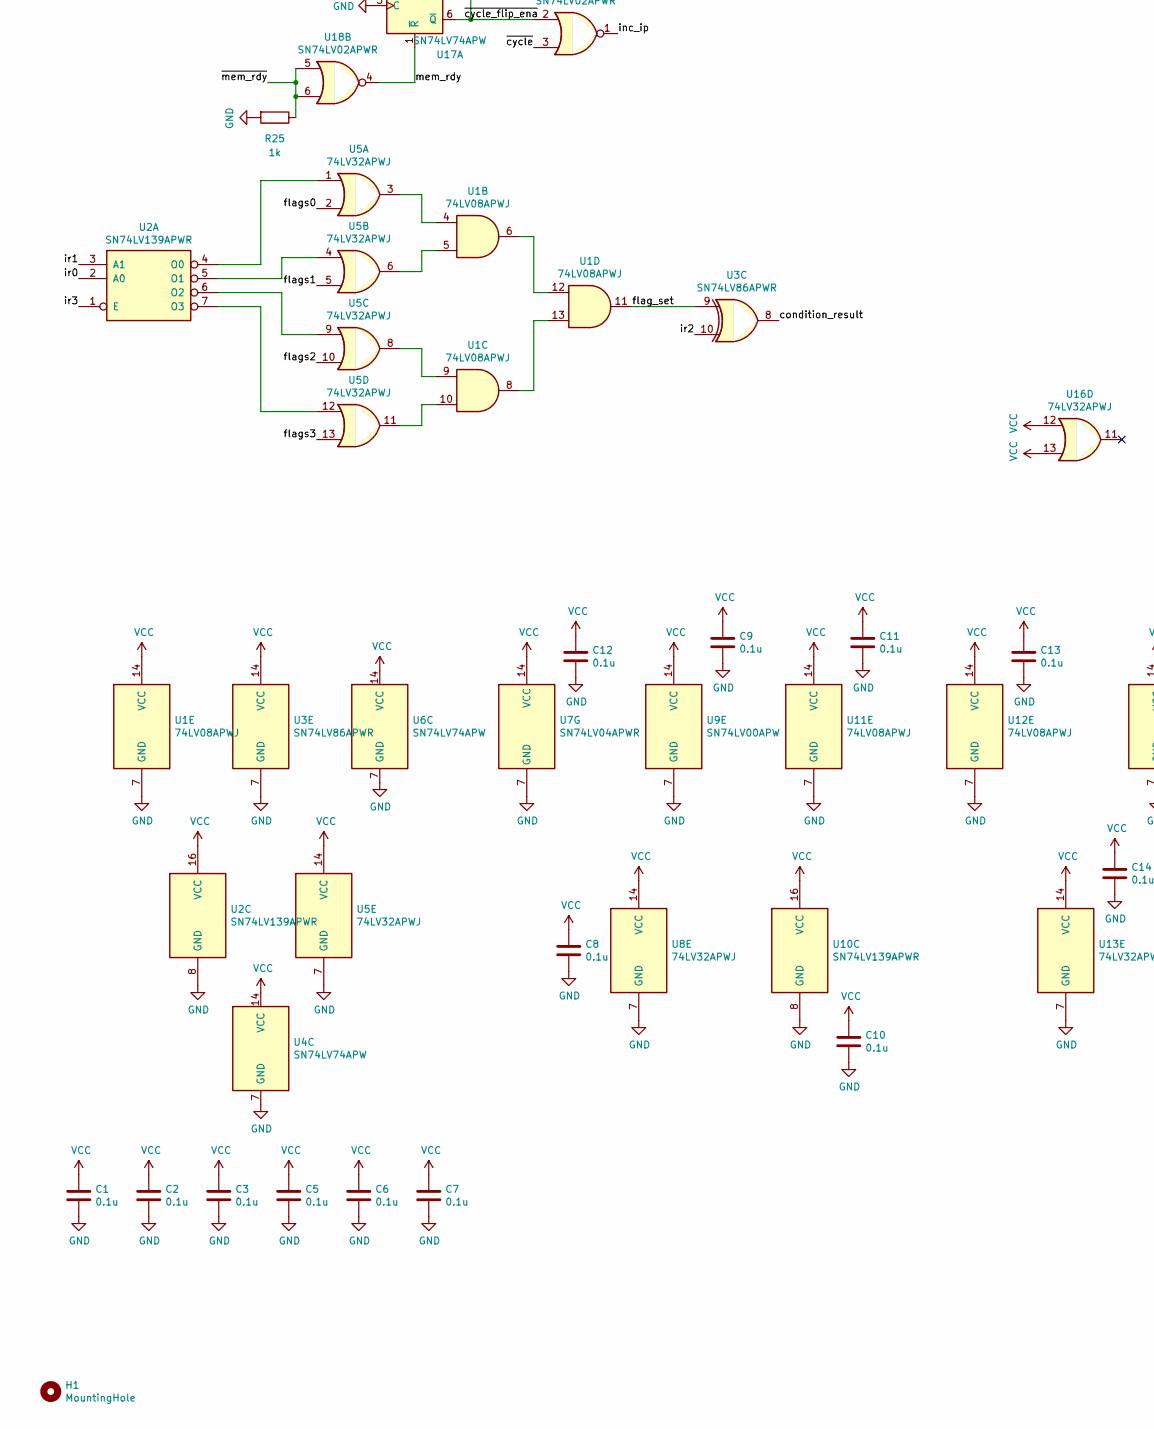
[picture p59: schematic control.sch, Control unit, part in row 2, column 1]

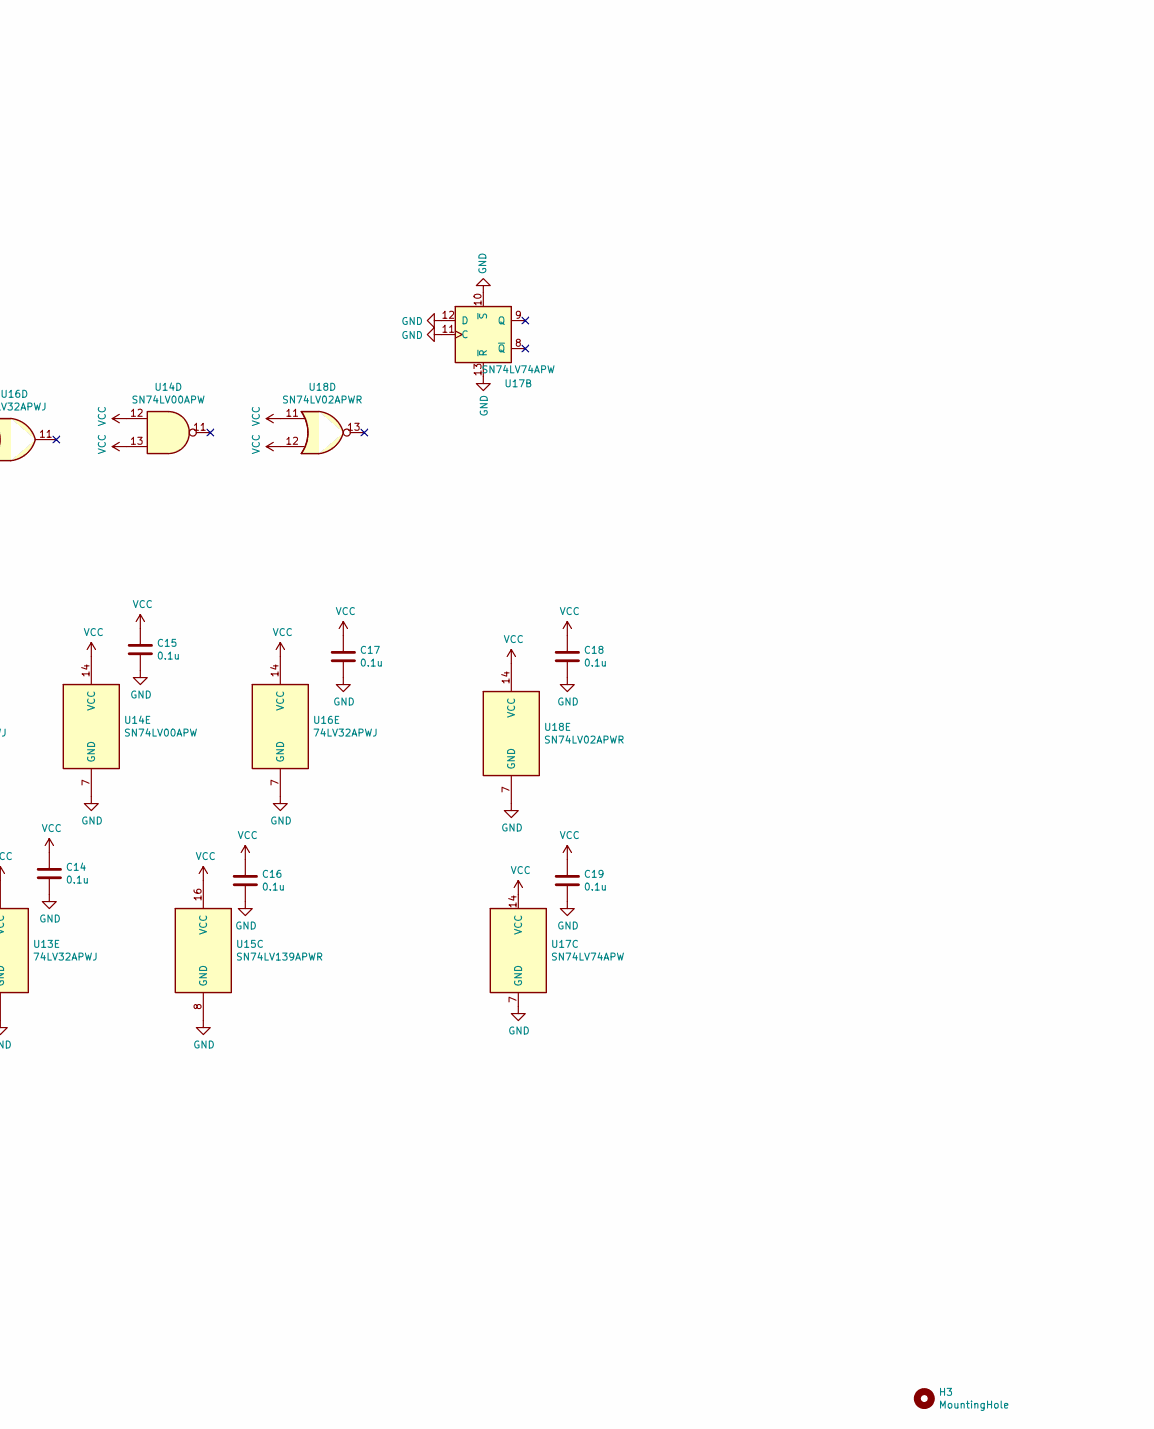
[picture p60: schematic control.sch, Control unit, part in row 2, column 2]

Parts:
C1, C2, C3, C5, C6, C7, C8, C9, C10, C11, C12, C13, C14, C15, C16, C17, C18, C19: 0.1u; C_0805_2012Metric
D1, D20, D21, D22, D24: KP-2012CGCK; LED_0805_2012Metric
D2, D3, D4, D5, D6, D7, D8, D9, D10, D11, D12, D13, D14, D15, D16, D17, D18, D19, D23: KP-2012EC; LED_0805_2012Metric
H1, H2, H3, H4: MountingHole; MountingHole_3.2mm_M3
R1, R20, R21, R22, R27: 600; R_0805_2012Metric
R2, R3, R4, R5, R6, R7, R8, R9, R10, R11, R12, R13, R14, R15, R16, R17, R18, R19, R23: 620; R_0805_2012Metric
R24, R26: 50; R_0805_2012Metric
R25: 1k; R_0805_2012Metric
U1, U11, U12: 74LV08APWJ; TSSOP-14_4.4x5mm_P0.65mm
U2, U10, U15: SN74LV139APWR; TSSOP-16_4.4x5mm_P0.65mm
U3: SN74LV86APWR; TSSOP-14_4.4x5mm_P0.65mm
U4, U6, U17: SN74LV74APW; TSSOP-14_4.4x5mm_P0.65mm
U5, U8, U13, U16: 74LV32APWJ; TSSOP-14_4.4x5mm_P0.65mm
U7: SN74LV04APWR; TSSOP-14_4.4x5mm_P0.65mm
U9, U14: SN74LV00APW; TSSOP-14_4.4x5mm_P0.65mm
U18: SN74LV02APWR; TSSOP-14_4.4x5mm_P0.65mm

Connections:
/addr_dp: D6.2 (A), U12.3; also elsewhere on the board
/clk: U4.3 (C), U7.13, U8.1; also elsewhere on the board
/condition_result: U3.8, U11.5
/cycle: R24.1, U4.11 (C), U9.13, U11.10, U12.1, U12.10, U14.5
/cycle_d: U3.6, U4.2 (D)
/ff_rdy_n_sd: U17.4 (~S), U18.10
/flag_set: U1.11, U3.9
/flags0: U5.2; also elsewhere on the board
/flags1: U5.5; also elsewhere on the board
/flags2: U5.10; also elsewhere on the board
/flags3: U5.13; also elsewhere on the board
/inc_ip: D5.2 (A), U18.1; also elsewhere on the board
/ir0: U2.2 (A0), U10.2 (A0), U10.14 (A0), U15.2 (A0); also elsewhere on the board
/ir1: U2.3 (A1), U10.3 (A1), U10.13 (A1); also elsewhere on the board
/ir2: U3.10, U7.9, U8.13; also elsewhere on the board
/ir3: U2.1 (E), U16.2; also elsewhere on the board
/ir4: U15.15 (E); also elsewhere on the board
/ir5: U2.14 (A0), U15.14 (A0); also elsewhere on the board
/ir6: U2.13 (A1), U15.13 (A1); also elsewhere on the board
/ir7: U7.1, U16.5; also elsewhere on the board
/mem_rdy: D23.2 (A), U17.1 (~R), U18.4
/op_alu: U2.15 (E), U7.2, U9.12
/op_jmp: U7.6, U11.4
/op_ldi: U1.2, U7.4
/p_selector: U3.2, U6.5 (Q); also elsewhere on the board
/supercycle: D21.2 (A), U4.9 (Q)
/swap_p: U3.1, U12.8
/we_a: D10.2 (A), U14.3; also elsewhere on the board
/we_b: D11.2 (A), U7.10; also elsewhere on the board
/we_cycle: U6.9 (Q), U9.5
/we_cycle_d: U3.11, U6.12 (D)
/we_ir: D4.2 (A), U11.3, U13.1; also elsewhere on the board
/~clear_we_cycle: U6.13 (~R), U8.6
/~clk: R26.1, U6.3 (C), U6.11 (C), U8.4, U14.10
/~cycle: D1.1 (K), U3.4, U4.6 (~Q), U11.2, U11.13, U13.13, U16.10, U18.3
/~cycle_flip_ena: D24.1 (K), U3.5, U3.13, U17.6 (~Q), U18.2
/~ir2: U7.8, U8.9
/~is_mov: U14.4, U16.3
/~mem_rdy: R25.1, U18.5, U18.6; also elsewhere on the board
/~oe_a_d: D14.1 (K), U15.4 (O0); also elsewhere on the board
/~oe_alu_di: D17.1 (K), U8.10, U8.12, U9.11, U10.1 (E); also elsewhere on the board
/~oe_b_alu: D18.1 (K), U10.5 (O1); also elsewhere on the board
/~oe_b_d: D15.1 (K), U15.5 (O1); also elsewhere on the board
/~oe_d_di: D3.1 (K), U12.12, U13.8; also elsewhere on the board
/~oe_d_di_a: U13.6, U13.10
/~oe_d_di_b: U13.3, U13.9
/~oe_mem: D19.1 (K), U9.3, U9.4; also elsewhere on the board
/~oe_ph_alu: D12.1 (K), U10.7 (O3); also elsewhere on the board
/~oe_pl_alu: D13.1 (K), U10.6 (O2); also elsewhere on the board
/~oe_reg_d: U13.11, U15.1 (E)
/~op_jmp: U2.9 (O3), U7.5
/~op_ld: U2.12 (O0), U9.9, U11.9, U12.4
/~op_ldi: U2.10 (O2), U7.3, U11.12
/~op_st: U2.11 (O1), U9.10, U13.12, U16.9
/~p_selector: D7.1 (K), U6.6 (~Q)
/~rst: U1.1, U4.1 (~R), U6.1 (~R), U8.2, U8.5, U14.9; also elsewhere on the board
/~rst_supercycle: U1.3, U4.13 (~R)
/~set_we_cycle: U6.10 (~S), U8.3
/~supercycle: U4.8 (~Q), U4.12 (D), U11.1, U12.5
/~we_a: U10.12 (O0), U14.1
/~we_b: U7.11, U10.11 (O1)
/~we_cycle: D22.1 (K), U3.12, U6.8 (~Q)
/~we_flags: D16.1 (K), U16.6; also elsewhere on the board
/~we_mem: D2.1 (K), U9.6; also elsewhere on the board
/~we_ph: D9.1 (K), U10.9 (O3); also elsewhere on the board
/~we_pl: D8.1 (K), U10.10 (O2); also elsewhere on the board
/~we_x: U10.15 (E), U12.11
GND: C1.2, C2.2, C3.2, C5.2, C6.2, C7.2, C8.2, C9.2, C10.2, C11.2, C12.2, C13.2, C14.2, C15.2, C16.2, C17.2, C18.2, C19.2, R4.1, R5.1, R6.1, R10.1, R11.1, R21.1, R23.1, R25.2, U1.7 (GND), U2.8 (GND), U3.7 (GND), U4.7 (GND), U5.7 (GND), U6.7 (GND), U7.7 (GND), U8.7 (GND), U9.7 (GND), U10.8 (GND), U11.7 (GND), U12.7 (GND), U13.7 (GND), U14.7 (GND), U15.3 (A1), U15.8 (GND), U16.7 (GND), U17.2 (D), U17.3 (C), U17.7 (GND), U17.10 (~S), U17.11 (C), U17.12 (D), U17.13 (~R), U18.7 (GND); also elsewhere on the board
unnamed: D1.2 (A), R1.2
unnamed: D2.2 (A), R2.2
unnamed: D3.2 (A), R3.2
unnamed: D4.1 (K), R4.2
unnamed: D5.1 (K), R5.2
unnamed: D6.1 (K), R6.2
unnamed: D7.2 (A), R7.2
unnamed: D8.2 (A), R8.2
unnamed: D9.2 (A), R9.2
unnamed: D10.1 (K), R10.2
unnamed: D11.1 (K), R11.2
unnamed: D12.2 (A), R12.2
unnamed: D13.2 (A), R13.2
unnamed: D14.2 (A), R14.2
unnamed: D15.2 (A), R15.2
unnamed: D16.2 (A), R16.2
unnamed: D17.2 (A), R17.2
unnamed: D18.2 (A), R18.2
unnamed: D19.2 (A), R19.2
unnamed: D20.1 (K), R26.2, U7.12
unnamed: D20.2 (A), R20.2
unnamed: D21.1 (K), R21.2
unnamed: D22.2 (A), R22.2
unnamed: D23.1 (K), R23.2
unnamed: D24.2 (A), R27.2
unnamed: R24.2, U4.5 (Q)
unnamed: U1.4, U5.3
unnamed: U1.5, U5.6
unnamed: U1.9, U5.8
unnamed: U1.10, U5.11
unnamed: U1.6, U1.12
unnamed: U1.8, U1.13
unnamed: U2.4 (O0), U5.1
unnamed: U2.5 (O1), U5.4
unnamed: U2.6 (O2), U5.9
unnamed: U2.7 (O3), U5.12
unnamed: U3.3, U6.2 (D)
unnamed: U11.6, U12.9
unnamed: U11.8, U13.4
unnamed: U11.11, U13.5
unnamed: U9.8, U12.2
unnamed: U12.6, U13.2
unnamed: U8.8, U12.13
unnamed: U8.11, U14.2
unnamed: U14.6, U16.4
unnamed: U14.8, U18.8, U18.9
unnamed: U15.10 (O2), U16.1
unnamed: U9.1, U9.2, U16.8
VCC: C1.1, C2.1, C3.1, C5.1, C6.1, C7.1, C8.1, C9.1, C10.1, C11.1, C12.1, C13.1, C14.1, C15.1, C16.1, C17.1, C18.1, C19.1, R1.1, R2.1, R3.1, R7.1, R8.1, R9.1, R12.1, R13.1, R14.1, R15.1, R16.1, R17.1, R18.1, R19.1, R20.1, R22.1, R27.1, U1.14 (VCC), U2.16 (VCC), U3.14 (VCC), U4.4 (~S), U4.10 (~S), U4.14 (VCC), U5.14 (VCC), U6.4 (~S), U6.14 (VCC), U7.14 (VCC), U8.14 (VCC), U9.14 (VCC), U10.16 (VCC), U11.14 (VCC), U12.14 (VCC), U13.14 (VCC), U14.12, U14.13, U14.14 (VCC), U15.16 (VCC), U16.12, U16.13, U16.14 (VCC), U17.14 (VCC), U18.11, U18.12, U18.14 (VCC); also elsewhere on the board

Notes on the sheet:
5 mA each

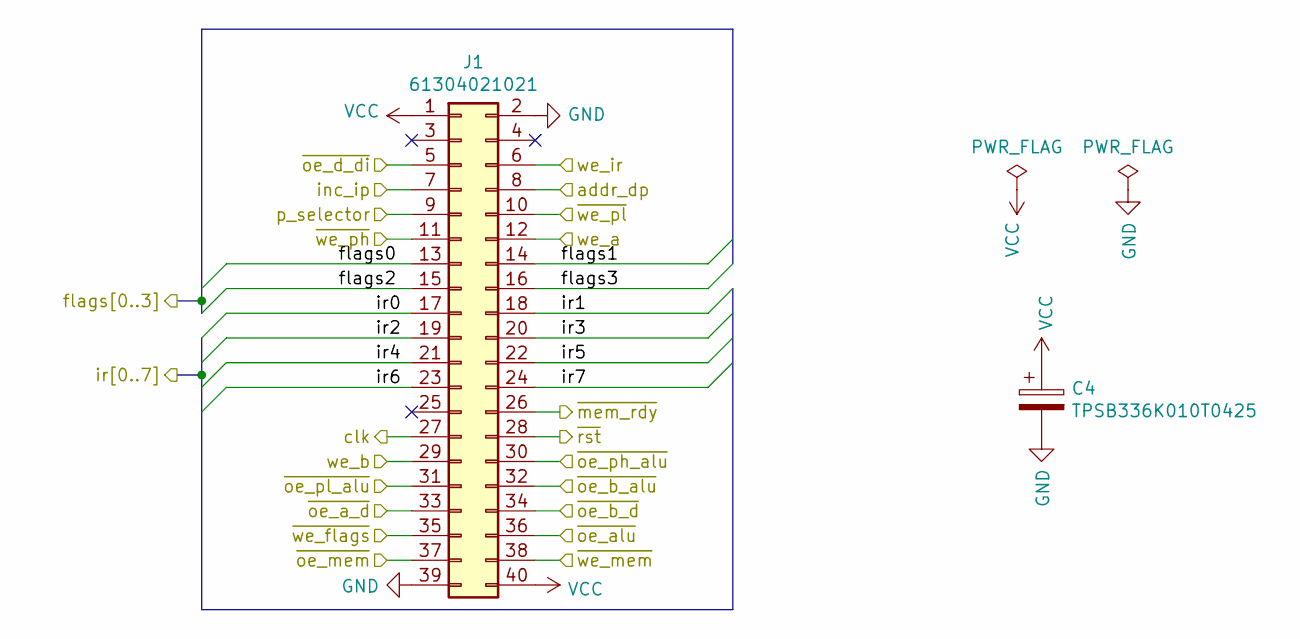
[picture p61: schematic interface.sch, Interface connector]

Parts:
C4: TPSB336K010T0425; CP_EIA-3528-21_Kemet-B_Pad1.50x2.35mm_HandSolder
J1: 61304021021; PinHeader_2x20_P2.54mm_Horizontal

Connections:
/addr_dp: J1.8; also elsewhere on the board
/clk: J1.27; also elsewhere on the board
/flags0: J1.13; also elsewhere on the board
/flags1: J1.14; also elsewhere on the board
/flags2: J1.15; also elsewhere on the board
/flags3: J1.16; also elsewhere on the board
/inc_ip: J1.7; also elsewhere on the board
/ir0: J1.17; also elsewhere on the board
/ir1: J1.18; also elsewhere on the board
/ir2: J1.19; also elsewhere on the board
/ir3: J1.20; also elsewhere on the board
/ir4: J1.21; also elsewhere on the board
/ir5: J1.22; also elsewhere on the board
/ir6: J1.23; also elsewhere on the board
/ir7: J1.24; also elsewhere on the board
/p_selector: J1.9; also elsewhere on the board
/we_a: J1.12; also elsewhere on the board
/we_b: J1.29; also elsewhere on the board
/we_ir: J1.6; also elsewhere on the board
/~mem_rdy: J1.26; also elsewhere on the board
/~oe_a_d: J1.33; also elsewhere on the board
/~oe_alu_di: J1.36; also elsewhere on the board
/~oe_b_alu: J1.32; also elsewhere on the board
/~oe_b_d: J1.34; also elsewhere on the board
/~oe_d_di: J1.5; also elsewhere on the board
/~oe_mem: J1.37; also elsewhere on the board
/~oe_ph_alu: J1.30; also elsewhere on the board
/~oe_pl_alu: J1.31; also elsewhere on the board
/~rst: J1.28; also elsewhere on the board
/~we_flags: J1.35; also elsewhere on the board
/~we_mem: J1.38; also elsewhere on the board
/~we_ph: J1.11; also elsewhere on the board
/~we_pl: J1.10; also elsewhere on the board
GND: C4.2, J1.2, J1.39; also elsewhere on the board
VCC: C4.1, J1.1, J1.40; also elsewhere on the board

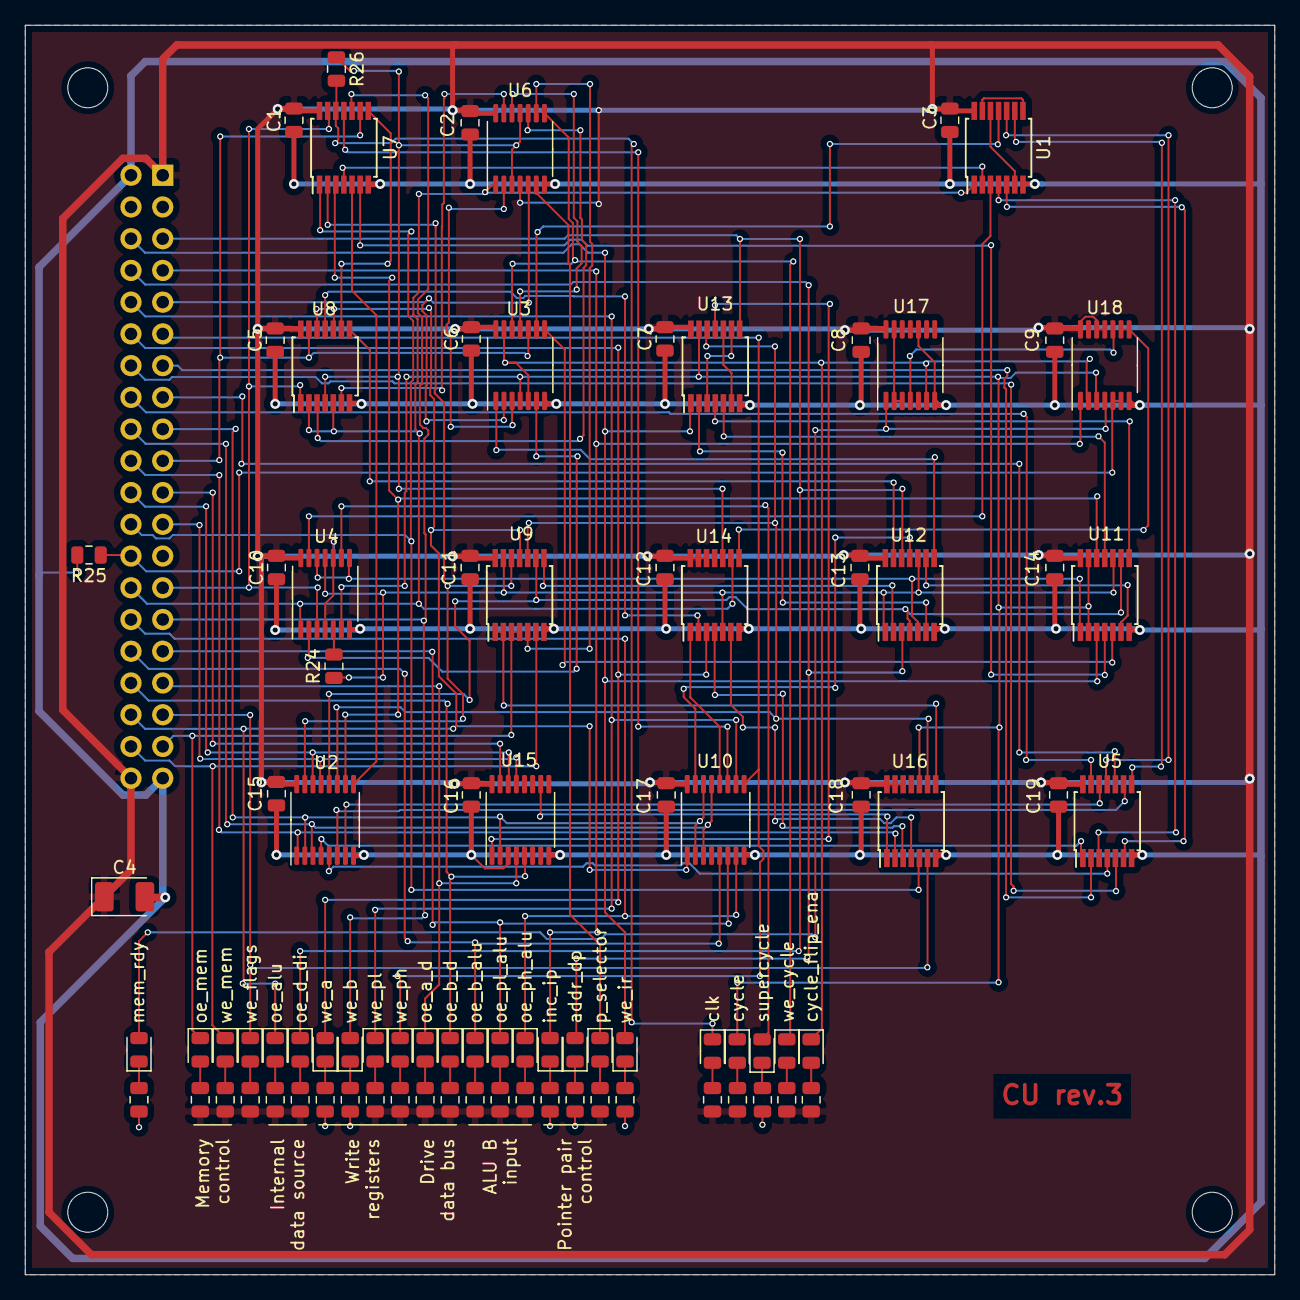
[picture p62: board control.kicad_pcb from above]

Board: 2 copper layers, 100.0 x 100.0 mm, 93 parts (1 on the bottom side), 117 nets.
