imihajlow/ccpu/boards/alu/alu.kicad_pcb

## KiCad design boards/alu/alu.kicad_pcb (2020-11-15)

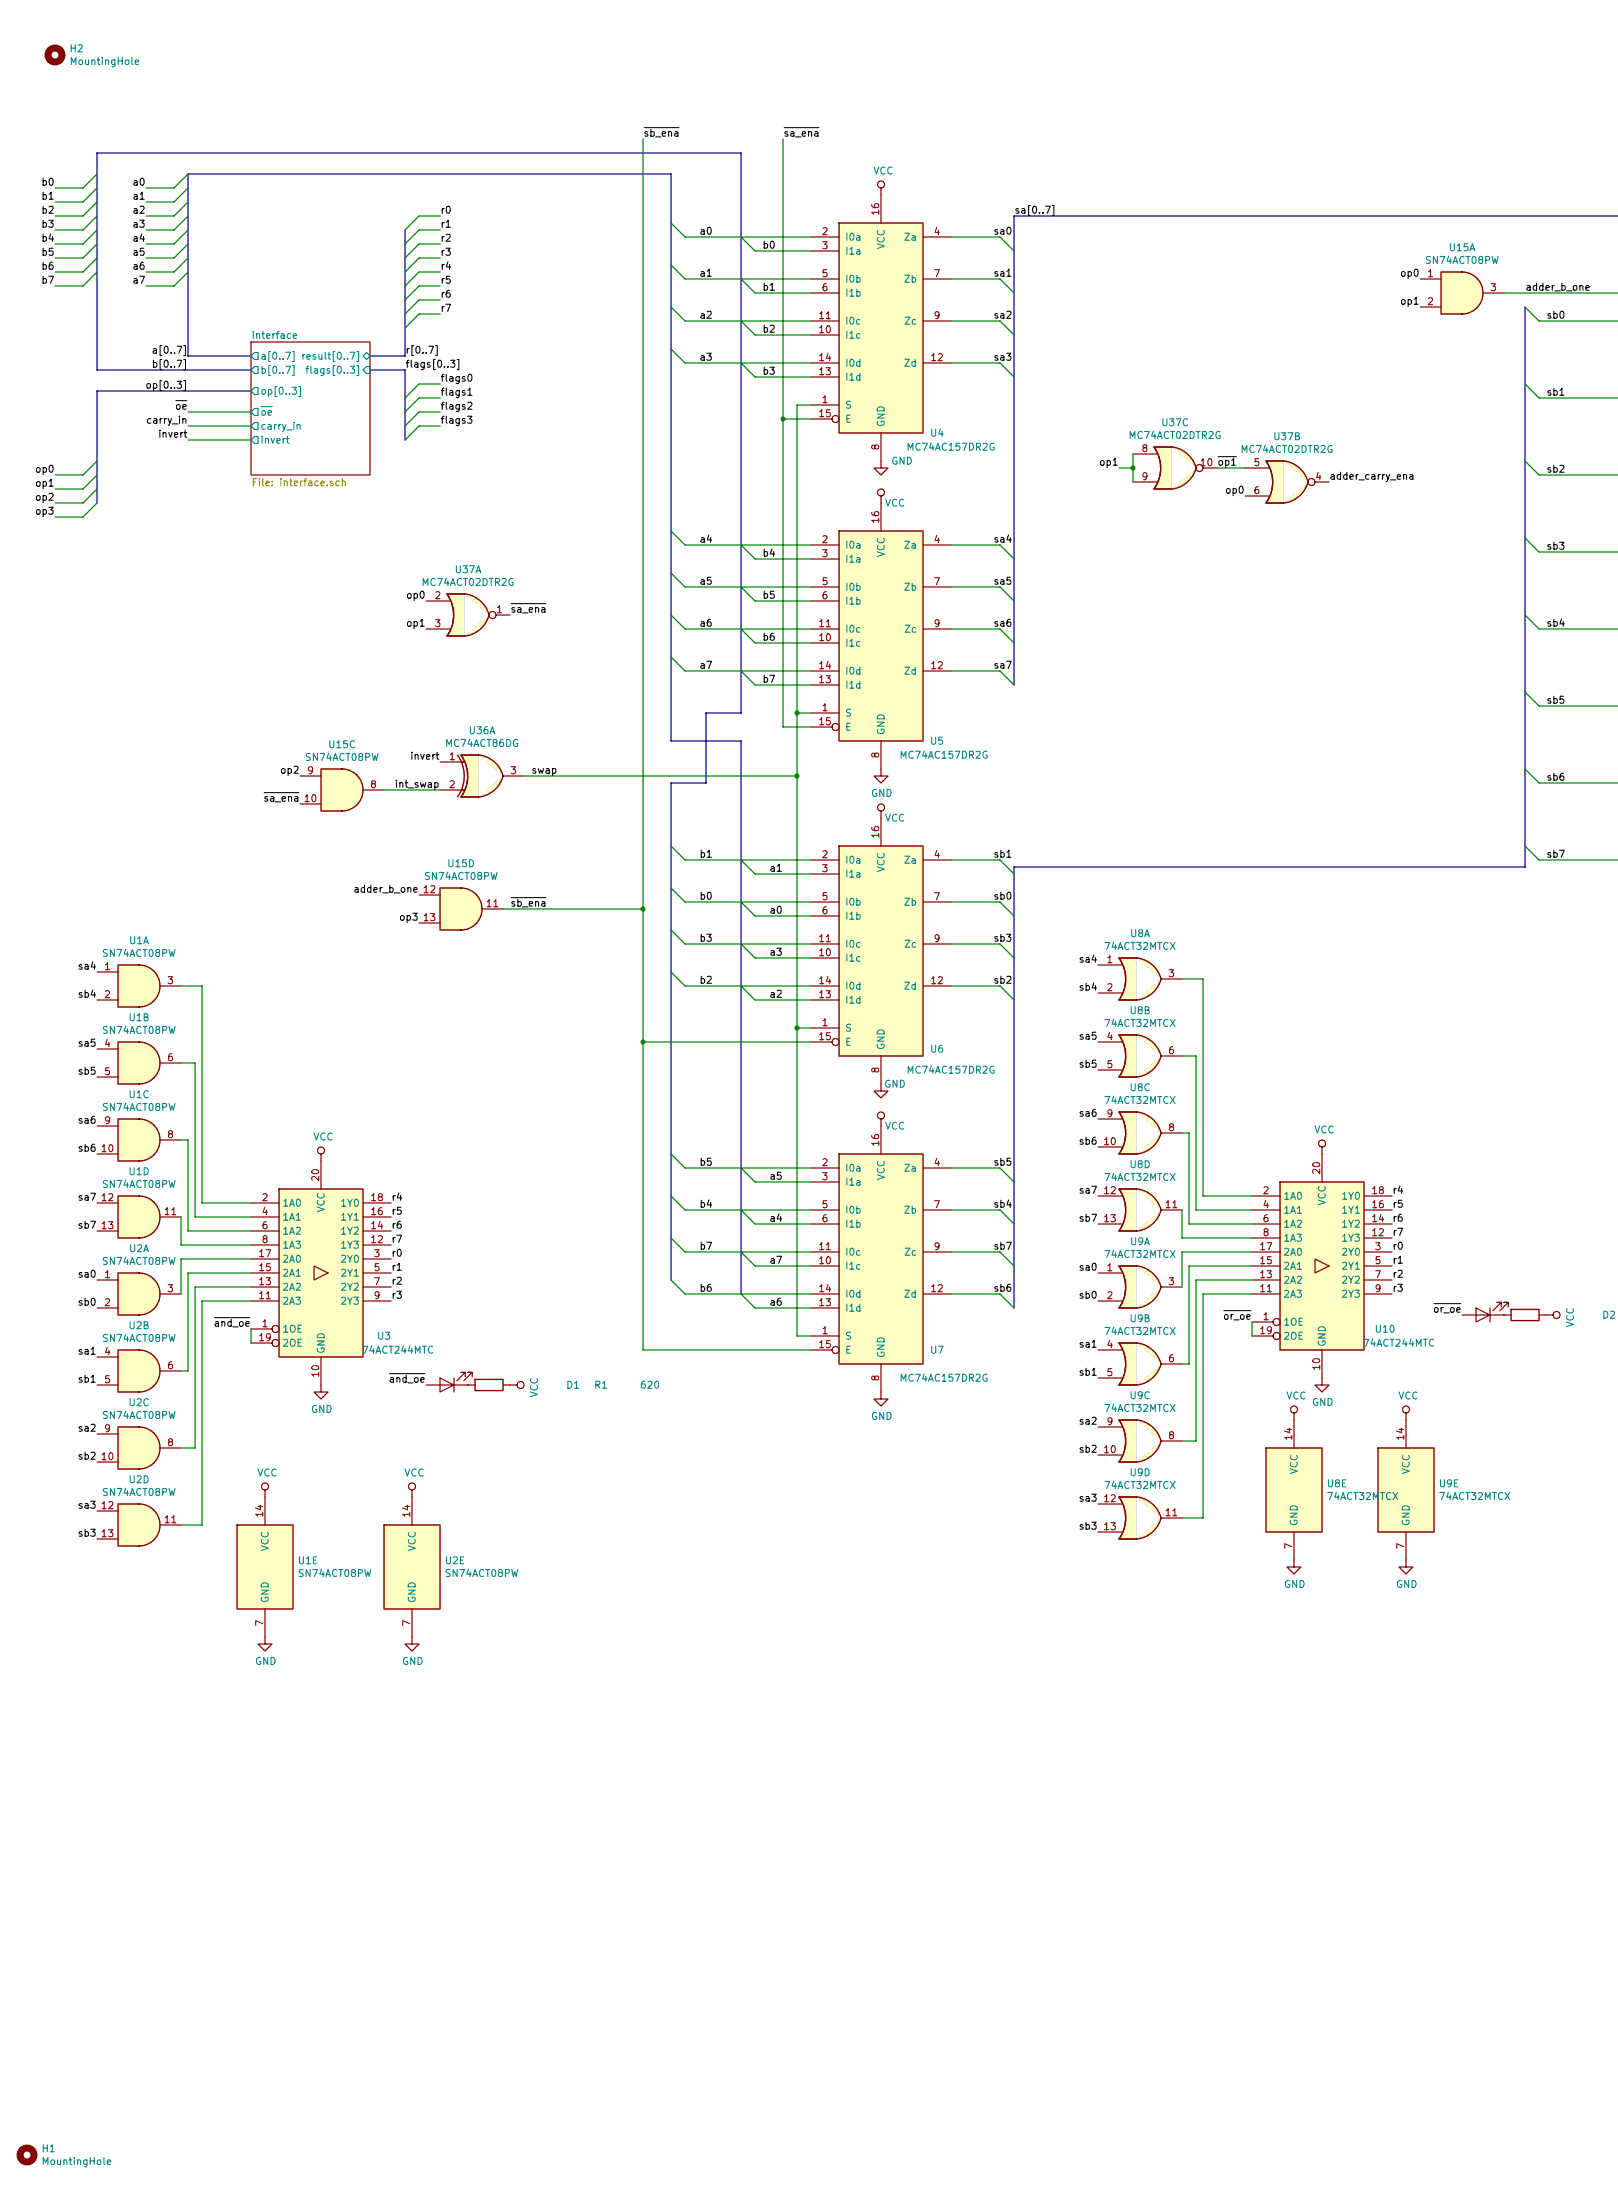
[picture p63: schematic alu.sch, ALU module, part in row 1, column 1]

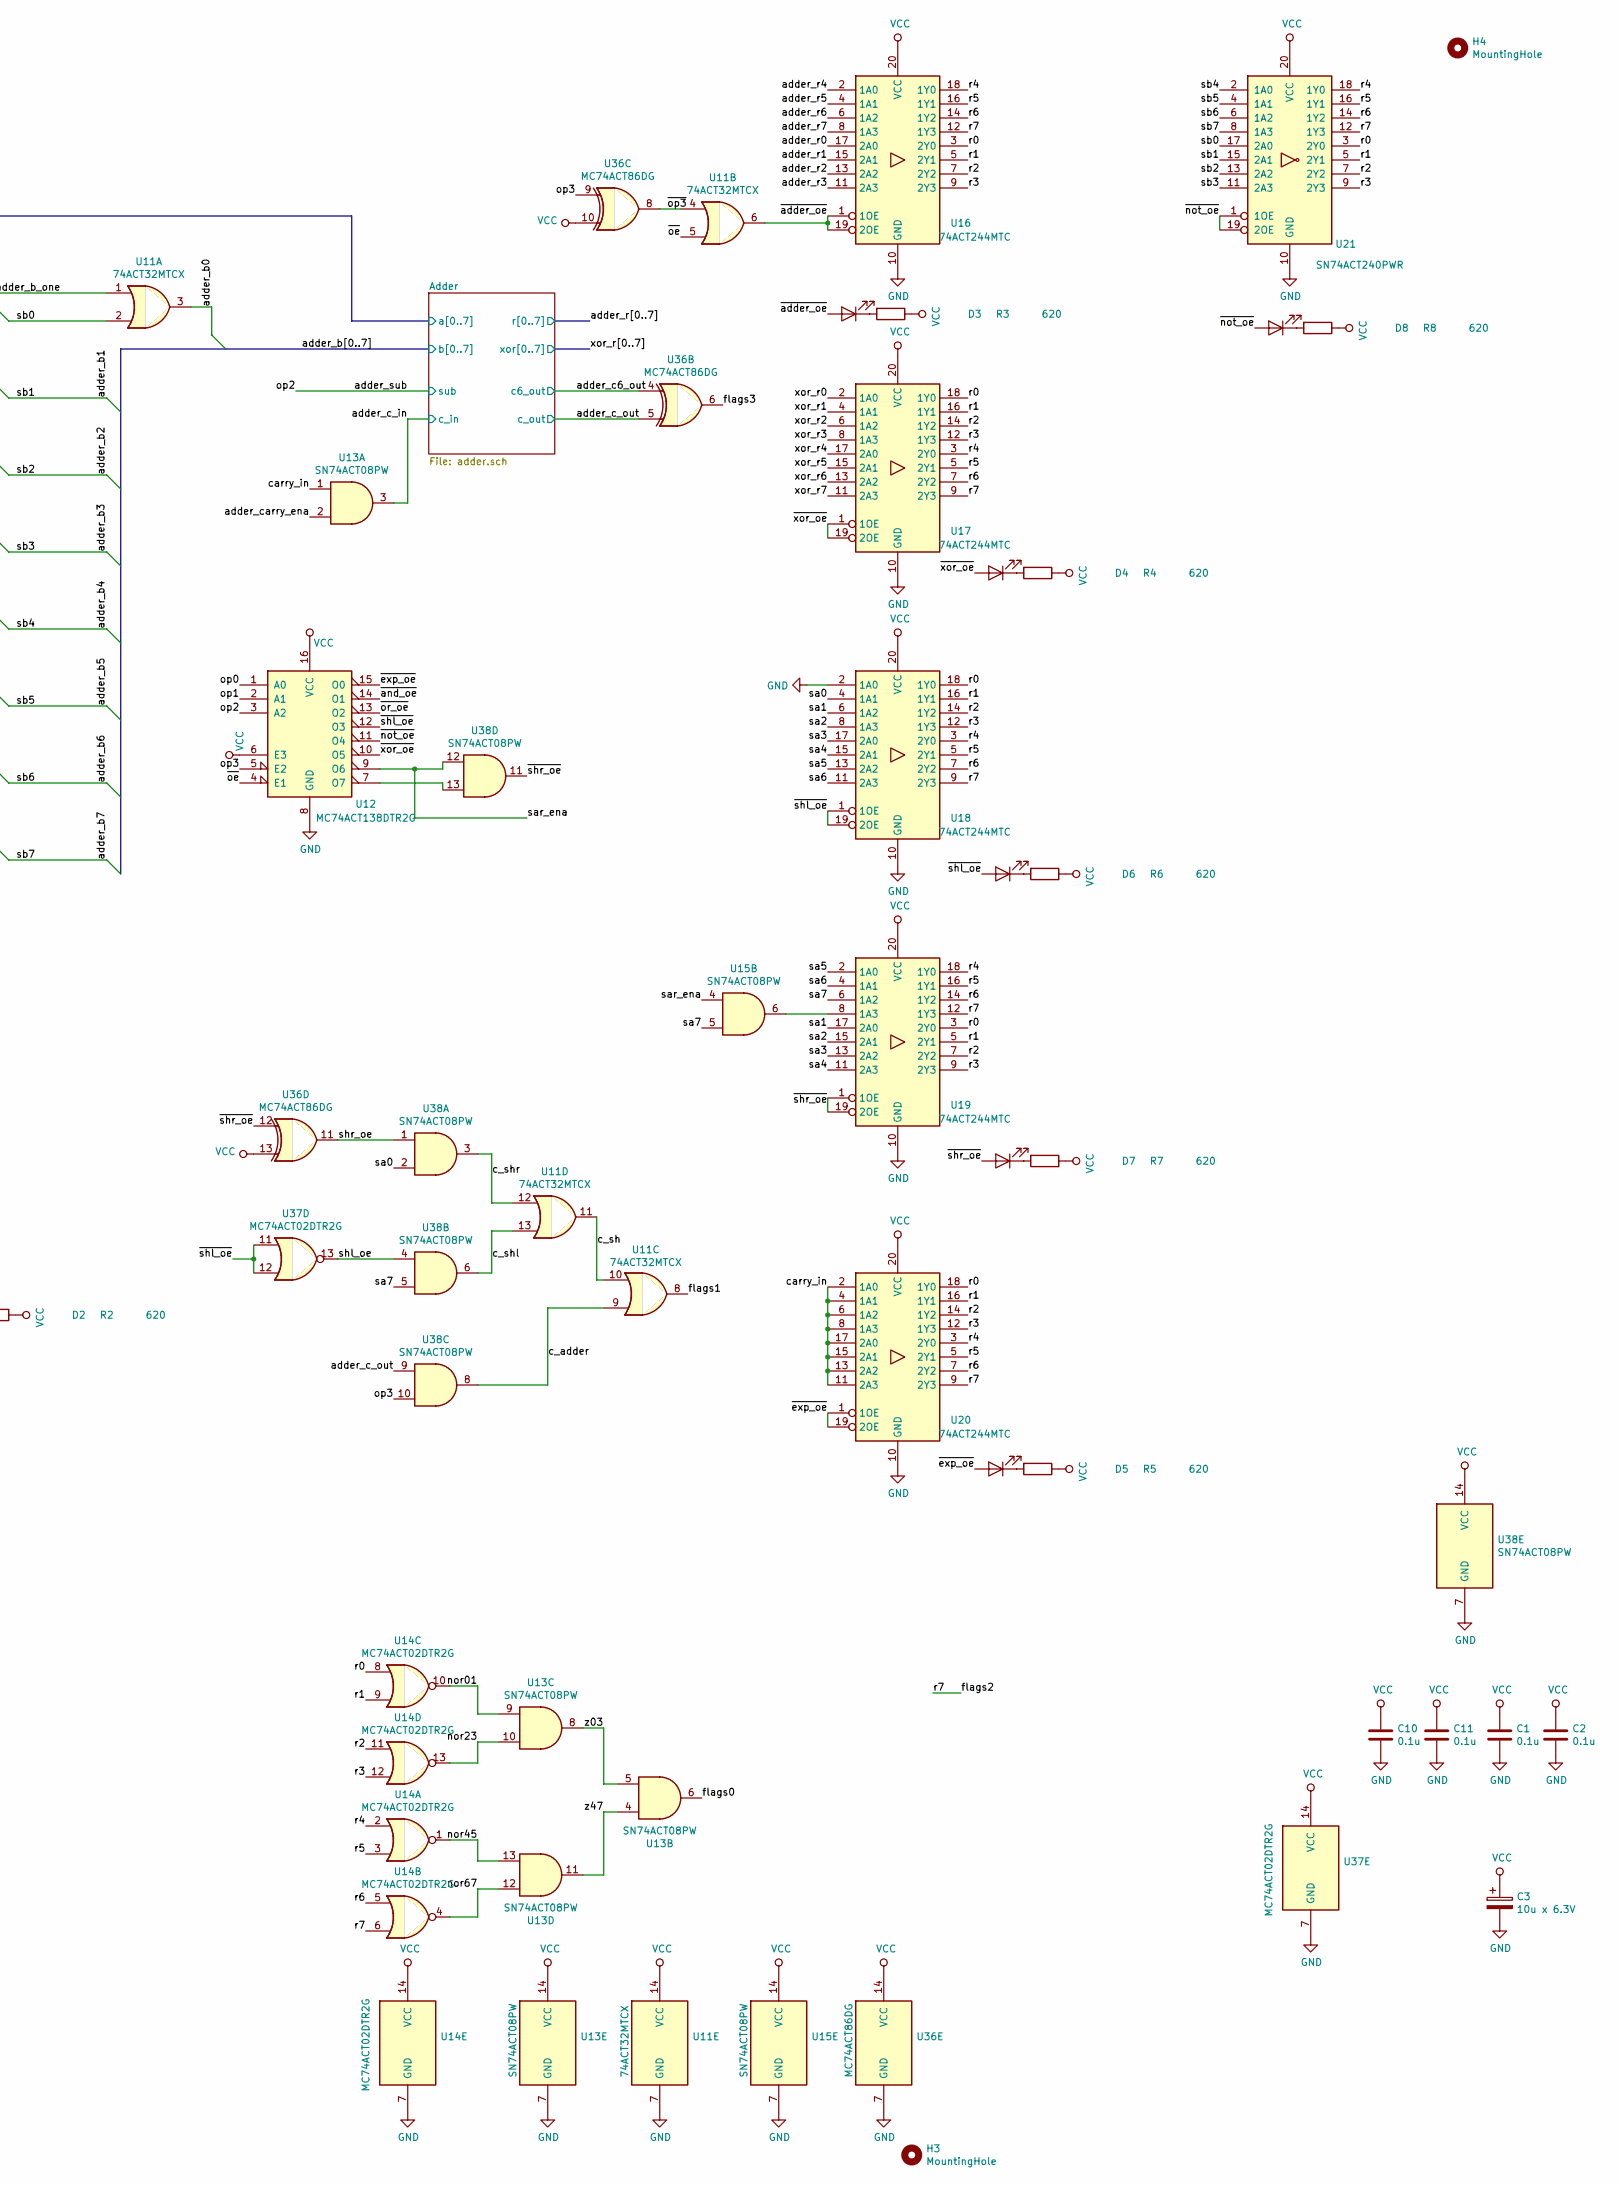
[picture p64: schematic alu.sch, ALU module, part in row 1, column 2]

Parts:
C1, C2, C10, C11: 0.1u; C_0805_2012Metric
C3: 10u x 6.3V; CP_EIA-3528-21_Kemet-B_Pad1.50x2.35mm_HandSolder
D1, D2, D3, D4, D5, D6, D7, D8: KP-2012EC; LED_0805_2012Metric
H1, H2, H3, H4: MountingHole; MountingHole_3.2mm_M3
R1, R2, R3, R4, R5, R6, R7, R8: 620; R_0805_2012Metric
U1, U2, U13, U15, U38: SN74ACT08PW; TSSOP-14_4.4x5mm_P0.65mm
U3, U10, U16, U17, U18, U19, U20: 74ACT244MTC; TSSOP-20_4.4x6.5mm_P0.65mm
U4, U5, U6, U7: MC74AC157DR2G; SOIC-16_3.9x9.9mm_P1.27mm
U8, U9, U11: 74ACT32MTCX; TSSOP-14_4.4x5mm_P0.65mm
U12: MC74ACT138DTR2G; TSSOP-16_4.4x5mm_P0.65mm
U14, U37: MC74ACT02DTR2G; TSSOP-14_4.4x5mm_P0.65mm
U21: SN74ACT240PWR; TSSOP-20_4.4x6.5mm_P0.65mm
U36: MC74ACT86DG; SOIC-14_3.9x8.7mm_P1.27mm

Connections:
/a0: U4.2 (I0a), U6.6 (I1b); also elsewhere on the board
/a1: U4.5 (I0b), U6.3 (I1a); also elsewhere on the board
/a2: U4.11 (I0c), U6.13 (I1d); also elsewhere on the board
/a3: U4.14 (I0d), U6.10 (I1c); also elsewhere on the board
/a4: U5.2 (I0a), U7.6 (I1b); also elsewhere on the board
/a5: U5.5 (I0b), U7.3 (I1a); also elsewhere on the board
/a6: U5.11 (I0c), U7.13 (I1d); also elsewhere on the board
/a7: U5.14 (I0d), U7.10 (I1c); also elsewhere on the board
/adder_b0: U11.3; also elsewhere on the board
/adder_b1: U2.5, U6.4 (Za), U9.5, U21.15 (2A1); also elsewhere on the board
/adder_b2: U2.10, U6.12 (Zd), U9.10, U21.13 (2A2); also elsewhere on the board
/adder_b3: U2.13, U6.9 (Zc), U9.13, U21.11 (2A3); also elsewhere on the board
/adder_b4: U1.2, U7.7 (Zb), U8.2, U21.2 (1A0); also elsewhere on the board
/adder_b5: U1.5, U7.4 (Za), U8.5, U21.4 (1A1); also elsewhere on the board
/adder_b6: U1.10, U7.12 (Zd), U8.10, U21.6 (1A2); also elsewhere on the board
/adder_b7: U1.13, U7.9 (Zc), U8.13, U21.8 (1A3); also elsewhere on the board
/adder_b_one: U11.1, U15.3, U15.12
/adder_c6_out: U36.4; also elsewhere on the board
/adder_c_in: U13.3; also elsewhere on the board
/adder_c_out: U36.5, U38.9; also elsewhere on the board
/adder_carry_ena: U13.2, U37.4
/adder_r0: U16.17 (2A0); also elsewhere on the board
/adder_r1: U16.15 (2A1); also elsewhere on the board
/adder_r2: U16.13 (2A2); also elsewhere on the board
/adder_r3: U16.11 (2A3); also elsewhere on the board
/adder_r4: U16.2 (1A0); also elsewhere on the board
/adder_r5: U16.4 (1A1); also elsewhere on the board
/adder_r6: U16.6 (1A2); also elsewhere on the board
/adder_r7: U16.8 (1A3); also elsewhere on the board
/adder_sub: U12.3 (A2), U15.9; also elsewhere on the board
/b0: U4.3 (I1a), U6.5 (I0b); also elsewhere on the board
/b1: U4.6 (I1b), U6.2 (I0a); also elsewhere on the board
/b2: U4.10 (I1c), U6.14 (I0d); also elsewhere on the board
/b3: U4.13 (I1d), U6.11 (I0c); also elsewhere on the board
/b4: U5.3 (I1a), U7.5 (I0b); also elsewhere on the board
/b5: U5.6 (I1b), U7.2 (I0a); also elsewhere on the board
/b6: U5.10 (I1c), U7.14 (I0d); also elsewhere on the board
/b7: U5.13 (I1d), U7.11 (I0c); also elsewhere on the board
/c_adder: U11.9, U38.8
/c_sh: U11.10, U11.11
/c_shl: U11.13, U38.6
/c_shr: U11.12, U38.3
/carry_in: U13.1, U20.2 (1A0), U20.4 (1A1), U20.6 (1A2), U20.8 (1A3), U20.11 (2A3), U20.13 (2A2), U20.15 (2A1), U20.17 (2A0); also elsewhere on the board
/flags0: U13.6; also elsewhere on the board
/flags1: U11.8; also elsewhere on the board
/flags3: U36.6; also elsewhere on the board
/int_swap: U15.8, U36.2
/invert: U36.1; also elsewhere on the board
/nor01: U13.9, U14.10
/nor23: U13.10, U14.13
/nor45: U13.13, U14.1
/nor67: U13.12, U14.4
/op0: U12.1 (A0), U15.1, U37.2, U37.6; also elsewhere on the board
/op1: U12.2 (A1), U15.2, U37.3, U37.8, U37.9; also elsewhere on the board
/op3: U12.5 (E2), U15.13, U36.9, U38.10; also elsewhere on the board
/r0: U3.3 (2Y0), U10.3 (2Y0), U14.8, U16.3 (2Y0), U17.18 (1Y0), U18.18 (1Y0), U19.3 (2Y0), U20.18 (1Y0), U21.3 (2Y0); also elsewhere on the board
/r1: U3.5 (2Y1), U10.5 (2Y1), U14.9, U16.5 (2Y1), U17.16 (1Y1), U18.16 (1Y1), U19.5 (2Y1), U20.16 (1Y1), U21.5 (2Y1); also elsewhere on the board
/r2: U3.7 (2Y2), U10.7 (2Y2), U14.11, U16.7 (2Y2), U17.14 (1Y2), U18.14 (1Y2), U19.7 (2Y2), U20.14 (1Y2), U21.7 (2Y2); also elsewhere on the board
/r3: U3.9 (2Y3), U10.9 (2Y3), U14.12, U16.9 (2Y3), U17.12 (1Y3), U18.12 (1Y3), U19.9 (2Y3), U20.12 (1Y3), U21.9 (2Y3); also elsewhere on the board
/r4: U3.18 (1Y0), U10.18 (1Y0), U14.2, U16.18 (1Y0), U17.3 (2Y0), U18.3 (2Y0), U19.18 (1Y0), U20.3 (2Y0), U21.18 (1Y0); also elsewhere on the board
/r5: U3.16 (1Y1), U10.16 (1Y1), U14.3, U16.16 (1Y1), U17.5 (2Y1), U18.5 (2Y1), U19.16 (1Y1), U20.5 (2Y1), U21.16 (1Y1); also elsewhere on the board
/r6: U3.14 (1Y2), U10.14 (1Y2), U14.5, U16.14 (1Y2), U17.7 (2Y2), U18.7 (2Y2), U19.14 (1Y2), U20.7 (2Y2), U21.14 (1Y2); also elsewhere on the board
/sa0: U2.1, U4.4 (Za), U9.1, U18.4 (1A1), U38.2; also elsewhere on the board
/sa1: U2.4, U4.7 (Zb), U9.4, U18.6 (1A2), U19.17 (2A0); also elsewhere on the board
/sa2: U2.9, U4.9 (Zc), U9.9, U18.8 (1A3), U19.15 (2A1); also elsewhere on the board
/sa3: U2.12, U4.12 (Zd), U9.12, U18.17 (2A0), U19.13 (2A2); also elsewhere on the board
/sa4: U1.1, U5.4 (Za), U8.1, U18.15 (2A1), U19.11 (2A3); also elsewhere on the board
/sa5: U1.4, U5.7 (Zb), U8.4, U18.13 (2A2), U19.2 (1A0); also elsewhere on the board
/sa6: U1.9, U5.9 (Zc), U8.9, U18.11 (2A3), U19.4 (1A1); also elsewhere on the board
/sa7: U1.12, U5.12 (Zd), U8.12, U15.5, U19.6 (1A2), U38.5; also elsewhere on the board
/sar_ena: U12.9 (O6), U15.4, U38.12
/sb0: U2.2, U6.7 (Zb), U9.2, U11.2, U21.17 (2A0)
/shl_oe: U37.13, U38.4
/shr_oe: U36.11, U38.1
/swap: U4.1 (S), U5.1 (S), U6.1 (S), U7.1 (S), U36.3
/xor_r0: U17.2 (1A0); also elsewhere on the board
/xor_r1: U17.4 (1A1); also elsewhere on the board
/xor_r2: U17.6 (1A2); also elsewhere on the board
/xor_r3: U17.8 (1A3); also elsewhere on the board
/xor_r4: U17.17 (2A0); also elsewhere on the board
/xor_r5: U17.15 (2A1); also elsewhere on the board
/xor_r6: U17.13 (2A2); also elsewhere on the board
/xor_r7: U17.11 (2A3); also elsewhere on the board
/z03: U13.5, U13.8
/z47: U13.4, U13.11
/~adder_oe: D3.2 (A), U11.6, U16.1 (1OE), U16.19 (2OE)
/~and_oe: D1.2 (A), U3.1 (1OE), U3.19 (2OE), U12.14 (O1)
/~exp_oe: D5.2 (A), U12.15 (O0), U20.1 (1OE), U20.19 (2OE)
/~not_oe: D8.2 (A), U12.11 (O4), U21.1 (1OE), U21.19 (2OE)
/~oe: U11.5, U12.4 (E1); also elsewhere on the board
/~op1: U37.5, U37.10
/~op3: U11.4, U36.8
/~or_oe: D2.2 (A), U10.1 (1OE), U10.19 (2OE), U12.13 (O2)
/~sa_ena: U4.15 (E), U5.15 (E), U15.10, U37.1
/~sb_ena: U6.15 (E), U7.15 (E), U15.11
/~shl_oe: D6.2 (A), U12.12 (O3), U18.1 (1OE), U18.19 (2OE), U37.11, U37.12
/~shr_oe: D7.2 (A), U19.1 (1OE), U19.19 (2OE), U36.12, U38.11
/~xor_oe: D4.2 (A), U12.10 (O5), U17.1 (1OE), U17.19 (2OE)
GND: C1.2, C2.2, C3.2, C10.2, C11.2, U1.7 (GND), U2.7 (GND), U3.10 (GND), U4.8 (GND), U5.8 (GND), U6.8 (GND), U7.8 (GND), U8.7 (GND), U9.7 (GND), U10.10 (GND), U11.7 (GND), U12.8 (GND), U13.7 (GND), U14.7 (GND), U15.7 (GND), U16.10 (GND), U17.10 (GND), U18.2 (1A0), U18.10 (GND), U19.10 (GND), U20.10 (GND), U21.10 (GND), U36.7 (GND), U37.7 (GND), U38.7 (GND); also elsewhere on the board
unnamed: D1.1 (K), R1.2
unnamed: D2.1 (K), R2.2
unnamed: D3.1 (K), R3.2
unnamed: D4.1 (K), R4.2
unnamed: D5.1 (K), R5.2
unnamed: D6.1 (K), R6.2
unnamed: D7.1 (K), R7.2
unnamed: D8.1 (K), R8.2
unnamed: U1.3, U3.2 (1A0)
unnamed: U1.6, U3.4 (1A1)
unnamed: U1.8, U3.6 (1A2)
unnamed: U1.11, U3.8 (1A3)
unnamed: U2.3, U3.17 (2A0)
unnamed: U2.6, U3.15 (2A1)
unnamed: U2.8, U3.13 (2A2)
unnamed: U2.11, U3.11 (2A3)
unnamed: U8.3, U10.2 (1A0)
unnamed: U8.6, U10.4 (1A1)
unnamed: U8.8, U10.6 (1A2)
unnamed: U8.11, U10.8 (1A3)
unnamed: U9.11, U10.11 (2A3)
unnamed: U9.8, U10.13 (2A2)
unnamed: U9.6, U10.15 (2A1)
unnamed: U9.3, U10.17 (2A0)
unnamed: U12.7 (O7), U38.13
unnamed: U15.6, U19.8 (1A3)
VCC: C1.1, C2.1, C3.1, C10.1, C11.1, R1.1, R2.1, R3.1, R4.1, R5.1, R6.1, R7.1, R8.1, U1.14 (VCC), U2.14 (VCC), U3.20 (VCC), U4.16 (VCC), U5.16 (VCC), U6.16 (VCC), U7.16 (VCC), U8.14 (VCC), U9.14 (VCC), U10.20 (VCC), U11.14 (VCC), U12.6 (E3), U12.16 (VCC), U13.14 (VCC), U14.14 (VCC), U15.14 (VCC), U16.20 (VCC), U17.20 (VCC), U18.20 (VCC), U19.20 (VCC), U20.20 (VCC), U21.20 (VCC), U36.10, U36.13, U36.14 (VCC), U37.14 (VCC), U38.14 (VCC); also elsewhere on the board

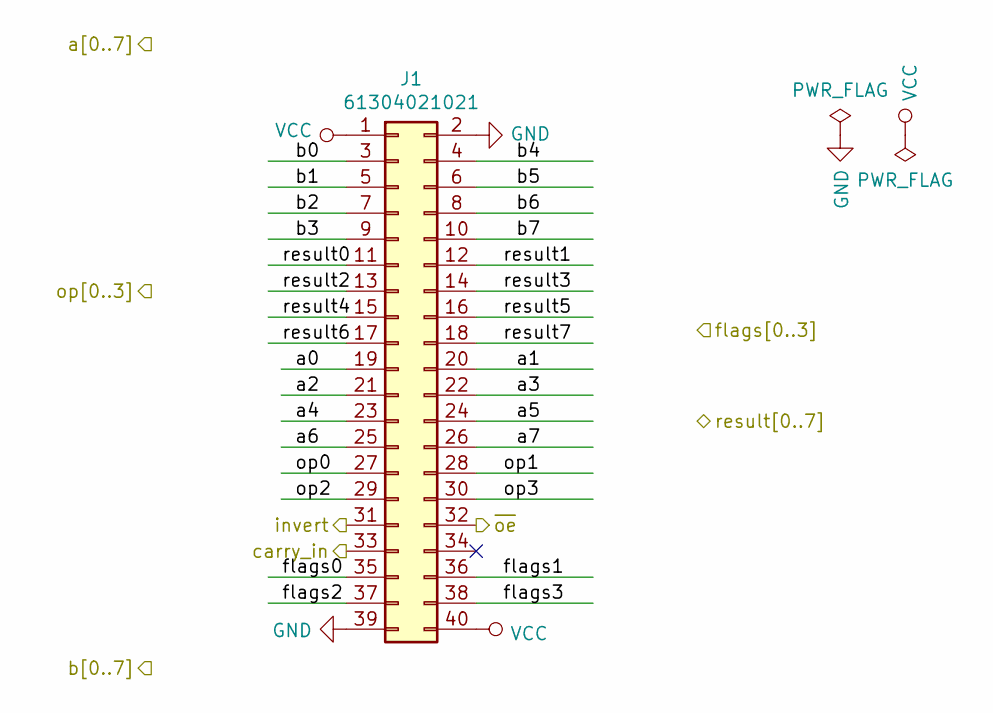
[picture p65: schematic interface.sch]

Parts:
J1: 61304021021; PinHeader_2x20_P2.54mm_Horizontal

Connections:
/a0: J1.19; also elsewhere on the board
/a1: J1.20; also elsewhere on the board
/a2: J1.21; also elsewhere on the board
/a3: J1.22; also elsewhere on the board
/a4: J1.23; also elsewhere on the board
/a5: J1.24; also elsewhere on the board
/a6: J1.25; also elsewhere on the board
/a7: J1.26; also elsewhere on the board
/adder_sub: J1.29; also elsewhere on the board
/b0: J1.3; also elsewhere on the board
/b1: J1.5; also elsewhere on the board
/b2: J1.7; also elsewhere on the board
/b3: J1.9; also elsewhere on the board
/b4: J1.4; also elsewhere on the board
/b5: J1.6; also elsewhere on the board
/b6: J1.8; also elsewhere on the board
/b7: J1.10; also elsewhere on the board
/carry_in: J1.33; also elsewhere on the board
/flags0: J1.35; also elsewhere on the board
/flags1: J1.36; also elsewhere on the board
/flags3: J1.38; also elsewhere on the board
/invert: J1.31; also elsewhere on the board
/op0: J1.27; also elsewhere on the board
/op1: J1.28; also elsewhere on the board
/op3: J1.30; also elsewhere on the board
/r0: J1.11; also elsewhere on the board
/r1: J1.12; also elsewhere on the board
/r2: J1.13; also elsewhere on the board
/r3: J1.14; also elsewhere on the board
/r4: J1.15; also elsewhere on the board
/r5: J1.16; also elsewhere on the board
/r6: J1.17; also elsewhere on the board
/~oe: J1.32; also elsewhere on the board
GND: J1.2, J1.39; also elsewhere on the board
VCC: J1.1, J1.40; also elsewhere on the board

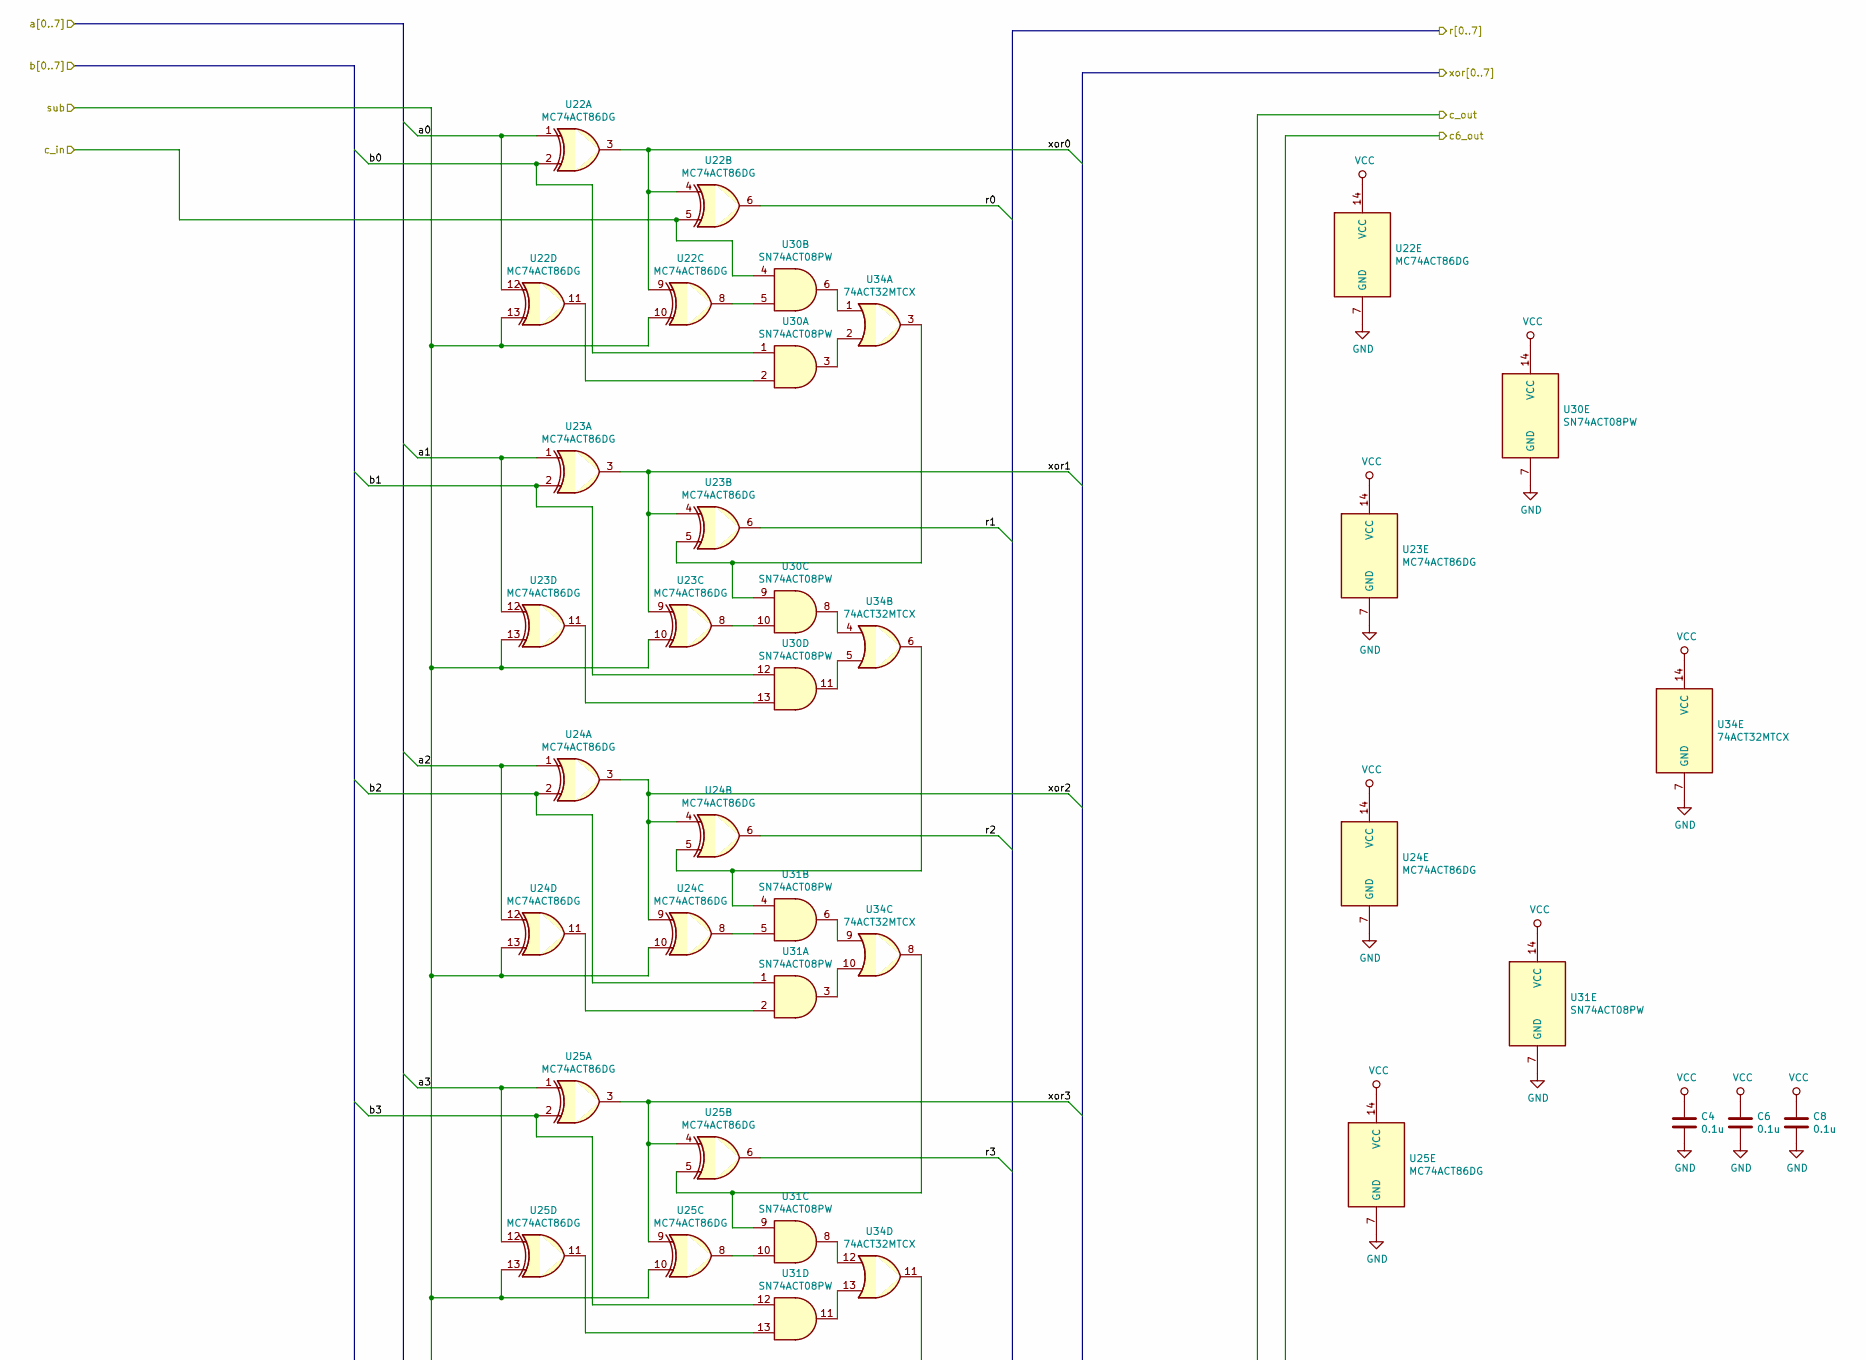
[picture p66: schematic adder.sch, part in row 1, column 1]

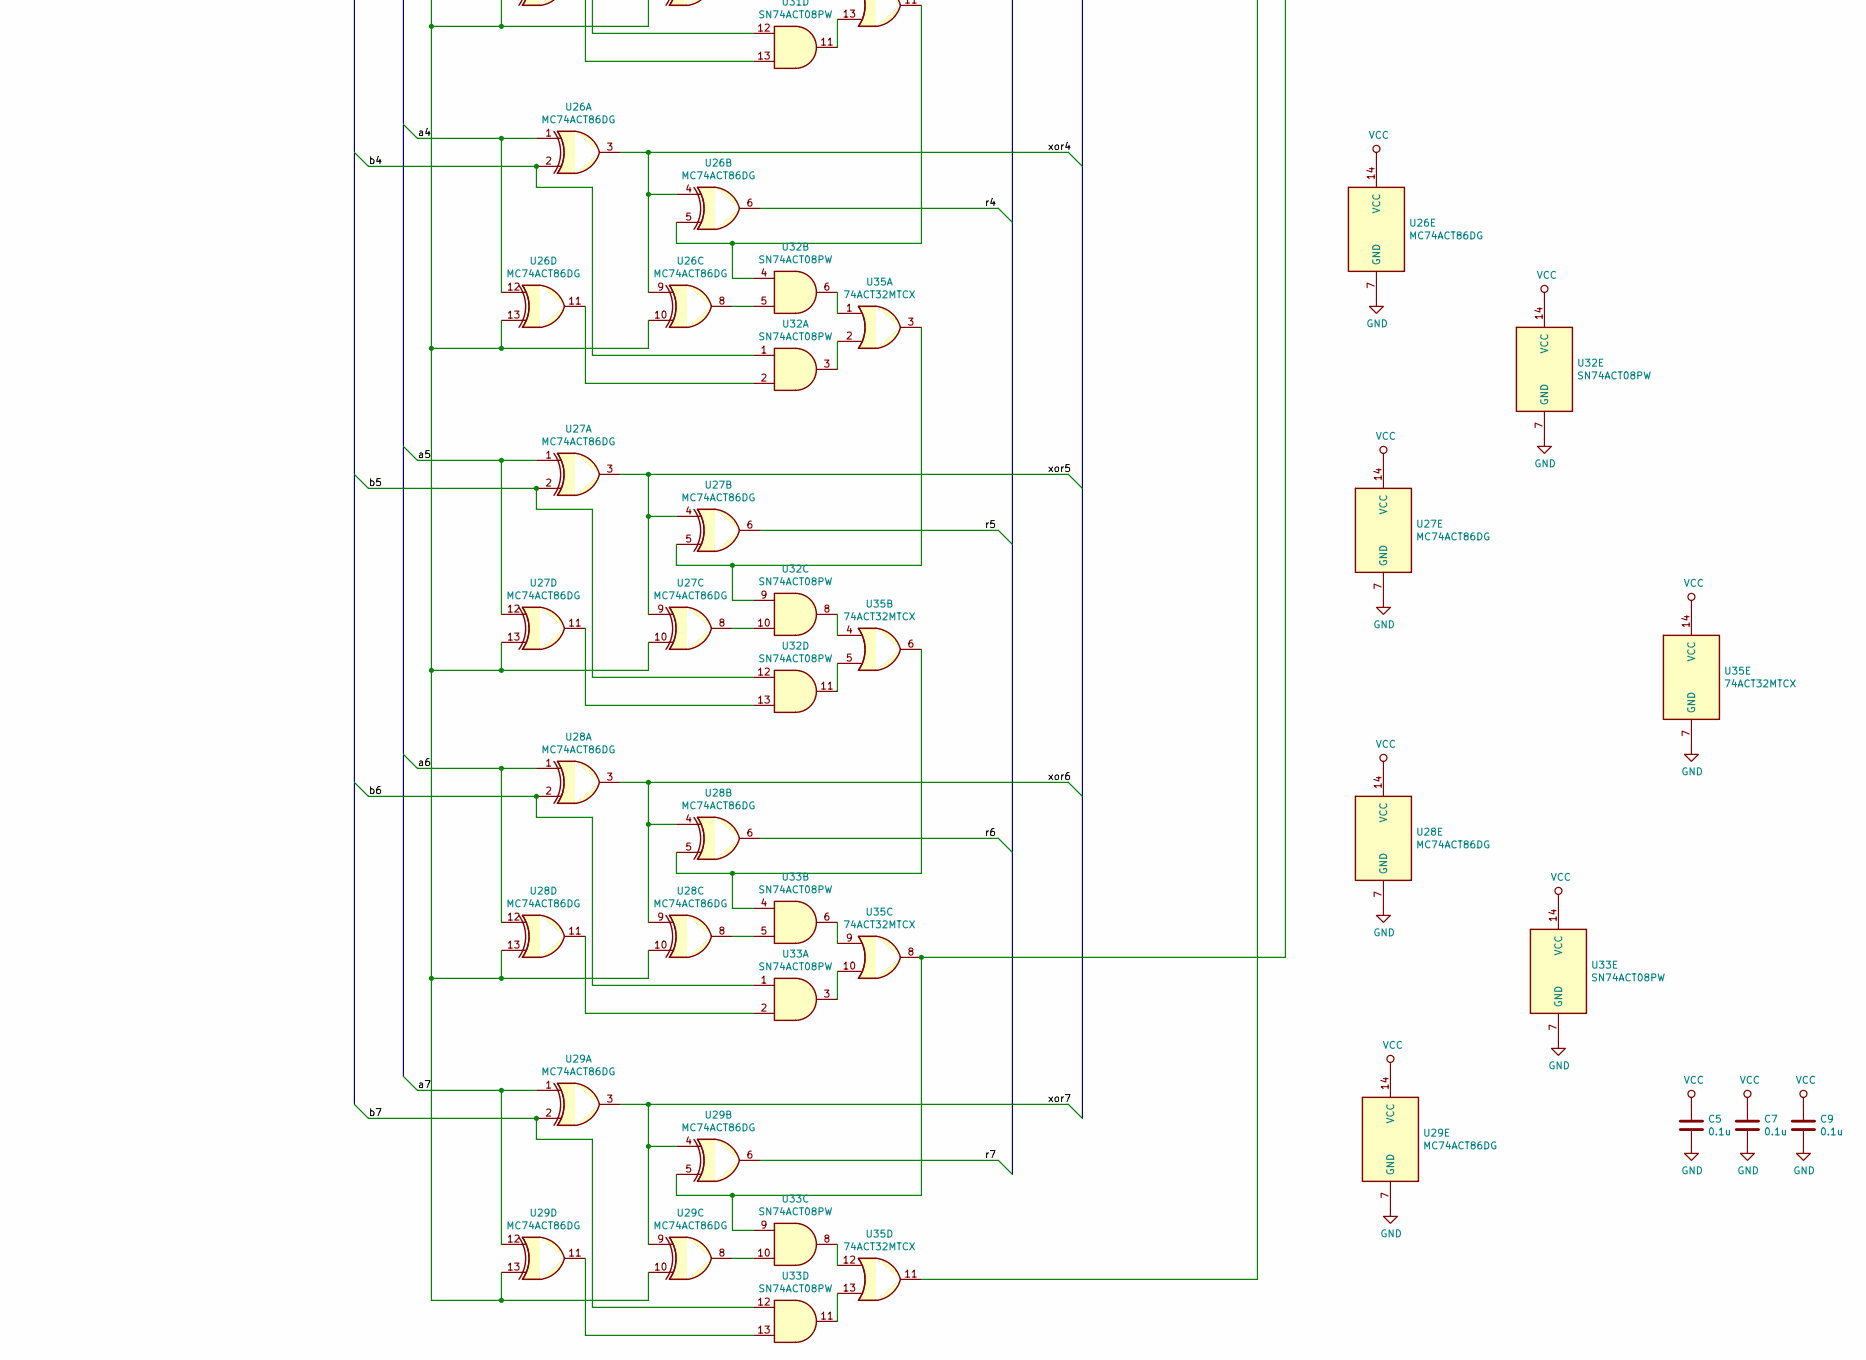
[picture p67: schematic adder.sch, part in row 2, column 1]

Parts:
C4, C5, C6, C7, C8, C9: 0.1u; C_0805_2012Metric
U22, U23, U24, U25, U26, U27, U28, U29: MC74ACT86DG; SOIC-14_3.9x8.7mm_P1.27mm
U30, U31, U32, U33: SN74ACT08PW; TSSOP-14_4.4x5mm_P0.65mm
U34, U35: 74ACT32MTCX; TSSOP-14_4.4x5mm_P0.65mm

Connections:
/adder_b0: U22.2, U30.1; also elsewhere on the board
/adder_b1: U23.2, U30.12; also elsewhere on the board
/adder_b2: U24.2, U31.1; also elsewhere on the board
/adder_b3: U25.2, U31.12; also elsewhere on the board
/adder_b4: U26.2, U32.1; also elsewhere on the board
/adder_b5: U27.2, U32.12; also elsewhere on the board
/adder_b6: U28.2, U33.1; also elsewhere on the board
/adder_b7: U29.2, U33.12; also elsewhere on the board
/adder_c6_out: U29.5, U33.9, U35.8; also elsewhere on the board
/adder_c_in: U22.5, U30.4; also elsewhere on the board
/adder_c_out: U35.11; also elsewhere on the board
/adder_r0: U22.6; also elsewhere on the board
/adder_r1: U23.6; also elsewhere on the board
/adder_r2: U24.6; also elsewhere on the board
/adder_r3: U25.6; also elsewhere on the board
/adder_r4: U26.6; also elsewhere on the board
/adder_r5: U27.6; also elsewhere on the board
/adder_r6: U28.6; also elsewhere on the board
/adder_r7: U29.6; also elsewhere on the board
/adder_sub: U22.10, U22.13, U23.10, U23.13, U24.10, U24.13, U25.10, U25.13, U26.10, U26.13, U27.10, U27.13, U28.10, U28.13, U29.10, U29.13; also elsewhere on the board
/sa0: U22.1, U22.12; also elsewhere on the board
/sa1: U23.1, U23.12; also elsewhere on the board
/sa2: U24.1, U24.12; also elsewhere on the board
/sa3: U25.1, U25.12; also elsewhere on the board
/sa4: U26.1, U26.12; also elsewhere on the board
/sa5: U27.1, U27.12; also elsewhere on the board
/sa6: U28.1, U28.12; also elsewhere on the board
/sa7: U29.1, U29.12; also elsewhere on the board
/xor_r0: U22.3, U22.4, U22.9; also elsewhere on the board
/xor_r1: U23.3, U23.4, U23.9; also elsewhere on the board
/xor_r2: U24.3, U24.4, U24.9; also elsewhere on the board
/xor_r3: U25.3, U25.4, U25.9; also elsewhere on the board
/xor_r4: U26.3, U26.4, U26.9; also elsewhere on the board
/xor_r5: U27.3, U27.4, U27.9; also elsewhere on the board
/xor_r6: U28.3, U28.4, U28.9; also elsewhere on the board
/xor_r7: U29.3, U29.4, U29.9; also elsewhere on the board
GND: C4.2, C5.2, C6.2, C7.2, C8.2, C9.2, U22.7 (GND), U23.7 (GND), U24.7 (GND), U25.7 (GND), U26.7 (GND), U27.7 (GND), U28.7 (GND), U29.7 (GND), U30.7 (GND), U31.7 (GND), U32.7 (GND), U33.7 (GND), U34.7 (GND), U35.7 (GND); also elsewhere on the board
unnamed: U22.8, U30.5
unnamed: U22.11, U30.2
unnamed: U23.5, U30.9, U34.3
unnamed: U23.8, U30.10
unnamed: U23.11, U30.13
unnamed: U24.5, U31.4, U34.6
unnamed: U24.8, U31.5
unnamed: U24.11, U31.2
unnamed: U25.5, U31.9, U34.8
unnamed: U25.8, U31.10
unnamed: U25.11, U31.13
unnamed: U26.5, U32.4, U34.11
unnamed: U26.8, U32.5
unnamed: U26.11, U32.2
unnamed: U27.5, U32.9, U35.3
unnamed: U27.8, U32.10
unnamed: U27.11, U32.13
unnamed: U28.5, U33.4, U35.6
unnamed: U28.8, U33.5
unnamed: U28.11, U33.2
unnamed: U29.8, U33.10
unnamed: U29.11, U33.13
unnamed: U30.3, U34.2
unnamed: U30.6, U34.1
unnamed: U30.8, U34.4
unnamed: U30.11, U34.5
unnamed: U31.3, U34.10
unnamed: U31.6, U34.9
unnamed: U31.8, U34.12
unnamed: U31.11, U34.13
unnamed: U32.3, U35.2
unnamed: U32.6, U35.1
unnamed: U32.8, U35.4
unnamed: U32.11, U35.5
unnamed: U33.3, U35.10
unnamed: U33.6, U35.9
unnamed: U33.8, U35.12
unnamed: U33.11, U35.13
VCC: C4.1, C5.1, C6.1, C7.1, C8.1, C9.1, U22.14 (VCC), U23.14 (VCC), U24.14 (VCC), U25.14 (VCC), U26.14 (VCC), U27.14 (VCC), U28.14 (VCC), U29.14 (VCC), U30.14 (VCC), U31.14 (VCC), U32.14 (VCC), U33.14 (VCC), U34.14 (VCC), U35.14 (VCC); also elsewhere on the board

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
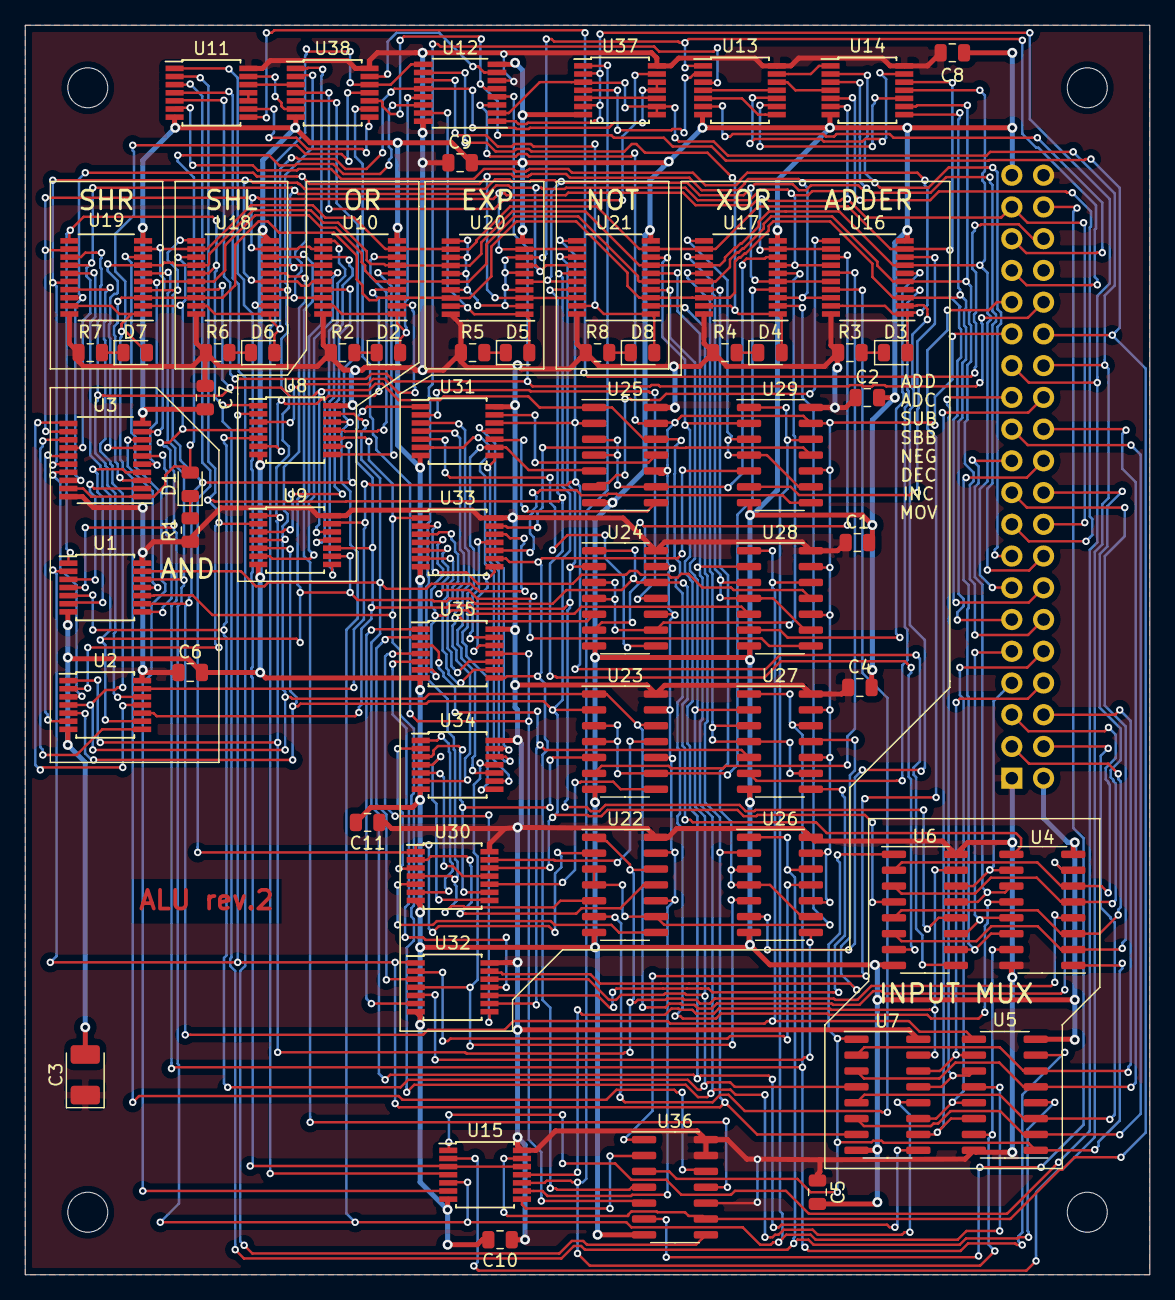
[picture p68: board alu.kicad_pcb from above]

Board: 2 copper layers, 90.0 x 100.0 mm, 70 parts (1 on the bottom side), 165 nets.
