imihajlow/ccpu/app/z80/z80main.asm

    .global z80_f
    .global z80_a
    .global z80_bc
    .global z80_c
    .global z80_b
    .global z80_de
    .global z80_e
    .global z80_d
    .global z80_hl
    .global z80_l
    .global z80_h
    .global z80_f_s
    .global z80_a_s
    .global z80_bc_s
    .global z80_c_s
    .global z80_b_s
    .global z80_de_s
    .global z80_e_s
    .global z80_d_s
    .global z80_hl_s
    .global z80_l_s
    .global z80_h_s
    .global z80_ix
    .global z80_iy
    .global z80_sp
    .global z80_i
    .global z80_r
    .global z80_pc
    .global z80_current_opcode
    .global z80_prefix
    .global z80_prefix_ed
    .global z80_prefix_dd
    .global z80_prefix_fd
    .global z80_imm0
    .global z80_imm1

    .export z80_reset_prefix
    .export z80_not_implemented

    ; in z80ld.asm
    .global opcode_ld_rr
    .global opcode_ld_r_indir
    .global opcode_ld_indir_r
    .global opcode_ld_indir_bc_a
    .global opcode_ld_indir_de_a
    .global opcode_ld_r_imm
    .global opcode_ld_indir_imm
    .global opcode_ld_a_imm_indir
    .global opcode_ld_a_imm_bc
    .global opcode_ld_a_imm_de
    .global opcode_ld_indir_imm_a

    ; in z80arithm8.asm
    .global opcode_arithm8_common
    .global opcode_arithm8_imm
    .global opcode_arithm8_indir
    .global opcode_inc_r
    .global opcode_inc_r_common
    .global opcode_dec_r
    .global opcode_dec_r_common
    .global opcode_inc_indirect
    .global opcode_dec_indirect

    ; in z80ld16.asm
    .global opcode_ld_bc_imm16
    .global opcode_ld_de_imm16
    .global opcode_ld_hl_imm16
    .global opcode_ld_sp_imm16
    .global opcode_ld_bc_indir_imm16
    .global opcode_ld_de_indir_imm16
    .global opcode_ld_sp_indir_imm16
    .global opcode_ld_hl_indir_imm16
    .global opcode_ld_indir_bc
    .global opcode_ld_indir_de
    .global opcode_ld_indir_sp
    .global opcode_ld_indir_hl
    .global opcode_ld_sp_r

    ; in z80push.asm
    .global opcode_push
    .global opcode_pop_af
    .global opcode_pop_bc
    .global opcode_pop_de
    .global opcode_pop_hl_common

    ; in z80arithm16.asm
    .global opcode_add_bc_16
    .global opcode_add_de_16
    .global opcode_add_sp_16
    .global opcode_add_hl_hl_16
    .global opcode_adc_hl_bc
    .global opcode_adc_hl_sp
    .global opcode_adc_hl_de
    .global opcode_adc_hl_hl
    .global opcode_sbc_hl_bc
    .global opcode_sbc_hl_de
    .global opcode_sbc_hl_sp
    .global opcode_sbc_hl_hl
    .global opcode_inc_bc
    .global opcode_inc_de
    .global opcode_inc_hl
    .global opcode_inc_sp
    .global opcode_dec_bc
    .global opcode_dec_de
    .global opcode_dec_hl
    .global opcode_dec_sp

    ; in z80ex.asm
    .global opcode_ex_de_hl
    .global opcode_exx
    .global opcode_ex_af
    .global opcode_ex_hl_stack

    ; in z80bit.asm
    .global opcode_cb

    ; in z80jp.asm
    .global opcode_jp
    .global opcode_jp_c
    .global opcode_jp_nc
    .global opcode_jp_z
    .global opcode_jp_nz
    .global opcode_jp_pe
    .global opcode_jp_po
    .global opcode_jp_p
    .global opcode_jp_m
    .global opcode_jr
    .global opcode_jr_c
    .global opcode_jr_nc
    .global opcode_jr_z
    .global opcode_jr_nz
    .global opcode_jp_indir
    .global opcode_djnz
    .global opcode_call
    .global opcode_call_c
    .global opcode_call_nc
    .global opcode_call_z
    .global opcode_call_nz
    .global opcode_call_pe
    .global opcode_call_po
    .global opcode_call_p
    .global opcode_call_m
    .global opcode_ret
    .global opcode_ret_c
    .global opcode_ret_nc
    .global opcode_ret_z
    .global opcode_ret_nz
    .global opcode_ret_pe
    .global opcode_ret_po
    .global opcode_ret_p
    .global opcode_ret_m

    ; in z80rst.asm
    .global opcode_rst_00
    .global opcode_rst_08
    .global opcode_rst_10
    .global opcode_rst_18
    .global opcode_rst_20
    .global opcode_rst_28
    .global opcode_rst_30
    .global opcode_rst_38

    ; in z80af.asm
    .global opcode_cpl
    .global opcode_neg
    .global opcode_ccf
    .global opcode_scf

    ; in z80block.asm
    .global opcode_ldi
    .global opcode_ldd
    .global opcode_ldir
    .global opcode_lddr

    ; in z80shift.asm
    .global opcode_rlca
    .global opcode_rla
    .global opcode_rra

    .global z80_halt_handler

    .section text.fetch
z80_reset_prefix:
    ldi ph, hi(z80_prefix)
    ldi pl, lo(z80_prefix)
    mov a, 0
    st a

fetch:
    ; load opcode and store it
    ldi pl, lo(z80_pc + 1)
    ldi ph, hi(z80_pc)
    ld a
    dec pl
    ld pl
    mov ph, a
    ld b
    ldi pl, lo(z80_current_opcode)
    ldi ph, hi(z80_current_opcode)
    st b
    ; increment PC
    ldi pl, lo(z80_pc)
    ld b
    inc b
    adc a, 0 ; a is still hi(PC)
    st b
    inc pl
    st a
    ; load stored opcode
    ldi pl, lo(z80_current_opcode)
    ld  pl
    ; check instruction format
    ldi ph, hi(instr_fmt)
    ld  b

    ; b = adjusted instruction format code
check_instr_fmt:
    ldi a, 0x3
    and b, a
    ldi pl, lo(tablejump)
    ldi ph, hi(tablejump)
    jz  ; instruction with no immediate
    dec b
    ldi pl, lo(fetch_imm_1)
    ldi ph, hi(fetch_imm_1)
    jz  ; one byte immediate
    ; else two bytes immediate

    ; load 2 imm bytes
    ldi pl, lo(z80_pc + 1)
    ldi ph, hi(z80_pc)
    ld  a
    dec pl
    ld  pl
    mov ph, a
    ld  b
    inc pl
    adc a, 0
    mov ph, a
    ld  a
    ; store them
    ldi pl, lo(z80_imm0)
    ldi ph, hi(z80_imm0)
    st  b
    inc pl
    st  a
    ; PC += 2
    ldi pl, lo(z80_pc)
    ld  b
    ldi a, 2
    add b, a
    st  b
    ldi pl, (z80_pc + 1)
    ld  a
    adc a, 0
    st  a
    ldi pl, lo(tablejump)
    ldi ph, hi(tablejump)
    jmp

fetch_imm_1:
    ; load 1 imm byte
    ldi pl, lo(z80_pc + 1)
    ldi ph, hi(z80_pc)
    ld  a
    dec pl
    ld  pl
    mov ph, a
    ld  b
    ; store it
    ldi pl, lo(z80_imm0)
    ldi ph, hi(z80_imm0)
    st  b
    ; increment PC
    ldi pl, lo(z80_pc)
    ld  b
    inc b
    adc a, 0 ; a is already hi(PC)
    st  b
    inc pl
    st  a

    ; jump to the callback according to the table
tablejump:
    ldi pl, lo(z80_current_opcode)
    ldi ph, hi(z80_current_opcode)
    ld  pl
    shl pl
    ldi a, hi(jump_table)
    adc a, 0
    mov ph, a
    ld a
    inc pl
    ld ph
    mov pl, a
    jmp

    .section text.check_instr_fmt_ed
    ; b = current opcode (after ED)
check_instr_fmt_ed:
    ; ED with 43, 4B, 53, 5B, 73, 7B has 2-byte immediate
    ; ED 63 and ED 6B do not exist - we can assume 2-byte immediate as well
    ; The rest don't have an immediate
    ; Opcodes with 2-byte immediate:
    ; 01xxx011
    ldi a, 0xc7
    and b, a
    ldi a, 0x43
    sub b, a
    ldi ph, hi(tablejump_ed)
    ldi pl, lo(tablejump_ed)
    jnz

    ; load 2 imm bytes
    ldi pl, lo(z80_pc + 1)
    ldi ph, hi(z80_pc)
    ld  a
    dec pl
    ld  pl
    mov ph, a
    ld  b
    inc pl
    adc a, 0
    mov ph, a
    ld  a
    ; store them
    ldi pl, lo(z80_imm0)
    ldi ph, hi(z80_imm0)
    st  b
    inc pl
    st  a
    ; PC += 2
    ldi pl, lo(z80_pc)
    ld  b
    ldi a, 2
    add b, a
    st  b
    ldi pl, (z80_pc + 1)
    ld  a
    adc a, 0
    st  a

tablejump_ed:
    ldi pl, lo(z80_current_opcode)
    ldi ph, hi(z80_current_opcode)
    ld  pl
    shl pl
    ldi a, hi(jump_table_ed)
    adc a, 0
    mov ph, a
    ld a
    inc pl
    ld ph
    mov pl, a
    jmp

    .section text.not_implemented
not_implemented:
z80_not_implemented:
    ldi pl, lo(not_implemented)
    ldi ph, hi(not_implemented)
    jmp

    .section text.opcode_ed
opcode_ed:
    ldi pl, lo(z80_prefix)
    ldi ph, hi(z80_prefix)
    ldi a, z80_prefix_ed
    st a
    ; load opcode and store it
    ldi pl, lo(z80_pc + 1)
    ldi ph, hi(z80_pc)
    ld a
    dec pl
    ld pl
    mov ph, a
    ld b
    ldi pl, lo(z80_current_opcode)
    ldi ph, hi(z80_current_opcode)
    st b
    ; increment PC
    ldi pl, lo(z80_pc)
    ld b
    inc b
    adc a, 0 ; a is still hi(PC)
    st b
    inc pl
    st a
    ; load stored opcode
    ldi pl, lo(z80_current_opcode)
    ld  b
    ldi pl, lo(check_instr_fmt_ed)
    ldi ph, hi(check_instr_fmt_ed)
    jmp

    .section text.opcode_dd
opcode_dd:
    ldi pl, lo(z80_prefix)
    ldi ph, hi(z80_prefix)
    ldi a, z80_prefix_dd
    st a
fetch_dd:
    ; load opcode and store it
    ldi pl, lo(z80_pc + 1)
    ldi ph, hi(z80_pc)
    ld a
    dec pl
    ld pl
    mov ph, a
    ld b
    ldi pl, lo(z80_current_opcode)
    ldi ph, hi(z80_current_opcode)
    st b
    ; increment PC
    ldi pl, lo(z80_pc)
    ld b
    inc b
    adc a, 0 ; a is still hi(PC)
    st b
    inc pl
    st a
    ; load stored opcode
    ldi pl, lo(z80_current_opcode)
    ld  pl
    ; check instruction format
    ldi ph, hi(instr_fmt)
    ld  b
    shr b
    shr b
    shr b
    shr b
    ldi pl, lo(check_instr_fmt)
    ldi ph, hi(check_instr_fmt)
    jmp

    .section text.opcode_fd
opcode_fd:
    ldi pl, lo(z80_prefix)
    ldi ph, hi(z80_prefix)
    ldi a, z80_prefix_fd
    st a
    ldi pl, lo(fetch_dd)
    ldi ph, hi(fetch_dd)
    jmp
    
    ; jump table for no prefix, DD or FD
    .section text.jump_table
    .align 256
jump_table:
    dw fetch                ; 00 - NOP
    dw opcode_ld_bc_imm16      ; 01
    dw opcode_ld_indir_bc_a ; 02
    dw opcode_inc_bc      ; 03
    dw opcode_inc_r_common      ; 04
    dw opcode_dec_r_common      ; 05
    dw opcode_ld_r_imm      ; 06
    dw opcode_rlca      ; 07
    dw opcode_ex_af      ; 08
    dw opcode_add_bc_16      ; 09
    dw opcode_ld_a_imm_bc      ; 0A
    dw opcode_dec_bc      ; 0B
    dw opcode_inc_r_common      ; 0C
    dw opcode_dec_r_common      ; 0D
    dw opcode_ld_r_imm      ; 0E
    dw not_implemented      ; 0F
    dw opcode_djnz      ; 10
    dw opcode_ld_de_imm16      ; 11
    dw opcode_ld_indir_de_a ; 12
    dw opcode_inc_de      ; 13
    dw opcode_inc_r_common      ; 14
    dw opcode_dec_r_common      ; 15
    dw opcode_ld_r_imm      ; 16
    dw opcode_rla      ; 17
    dw opcode_jr      ; 18
    dw opcode_add_de_16      ; 19
    dw opcode_ld_a_imm_de      ; 1A
    dw opcode_dec_de      ; 1B
    dw opcode_inc_r_common      ; 1C
    dw opcode_dec_r_common      ; 1D
    dw opcode_ld_r_imm      ; 1E
    dw opcode_rra      ; 1F
    dw opcode_jr_nz      ; 20
    dw opcode_ld_hl_imm16      ; 21
    dw opcode_ld_indir_hl      ; 22
    dw opcode_inc_hl      ; 23
    dw opcode_inc_r      ; 24
    dw opcode_dec_r      ; 25
    dw opcode_ld_r_imm      ; 26
    dw not_implemented      ; 27
    dw opcode_jr_z      ; 28
    dw opcode_add_hl_hl_16      ; 29
    dw opcode_ld_hl_indir_imm16      ; 2A
    dw opcode_dec_hl      ; 2B
    dw opcode_inc_r      ; 2C
    dw opcode_dec_r      ; 2D
    dw opcode_ld_r_imm      ; 2E
    dw opcode_cpl      ; 2F
    dw opcode_jr_nc      ; 30
    dw opcode_ld_sp_imm16      ; 31
    dw opcode_ld_indir_imm_a      ; 32
    dw opcode_inc_sp      ; 33
    dw opcode_inc_indirect      ; 34
    dw opcode_dec_indirect      ; 35
    dw opcode_ld_indir_imm  ; 36
    dw opcode_scf      ; 37
    dw opcode_jr_c      ; 38
    dw opcode_add_sp_16      ; 39
    dw opcode_ld_a_imm_indir      ; 3A
    dw opcode_dec_sp      ; 3B
    dw opcode_inc_r_common      ; 3C
    dw opcode_dec_r_common      ; 3D
    dw opcode_ld_r_imm      ; 3E
    dw opcode_ccf      ; 3F
    dw opcode_ld_rr             ; 40
    dw opcode_ld_rr             ; 41
    dw opcode_ld_rr             ; 42
    dw opcode_ld_rr             ; 43
    dw opcode_ld_rr             ; 44
    dw opcode_ld_rr             ; 45
    dw opcode_ld_r_indir        ; 46
    dw opcode_ld_rr             ; 47
    dw opcode_ld_rr             ; 48
    dw opcode_ld_rr             ; 49
    dw opcode_ld_rr             ; 4A
    dw opcode_ld_rr             ; 4B
    dw opcode_ld_rr             ; 4C
    dw opcode_ld_rr             ; 4D
    dw opcode_ld_r_indir        ; 4E
    dw opcode_ld_rr             ; 4F
    dw opcode_ld_rr             ; 50
    dw opcode_ld_rr             ; 51
    dw opcode_ld_rr             ; 52
    dw opcode_ld_rr             ; 53
    dw opcode_ld_rr             ; 54
    dw opcode_ld_rr             ; 55
    dw opcode_ld_r_indir        ; 56
    dw opcode_ld_rr             ; 57
    dw opcode_ld_rr             ; 58
    dw opcode_ld_rr             ; 59
    dw opcode_ld_rr             ; 5A
    dw opcode_ld_rr             ; 5B
    dw opcode_ld_rr             ; 5C
    dw opcode_ld_rr             ; 5D
    dw opcode_ld_r_indir        ; 5E
    dw opcode_ld_rr             ; 5F
    dw opcode_ld_rr             ; 60
    dw opcode_ld_rr             ; 61
    dw opcode_ld_rr             ; 62
    dw opcode_ld_rr             ; 63
    dw opcode_ld_rr             ; 64
    dw opcode_ld_rr             ; 65
    dw opcode_ld_r_indir        ; 66
    dw opcode_ld_rr             ; 67
    dw opcode_ld_rr             ; 68
    dw opcode_ld_rr             ; 69
    dw opcode_ld_rr             ; 6A
    dw opcode_ld_rr             ; 6B
    dw opcode_ld_rr             ; 6C
    dw opcode_ld_rr             ; 6D
    dw opcode_ld_r_indir        ; 6E
    dw opcode_ld_rr             ; 6F
    dw opcode_ld_indir_r        ; 70
    dw opcode_ld_indir_r        ; 71
    dw opcode_ld_indir_r        ; 72
    dw opcode_ld_indir_r        ; 73
    dw opcode_ld_indir_r        ; 74
    dw opcode_ld_indir_r        ; 75
    dw z80_halt_handler         ; 76
    dw opcode_ld_indir_r        ; 77
    dw opcode_ld_rr             ; 78
    dw opcode_ld_rr             ; 79
    dw opcode_ld_rr             ; 7A
    dw opcode_ld_rr             ; 7B
    dw opcode_ld_rr             ; 7C
    dw opcode_ld_rr             ; 7D
    dw opcode_ld_r_indir        ; 7E
    dw opcode_ld_rr             ; 7F
    dw opcode_arithm8_common      ; 80
    dw opcode_arithm8_common      ; 81
    dw opcode_arithm8_common      ; 82
    dw opcode_arithm8_common      ; 83
    dw opcode_arithm8_common      ; 84
    dw opcode_arithm8_common      ; 85
    dw opcode_arithm8_indir      ; 86
    dw opcode_arithm8_common      ; 87
    dw opcode_arithm8_common      ; 88
    dw opcode_arithm8_common      ; 89
    dw opcode_arithm8_common      ; 8A
    dw opcode_arithm8_common      ; 8B
    dw opcode_arithm8_common      ; 8C
    dw opcode_arithm8_common      ; 8D
    dw opcode_arithm8_indir      ; 8E
    dw opcode_arithm8_common      ; 8F
    dw opcode_arithm8_common      ; 90
    dw opcode_arithm8_common      ; 91
    dw opcode_arithm8_common      ; 92
    dw opcode_arithm8_common      ; 93
    dw opcode_arithm8_common      ; 94
    dw opcode_arithm8_common      ; 95
    dw opcode_arithm8_indir      ; 96
    dw opcode_arithm8_common      ; 97
    dw opcode_arithm8_common      ; 98
    dw opcode_arithm8_common      ; 99
    dw opcode_arithm8_common      ; 9A
    dw opcode_arithm8_common      ; 9B
    dw opcode_arithm8_common      ; 9C
    dw opcode_arithm8_common      ; 9D
    dw opcode_arithm8_indir      ; 9E
    dw opcode_arithm8_common      ; 9F
    dw opcode_arithm8_common      ; A0
    dw opcode_arithm8_common      ; A1
    dw opcode_arithm8_common      ; A2
    dw opcode_arithm8_common      ; A3
    dw opcode_arithm8_common      ; A4
    dw opcode_arithm8_common      ; A5
    dw opcode_arithm8_indir      ; A6
    dw opcode_arithm8_common      ; A7
    dw opcode_arithm8_common      ; A8
    dw opcode_arithm8_common      ; A9
    dw opcode_arithm8_common      ; AA
    dw opcode_arithm8_common      ; AB
    dw opcode_arithm8_common      ; AC
    dw opcode_arithm8_common      ; AD
    dw opcode_arithm8_indir      ; AE
    dw opcode_arithm8_common      ; AF
    dw opcode_arithm8_common      ; B0
    dw opcode_arithm8_common      ; B1
    dw opcode_arithm8_common      ; B2
    dw opcode_arithm8_common      ; B3
    dw opcode_arithm8_common      ; B4
    dw opcode_arithm8_common      ; B5
    dw opcode_arithm8_indir      ; B6
    dw opcode_arithm8_common      ; B7
    dw opcode_arithm8_common      ; B8
    dw opcode_arithm8_common      ; B9
    dw opcode_arithm8_common      ; BA
    dw opcode_arithm8_common      ; BB
    dw opcode_arithm8_common      ; BC
    dw opcode_arithm8_common      ; BD
    dw opcode_arithm8_indir      ; BE
    dw opcode_arithm8_common      ; BF
    dw opcode_ret_nz      ; C0
    dw opcode_pop_bc      ; C1
    dw opcode_jp_nz      ; C2
    dw opcode_jp      ; C3
    dw opcode_call_nz      ; C4
    dw opcode_push      ; C5
    dw opcode_arithm8_imm      ; C6
    dw opcode_rst_00      ; C7
    dw opcode_ret_z      ; C8
    dw opcode_ret      ; C9
    dw opcode_jp_z      ; CA
    dw opcode_cb      ; CB
    dw opcode_call_z      ; CC
    dw opcode_call      ; CD
    dw opcode_arithm8_imm      ; CE
    dw opcode_rst_08      ; CF
    dw opcode_ret_nc      ; D0
    dw opcode_pop_de      ; D1
    dw opcode_jp_nc      ; D2
    dw not_implemented      ; D3
    dw opcode_call_nc      ; D4
    dw opcode_push      ; D5
    dw opcode_arithm8_imm      ; D6
    dw opcode_rst_10      ; D7
    dw opcode_ret_c      ; D8
    dw opcode_exx      ; D9
    dw opcode_jp_c      ; DA
    dw not_implemented      ; DB
    dw opcode_call_c      ; DC
    dw opcode_dd            ; DD
    dw opcode_arithm8_imm      ; DE
    dw opcode_rst_18      ; DF
    dw opcode_ret_po      ; E0
    dw opcode_pop_hl_common      ; E1
    dw opcode_jp_po      ; E2
    dw opcode_ex_hl_stack      ; E3
    dw opcode_call_po      ; E4
    dw opcode_push      ; E5
    dw opcode_arithm8_imm      ; E6
    dw opcode_rst_20      ; E7
    dw opcode_ret_pe      ; E8
    dw opcode_jp_indir      ; E9
    dw opcode_jp_pe      ; EA
    dw opcode_ex_de_hl      ; EB
    dw opcode_call_pe      ; EC
    dw opcode_ed            ; ED
    dw opcode_arithm8_imm      ; EE
    dw opcode_rst_28      ; EF
    dw opcode_ret_p      ; F0
    dw opcode_pop_af      ; F1
    dw opcode_jp_p      ; F2
    dw z80_reset_prefix      ; F3
    dw opcode_call_p      ; F4
    dw opcode_push      ; F5
    dw opcode_arithm8_imm      ; F6
    dw opcode_rst_30      ; F7
    dw opcode_ret_m      ; F8
    dw opcode_ld_sp_r      ; F9
    dw opcode_jp_m      ; FA
    dw z80_reset_prefix      ; FB
    dw opcode_call_m      ; FC
    dw opcode_fd            ; FD
    dw opcode_arithm8_imm      ; FE
    dw opcode_rst_38      ; FF

    ; jump table for instructions with the ED prefix
jump_table_ed:
    dw not_implemented  ; 00
    dw not_implemented  ; 01
    dw not_implemented  ; 02
    dw not_implemented  ; 03
    dw not_implemented  ; 04
    dw not_implemented  ; 05
    dw not_implemented  ; 06
    dw not_implemented  ; 07
    dw not_implemented  ; 08
    dw not_implemented  ; 09
    dw not_implemented  ; 0A
    dw not_implemented  ; 0B
    dw not_implemented  ; 0C
    dw not_implemented  ; 0D
    dw not_implemented  ; 0E
    dw not_implemented  ; 0F
    dw not_implemented  ; 10
    dw not_implemented  ; 11
    dw not_implemented  ; 12
    dw not_implemented  ; 13
    dw not_implemented  ; 14
    dw not_implemented  ; 15
    dw not_implemented  ; 16
    dw not_implemented  ; 17
    dw not_implemented  ; 18
    dw not_implemented  ; 19
    dw not_implemented  ; 1A
    dw not_implemented  ; 1B
    dw not_implemented  ; 1C
    dw not_implemented  ; 1D
    dw not_implemented  ; 1E
    dw not_implemented  ; 1F
    dw not_implemented  ; 20
    dw not_implemented  ; 21
    dw not_implemented  ; 22
    dw not_implemented  ; 23
    dw not_implemented  ; 24
    dw not_implemented  ; 25
    dw not_implemented  ; 26
    dw not_implemented  ; 27
    dw not_implemented  ; 28
    dw not_implemented  ; 29
    dw not_implemented  ; 2A
    dw not_implemented  ; 2B
    dw not_implemented  ; 2C
    dw not_implemented  ; 2D
    dw not_implemented  ; 2E
    dw not_implemented  ; 2F
    dw not_implemented  ; 30
    dw not_implemented  ; 31
    dw not_implemented  ; 32
    dw not_implemented  ; 33
    dw not_implemented  ; 34
    dw not_implemented  ; 35
    dw not_implemented  ; 36
    dw not_implemented  ; 37
    dw not_implemented  ; 38
    dw not_implemented  ; 39
    dw not_implemented  ; 3A
    dw not_implemented  ; 3B
    dw not_implemented  ; 3C
    dw not_implemented  ; 3D
    dw not_implemented  ; 3E
    dw not_implemented  ; 3F
    dw not_implemented  ; 40
    dw not_implemented  ; 41
    dw opcode_sbc_hl_bc  ; 42
    dw opcode_ld_indir_bc  ; 43
    dw opcode_neg  ; 44
    dw opcode_ret  ; 45
    dw z80_reset_prefix  ; 46
    dw not_implemented  ; 47
    dw not_implemented  ; 48
    dw not_implemented  ; 49
    dw opcode_adc_hl_bc  ; 4A
    dw opcode_ld_bc_indir_imm16  ; 4B
    dw not_implemented  ; 4C
    dw opcode_ret  ; 4D
    dw not_implemented  ; 4E
    dw not_implemented  ; 4F
    dw not_implemented  ; 50
    dw not_implemented  ; 51
    dw opcode_sbc_hl_de  ; 52
    dw opcode_ld_indir_de  ; 53
    dw not_implemented  ; 54
    dw not_implemented  ; 55
    dw z80_reset_prefix  ; 56
    dw not_implemented  ; 57
    dw not_implemented  ; 58
    dw not_implemented  ; 59
    dw opcode_adc_hl_de  ; 5A
    dw opcode_ld_de_indir_imm16  ; 5B
    dw not_implemented  ; 5C
    dw not_implemented  ; 5D
    dw z80_reset_prefix  ; 5E
    dw not_implemented  ; 5F
    dw not_implemented  ; 60
    dw not_implemented  ; 61
    dw opcode_sbc_hl_hl  ; 62
    dw not_implemented  ; 63
    dw not_implemented  ; 64
    dw not_implemented  ; 65
    dw not_implemented  ; 66
    dw not_implemented  ; 67
    dw not_implemented  ; 68
    dw not_implemented  ; 69
    dw opcode_adc_hl_hl  ; 6A
    dw not_implemented  ; 6B
    dw not_implemented  ; 6C
    dw not_implemented  ; 6D
    dw not_implemented  ; 6E
    dw not_implemented  ; 6F
    dw not_implemented  ; 70
    dw not_implemented  ; 71
    dw opcode_sbc_hl_sp  ; 72
    dw opcode_ld_indir_sp  ; 73
    dw not_implemented  ; 74
    dw not_implemented  ; 75
    dw not_implemented  ; 76
    dw not_implemented  ; 77
    dw not_implemented  ; 78
    dw not_implemented  ; 79
    dw opcode_adc_hl_sp  ; 7A
    dw opcode_ld_sp_indir_imm16  ; 7B
    dw not_implemented  ; 7C
    dw not_implemented  ; 7D
    dw not_implemented  ; 7E
    dw not_implemented  ; 7F
    dw not_implemented  ; 80
    dw not_implemented  ; 81
    dw not_implemented  ; 82
    dw not_implemented  ; 83
    dw not_implemented  ; 84
    dw not_implemented  ; 85
    dw not_implemented  ; 86
    dw not_implemented  ; 87
    dw not_implemented  ; 88
    dw not_implemented  ; 89
    dw not_implemented  ; 8A
    dw not_implemented  ; 8B
    dw not_implemented  ; 8C
    dw not_implemented  ; 8D
    dw not_implemented  ; 8E
    dw not_implemented  ; 8F
    dw not_implemented  ; 90
    dw not_implemented  ; 91
    dw not_implemented  ; 92
    dw not_implemented  ; 93
    dw not_implemented  ; 94
    dw not_implemented  ; 95
    dw not_implemented  ; 96
    dw not_implemented  ; 97
    dw not_implemented  ; 98
    dw not_implemented  ; 99
    dw not_implemented  ; 9A
    dw not_implemented  ; 9B
    dw not_implemented  ; 9C
    dw not_implemented  ; 9D
    dw not_implemented  ; 9E
    dw not_implemented  ; 9F
    dw opcode_ldi  ; A0
    dw not_implemented  ; A1
    dw not_implemented  ; A2
    dw not_implemented  ; A3
    dw not_implemented  ; A4
    dw not_implemented  ; A5
    dw not_implemented  ; A6
    dw not_implemented  ; A7
    dw opcode_ldd  ; A8
    dw not_implemented  ; A9
    dw not_implemented  ; AA
    dw not_implemented  ; AB
    dw not_implemented  ; AC
    dw not_implemented  ; AD
    dw not_implemented  ; AE
    dw not_implemented  ; AF
    dw opcode_ldir  ; B0
    dw not_implemented  ; B1
    dw not_implemented  ; B2
    dw not_implemented  ; B3
    dw not_implemented  ; B4
    dw not_implemented  ; B5
    dw not_implemented  ; B6
    dw not_implemented  ; B7
    dw opcode_lddr  ; B8
    dw not_implemented  ; B9
    dw not_implemented  ; BA
    dw not_implemented  ; BB
    dw not_implemented  ; BC
    dw not_implemented  ; BD
    dw not_implemented  ; BE
    dw not_implemented  ; BF
    dw not_implemented  ; C0
    dw not_implemented  ; C1
    dw not_implemented  ; C2
    dw not_implemented  ; C3
    dw not_implemented  ; C4
    dw not_implemented  ; C5
    dw not_implemented  ; C6
    dw not_implemented  ; C7
    dw not_implemented  ; C8
    dw not_implemented  ; C9
    dw not_implemented  ; CA
    dw not_implemented  ; CB
    dw not_implemented  ; CC
    dw not_implemented  ; CD
    dw not_implemented  ; CE
    dw not_implemented  ; CF
    dw not_implemented  ; D0
    dw not_implemented  ; D1
    dw not_implemented  ; D2
    dw not_implemented  ; D3
    dw not_implemented  ; D4
    dw not_implemented  ; D5
    dw not_implemented  ; D6
    dw not_implemented  ; D7
    dw not_implemented  ; D8
    dw not_implemented  ; D9
    dw not_implemented  ; DA
    dw not_implemented  ; DB
    dw not_implemented  ; DC
    dw not_implemented  ; DD
    dw not_implemented  ; DE
    dw not_implemented  ; DF
    dw not_implemented  ; E0
    dw not_implemented  ; E1
    dw not_implemented  ; E2
    dw not_implemented  ; E3
    dw not_implemented  ; E4
    dw not_implemented  ; E5
    dw not_implemented  ; E6
    dw not_implemented  ; E7
    dw not_implemented  ; E8
    dw not_implemented  ; E9
    dw not_implemented  ; EA
    dw not_implemented  ; EB
    dw not_implemented  ; EC
    dw not_implemented  ; ED
    dw not_implemented  ; EE
    dw not_implemented  ; EF
    dw not_implemented  ; F0
    dw not_implemented  ; F1
    dw not_implemented  ; F2
    dw not_implemented  ; F3
    dw not_implemented  ; F4
    dw not_implemented  ; F5
    dw not_implemented  ; F6
    dw not_implemented  ; F7
    dw not_implemented  ; F8
    dw not_implemented  ; F9
    dw not_implemented  ; FA
    dw not_implemented  ; FB
    dw not_implemented  ; FC
    dw not_implemented  ; FD
    dw not_implemented  ; FE
    dw not_implemented  ; FF

    ; Instruction format table
    ; Possible instruction formats:
    ; - no immediate value
    ; - 1 byte immediate value
    ; - 2 byte immediate value (or 2 single byte immediates)
    ; - DDCB/FDCB format: DD CB imm8 op
    ;
    ; DD- and FD-prefixed instructions follow the same format
    ; ED is special
    ; CB has only simple instructions without an immediate - no table needed
    
    .const instr_fmt_no_imm = 0
    .const instr_fmt_imm_1 = 1
    .const instr_fmt_imm_2 = 2
    .const instr_fmt_ed_no_imm = 0 << 2
    .const instr_fmt_ed_imm_2 = 2 << 2
    .const instr_fmt_dd_no_imm = 0 << 4
    .const instr_fmt_dd_imm_1 = 1 << 4
    .const instr_fmt_dd_imm_2 = 2 << 4
    .const instr_fmt_ddcb = 3 << 4

    .section text.instr_fmt
    .align 256
instr_fmt:
    db instr_fmt_no_imm | instr_fmt_ed_no_imm | instr_fmt_dd_no_imm    ; 00
    db instr_fmt_imm_2 | instr_fmt_ed_no_imm | instr_fmt_dd_no_imm    ; 01
    db instr_fmt_no_imm | instr_fmt_ed_no_imm | instr_fmt_dd_no_imm    ; 02
    db instr_fmt_no_imm | instr_fmt_ed_no_imm | instr_fmt_dd_no_imm    ; 03
    db instr_fmt_no_imm | instr_fmt_ed_no_imm | instr_fmt_dd_no_imm    ; 04
    db instr_fmt_no_imm | instr_fmt_ed_no_imm | instr_fmt_dd_no_imm    ; 05
    db instr_fmt_imm_1 | instr_fmt_ed_no_imm | instr_fmt_dd_no_imm    ; 06
    db instr_fmt_no_imm | instr_fmt_ed_no_imm | instr_fmt_dd_no_imm    ; 07
    db instr_fmt_no_imm | instr_fmt_ed_no_imm | instr_fmt_dd_no_imm    ; 08
    db instr_fmt_no_imm | instr_fmt_ed_no_imm | instr_fmt_dd_no_imm    ; 09
    db instr_fmt_no_imm | instr_fmt_ed_no_imm | instr_fmt_dd_no_imm    ; 0A
    db instr_fmt_no_imm | instr_fmt_ed_no_imm | instr_fmt_dd_no_imm    ; 0B
    db instr_fmt_no_imm | instr_fmt_ed_no_imm | instr_fmt_dd_no_imm    ; 0C
    db instr_fmt_no_imm | instr_fmt_ed_no_imm | instr_fmt_dd_no_imm    ; 0D
    db instr_fmt_imm_1 | instr_fmt_ed_no_imm | instr_fmt_dd_no_imm    ; 0E
    db instr_fmt_no_imm | instr_fmt_ed_no_imm | instr_fmt_dd_no_imm    ; 0F
    db instr_fmt_imm_1 | instr_fmt_ed_no_imm | instr_fmt_dd_no_imm    ; 10
    db instr_fmt_imm_2 | instr_fmt_ed_no_imm | instr_fmt_dd_no_imm    ; 11
    db instr_fmt_no_imm | instr_fmt_ed_no_imm | instr_fmt_dd_no_imm    ; 12
    db instr_fmt_no_imm | instr_fmt_ed_no_imm | instr_fmt_dd_no_imm    ; 13
    db instr_fmt_no_imm | instr_fmt_ed_no_imm | instr_fmt_dd_no_imm    ; 14
    db instr_fmt_no_imm | instr_fmt_ed_no_imm | instr_fmt_dd_no_imm    ; 15
    db instr_fmt_imm_1 | instr_fmt_ed_no_imm | instr_fmt_dd_no_imm    ; 16
    db instr_fmt_no_imm | instr_fmt_ed_no_imm | instr_fmt_dd_no_imm    ; 17
    db instr_fmt_imm_1 | instr_fmt_ed_no_imm | instr_fmt_dd_no_imm    ; 18
    db instr_fmt_no_imm | instr_fmt_ed_no_imm | instr_fmt_dd_no_imm    ; 19
    db instr_fmt_no_imm | instr_fmt_ed_no_imm | instr_fmt_dd_no_imm    ; 1A
    db instr_fmt_no_imm | instr_fmt_ed_no_imm | instr_fmt_dd_no_imm    ; 1B
    db instr_fmt_no_imm | instr_fmt_ed_no_imm | instr_fmt_dd_no_imm    ; 1C
    db instr_fmt_no_imm | instr_fmt_ed_no_imm | instr_fmt_dd_no_imm    ; 1D
    db instr_fmt_imm_1 | instr_fmt_ed_no_imm | instr_fmt_dd_no_imm    ; 1E
    db instr_fmt_no_imm | instr_fmt_ed_no_imm | instr_fmt_dd_no_imm    ; 1F
    db instr_fmt_imm_1 | instr_fmt_ed_no_imm | instr_fmt_dd_no_imm    ; 20
    db instr_fmt_imm_2 | instr_fmt_ed_no_imm | instr_fmt_dd_imm_2    ; 21
    db instr_fmt_imm_2 | instr_fmt_ed_no_imm | instr_fmt_dd_imm_1    ; 22
    db instr_fmt_no_imm | instr_fmt_ed_no_imm | instr_fmt_dd_no_imm    ; 23
    db instr_fmt_no_imm | instr_fmt_ed_no_imm | instr_fmt_dd_no_imm    ; 24
    db instr_fmt_no_imm | instr_fmt_ed_no_imm | instr_fmt_dd_no_imm    ; 25
    db instr_fmt_imm_1 | instr_fmt_ed_no_imm | instr_fmt_dd_imm_1    ; 26
    db instr_fmt_no_imm | instr_fmt_ed_no_imm | instr_fmt_dd_no_imm    ; 27
    db instr_fmt_imm_1 | instr_fmt_ed_no_imm | instr_fmt_dd_no_imm    ; 28
    db instr_fmt_no_imm | instr_fmt_ed_no_imm | instr_fmt_dd_no_imm    ; 29
    db instr_fmt_imm_2 | instr_fmt_ed_no_imm | instr_fmt_dd_imm_1    ; 2A
    db instr_fmt_no_imm | instr_fmt_ed_no_imm | instr_fmt_dd_no_imm    ; 2B
    db instr_fmt_no_imm | instr_fmt_ed_no_imm | instr_fmt_dd_no_imm    ; 2C
    db instr_fmt_no_imm | instr_fmt_ed_no_imm | instr_fmt_dd_no_imm    ; 2D
    db instr_fmt_imm_1 | instr_fmt_ed_no_imm | instr_fmt_dd_imm_1    ; 2E
    db instr_fmt_no_imm | instr_fmt_ed_no_imm | instr_fmt_dd_no_imm    ; 2F
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
    db instr_fmt_no_imm | instr_fmt_ed_no_imm | instr_fmt_dd_no_imm    ; FD
    db instr_fmt_imm_1 | instr_fmt_ed_no_imm | instr_fmt_dd_no_imm    ; FE
    db instr_fmt_no_imm | instr_fmt_ed_no_imm | instr_fmt_dd_no_imm    ; FF
