imihajlow/ccpu/app/z80/z80arithm16.asm

    .global z80_regs_origin
    .global z80_f
    .global z80_a
    .global z80_bc
    .global z80_c
    .global z80_b
    .global z80_de
    .global z80_e
    .global z80_d
    .global z80_hl
    .global z80_l
    .global z80_h
    .global z80_f_s
    .global z80_a_s
    .global z80_bc_s
    .global z80_c_s
    .global z80_b_s
    .global z80_de_s
    .global z80_e_s
    .global z80_d_s
    .global z80_hl_s
    .global z80_l_s
    .global z80_h_s
    .global z80_ix
    .global z80_iy
    .global z80_sp
    .global z80_i
    .global z80_r
    .global z80_pc
    .global z80_current_opcode
    .global z80_prefix
    .global z80_indir_src

    .global z80_reset_prefix
    .global z80_imm0
    .global z80_imm1
    .global z80_tmp

    .global z80_cf
    .global z80_nf
    .global z80_pf
    .global z80_hf
    .global z80_zf
    .global z80_sf

    .export opcode_add_bc_16
    .export opcode_add_de_16
    .export opcode_add_sp_16
    .export opcode_add_hl_hl_16

    .export opcode_adc_hl_bc
    .export opcode_adc_hl_de
    .export opcode_adc_hl_sp
    .export opcode_adc_hl_hl

    .export opcode_sbc_hl_bc
    .export opcode_sbc_hl_de
    .export opcode_sbc_hl_sp
    .export opcode_sbc_hl_hl

    .export opcode_inc_bc
    .export opcode_inc_de
    .export opcode_inc_hl
    .export opcode_inc_sp

    .export opcode_dec_bc
    .export opcode_dec_de
    .export opcode_dec_hl
    .export opcode_dec_sp


    ; 16-bit arithmetics

    .section text.opcode_inc_bc
    ; 03
opcode_inc_bc:
    ldi ph, hi(z80_bc)
    ldi pl, lo(z80_bc)
    ld  b
    inc pl
    ld  a
    inc b
    adc a, 0
    st  a
    dec pl
    st  b
    ldi ph, hi(z80_reset_prefix)
    ldi pl, lo(z80_reset_prefix)
    jmp

    .section text.opcode_inc_de
    ; 13
opcode_inc_de:
    ldi ph, hi(z80_de)
    ldi pl, lo(z80_de)
    ld  b
    inc pl
    ld  a
    inc b
    adc a, 0
    st  a
    dec pl
    st  b
    ldi ph, hi(z80_reset_prefix)
    ldi pl, lo(z80_reset_prefix)
    jmp

    .section text.opcode_inc_sp
    ; 33
opcode_inc_sp:
    ldi ph, hi(z80_sp)
    ldi pl, lo(z80_sp)
    ld  b
    inc pl
    ld  a
    inc b
    adc a, 0
    st  a
    dec pl
    st  b
    ldi ph, hi(z80_reset_prefix)
    ldi pl, lo(z80_reset_prefix)
    jmp

    .section text.opcode_inc_hl
    ; 23, DD 23, FD 23
opcode_inc_hl:
    ldi ph, hi(z80_prefix)
    ldi pl, lo(z80_prefix)
    ld  a
    add a, 0
    ldi ph, hi(inc_hl)
    ldi pl, lo(inc_hl)
    jz
    ldi ph, hi(inc_iy)
    ldi pl, lo(inc_iy)
    js

inc_ix:
    ldi ph, hi(z80_ix)
    ldi pl, lo(z80_ix)
    ld  b
    inc pl
    ld  a
    inc b
    adc a, 0
    st  a
    dec pl
    st  b
    ldi ph, hi(z80_reset_prefix)
    ldi pl, lo(z80_reset_prefix)
    jmp

inc_hl:
    ldi ph, hi(z80_hl)
    ldi pl, lo(z80_hl)
    ld  b
    inc pl
    ld  a
    inc b
    adc a, 0
    st  a
    dec pl
    st  b
    ldi ph, hi(z80_reset_prefix)
    ldi pl, lo(z80_reset_prefix)
    jmp

inc_iy:
    ldi ph, hi(z80_iy)
    ldi pl, lo(z80_iy)
    ld  b
    inc pl
    ld  a
    inc b
    adc a, 0
    st  a
    dec pl
    st  b
    ldi ph, hi(z80_reset_prefix)
    ldi pl, lo(z80_reset_prefix)
    jmp


    .section text.opcode_dec_bc
    ; 0B
opcode_dec_bc:
    ldi ph, hi(z80_bc)
    ldi pl, lo(z80_bc)
    ld  b
    inc pl
    ld  a
    dec b
    sbb a, 0
    st  a
    dec pl
    st  b
    ldi ph, hi(z80_reset_prefix)
    ldi pl, lo(z80_reset_prefix)
    jmp

    .section text.opcode_dec_de
    ; 1B
opcode_dec_de:
    ldi ph, hi(z80_de)
    ldi pl, lo(z80_de)
    ld  b
    inc pl
    ld  a
    dec b
    sbb a, 0
    st  a
    dec pl
    st  b
    ldi ph, hi(z80_reset_prefix)
    ldi pl, lo(z80_reset_prefix)
    jmp

    .section text.opcode_dec_sp
    ; 3B
opcode_dec_sp:
    ldi ph, hi(z80_sp)
    ldi pl, lo(z80_sp)
    ld  b
    inc pl
    ld  a
    dec b
    sbb a, 0
    st  a
    dec pl
    st  b
    ldi ph, hi(z80_reset_prefix)
    ldi pl, lo(z80_reset_prefix)
    jmp

    .section text.opcode_dec_hl
    ; 2B, DD 2B, FD 2B
opcode_dec_hl:
    ldi ph, hi(z80_prefix)
    ldi pl, lo(z80_prefix)
    ld  a
    add a, 0
    ldi ph, hi(dec_hl)
    ldi pl, lo(dec_hl)
    jz
    ldi ph, hi(dec_iy)
    ldi pl, lo(dec_iy)
    js

dec_ix:
    ldi ph, hi(z80_ix)
    ldi pl, lo(z80_ix)
    ld  b
    inc pl
    ld  a
    dec b
    sbb a, 0
    st  a
    dec pl
    st  b
    ldi ph, hi(z80_reset_prefix)
    ldi pl, lo(z80_reset_prefix)
    jmp

dec_hl:
    ldi ph, hi(z80_hl)
    ldi pl, lo(z80_hl)
    ld  b
    inc pl
    ld  a
    dec b
    sbb a, 0
    st  a
    dec pl
    st  b
    ldi ph, hi(z80_reset_prefix)
    ldi pl, lo(z80_reset_prefix)
    jmp

dec_iy:
    ldi ph, hi(z80_iy)
    ldi pl, lo(z80_iy)
    ld  b
    inc pl
    ld  a
    dec b
    sbb a, 0
    st  a
    dec pl
    st  b
    ldi ph, hi(z80_reset_prefix)
    ldi pl, lo(z80_reset_prefix)
    jmp


    .section text.opcode_add_bc_16
    ; 09
opcode_add_bc_16:
    ldi ph, hi(z80_prefix)
    ldi pl, lo(z80_prefix)
    ld  a
    add a, 0
    ldi ph, hi(add_hl_bc)
    ldi pl, lo(add_hl_bc)
    jz
    ldi ph, hi(add_ix_bc)
    ldi pl, lo(add_ix_bc)
    js

add_ix_bc:
    ldi ph, hi(z80_bc)
    ldi pl, lo(z80_bc)
    ld  a
    ldi pl, lo(z80_ix)
    ld  b
    add a, b
    st  a
    ldi pl, lo(z80_bc + 1)
    ld  a
    ldi pl, lo(z80_ix + 1)
    ld  b
    adc a, b
    st  a
    ldi pl, lo(set_add_flags)
    ldi ph, hi(set_add_flags)
    jmp

    .section text.add_hl_bc
add_hl_bc:
    ldi ph, hi(z80_bc)
    ldi pl, lo(z80_bc)
    ld  a
    ldi pl, lo(z80_hl)
    ld  b
    add a, b
    st  a
    ldi pl, lo(z80_bc + 1)
    ld  a
    ldi pl, lo(z80_hl + 1)
    ld  b
    adc a, b
    st  a
    ldi pl, lo(set_add_flags)
    ldi ph, hi(set_add_flags)
    jmp

    .section text.add_iy_bc
add_iy_bc:
    ldi ph, hi(z80_bc)
    ldi pl, lo(z80_bc)
    ld  a
    ldi pl, lo(z80_iy)
    ld  b
    add a, b
    st  a
    ldi pl, lo(z80_bc + 1)
    ld  a
    ldi pl, lo(z80_iy + 1)
    ld  b
    adc a, b
    st  a
    ldi pl, lo(set_add_flags)
    ldi ph, hi(set_add_flags)
    jmp

    .section text.opcode_add_de_16
    ; 19
opcode_add_de_16:
    ldi ph, hi(z80_prefix)
    ldi pl, lo(z80_prefix)
    ld  a
    add a, 0
    ldi ph, hi(add_hl_de)
    ldi pl, lo(add_hl_de)
    jz
    ldi ph, hi(add_iy_de)
    ldi pl, lo(add_iy_de)
    js
add_ix_de:
    ldi ph, hi(z80_de)
    ldi pl, lo(z80_de)
    ld  a
    ldi pl, lo(z80_ix)
    ld  b
    add a, b
    st  a
    ldi pl, lo(z80_de + 1)
    ld  a
    ldi pl, lo(z80_ix + 1)
    ld  b
    adc a, b
    st  a
    ldi pl, lo(set_add_flags)
    ldi ph, hi(set_add_flags)
    jmp

    .section text.add_iy_de
add_iy_de:
    ldi ph, hi(z80_de)
    ldi pl, lo(z80_de)
    ld  a
    ldi pl, lo(z80_iy)
    ld  b
    add a, b
    st  a
    ldi pl, lo(z80_de + 1)
    ld  a
    ldi pl, lo(z80_iy + 1)
    ld  b
    adc a, b
    st  a
    ldi pl, lo(set_add_flags)
    ldi ph, hi(set_add_flags)
    jmp
    .section text.add_hl_de
add_hl_de:
    ldi ph, hi(z80_de)
    ldi pl, lo(z80_de)
    ld  a
    ldi pl, lo(z80_hl)
    ld  b
    add a, b
    st  a
    ldi pl, lo(z80_de + 1)
    ld  a
    ldi pl, lo(z80_hl + 1)
    ld  b
    adc a, b
    st  a
    ldi pl, lo(set_add_flags)
    ldi ph, hi(set_add_flags)
    jmp


    .section text.opcode_add_sp_16
    ; 39
opcode_add_sp_16:
    ldi ph, hi(z80_prefix)
    ldi pl, lo(z80_prefix)
    ld  a
    add a, 0
    ldi ph, hi(add_hl_sp)
    ldi pl, lo(add_hl_sp)
    jz
    ldi ph, hi(add_iy_sp)
    ldi pl, lo(add_iy_sp)
    js

add_ix_sp:
    ldi ph, hi(z80_sp)
    ldi pl, lo(z80_sp)
    ld  a
    ldi pl, lo(z80_ix)
    ld  b
    add a, b
    st  a
    ldi pl, lo(z80_sp + 1)
    ld  a
    ldi pl, lo(z80_ix + 1)
    ld  b
    adc a, b
    st  a
    ldi pl, lo(set_add_flags)
    ldi ph, hi(set_add_flags)
    jmp

    .section text.add_iy_sp
add_iy_sp:
    ldi ph, hi(z80_sp)
    ldi pl, lo(z80_sp)
    ld  a
    ldi pl, lo(z80_iy)
    ld  b
    add a, b
    st  a
    ldi pl, lo(z80_sp + 1)
    ld  a
    ldi pl, lo(z80_iy + 1)
    ld  b
    adc a, b
    st  a
    ldi pl, lo(set_add_flags)
    ldi ph, hi(set_add_flags)
    jmp

    .section text.add_hl_sp
add_hl_sp:
    ldi ph, hi(z80_sp)
    ldi pl, lo(z80_sp)
    ld  a
    ldi pl, lo(z80_hl)
    ld  b
    add a, b
    st  a
    ldi pl, lo(z80_sp + 1)
    ld  a
    ldi pl, lo(z80_hl + 1)
    ld  b
    adc a, b
    st  a

    ; S, Z, P are not affected
    ; H is set if carry from bit 11 - not implemented
    ; N is reset
    ; C is set to carry from bit 15
set_add_flags:
    mov a, 0
    adc a, 0
    ldi ph, hi(z80_f)
    ldi pl, lo(z80_f)
    ld  b
    mov pl, a
    ldi a, z80_sf | z80_zf | z80_pf
    and a, b
    or  a, pl
    ldi pl, lo(z80_f)
    st  a
    ldi pl, lo(z80_reset_prefix)
    ldi ph, hi(z80_reset_prefix)
    jmp


    .section text.opcode_add_hl_16
    ; 29
opcode_add_hl_hl_16:
    ldi ph, hi(z80_prefix)
    ldi pl, lo(z80_prefix)
    ld  a
    add a, 0
    ldi ph, hi(add_hl_hl)
    ldi pl, lo(add_hl_hl)
    jz
    ldi ph, hi(add_iy_iy)
    ldi pl, lo(add_iy_iy)
    js

add_ix_ix:
    ; first set flags
    ldi ph, hi(z80_f)
    ldi pl, lo(z80_f)
    ld  b
    ldi a, z80_sf | z80_zf | z80_pf
    and b, a
    ldi pl, lo(z80_ix + 1)
    ld  a
    shl a
    mov a, 0
    adc a, 0
    or  b, a
    ldi pl, lo(z80_f)
    st  b

    ; then actually shift and save
    ldi pl, lo(z80_ix)
    ld  b
    inc pl
    ld  a
    shl a
    shl b
    adc a, 0
    st  a
    dec pl
    st  b
    ldi pl, lo(z80_reset_prefix)
    ldi ph, hi(z80_reset_prefix)
    jmp

    .section text.add_iy_iy
add_iy_iy:
    ; first set flags
    ldi ph, hi(z80_f)
    ldi pl, lo(z80_f)
    ld  b
    ldi a, z80_sf | z80_zf | z80_pf
    and b, a
    ldi pl, lo(z80_iy + 1)
    ld  a
    shl a
    mov a, 0
    adc a, 0
    or  b, a
    ldi pl, lo(z80_f)
    st  b

    ; then actually shift and save
    ldi pl, lo(z80_iy)
    ld  b
    inc pl
    ld  a
    shl a
    shl b
    adc a, 0
    st  a
    dec pl
    st  b
    ldi pl, lo(z80_reset_prefix)
    ldi ph, hi(z80_reset_prefix)
    jmp

    .section text.add_hl_hl
add_hl_hl:
    ; first set flags
    ldi ph, hi(z80_f)
    ldi pl, lo(z80_f)
    ld  b
    ldi a, z80_sf | z80_zf | z80_pf
    and b, a
    ldi pl, lo(z80_hl + 1)
    ld  a
    shl a
    mov a, 0
    adc a, 0
    or  b, a
    ldi pl, lo(z80_f)
    st  b

    ; then actually shift and save
    ldi pl, lo(z80_hl)
    ld  b
    inc pl
    ld  a
    shl a
    shl b
    adc a, 0
    st  a
    dec pl
    st  b
    ldi pl, lo(z80_reset_prefix)
    ldi ph, hi(z80_reset_prefix)
    jmp


    .section text.opcode_adc_hl_bc
    ; ED 4A
opcode_adc_hl_bc:
    ldi ph, hi(z80_f)
    ldi pl, lo(z80_f)
    ld  b
    shr b
    ldi pl, lo(z80_bc)
    ld  a
    ldi pl, lo(z80_hl)
    ld  b
    adc b, a
    st  b
    ldi pl, lo(z80_bc + 1)
    ld  a
    ldi pl, lo(z80_hl + 1)
    ld  b
    adc b, a
    st  b
    mov a, 0
    ldi pl, lo(set_adc_flags)
    ldi ph, hi(set_adc_flags)
    jmp

    .section text.opcode_adc_hl_de
    ; ED 5A
opcode_adc_hl_de:
    ldi ph, hi(z80_f)
    ldi pl, lo(z80_f)
    ld  b
    shr b
    ldi pl, lo(z80_de)
    ld  a
    ldi pl, lo(z80_hl)
    ld  b
    adc b, a
    st  b
    ldi pl, lo(z80_de + 1)
    ld  a
    ldi pl, lo(z80_hl + 1)
    ld  b
    adc b, a
    st  b
    mov a, 0
    ldi pl, lo(set_adc_flags)
    ldi ph, hi(set_adc_flags)
    jmp

    .section text.opcode_adc_hl_sp
    ; ED 7A
opcode_adc_hl_sp:
    ldi ph, hi(z80_f)
    ldi pl, lo(z80_f)
    ld  b
    shr b
    ldi pl, lo(z80_sp)
    ld  a
    ldi pl, lo(z80_hl)
    ld  b
    adc b, a
    st  b
    ldi pl, lo(z80_sp + 1)
    ld  a
    ldi pl, lo(z80_hl + 1)
    ld  b
    adc b, a
    st  b
    mov a, 0
    ldi pl, lo(set_adc_flags)
    ldi ph, hi(set_adc_flags)
    jmp

    .section text.opcode_adc_hl_hl
    ; ED 6A
opcode_adc_hl_hl:
    ldi ph, hi(z80_f)
    ldi pl, lo(z80_f)
    ld  b
    shr b
    ldi pl, lo(z80_hl)
    ld  a
    mov b, a
    adc b, a
    st  b
    ldi pl, lo(z80_hl + 1)
    ld  a
    ld  b
    adc b, a
    st  b
    mov a, 0
    ldi pl, lo(set_adc_flags)
    ldi ph, hi(set_adc_flags)
    jmp

    .section text.opcode_sbc_hl_bc
    ; ED 42
opcode_sbc_hl_bc:
    ldi ph, hi(z80_f)
    ldi pl, lo(z80_f)
    ld  b
    shr b
    ldi pl, lo(z80_bc)
    ld  a
    ldi pl, lo(z80_hl)
    ld  b
    sbb b, a
    st  b
    ldi pl, lo(z80_bc + 1)
    ld  a
    ldi pl, lo(z80_hl + 1)
    ld  b
    sbb b, a
    st  b
    ldi a, z80_nf
    ldi pl, lo(set_adc_flags)
    ldi ph, hi(set_adc_flags)
    jmp

    .section text.opcode_sbc_hl_de
    ; ED 52
opcode_sbc_hl_de:
    ldi ph, hi(z80_f)
    ldi pl, lo(z80_f)
    ld  b
    shr b
    ldi pl, lo(z80_de)
    ld  a
    ldi pl, lo(z80_hl)
    ld  b
    sbb b, a
    st  b
    ldi pl, lo(z80_de + 1)
    ld  a
    ldi pl, lo(z80_hl + 1)
    ld  b
    sbb b, a
    st  b
    ldi a, z80_nf
    ldi pl, lo(set_adc_flags)
    ldi ph, hi(set_adc_flags)
    jmp

    .section text.opcode_sbc_hl_hl
    ; ED 62
    ; if carry, hl := 0xffff
    ; else, hl := 0
opcode_sbc_hl_hl:
    ldi ph, hi(z80_f)
    ldi pl, lo(z80_f)
    ld  a
    shr a
    ldi ph, hi(sbc_hl_hl_c)
    ldi pl, lo(sbc_hl_hl_c)
    jc
    mov a, 0
    ldi ph, hi(z80_hl)
    ldi pl, lo(z80_hl)
    st  a
    inc pl
    st  a
    ldi a, z80_nf | z80_zf
    ldi pl, lo(z80_f)
    st  a
    ldi ph, hi(z80_reset_prefix)
    ldi pl, lo(z80_reset_prefix)
    jmp
sbc_hl_hl_c:
    ldi ph, hi(z80_hl)
    ldi pl, lo(z80_hl)
    exp a
    st  a
    inc pl
    st  a
    ldi a, z80_nf | z80_cf | z80_sf | z80_hf
    ldi pl, lo(z80_f)
    st  a
    ldi ph, hi(z80_reset_prefix)
    ldi pl, lo(z80_reset_prefix)
    jmp

    .section text.opcode_sbc_hl_sp
    ; ED 72
opcode_sbc_hl_sp:
    ldi ph, hi(z80_f)
    ldi pl, lo(z80_f)
    ld  b
    shr b
    ldi pl, lo(z80_sp)
    ld  a
    ldi pl, lo(z80_hl)
    ld  b
    sbb b, a
    st  b
    ldi pl, lo(z80_sp + 1)
    ld  a
    ldi pl, lo(z80_hl + 1)
    ld  b
    sbb b, a
    st  b
    ldi a, z80_nf

    ; s = HL is negative
    ; z = HL is zero
    ; h = carry from bit 11 - not implemented!
    ; p = overflow
    ; c = carry
    ; n = 0 if adc, 1 if sbc
    ;
    ; register A should contain the value for n
set_adc_flags:
    ldi ph, hi(set_adc_flags_s)
    ldi pl, lo(set_adc_flags_s)
    js
set_adc_flags_ns:
    ldi ph, hi(set_adc_flags_ns_o)
    ldi pl, lo(set_adc_flags_ns_o)
    jo
set_adc_flags_ns_no:
    adc a, 0
    mov b, a
    ldi ph, hi(set_adc_flags_z)
    ldi pl, lo(set_adc_flags_z)
    jmp
set_adc_flags_ns_o:
    ldi b, z80_pf
    adc a, 0
    or  b, a
    ldi ph, hi(set_adc_flags_z)
    ldi pl, lo(set_adc_flags_z)
    jmp
set_adc_flags_s:
    ldi ph, hi(set_adc_flags_s_o)
    ldi pl, lo(set_adc_flags_s_o)
    jo
set_adc_flags_s_no:
    ldi b, z80_sf
    adc a, 0
    or  b, a
    ldi ph, hi(set_adc_flags_z)
    ldi pl, lo(set_adc_flags_z)
    jmp
set_adc_flags_s_o:
    ldi b, z80_pf | z80_sf
    adc a, 0
    or  b, a
set_adc_flags_z:
    ldi ph, hi(z80_hl)
    ldi pl, lo(z80_hl)
    ld  a
    inc pl
    ld  pl
    or  a, pl
    ldi pl, lo(set_adc_flags_store)
    ldi ph, hi(set_adc_flags_store)
    jnz
    ldi a, z80_zf
    or  b, a
set_adc_flags_store:
    ldi ph, hi(z80_f)
    ldi pl, lo(z80_f)
    st  b
    ldi ph, hi(z80_reset_prefix)
    ldi pl, lo(z80_reset_prefix)
    jmp
