imihajlow/ccpu/model/gp_reg_a.v

`timescale 1ns/1ns
module gp_reg_a(
//output
            doa,
            dob,
//input
            di,
            w_clk,
            n_rst,
            n_oe_a);
    input wire [7:0] di;
    input wire w_clk;
    input wire n_rst;
    input wire n_oe_a;

    output wire [7:0] doa;
    output wire [7:0] dob;

    wire [7:0] d;

    assign dob = d;

    register_74273 reg_inst(
        .d(di),
        .cp(w_clk),
        .n_mr(n_rst),
        .q(d));

    buffer_74244 buf_a(
        .i(d),
        .o(doa),
        .n_oe1(n_oe_a),
        .n_oe2(n_oe_a)
        );
endmodule
