imihajlow/ccpu/tools/natrix/ccpu/binary.py

from value import Value
from type import BoolType
import operator
import labelname
from .shift import genShift, genSHLVarByConst
from .common import *
from .compare import *
from .mul import *
from .div import *
from exceptions import SemanticError, NatrixNotImplementedError

def genBinary(op, resultLoc, src1Loc, src2Loc, labelProvider):
    if resultLoc.getIndirLevel() == 0:
        raise RuntimeError("Result is a constant") # should never happen, assignments are handled separately
    if src1Loc.getType().isUnknown() or src2Loc.getType().isUnknown():
        raise RuntimeError("Unknown source type")
    if op == 'add':
        return genAdd(resultLoc, src1Loc, src2Loc)
    elif op == 'sub':
        return genSub(resultLoc, src1Loc, src2Loc)
    elif op == 'band':
        return _genIntBinary(resultLoc, src1Loc, src2Loc, "and", "and", "({}) & ({})", operator.and_, True)
    elif op == 'bor':
        return _genIntBinary(resultLoc, src1Loc, src2Loc, "or", "or", "({}) | ({})", operator.or_, True)
    elif op == 'bxor':
        return _genIntBinary(resultLoc, src1Loc, src2Loc, "xor", "xor", "({}) ^ ({})", operator.xor, True)
    elif op == 'lor':
        return _genBoolBinary(resultLoc, src1Loc, src2Loc, "or", "bool({}) or bool({})", lambda a,b: a or b)
    elif op == 'land':
        return _genBoolBinary(resultLoc, src1Loc, src2Loc, "and", "bool({}) and bool({})", lambda a,b: a and b)
    elif op == 'eq':
        return genEq(resultLoc, src1Loc, src2Loc)
    elif op == 'ne':
        return genNe(resultLoc, src1Loc, src2Loc)
    elif op in {'gt', 'ge', 'lt', 'le'}:
        return genCmp(resultLoc, src1Loc, src2Loc, op, labelProvider)
    elif op in {'shl', 'shr'}:
        return genShift(resultLoc, src1Loc, src2Loc, op, labelProvider)
    elif op == 'mul':
        return genMul(resultLoc, src1Loc, src2Loc)
    elif op == 'div':
        return genDiv(resultLoc, src1Loc, src2Loc)
    elif op == 'mod':
        return genMod(resultLoc, src1Loc, src2Loc)
    else:
        raise RuntimeError("Unhandled binary op: {}".format(op))

def _genIntBinary(resultLoc, src1Loc, src2Loc, opLo, opHi, pyPattern, constLambda, carryIrrelevant):
    if resultLoc.getType().isUnknown():
        resultLoc = resultLoc.removeUnknown(src1Loc.getType())
    if resultLoc.getType() != src1Loc.getType():
        raise SemanticError(resultLoc.getPosition(),
            "Incompatible result and source types: {} and {}".format(resultLoc.getType(), src1Loc.getType()))
    if src1Loc.getType() != src2Loc.getType():
        raise SemanticError(resultLoc.getPosition(),
            "Incompatible source types: {} and {}".format(src1Loc.getType(), src2Loc.getType()))
    assert(resultLoc.getIndirLevel() == 1)
    l1 = src1Loc.getIndirLevel()
    l2 = src2Loc.getIndirLevel()
    assert(l1 == 0 or l1 == 1)
    assert(l2 == 0 or l2 == 1)
    if l1 == 0 and l2 == 0:
        raise RuntimeError("Case unhandled by ConstTransformer")
    t = resultLoc.getType()
    rs = resultLoc.getSource()
    s1 = src1Loc.getSource()
    s2 = src2Loc.getSource()
    result = "; {} = {} {}, {}\n".format(resultLoc, opLo, src1Loc, src2Loc)
    if t.getSize() <= 2:
        isWord = t.getSize() == 2
        if not isWord:
            assert(not s1.isRegister() or not s2.isRegister())
            result += loadByte('b', src1Loc, 0)
            result += loadByte('a', src2Loc, 0)
            result += f'''
                {opLo} b, a
                mov a, b
            '''
            return Value.register(resultLoc.getPosition(), t), result
        # now it's a word
        if l2 == 0:
            # var + const
            result += '''
                ldi pl, lo({0})
                ldi ph, hi({0})
                ld b
            '''.format(src1Loc.getSource())
            result += incP(src1Loc.isAligned())
            c = src2Loc.getSource()
            result += loadByte('a', src2Loc, 0)
            result += f'''
                {opLo} b, a
                ld a
            '''
            result += loadByte('pl', src2Loc, 1)
            result += f'{opHi} a, pl\n'
            result += '''
                ldi pl, lo({0})
                ldi ph, hi({0})
                st b
            '''.format(rs)
            if resultLoc.isAligned():
                result += '''
                    inc pl
                    st a
                '''
            else:
                result += f'''
                    ldi pl, lo({rs} + 1)
                    ldi ph, hi({rs} + 1)
                    st a
                '''
        elif l1 == 0:
            # const + var
            result += '''
                ldi pl, lo({0})
                ldi ph, hi({0})
                ld a
            '''.format(src2Loc.getSource())
            if src2Loc.isAligned():
                result += 'inc pl\n'
            else:
                result += '''
                    ldi pl, lo({0} + 1)
                    ldi ph, hi({0} + 1)
                '''.format(src2Loc.getSource())
            result += loadByte('b', src1Loc, 0)
            result += f'''
                {opLo} b, a
                ld pl
            '''
            result += loadByte('a', src1Loc, 1)
            result += f'''
                {opHi} a, pl
                ldi pl, lo({rs})
                ldi ph, hi({rs})
                st b
            '''.format(rs)
            if resultLoc.isAligned():
                result += '''
                    inc pl
                    st a
                '''
            else:
                result += f'''
                    ldi pl, lo({rs} + 1)
                    ldi ph, hi({rs} + 1)
                    st a
                '''
        else:
            # var + var
            s1 = src1Loc.getSource()
            s2 = src2Loc.getSource()
            result += '''
                ldi pl, lo({0})
                ldi ph, hi({0})
                ld b
                ldi pl, lo({1})
                ldi ph, hi({1})
                ld a
                {2} b, a
            '''.format(s1, s2, opLo)
            if isWord:
                result += '''
                    ldi pl, lo({0} + 1)
                    ldi ph, hi({0} + 1)
                    ld a
                    ldi pl, lo({1} + 1)
                    ldi ph, hi({1} + 1)
                    ld pl
                    {2} a, pl
                '''.format(s1, s2, opHi)
            result += '''
                ldi pl, lo({0})
                ldi ph, hi({0})
                st b
            '''.format(rs)
            if isWord:
                if resultLoc.isAligned():
                    result += '''
                        inc pl
                        st a
                    '''
                else:
                    result += '''
                        ldi pl, lo({0} + 1)
                        ldi ph, hi({0} + 1)
                        st a
                    '''.format(rs)
    else:
        # size > 2
        # This produces less size-efficient code than above, that's why it's not a general case.
        for offset in range(0, t.getSize(), 2):
            rest = t.getSize() - offset
            result += loadByte('a', src1Loc, offset)
            if rest > 1:
                if l1 == 0:
                    result += loadByte('b', src1Loc, offset + 1)
                else:
                    if (offset == 0 or carryIrrelevant) and src1Loc.isAligned():
                        # can trash flags if it's the first pair of bytes or if op is like and, or, xor
                        result += '''
                            inc pl
                            ld b
                        '''
                    else:
                        # must preserve flags
                        if src1Loc.isAligned():
                            result += f'''
                                ldi pl, lo({s1} + {offset + 1})
                                ld b
                            '''
                        else:
                            result += loadByte('b', src1Loc, offset + 1)
            result += loadByte('pl', src2Loc, offset)
            if offset == 0:
                result += f'{opLo} a, pl\n'
            else:
                result += f'{opHi} a, pl\n'
            result += f'''
                ldi pl, lo({rs} + {offset})
                ldi ph, hi({rs} + {offset})
                st a
            '''
            if rest > 1:
                result += loadByte('a', src2Loc, offset + 1)
                result += f'''
                    {opHi} b, a
                    ldi pl, lo({rs} + {offset + 1})
                    ldi ph, hi({rs} + {offset + 1})
                    st b
                '''
    return resultLoc, result

def _genBoolBinary(resultLoc, src1Loc, src2Loc, op, pyPattern, constLambda):
    if resultLoc.getType().isUnknown():
        resultLoc = resultLoc.removeUnknown(src1Loc.getType())
    if resultLoc.getType() != src1Loc.getType():
        raise SemanticError(resultLoc.getPosition(),
            "Incompatible result and source types: {} and {}".format(resultLoc.getType(), src1Loc.getType()))
    if src1Loc.getType() != src2Loc.getType():
        raise SemanticError(src1Loc.getPosition() - src2Loc.getPosition(),
            "Incompatible source types: {} and {}".format(src1Loc.getType(), src2Loc.getType()))
    if src1Loc.getType() != BoolType():
        raise SemanticError(src1Loc.getPosition(),
            "Bool type (u8) expected")
    assert(resultLoc.getIndirLevel() == 1)
    rs = resultLoc.getSource()
    s1 = src1Loc.getSource()
    s2 = src2Loc.getSource()
    l1 = src1Loc.getIndirLevel()
    l2 = src2Loc.getIndirLevel()
    result = '; {} = bool {} {}, {}\n'.format(resultLoc, op, src1Loc, src2Loc)
    pos = src1Loc.getPosition() - src2Loc.getPosition()
    if l1 == 0 and l2 == 0:
        # const and const
        if s1.isNumber() and s2.isNumber():
            return Value(pos, BoolType(), 0, int(constLambda(bool(s1), bool(s2))), True), result
        else:
            return Value(pos, BoolType(), 0, pyPattern.format(s1, s2), True), result
    elif l1 == 0 or l2 == 0:
        # var and const
        if l1 == 0:
            s1, s2 = s2, s1
            src1Loc, src2Loc = src2Loc, src1Loc
        if s2.isNumber():
            s2 = bool(s2)
            if op == 'or':
                if not s2:
                    return src1Loc, ""
                else:
                    return Value(pos, BoolType(), 0, 1, True), ""
            elif op == 'and':
                if not s2:
                    return Value(pos, BoolType(), 0, 0, True), ""
                else:
                    return src1Loc, result
            else:
                raise RuntimeError("Unhandled binary boolean op: {}".format(op))
        else:
            result += loadByte('a', src1Loc, 0)
            result += f'''
                dec a
                ldi a, 1
                sbb a, 0
                ldi b, int(bool({s2}))
                {op} a, b
            '''
    else:
        # var and var
        assert(not s1.isRegister() or not s2.isRegister())
        if s2.isRegister():
            s1, s2 = s2, s1
            src1Loc, src2Loc = src2Loc, src1Loc
        result += loadByte('a', src1Loc, 0)
        result += f'''
            dec a
            ldi a, 1
            sbb a, 0
            mov b, a
        '''
        result += loadByte('a', src2Loc, 0)
        result += f'''
            dec a
            ldi a, 1
            sbb a, 0
            {op} a, b
        '''
    return Value.register(src1Loc.getPosition() - src2Loc.getPosition(), BoolType()), result
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
