imihajlow/ccpu/(commit log)

2019-12-26 Assembler program
2019-12-26 Assembly CPU test
2019-12-26 Assembly documentation
2019-12-28 Rework ST operation and write cycles, add delays to the pointer pair model
    [control_unit.v, counter_74163.v, pointer_pair.v, test_control_unit.v, test_cpu.asm, test_cpu.v, test_pointer_pair.v]
2019-12-28 Pointer register and pointer pair schematic
    [pointer_pair.sch, pointer_reg.sch, registers.kicad_pcb, registers.sch]
2019-12-28 Some checks for IP and labels in the assembler
2019-12-29 General-purpose register
    [gp_reg.sch, pointer_pair.sch, pointer_reg.sch, registers.sch]
2019-12-29 Replace A and B with real register in the CPU model; add result check for CPU testbench
    [cpu.v, test_cpu.asm, test_cpu.v]
2019-12-29 Rename some signals in CPU, add capacitors and signal names to the schematics
    [gp_reg.sch, registers.sch]
2019-12-31 Add bus resistors
    [gp_reg.sch, pointer_reg.sch, registers.sch]
2019-12-31 Make ir_we, a_we, b_we active high according to schematics
2019-12-31 Remove redundant chip from the register A, change hierarchical pin types
    [gp_reg.sch, pointer_pair.sch, pointer_reg.sch, registers.sch]
2020-01-02 Control unit and ALU interfaces, gp_reg_a
    [alu.sch, control_unit.sch, gp_reg.sch, gp_reg_a.sch, pointer_pair.sch, pointer_reg.sch, registers.sch]
2020-01-02 Almost complete CPU registers module schematics
    [alu.sch, control_unit.sch, cpu_interface.sch, gp_reg.sch, gp_reg_a.sch, pointer_pair.sch, pointer_reg.sch, registers.sch]
2020-01-02 Connect ROM ~WE to VCC
    [cpu_interface.sch]
2020-01-06 IO, ALU, and CU connectors
    [alu.sch, control_unit.sch, cpu_interface.sch]
2020-01-07 Power and clock circuitry
    [alu.sch, control_unit.sch, cpu_interface.sch, gp_reg.sch, gp_reg_a.sch, pointer_pair.sch, pointer_reg.sch, pwr_and_clk.sch]
2020-01-07 Fix unconnected nets
    [cpu_interface.sch, gp_reg.sch, pointer_pair.sch, pointer_reg.sch, pwr_and_clk.sch, registers.sch]
2020-01-10 Annotated schematics, assigned footprints
    [alu.sch, control_unit.sch, cpu_interface.sch, gp_reg.sch, gp_reg_a.sch, pointer_pair.sch, pointer_reg.sch, pwr_and_clk.sch]
2020-01-10 PCB started
    [registers.kicad_pcb, registers.sch]
2020-01-11 PCB attempt
    [alu.sch, cpu_interface.sch, gp_reg.sch, gp_reg_a.sch, pointer_reg.sch, registers.kicad_pcb, registers.sch]
2020-01-18 CPU registers board
    [alu.sch, control_unit.sch, cpu_interface.sch, gp_reg.sch, gp_reg_a.sch, pointer_pair.sch, pointer_reg.sch, pwr_and_clk.sch]
2020-01-18 Fixed some footprints
    [pointer_reg.sch, pwr_and_clk.sch, registers.kicad_pcb]
2020-01-20 ALU board
    [alu.kicad_pcb, alu.sch, interface.sch, registers.kicad_pcb]
2020-01-22 Replace always blocks with 7474 d-flip-flops in the control unit
    [control_unit.v, test_cpu.asm]
2020-01-25 Control unit schematics
    [control.kicad_pcb, control.sch, interface.sch]
2020-01-25 AT28C256-PLCC symbol
    [control.sch]
2020-01-25 PLCC-32 socket footprint
    [alu.kicad_pcb, alu.sch, cpu_interface.sch, pointer_reg.sch, registers.kicad_pcb]
2020-01-26 Control unit board
    [alu.kicad_pcb, control.kicad_pcb, control.sch, interface.sch]
2020-01-26 Control unit LEDs rearranged
    [control.kicad_pcb]
2020-01-26 Add a 2-bit state for the future expansion
    [control.kicad_pcb, control.sch]
2020-01-31 Remove RAM and ROM from the registers board, board rework in progress
    [cpu_interface.sch, pointer_reg.sch, registers.kicad_pcb, registers.sch]
2020-02-02 Main board revision 2
    [pointer_pair.sch, registers.kicad_pcb]
2020-02-02 Fix path
    [registers.kicad_pcb]
2020-02-02 Remove uncertainty causing s1 and s2 also be uncertain and failing the test
    [test_control_unit.v]
2020-02-29 IO board schematics
    [io.kicad_pcb, io.sch]
2020-02-29 IO board footprint assignments
    [io.sch]
2020-02-29 IO board: A and D LEDs
    [io.sch]
2020-03-01 IO board
    [io.kicad_pcb, io.sch]
2020-03-02 LEDs and LED resistors
    [alu.sch, control.sch, gp_reg.sch, gp_reg_a.sch, io.sch, pointer_pair.sch, pointer_reg.sch, registers.kicad_pcb]
2020-03-02 Part names
    [alu.kicad_pcb, alu.sch, control.sch, control_unit.sch, cpu_interface.sch, gp_reg.sch, gp_reg_a.sch, interface.sch]
2020-03-02 Update net lists and PCBs with new part names
    [alu.kicad_pcb, control.kicad_pcb, io.kicad_pcb, registers.kicad_pcb]
2020-03-02 Power supply plus sign
    [registers.kicad_pcb]
2020-03-03 Power connector on the IO board
    [io.kicad_pcb, io.sch, pointer_pair.sch, pwr_and_clk.sch, registers.kicad_pcb]
2020-03-03 Minor update of the registers board
    [registers.kicad_pcb]
2020-03-04 Production files
    [alu-B_Cu.gbr, alu-B_Mask.gbr, alu-Edge_Cuts.gbr, alu-F_Cu.gbr, alu-F_Mask.gbr, alu-F_SilkS.gbr, alu-NPTH.drl, alu-PTH.drl]
2020-03-13 MOV doesn't set flags now. Memcheck tool.
    [memcheck.asm]
2020-03-14 Modifications according to board
    [alu.sch]
2020-03-19 Check for short circuit
    [test_control_unit.v]
2020-03-21 Logic-based control unit
    [control.sch, interface.sch]
2020-03-21 New control unit schematics
    [control.sch]
2020-03-22 Control unit board rev. 2
    [control.kicad_pcb]
2020-03-22 Board adjustments
    [control.kicad_pcb, control.sch]
2020-03-22 Control board rev. 2 production files
    [control-B_Cu.gbr, control-B_Mask.gbr, control-Edge_Cuts.gbr, control-F_Cu.gbr, control-F_Mask.gbr, control-F_SilkS.gbr, control-NPTH.drl, control-PTH.drl]
2020-04-10 Errata and some test programs
    [alutest.asm, memcheck.asm, shift_test.asm]
2020-04-16 Fix the CPU test to use linker
    [test_cpu.asm]
2020-04-21 Fix print_bcdf when dot is the last symbol
    [test.asm]
2020-04-21 Fix addition when a is 0 and a.exp > b.exp
    [test.asm]
2020-05-10 Assembler: multi-value db/dw/dd/dq/do
2020-05-14 Simulator: correctly print several values
2020-05-22 Save function frame on stack for recursive calls
2020-05-23 Natrix: fix pointer arithmetic to support u8, ldi pl,ph instead of inc pl
    [binary.py, code.py, common.py, compare.py, div.py, mul.py, shift.py, unary.py]
2020-05-24 Natrix test bench: print test result on the screen
2020-10-26 Add license information
    [alu.kicad_pcb, alu.sch, control.kicad_pcb, control.sch, control_unit.sch, cpu_interface.sch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]
2020-11-08 ALU model + sch
    [adder.sch, alu.sch, interface.sch]
2020-11-08 Footprints and part names
    [adder.sch, alu.sch]
2020-11-13 ALU board started
    [alu.kicad_pcb, alu.sch]
2020-11-13 VCC and GND tracks
    [adder.sch, alu.kicad_pcb, alu.sch]
2020-11-14 ALU board complete
    [alu.kicad_pcb]
2020-11-15 ALU board: change capacitor footprint, show labels
    [alu.kicad_pcb, alu.sch]
2020-11-15 ALU board: add PCB text
    [alu.kicad_pcb]
2020-11-15 ALU board production files
    [alu-B_Cu.gbr, alu-B_Mask.gbr, alu-B_SilkS.gbr, alu-Edge_Cuts.gbr, alu-F_Cu.gbr, alu-F_Mask.gbr, alu-F_SilkS.gbr, alu-NPTH.drl]
2020-11-24 Error display in ALU test program
    [alutest.asm]
2020-11-28 Fix bug in CU schematics
    [control.sch]
2020-11-29 Change control unit schematics to support wait cycles (not checked)
    [control.sch, interface.sch]
2020-12-06 Fix swapped ROM pins
    [io.kicad_pcb]
2020-12-06 New IO board model and schematic diagram
    [io.sch]
2020-12-06 IO board: device refs and datasheet links
    [io.sch]
2020-12-07 Make n_rdy an open-drain pull-up
    [control.sch, io.sch]
2020-12-08 VGA schematic started
    [vga.kicad_pcb, vga.sch]
2020-12-09 Remove ccol counter
    [vga.sch]
2020-12-10 Buffered hsync, some of the VGA schematic
    [vga.sch]
2020-12-10 Board enable signal for VGA
2020-12-10 74LV-A chips and their delays
    [vga.sch]
2020-12-12 VGA control logic on schematic
    [vga.sch]
2020-12-12 Check overall VGA schematic
    [vga.sch]
2020-12-12 VGA: select chips and packages
    [vga.sch]
2020-12-12 VGA: decoupling capacitors
    [vga.sch]
2020-12-12 VGA: P-MOSFET
    [vga.sch]
2020-12-12 VGA connector
    [vga.sch]
2020-12-12 VGA board started: connectors and dimensions
    [vga.kicad_pcb, vga.sch]
2020-12-12 VGA: DAC with ideal resistor values
    [vga.sch]
2020-12-12 VGA: DAC diode array and trim potentiometers
    [vga.sch]
2020-12-12 VGA: big capacitor
    [vga.sch]
2020-12-13 VGA: access LED
    [vga.sch]
2020-12-13 VGA: approx board layout
    [vga.kicad_pcb, vga.sch]
2020-12-13 VGA board: power nets
    [vga.kicad_pcb]
2020-12-13 VGA board
    [vga.kicad_pcb, vga.sch]
2020-12-13 Control: change 74ACT with 74LV-A
    [control.sch]
2020-12-13 Control: add more capacitors and damping resistors
    [control.sch]
2020-12-14 VGA board: change capacitor footprint
    [vga.kicad_pcb, vga.sch]
2020-12-14 Control: change big capacitor footprint
    [interface.sch]
2020-12-14 IO: get rid of 74AC
    [io.sch]
2020-12-14 IO: fix schematics according to model
    [io.sch]
2020-12-15 IO: delete LCD module, add IO port
    [io.sch]
2020-12-15 IO: footprints and values
    [io.sch]
2020-12-15 IO: delete IO port
    [io.sch]
2020-12-17 IO: PCB rev. 2
    [io.kicad_pcb, io.sch]
2020-12-17 IO: delete extra NC
    [io.sch]
2020-12-18 Control: PCB rev. 3
    [control.kicad_pcb, control.sch]
2020-12-19 VGA: never leave internal busses in high-z state
    [vga.sch]
2020-12-19 VGA: fix PCB according to schematic amendments
    [vga.kicad_pcb]
2020-12-19 IO: fix comment
    [io.sch]
2020-12-19 Control: connect cycle_flip LED correctly
    [control.sch]
2020-12-19 Control: fix PCB
    [control.kicad_pcb]
2020-12-19 IO: refill zones on PCB
    [io.kicad_pcb]
2020-12-19 IO: production files rev. 2
    [io-B_Cu.gbr, io-B_Mask.gbr, io-B_SilkS.gbr, io-Edge_Cuts.gbr, io-F_Cu.gbr, io-F_Mask.gbr, io-F_SilkS.gbr, io-NPTH.drl]
2020-12-19 Control: production files rev. 3
    [control-B_Cu.gbr, control-B_Mask.gbr, control-B_SilkS.gbr, control-Edge_Cuts.gbr, control-F_Cu.gbr, control-F_Mask.gbr, control-F_SilkS.gbr, control-NPTH.drl]
2020-12-19 VGA: production files rev. 1
    [vga-B_Cu.gbr, vga-B_Mask.gbr, vga-B_SilkS.gbr, vga-Edge_Cuts.gbr, vga-F_Cu.gbr, vga-F_Mask.gbr, vga-F_SilkS.gbr, vga-NPTH.drl]
2021-01-02 Memory check for the new IO board
2021-01-03 VGA calibration document
2021-01-03 Natrix: fix small bug
    [code.py]
2021-01-18 Registers: change IR clock phase
    [registers.sch]
2021-01-18 Registers: new clock and reset
    [control_unit.sch, cpu_interface.sch, pointer_reg.sch, pwr_and_clk.sch, registers.sch]
2021-01-18 Registers: more decoupling capacitors
    [gp_reg.sch, gp_reg_a.sch, pointer_pair.sch, pointer_reg.sch, registers.sch]
2021-01-18 Registers: change logic family to HC and LV-A
    [gp_reg.sch, gp_reg_a.sch, pointer_pair.sch, pointer_reg.sch, pwr_and_clk.sch, registers.sch]
2021-01-18 Registers: new board started
    [pointer_pair.sch, pointer_reg.sch, pwr_and_clk.sch, registers.kicad_pcb, registers.sch]
2021-01-18 Registers: power tracks
    [registers.kicad_pcb]
2021-01-21 Registers board rev. 2
    Implement RDY mechanism by suspending clock signal
    Take caution against crosstalk on sensitive line
    Add proper decoupling capacitors
    [cpu_interface.sch, gp_reg.sch, pointer_reg.sch, registers.kicad_pcb, registers.sch]
2021-01-21 IO board rev. 3
    Move side connectors
    Take caution against crosstalk
    [io.kicad_pcb, io.sch]
2021-01-21 IO: change logic family
    [io.sch]
2021-01-21 Registers: update text
    [registers.kicad_pcb]
2021-01-21 Registers: production files rev. 2
    [registers-B_Cu.gbr, registers-B_Mask.gbr, registers-B_SilkS.gbr, registers-Edge_Cuts.gbr, registers-F_Cu.gbr, registers-F_Mask.gbr, registers-F_SilkS.gbr, registers-NPTH.drl]
2021-01-21 IO: production files rev. 3
    [io-B_Cu.gbr, io-B_Mask.gbr, io-B_SilkS.gbr, io-Edge_Cuts.gbr, io-F_Cu.gbr, io-F_Mask.gbr, io-F_SilkS.gbr, io-NPTH.drl]
2021-01-22 Registers: add a pull-up on RDY
    [pointer_reg.sch, pwr_and_clk.sch, registers.kicad_pcb]
2021-01-22 Registers: update production files
    [registers-B_Cu.gbr, registers-B_Mask.gbr, registers-B_SilkS.gbr, registers-Edge_Cuts.gbr, registers-F_Cu.gbr, registers-F_Mask.gbr, registers-F_SilkS.gbr, registers-NPTH.drl]
2021-01-25 Registers: update PCB text
    [registers.kicad_pcb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]
2021-01-25 IO: remove B_SilkS production file
    [io-B_SilkS.gbr]
2021-01-27 Natrix: delete case handled by sugar transformer
2021-02-06 SPI module model
2021-02-06 SPI timing diagram
2021-02-06 Vario: schematic started
    [SPI.sch, vario.kicad_pcb, vario.sch]
2021-02-06 PS/2 schematic
    [SPI.sch, ps2.sch, vario.sch]
2021-02-06 PS/2: decoupling capacitors
    [ps2.sch]
2021-02-06 PS/2: move component on schematic
    [ps2.sch]
2021-02-06 SPI: some capacitors
    [SPI.sch]
2021-02-06 SPI: implement missing logic
    [SPI.sch, ps2.sch, vario.sch]
2021-02-06 Vario: memory card connection and power
    [SPI.sch, ps2.sch, vario.sch]
2021-02-07 SPI: invert RDY
    [SPI.sch, vario.sch]
2021-02-08 PS/2: different select signals
    [SPI.sch, ps2.sch, vario.sch]
2021-02-08 Vario: address selection
    [SPI.sch, vario.sch]
2021-02-08 Vario: status LEDs
    [SPI.sch, ps2.sch, vario.sch]
2021-02-08 Vario: component names and footprints
    [SPI.sch, ps2.sch, vario.sch]
2021-02-08 Vario: transistors and capacitors
    [SPI.sch, ps2.sch, vario.sch]
2021-02-09 Vario: board started, connectors layout
    [vario.kicad_pcb]
2021-02-10 Vario: power nets
    [SPI.sch, ps2.sch, vario.kicad_pcb, vario.sch]
2021-02-11 Vario: board, delete redundant 7474
    [ps2.sch, vario.kicad_pcb, vario.sch]
2021-02-11 Vario: add license notice
    [vario.kicad_pcb]
2021-02-11 Vario: add dimension
    [vario.kicad_pcb]
2021-02-12 Vario: move crosstalk-sensitive traces
    [vario.kicad_pcb]
2021-02-13 Vario: rectangular pads on the board
    [vario-B_Cu.gbr, vario-B_Mask.gbr, vario-B_SilkS.gbr, vario-Edge_Cuts.gbr, vario-F_Cu.gbr, vario-F_Mask.gbr, vario-F_SilkS.gbr, vario-NPTH.drl]
2021-02-21 Linker: fit sections smarter, fill holes
2021-02-27 Vario: kikad-rescue
    [ps2.sch]
2021-02-27 Vario: exact RC values
    [SPI.sch, ps2.sch]
2021-03-06 FAT: multiple file descriptors
    Also, fix Natrix bug
    [code.py]
2021-03-12 Loadable extensions (don't work due to hw bug)
    [natrix_runtime.asm]
2021-03-16 Rewrite card driver in assembly to save space
2021-03-17 FAT: init and mount as different methods; stale descriptors
2021-03-18 Natrix: fix some missed cases
    [code.py, shift.py]
2021-03-22 RSim: symbol map, break, print, fix ALU simulation
    [machine.rs, main.rs, memory.rs, symmap.rs]
2021-03-23 RSim: redo error handling, real_mem
    [instruction.rs, machine.rs, main.rs, memory.rs]
2021-03-27 Editor: insert characters
2021-03-27 Editor: insert line breaks
2021-04-26 Assembler: save first line number, not last
2021-08-16 Natrix: fix SAR long in place
    [shift.py]
2021-08-16 VGA: print decimal
2021-11-07 Natrix: on recursion save frame before populating parameters
2021-12-02 Stack: schematics
    [sp.sch, stack.kicad_pcb, stack.sch]
2021-12-03 Stack: values and footprints
    [sp.sch, stack.sch]
2021-12-04 Stack: more values
    [sp.sch, stack.sch]
2021-12-04 Stack: board started
    [sp.sch, stack.kicad_pcb, stack.sch]
2021-12-04 Stack: power nets
    [stack.kicad_pcb]
2021-12-05 Stack: board
    [sp.sch, stack.kicad_pcb]
2021-12-06 Stack: production files
    [stack-B_Cu.gbr, stack-B_Mask.gbr, stack-B_SilkS.gbr, stack-Edge_Cuts.gbr, stack-F_Cu.gbr, stack-F_Mask.gbr, stack-F_SilkS.gbr, stack-NPTH.drl]
2021-12-06 RSim: fix terminating newlines
    [config.rs, font.rs]
2022-08-03 Z80: 16-bit ADC
2022-08-06 rsim: fix NEG carry and overflow flags
    [machine.rs]
2022-08-06 rsim: fix NEG carry
    [machine.rs]
2022-08-06 rsim: fix NEG carry (again)
    [machine.rs]
2022-08-07 rsim: support loading into low RAM, prevent crash on unreadable memory
    [config.rs, machine.rs, main.rs, mem.rs]
2023-08-26 rsim: support qword print
2023-09-18 Assembler: weak export support
2023-10-14 Eth: MAC filter model
2023-10-16 Eth: receiver model WIP
    [eth.kicad_pcb, eth.kicad_sch]
2023-10-17 Eth: test normal operation
    [eth.kicad_sch]
2023-10-17 Eth: test frame filtering
2023-10-17 Eth: test re-arm buffer
2023-10-18 Eth: latched re-arm
2023-10-20 Eth: receiver schematic
    [eth.kicad_sch, filter.kicad_sch, receiver.kicad_sch]
2023-10-24 Eth: begin transmission
    [eth.kicad_sch]
2023-10-25 Eth: transmitter schematics finished
    [eth.kicad_sch, receiver.kicad_sch]
2023-10-29 Eth: schematics checked
    [eth.kicad_sch, filter.kicad_sch, receiver.kicad_sch]
2023-10-29 Eth: board dimensions
    [eth.kicad_pcb, eth.kicad_sch]
2023-11-01 Eth: untangle schematic
    [eth.kicad_sch, filter.kicad_sch, receiver.kicad_sch]
2023-11-01 Eth: board
    [eth.kicad_pcb, eth.kicad_sch, filter.kicad_sch, receiver.kicad_sch]
2023-11-02 Eth: production files
    [eth-B_Cu.gbr, eth-B_Mask.gbr, eth-B_Silkscreen.gbr, eth-Edge_Cuts.gbr, eth-F_Cu.gbr, eth-F_Mask.gbr, eth-F_Paste.gbr, eth-F_Silkscreen.gbr]
2023-11-16 Eth: doc and errata
    [eth.kicad_sch]
