imihajlow/ccpu/(notices)

Notices in the files:
boards/registers/pointer_reg.sch:
Licensed under the TAPR Open Hardware License (www.tapr.org/OHL)
boards/stack/stack.kicad_pcb:
Licensed under the TAPR OHL
boards/eth/filter.kicad_sch:
Copyright 2023 Ivan Mikhailov
boards/vga/vga.sch:
Licensed under the TAPR OHL (www.tapr.org/OHL)
